karlTbowers/node60-hw/placement/2026-11-12-route/decisions/log.md

# Decision log: routing run, 2026-11-12

The user asked (2026-11-12) to finish routing everything, then put the test points back, and later
said: "for this session - i approve all of your recommendations. dont stop and wait for me. just
record what decisions were made so i can review later if i want." and "you have my permission to
slightly trim power shapes if you need the area to run signals and there is no other way to do it."
Every decision below was taken by Claude under that approval unless it says otherwise. D34 rows are the first run (before the user's answer to D33), D35 rows the second. Each one says
how to undo it.

| Id | Decision | Taken? | Why | Where it is | To undo |
|---|---|---|---|---|---|
| D34-1 | Draw the In2 signal window (north of y 70) and the power-only keep-outs on In1, In2 south, In3 and In4 on the board again | Yes, on main | Decision D17 A (user, 2026-11-04) put them there; commit `111fb0e` (2026-11-05) lost them, because `scripts/draw_rule_areas.py` redraws them only when given `--window` and `--power-only` and was run without. Since then every router run laid signals on In2 through the power band | `node60.kicad_pcb` rule areas `SIGNAL_WINDOW_In2Cu_1`, `POWER_ONLY_*`; `prep.sh` | Run `draw_rule_areas.py node60.kicad_pcb` without the flags |
| D34-2 | Rip the two relay-termination drive lines (`/T1S_TERM_END`, `/T1S_TERM_DROP`, routed 2026-11-05) and lay them again | Yes, on main | They passed on both sides of MCU ball E1, so SPI2_FLASH_CS_L could never leave the ball field. The router laid them again clear of it | `prep.sh`; the lines on main are the bulk route's | Restore them from commit `794e299`'s board |
| D34-3 | T1S block: R501 turned 180 degrees, C509 moved 0.25 mm east, C509's VDDAU_AON via moved into its pad at (158.1, 47.45), pin 25's track narrowed to 0.2 mm, R501's GND pad joined to C510's | Yes, on main | U501 pin 26 (RBIAS) had no way to R501: the REFCLK via and C509 left 0.4 mm, and R501's RBIAS pad was on the far side of its GND pad | `hand/h0.json`, `blocks/t1s.poses.json`, `power_shapes.json` | Revert those entries; RBIAS is then open again |
| D34-4 | U201's VBAT_D joins: pin 6's plane via moved from (150.025, 74.825) to (150.9, 73.8); pin 22 gets its own plane via at (152.75, 78.5); the two tracks that tied pins 6, 22 and 24 together on B.Cu deleted | Yes, on main | The joins of 2026-11-05 caged pins 1 to 5 and pin 23 (a track down the chip's west side and a U round pin 23). All three pins still reach the VBAT_D planes on In2 and In3 | `hand/h0.json`, `power_shapes.json` | Restore the "Power join VBAT_D: U201.*" groups from the spec at `794e299` |
| D34-5 | 1V5_CORE_FB drawn by hand; the 1V5 switch-node stub now starts at the north end of U303 pin 7 | Yes, on main | The rule "1V5_CORE_FB 1 mm from the switch nodes" cannot be met by a track leaving pin 5 at its centre: pins 5 and 7 are 1.0 mm apart | `hand/h0.json`, `power_shapes.json` | Revert; the feedback net is then unrouted |
| D34-6 | Five nets pre-routed by `mini_route.py` before the bulk route: T1S_RBIAS, SPI2_FLASH_CS_L, NTC_RSENSE, 1V5_EN, VDDAU_AON_REG | Yes, on main | KiCadRoutingTools leaves these open in every run. All five pass DRC with the board's own rules | `hand/h1.jobs.json`, `hand/h1.json` | `rip_nets.py` on those nets |
| D34-7 | The full routed attempt is NOT landed on main | Decided: keep it off main | It leaves 30 items unconnected and reaches the middle cell and U201 by cutting the outer-layer power pours: see REPORT.md, "What the route cost the power paths". That is more than the slight trim the user allowed | Branch `layout/route-attempt-6layer` holds it (board, spec, block tables) | Merge that branch if the cost is acceptable |
| D34-8 | Test points: put back on the routed attempt only (62 of 62 placed, 55 joined); they stay parked on main | Yes | They are placed on the routed copper, so they belong with it. On main's board, still unrouted in the band, they would be in the router's way again | `place_test_points.py`, `hand/test_points.json` (attempt branch) | none needed |
| D33 | **B** (user, 2026-11-12: "B- Signal tracks on top under the GND bar"): mask-covered signal tracks may run on F.Cu under the GND busbar. No other net's pour there and no battery-net track; the VBAT_IN bar unchanged | Yes, the user's answer; Claude made the edit after it | Under the board's rules before it, signals in the power band had only B.Cu, which is power pour there, so the routed attempt cut the pours (D34-7). The first try at this edit, before the user had answered, was stopped by the session's safety check | `node60.kicad_dru` (two rules in place of "F.Cu under the GND busbar: GND only"), seven new cases in `prove_rules.py` (39 of 39), `mini_route.py`, `judge_route.sh` (`BARS_CLOSED=1` gives the old behaviour), the site's KiCad PCB settings page | Restore the one rule "F.Cu under the GND busbar: GND only" from commit `b404f9c`, then re-route |
| D33-1 | The new rule also names VBAT_FILT, RS_SENSE_P and RS_SENSE_N as battery nets, beside the class PWR_BATT | Yes (Claude, under the session's approval) | They sit at battery potential with no resistor in the way; RS_SENSE_P/N are ahead of the load-disconnect FETs, so only the harness fuse would clear a short to the bar. The decision page said "no battery nets" and the class alone would have missed them | `node60.kicad_dru` | Drop the three names from the rule's condition |
| D35-1 | Cross the power band in two channels under the FET bodies: B.Cu lanes at 0.3 mm pitch between each FET's source pads and its drain tab (six west at x 137.6 to 139.1, four east at x 170.9 to 171.8), laid by hand | Yes, on main (Claude, under the session's approval) | After D33 B the bulk router still cut the pours (VBAT_Q2D 0.135 to 0.217 mOhm, the west VBAT_IN pour in two pieces). The channels hold only a dead-end strip of pour beside each tab, so no current path is touched; that strip is the "slight trim" the user allowed | `hand/c4a.json`; REPORT.md, "How the band is crossed" | Rip the lanes' nets and route again |
| D35-2 | The middle output cell wired by hand, lines arriving in pin order; SW_VDD comes down both channels; three F.Cu hops south of the VBAT_IN bar's edge with vias in pads (R704 pad 1 and U701 pin 12; pins 2 and 3; R705 pad 1) | Yes, on main | Under the VBAT_IN bar the cell has B.Cu only, so nothing may cross; the router's own version left four lines open | `hand/c4a.json` | As D35-1 |
| D35-3 | RS_SENSE_N runs straight north on B.Cu beside the shunt's S1 pad to U202 pin 9, and from U201 pin 19 and C212 south of R209 and between the shunt's F1 and S1 pads. Four plane vias removed for it: VBAT_D at (160.05, 83.7 / 84.6 / 85.5) and VBAT_Q2D at (159.85, 88.15) | Yes, on main | Both sense lines are battery nets (D33-1), so neither may hop to F.Cu under the GND bar; the router's version ran RS_SENSE_N on F.Cu through the top-layer VBAT_D pour and walled R210 in. Cost: VBAT_D 0.268 to 0.298 mOhm on all layers | `hand/c4a.json`, `hand/c5h.json`; `power_shapes.json` `keep_clear` | Restore the four vias from commit `b404f9c`'s board and re-lay RS_SENSE_N elsewhere |
| D35-4 | HGATE_G's link under the shunt (B.Cu, y 86.5, Q203's gate to Q204's) removed; Q203's gate is fed on F.Cu in the gap between the top-layer pours (x 137.15) with a via at (137.15, 89.4), Q204's from the east as the router laid it. DGATE and HGATE_G run on F.Cu under the GND bar | Yes, on main | The link took the one gap between the VBAT_D and VBAT_Q2D pours. Gate lines are charge-pump outputs (microamps); the D33 rule allows them under the bar | `hand/c4a.json`, `hand/c4.jobs.json` | Re-lay HGATE_G |
| D35-5 | NTC_RSENSE runs on F.Cu in the 0.8 mm gap between the top-layer VBAT_D and VBAT_Q2D pours (y 86.2), east, then up beside the east channel | Yes, on main | The router's own choice once the pours were priced out; moved from y 86.6 to the gap's middle so it trims neither pour | `hand/c4k.json` | Re-lay it |
| D35-6 | The In3 VBAT_PROT finger to U301 and C301: five signal vias moved off it, and the finger widened from 1.2 to 2.4 mm between y 62 and 71 (x 163.2 to 165.6). A no-via zone over it in `mini_route.py` and `route_hook.py`. T1S_TERM_COIL_S's locked In2 run moved 0.35 mm east (x 164.0 to 164.35, y 62.75 to 67.65) for Q501 pin 1's GND via | Yes, on main | Seven new vias had cut the finger in three: U301 had no feed. Q501, Q502 and R521 stand on the finger and need vias in their pads. This changes a power shape (the user's standing permission) and moves approved T1S termination copper by 0.35 mm | `hand/s5h.json`, `s5i.json`, `s7h.json`, `s7i.json`; `power_shapes.json` zone `PWR_VBAT_PROT_In3` | Restore the zone's `poly` and the In2 track from `b404f9c`; Q501 pin 1 is then open again |
| D35-7 | Supply joins by hand: U301's output re-laid down the chip's west side to C302 (0.15 mm, 2.6 mm) so VBAT_PROT pins 1 and 2 reach C301; a via in U501 pin 18's pad (3V3); the VBAT_PROT sense node (U201 pins 15/16, U202 pin 8, C203, C204) joined on B.Cu with one via into the VBAT_PROT strip of In2/In3 at (161.41, 71.7); HGATE's via moved into U201 pin 14's pad; T1S_IRQ_L hops over R513's GND pocket on F.Cu and runs 0.6 mm further from D501's GND pad | Yes, on main | Each was open on main or opened by a new track, and the automatic joins failed on them | `hand/s3h.json`, `s3k.json`, `s7i.json` | Revert the specs' copper; the joins are open again |
| D35-8 | SW2_SNS's ball gets a hand-placed 0.35/0.20 mm via at (200.91, 58.32); NTC_SW3's via beside it shrinks from 0.45/0.25 to 0.35/0.20 mm | Yes, on main | The ball's only via site, 0.1 mm clear of its neighbours inside ESCAPE_U401 | `hand/c6h.json`, `c6v.json`, `c7h.json` | none sensible |
| D35-9 | Test points put back on main's board: each on its own net's B.Cu copper wherever a free spot is, however far from its old pose (six moved 30 to 99 mm along their lines: TP406, TP404, TP413, TP703, TP702, TP207); 12 on a short stub; TP301 and TP401 placed but not joined | Yes, on main | The user (2026-11-05): test points may go wherever routing is easier. With a 15 mm limit 27 needed stubs up to 31 mm, one on the RMII reference clock, and the stubs fenced off GND pour beside the T1S diodes | `hand/test_points.json`, `hand/t2` to `t4`; block tables re-posed | `scripts/park_test_points.py park`, then place them by hand |
| D35-10 | U201 pin 2 (VBAT_IN sense) and C510 pad 1 (VDDAU_AON) left open at the end of the second run (closed later: D36-1, D36-2) | Not done then | U201 pin 2 is a battery net: no F.Cu under the GND bar, and on B.Cu it is walled in by the three divider lines. It needs those re-laid on F.Cu and an In2 hop over the west lanes; a first try with the router's rip-up mode broke four other nets and was dropped. C510 pad 1 has no way out between R301, R505 and the regulator's output. Both were open on main before the run | REPORT.md, "Where it ended" | not applicable |
| D36 | **A** (user, 2026-11-12: "A, re-lay lines"): U201 pin 2 is joined with no rule change | Yes, the user's answer | The battery-net rule of D33 B stays whole | Page: https://claude.ai/artifact/DWV3TCNBaJfFMNQ4Pdn2cW (`decisions/D36-u201-vbat-in-sense.json`) | See D36-1 |
| D36-1 | How A was done: LM_SW and LM_UVLO's R204 to R205 link moved to F.Cu with vias in their pads (U201 pin 3, R204 pads 1 and 2, R205 pad 1); VBAT_IN runs on B.Cu from pin 2 between R204's pads to a via at (147.9, 71.6), and from there in a new 0.6 mm VBAT_IN pour finger on In2 (zone `PWR_VBAT_IN_U201_In2`, y 70.2 to 70.8, x 135.6 to 148.2) to the west VBAT_IN pour | Yes, on main (Claude, under the session's approval). **It differs from the page's wording**, which had an In2 track north of y 70 and the six west lines routed again | The lines SCK and I2C SCL lie on B.Cu south of y 70 exactly where the track would have to reach In2, and R515, the INH line on F.Cu and BATT_MON's F.Cu track leave them no other way; a track hop would have meant re-laying six or more lines and moving R515. The finger is a power shape in In2's power-only region (D17 A keeps tracks out of it, not pours), under the lines, so none of them moves. Cost, measured: where it joins the west VBAT_IN plane it crosses the In2 VBAT_PROT strip that is In2's way west, so VBAT_PROT's drop to U601 rises from 14.79 to 15.08 mV at 20 A (+2 %) and the loss at 3 x 20 A from 0.801 to 0.807 W; In3 carries VBAT_PROT there as before | `hand/d1.json`, `d2.json`, `add_zone.py`; `power_shapes.json` zone `PWR_VBAT_IN_U201_In2` | Delete the zone and the VBAT_IN track; restore LM_SW and LM_UVLO from commit `1821efd`; pin 2 is open again |
| D36-2 | C510 pad 1 joined to VDDAU_AON: a via beside the pad and a 12 mm F.Cu loop round U301 to R301 pad 2's via (`mini_route.py` at 0.15 mm) | Yes, on main | No shorter way exists between R301, R501, R505 and the regulator's output (the 0.4 mm gap between R501 and R301 needs 0.45). As decoupling it is poor: C509 is the close cap on this rail | `hand/d5.json` | Delete its copper; C510 pad 1 is open again |
| D36-3 | Both UART debug lines reach their test points: TX (ball E16) takes the escape channel RX had; RX (edge ball D17) leaves east between SPI3_SWITCH3_MISO's via and SPI4_SWITCH1_SCK's escape and round SCK's via. For the gap those two vias shrink from 0.45/0.25 to 0.35/0.20 mm and move 0.16 and 0.09 mm, and SPI3_SWITCH3_CS_L's diagonal is 0.1 mm wide inside the escape area (to x 209.9) | Yes, on main | The two balls had one escape channel between them. The UART test points are the only access to the debug console. Margins at the pinch point are small: 0.225 mm hole clearance (0.2 needed), 0.11 mm to the chip-select line (0.1 needed inside ESCAPE_U401) | `hand/d3.json`, `d4.json` | Restore the three nets from commit `1821efd`; TP401 is open again |
| D36-4 | TP301 (VDDAU_AON) moved to (160.0, 52.5), beside the rail's via at C510, on a 2.8 mm stub | Yes, on main | Its old place needed a 32 mm stub with six vias | `hand/d8.json`, `hand/test_points.json` | Move it back and re-route its stub |

Tool changes made on the way (all in the repo):

- `scripts/draw_power.py`: a locked stub longer than 2 mm no longer stacks on a redraw (merged with D32).
- `placement/2026-11-02-bars/judge_route.sh`: three optional switches, off by default: `S0_HOOK` (a script run
  on the router's copy), `KEEP_DECAPS=1` (leave U401's caps where the board has them) and `ROUTE_NETS`
  (the bulk passes' net patterns).
- `node60.kicad_dru`: changed for D33 B after the user's answer (above). `node60.kicad_pro`: not changed.
- `mini_route.py`: battery nets kept off F.Cu under the GND bar, others allowed (D33 B); `NOVIA` zones; job
  options `no_via` and `pour_cost`. `gen_jobs.py`: `--pour-cost`, In2 ends. `place_test_points.py`: `TP_MAX_ON`.
  `route_hook.py`: no vias on the U301 finger. `prove_rules.py`: seven busbar cases, and planted items go on
  copper-free spots so the proofs run on a routed board (39 of 39).
- New (D36): `add_zone.py`.
- New: `rip_nets_box.py`, `prune_islands.py`, `missing_in_routed.py`, `pour_crossings.py`, `measure_paths.sh`,
  `drop_dangling.py`, `dedupe_vias.py`, `set_zone_poly.py`.
