karlTbowers/node60-hw/placement/2026-11-02-bars/decisions/log.md

# Decisions, placement run 2026-11-02-bars

| Id | Date | Question | Page | Answer | What changed |
|---|---|---|---|---|---|
| D01 | 2026-11-02 | The placement plan: strict busbar via rule (A) or tented vias allowed under the bars (B) | https://claude.ai/artifact/6BbrzSQ6KqUGT5fSrQau5U | B, tented vias (user, 2026-11-02) | `node60.kicad_dru` drops `via` from both busbar rules; DEC-025 notes it; plan v1 approved; parts may stay under the bars |
| D02 | 2026-11-02 | How the board shows the VBAT_IN busbar joining J901 to J910 | https://claude.ai/artifact/QQyG6R4BYMt8VuPG6xff9c | A, a busbar part in the schematic (user, 2026-11-02) | library net-tie part, fiducial footprint and schematic change in their own session; judging route keeps J901 on a stand-in net until it lands |
| D03 | 2026-11-02 | Board fiducials, 3 per side, via a new library footprint | https://claude.ai/artifact/WKcHKSLmrtASeteVD7FHuo | A, board fiducials, 3 per side (user, 2026-11-02) | a DropOut fiducial footprint through the library's add-part; six placed by `place_connectors.py` at the measured spots; spots reserved as keep-outs meanwhile |
| D04 | 2026-11-02 | Power-entry block: INA228 beside its shunt | https://claude.ai/artifact/TmF2g6F2qwuSfKVdGnomnn | A, as composed (user, 2026-11-02) | power block v1 approved: U202 beside R201, C214 on B.Cu at U202 pin 6; held through placement |
| D05 | 2026-11-02 | T1S block as it stands | https://claude.ai/artifact/3qNtDXwTVFXDRsiMQj4BjQ | A, as it stands (user, 2026-11-02) | T1S block v1 approved, held through placement; R503 swap dropped |
| D06 | 2026-11-02 | Buck cells (U302, U303) as composed, U303 divider on the SW side | https://claude.ai/artifact/WajY8VuzyCVy9FZJmUXBPT | A, as composed (user, 2026-11-02) | buck cells approved as seated; route U303's FB round the north of the chip, away from SW; check 1V5_CORE ripple on the first boards |
| D07 | 2026-11-02 | MCU crystal block as composed, with a no-via rule on the crystal nets | https://claude.ai/artifact/7cWymGEgGDMhtveNwaRFJy | A, as composed with the no-via rule (user, 2026-11-02) | crystal block approved; node60.kicad_dru forbids vias on the FXOSC nets; routing routes them first on B.Cu |
| D08 | 2026-11-02 | One output-switch cell, U701's, copied to U601 and U801 | https://claude.ai/artifact/V4af2FuXFsyNta7XuYQYwC | A, as composed (user, 2026-11-02) | output cells approved: U601 turned 90° and moved 4.3 mm, U801 to (224, 113), TP806 at (231, 107.75) |
| D09 | 2026-11-02 | Placement gate: accept the four open items (busbar tie-pad overlaps, schematic parity, U501 pin 29, KRT's busbar join) and open the PR | https://claude.ai/artifact/1z4TKiSdvHmywjzRExvkxU | A, open the PR (user, 2026-11-02) | the four items accepted (REPORT.md); composed placement applied to node60.kicad_pcb |
| D10 | 2026-11-02 | U303's 1.5 V core buck cell recomposed round the TPS628502-Q1 (DEC-026) | https://claude.ai/artifact/FcS4kULQHc7bRbmQPYejuZ | A, as composed (user, 2026-11-02) | buck_1v5 cell table approved for the TPS628502-Q1; replaces D06's LMQ66430 cell |
| D11 | 2026-11-03 | Ready for routing: start full routing on this placement | https://claude.ai/artifact/FQKm81rbkJqD8XYJGVBc1m | A, start routing (user, 2026-11-03: after a review of KRT's routing tools and ee-skills' ee-layout-rules) | placement done; routing next |
| D12 | 2026-11-03 | Routing review: layer roles, outer copper, output cells, supply balance, input shunt, via current, routing method (7 decisions) | https://claude.ai/artifact/CYdagJE6yYyxJGvN8GtZcC | 1A 2A 3A 4B 5C 6A 7A (user, 2026-11-03). 4B: shift the power-entry group right without changing it much, and spread it for the vias. 5C: a bigger 4-terminal shunt, or two 0.5 mΩ in parallel if none is found | layer roles In1 GND / In2+In3 VBAT_PROT / In4 GND; 1 oz outer; output cells re-composed; power entry shifted right; shunt search; 0.65 A per via; staged routing |
| D13 | 2026-11-03 | The three output cells turned to 0° and centred between their headers (D12-3) | https://claude.ai/artifact/KSbSL664A3kcrYLYsxawG9 | awaiting answer | |
| D14 | 2026-11-03 | The input shunt (BVR 4026 0.3 / 0.2 mΩ, or 2 × 0.5 mΩ) and how the power entry moves right (shift, re-order, or compact) | https://claude.ai/artifact/KmXzdSwfgmrct2UQr6QukC | D14-1 A, D14-2 B (user, 2026-11-03) | R201 becomes Isabellenhütte BVR-Z-R0003-1.0 (0.3 mΩ, 4-terminal; R208 26.7 kΩ, R210 383 Ω); the power entry re-ordered to flow east |

## Skill gaps found in this run

- `escape_budget.blocking_areas` (used by `gate.py`'s via-site row) treats a rule that disallows only tracks as one that disallows vias, so the via-site row can't tell the two readings of the busbar rule apart. D01's option B numbers were measured with the areas filtered to via-forbidding rules. Fix in this run's PR.
- `gate.py`'s via-site row counts no via inside the pad itself, so a large tab (Q201–Q204's 8 × 10 mm drain pad) gets no credit for via-in-pad, which JLCPCB's filled and capped vias allow.
- Plan v1's busbar net tie (BB901/BB902 with a pad in each terminal, tied as a net tie) does not work: KiCad's net tie only lets copper of different nets touch without a DRC error; it joins nothing, and VBAT_IN still had 17 unconnected items with it. The fix is a schematic net-tie part between two nets (to be decided, D02). Reverted; J901 and J902 stay reported unconnected until then.
- `escape_budget.blocking_areas` fixed in this run: it takes `blocks=("via",)` or `("via", "track")`, and the via checks (`escape_budget.py`, `gate.py` via sites) ask only about vias.

## D15 Power entry block (2026-11-03)

Published (https://claude.ai/artifact/ESfjfBiHEvP6z8EAyY6TFh): the re-ordered power entry (D14-2 B) as a block page; `blocks/power.poses.json` replaces D04's table (approved: null). Recommendation A. C214 moved to F.Cu over U202 pin 6. Awaiting the user's answer.

D15 answered 2026-11-03: **A, as composed** (user). `blocks/power.poses.json` approved; it replaces D04's table. Board already matched to node60 #54 (R201 Kelvin nets, R208 0402, R210 383 Ω).

D13 answered 2026-11-03: **A, as turned** (user). `blocks/out_6x`, `out_34`, `out_8x` approved; they replace D08's cells.

D12 rules adopted 2026-11-03 (D12-1 A, D12-7 step 1): `node60.kicad_dru` routing rules, net classes PWR_BATT / PWR_RAIL / SW_NODE, T1S class extended to the K501 legs, mask web 0.10 mm, rule areas ESCAPE_U401/U501 and UNDER_Y401/Y501 (`scripts/draw_rule_areas.py`). `rules/prove_rules.py`: 24 of 24 cases pass (16 fire, 8 controls quiet). Real board: DRC 0 errors, parity 0, ERC 0.

D12-6 applied 2026-11-03: `plan.json` counts 0.65 A per via; R201's high-current pads are now its force pads 1 and 4 (BVR4026). Gate row "Vias at high-current layer changes" PASS, free/needed: Q201–Q204.9 242/47, R201.1 206/93, R201.4 199/93, U601/U701/U801.17 55/31 (R201's two pads share some sites).

## D16 T1S line layout (2026-11-03) — https://claude.ai/artifact/Y3JvotHyv5ecsbPLXwQEUK

User 2026-11-03: T1S runs short and equal; either connector may be used, also as an end node; move the PHY if needed. Composed: PHY chain north of the trunk's midpoint, K501 centred on it, trunk on F.Cu with via taps. `blocks/t1s.poses.json` re-extracted (approved: null). D16-2 asks about a second ESD pair at J912. Awaiting the user's answer.

D16 answered 2026-11-03: **D16-1 A, D16-2 A** (user). `blocks/t1s.poses.json` approved (replaces D05's table); intent's U501–U401 limit raised to 40 mm. D16-2 A: a second ESD pair at J912's pins, a schematic change that first checks the extra capacitance against the node's budget; then placed beside J912.

D16-2 A done 2026-11-03: PR #55 merged (D503/D504 on p5, DEC-012 rev. C, capacitance budget 20.5 of 25 pF at maxima). Board: D503/D504 placed as mirrors of D501/D502 about x 155; t1s.poses.json 22 parts. DRC 0, parity 0, floorplan 0.

## D17 Inner layer roles (2026-11-04) — https://claude.ai/artifact/CTqnFVautEjPcK5j1MXTmk

Options: A In2 north-band window (23 failed, +4–8 % supply resistance), B north band plus channels (15 failed, +9–15 %), C one VBAT_PROT plane (9 failed, 2×), D 8 layers (planes whole, $387 vs $263). Recommendation D; A as the 6-layer fallback. The PHY's RMII/MDIO nets fail in every variant: a local placement fix follows. Awaiting the user's answer.

D17 answered 2026-11-04: **A, north window** (user: "let's try with 6 layers. i can hand route some the failing nets. if that doesnt work we will go to 8 layers."). In2 is signal copper north of y 70 mm (SIGNAL_WINDOW_In2Cu_1) and VBAT_PROT south of it; In3 whole VBAT_PROT; In1 and In4 whole GND; all four plane layers carry no tracks outside the window, vias pass. `plan.json` plane_windows set. The leftover nets route by hand; the PHY's RMII/MDIO placement fix comes next.

2026-11-04: U501 and its group shifted 10 mm south (user, from a KiCad screenshot: "U501 and all of its components need to be shifted south as a group. U501 is too close to the edge of the PCB to route to."). The shift covers U501, its oscillator, straps and test points, FL501, C511/C512, K501 and its termination and drivers; D501–D504 stay at the connectors. U501's 3V3 decaps (C501, C503–C508), left at its pre-D16 spot since D16, placed at its pins. Q501, Q502 and R521 moved clear of C202/R202. C206 and TP301 moved just north of the line zone (y 35–69.9). T1S estimate: PHY stub 22.5/22.5 mm (was 12.5), relay legs 22.2/22.2 mm, end-node ports still mirrored. DRC 0, parity 0, floorplan 0. t1s.poses.json re-extracted (30 parts).

2026-11-04: U301 (VDDAU_AON regulator) with R301, C301 and C302 moved beside U501 (user: "U301 and its resistor and cap are placed wrong. they should be close to the Phy"). VDDAU_AON's only load is U501 pin 25; U301 pin 6 is now 2.8 mm from it (was about 70 mm). C302 moved to the bottom. Fast route of the shifted board before this move (D17 A layer roles): 21 nets open: 8 at the PHY (RMII/MDIO/strap/IRQ), 8 at the power entry (LM74910H settings, Kelvin sense, BATT_MON, INH), 2 switch control, and 3 power rails (1V5_CORE, 3V3_MAIN, VBAT_FILT).

## D18 Power entry inner layers (2026-11-04) — https://claude.ai/artifact/R6rxPSD3zFCrfniudt836t

The user asked for the power shapes and their vias, signals left to them. The 60 A entry path needs inner copper (the busbar areas leave F.Cu a 9 mm band). Options: A In2+In3 (path 0.70 W, VBAT_PROT 0.486/0.283/0.307 mOhm, total 1.13 W), B In2 only (1.11 W, 0.360/0.200/0.270, total 1.44 W), C neither (2.76 W, 0.306/0.171/0.256, total 3.05 W). Recommendation A. Awaiting the user's answer.

D18 answered 2026-11-04: **A, In2 and In3** (user). Stage 1 of the power shapes drawn by `scripts/draw_power.py` from `power/power_shapes.json`: GND planes on In1/In4, VBAT_PROT on In2 (out of the north window) and In3, the 60 A path's VBAT_IN/VBAT_D/VBAT_Q2D zones on B, In2, In3 and the F band, VBAT_PROT at the disconnect FETs' sources, VBAT_IN on F under its busbar, GND pours on F and B; via fields (0.45/0.25 mm, 0.9 mm pitch): J910 ring 150, Q201/Q202 sources 126, VBAT_D corridor 220, VBAT_Q2D corridor 220, Q203/Q204 sources 180, J911 and J902 rings 150 each (1,190 in all; each field at least the 93 needed for 60 A at 0.65 A per via). All locked. DRC 0 errors, parity 0, no dangling vias. New DRU rule: one thermal spoke is enough (small parts' GND pads in crowded spots). Stage 2 (outputs, VBB fields) next.

2026-11-04 power shapes, stage 2: VBB pads get 30 in-pad vias each (filled and capped, free on this stackup: DEC-027); each output a B and an F pour from its pins to its header's pin 1, OUTb the mirror of OUTa, with via fields identical at all six (4 at the strip, 24 in the band). DRC 0 errors. Measured from the copper (`power/copper_r.py`, 85 C): OUT1..6 = 4.83, 4.59, 4.83, 4.59, 3.03, 4.53 mOhm switch pins to header pin 1. The cells' small parts beside the OUT pins (C605, TP604, TP606, R605, RT601, R607, C603 on top; R601, TP602, R604, TP603) squeeze the 10 A through a 2 mm strip of 1 oz copper; with them cleared (what-if on a copy) OUT1/OUT2 = 2.47/2.45 mOhm. U801's cell differs (D08 moved parts for its FLT pin), hence OUT5. D19 asks to re-compose the cells' small parts.

## D19 Output cell exits (2026-11-04) — https://claude.ai/artifact/2bSDYAzj6TvfSJZJxfB9B6

Outputs measured from the copper: 4.83/4.59/4.83/4.59/3.03/4.53 mOhm; with U601's small parts moved away (what-if) 2.47/2.45 mOhm. Options: A re-place the cells' small parts to clear the OUT exits identically; B keep. Recommendation A. Awaiting the user's answer.

D19 answered 2026-11-04: **A, clear the exits** (user). U601's cell re-placed: RT601, R607 and C607 north of the switch between the exits, R601 and R604 to the signal side by pins 3 and 12, TP602 north between the exits, TP606 south; the cell copied to U701 and U801 by `block_poses.py copy/apply` (U801 is an exact copy again). FLT, SNS and SCK pins PASSABLE at all three. The B output pours reach north to y 104.5 beside the pins; the power shapes redrawn. Measured from the copper (85 C): OUT1..6 = 2.25/1.95/2.25/1.94/2.23/1.93 mOhm (were 4.83/4.59/4.83/4.59/3.03/4.53). The 0.3 mOhm left between each switch's OUTa and OUTb comes from the AT13 pinout: OUTa's header puts its GND pin between the switch and pin 1 (D13); a wider OUTa band does not help (2.20 at best). DRC 0, parity 0, floorplan 0, every block on its table.

## D20 Power entry symmetry (2026-11-04) — https://claude.ai/artifact/HJugSf2a4MNMKTrxwNhMN8

Asked 2026-11-04 after the user's call that both battery bosses are `VBAT_IN` (no `VBAT_IN_DOWNSTREAM`; DEC-016 rev. C to come). On a copy with J901 on VBAT_IN, DRC has 0 errors but J901 pad 1 unconnected (BB901 is no board copper), so J901 needs copper either way. A: mirror the entry chain about x 155 (Q201 west fed by J910, Q202 east fed by J901, R201 north–south on the centre line, Q203/Q204 either side of it, U201/U202 central). B: keep the chain at J910's end and join J901 with an inner-layer strip. Recommended A. Pictures: `power/d20_picture.py`.

D20 answered 2026-11-04: **A, mirror it** (user). Both battery terminals on `VBAT_IN` (schematic p9 label, board pads, busbar rule, PWR_BATT pattern; DEC-016 rev. C). Power entry re-composed about x 155: Q201 (127, 93) fed by J910, Q202 (183, 93, 180°) by J901, R201 (154.2, 86.5, 90°) F1 south, Q203 (141, 80) and Q204 (169, 80, 180°), U201 (153, 75.5) and U202 (159.5, 76.6) in the column north of R201; small parts by `pose_search.py`; NTC parts R212/C216/TP209 moved east of the VBAT_PROT pour. New pose table `blocks/power.poses.json` (39 parts on it); every other block 0 off its table. Power shapes redrawn mirrored (`power_shapes.json`): VBAT_IN W/E from each ring to its FET's sources, VBAT_D on B/In2 across and on In3 only under R201 (so VBAT_PROT has In3 corridors south to U701), VBAT_Q2D around the U201/U202 column on B, 99 vias in each FET tab. DRC 0 errors, parity 0, no dangling vias. Measured from the copper (`copper_r.py`, 85 C), main -> now: VBAT_IN 0.551 -> 0.153 mOhm (both terminals), VBAT_D 1.573 -> 0.288, VBAT_Q2D 1.432 -> 0.209, 60 A chain 3.56 -> 0.65 mOhm; per side W/E: VBAT_IN 0.322/0.288, VBAT_D 0.431/0.423, VBAT_Q2D 0.293/0.256; VBAT_PROT to U601/U701/U801 0.666/0.387/0.455 -> 0.509/0.520/0.522 mOhm; J910 to J901 through board copper 4.7 mOhm (the bar carries about 99 % of a pass-through). Open: DGATE about 50 mm routed to each ideal-diode FET (was 25/38), against TI's "short trace" (LM74910H-Q1 data sheet 9.5.1).

## D21 Entry gate drive (2026-11-04) — https://claude.ai/artifact/Nmy8BsLxsDJUJSJm4rvrqc

Asked after D20 A: TI's LM74910H-Q1 layout guidelines (9.5.1) say DGATE must reach the MOSFET gate with a short trace; PR #63 has about 50 mm to each ideal-diode FET. Built on copies of PR #63's board: B swaps the rows (ideal-diode FETs north beside U201: DGATE 23/24 mm, HGATE 49/37, A pin 16 mm from a source; chain 0.69 mOhm; VBAT_PROT 0.729/0.353/0.733, the VBAT_IN L-shapes wall off U601/U801), C is B with VBAT_IN on B and In2 only (VBAT_PROT 0.542/0.342/0.560, chain 0.76 mOhm; the trial redraw put OUT5 band vias too near J908's GND pin, 24 errors, to fix). A keeps PR #63 (DGATE 50/49, VBAT_PROT 0.509/0.520/0.522, chain 0.65). Recommended C.

D21 answered 2026-11-04: **C, swap off In3** (user). PR #63's board re-placed with the trial's poses (old entry vias deleted first): Q201 (141, 80) and Q202 (169, 80, 180°) north beside U201/U202, R201 (155.8, 86.5, 270°) F1 north, Q203 (141, 93) and Q204 (169, 93, 180°) south; TP507 moved north to (176, 69). New pose table (39 parts on it). Power shapes per D21 C (`power_shapes.json`): VBAT_IN L-shapes on B and In2, VBAT_D north band, VBAT_Q2D south band, vias in all four tabs. DRC 0 errors, parity 0, no stray vias (the trial's OUT5 hole-clearance errors did not recur). Measured (85 C): VBAT_IN 0.308, VBAT_D 0.311, VBAT_Q2D 0.144 mOhm (chain 0.76); per side W/E 1.172/1.202; VBAT_PROT to U601/U701/U801 0.525/0.336/0.547 mOhm; J910 to J901 through board 5.4 mOhm. DGATE 23/24 mm, HGATE 49/37 mm, A pin 16 mm from Q201's sources.

2026-11-04 In3 VBAT_PROT (user): the user cut PWR_VBAT_PROT_In3 from the whole board to x 69.5-240.5, y 71-116.5 (filled 21,767 -> 5,518 mm2; VBAT_PROT loss at 3 x 20 A 0.876 -> 1.024 W, outer switches +3.4 mV). Asked to fix the OUT via bug and optimise on little copper: `draw_power.py` now clears every copy's region (OUT2-OUT6 had 198 stacked vias, OUT1 had lost its strip vias: 3.11 mOhm, now 2.14; all six 30 vias again). `power/in3_sweep.py` + `copper_r.py` loads mode: the south edge matters (current wraps under the switches), the north and a bridge over the entry block little. Chosen x 72-238, y 71-122 (6,537 mm2, +12 % on the user's shape): VBAT_PROT 0.866 W, drops 15.95/11.69/15.66 mV; input-to-output copper 4.79 W (main 4.90, user's cut 5.05). DRC 0, parity 0.

D22 asked 2026-11-04 (small rail planes): the four small rails had no copper, and L201 and U301 none on VBAT_PROT since the In3 cut. Option A drawn on a copy: 3V3_MAIN on In3 north of y 70.8, a 1V5_CORE island from U401's core to R303, VBAT_PROT fingers to L201 and U301, VBAT_FILT pours on B and F, one via per small-rail pad (in the pad where it fits), U401's dogbones. B (bottom-layer pours) and C (In2's window) judged from the routing numbers. Three placement problems found: C206 (filter output cap) 34 mm from L201, C405 (1V5 bulk) 14 mm from the core, U401's top-side caps off the via grid. Answered **A, with R1, R2 and R3** (user).

D23 asked and answered 2026-11-04 (repair poses): R1 C206 (118, 40.5, 90) and TP205 (120.75, 41.75) beside L201 and U302's input caps, added to the buck_3v3 table; R2 C405 (210.75, 52.25, 0) at the island's east end; R3 15 of 18 caps under U401 on via pairs at its cell centres (`power/bga_decaps.py`; C403, C404, C419 just outside with 1.0-1.4 mm F tracks), new table `blocks/u401_decaps.poses.json`; every via under U401 0.35/0.20 mm (0.40 left 0.10 mm webs and split the In3 island and plane); all 54 signal balls keep a free escape cell. **A, land it** (user). On main's board: DRC 0 errors, parity 19 (the known ki_fp_filters warnings); opens main -> now: 1V5_CORE 10 -> 0, 3V3_MAIN 73 -> 20, VBAT_FILT 9 -> 2, V11 9 -> 5, V25 1 -> 0. Measured (85 C): 1V5_CORE 21.3 mV at 2 A into the four core balls; 3V3_MAIN at 1.33 A: U303 input 5.4, U401 3.8, U501 3.0 mV; VBAT_PROT at 3 x 20 A 0.867 W (main 0.864), drops 15.77/11.70/15.89 mV. Left to hand routing: 3V3 into the power band, U501's 3V3 pins and VDDAU_AON, U302's and U303's hot loops, V11's four balls with C420 and TP411, Q501, Q502, C513, U302 pin 3 and TP304 on VBAT_FILT. `judge_route.sh` now leaves In3 out of route_planes (not yet run that way).

2026-11-04 (user): assume JLCPCB accepts the 0.075 mm via ring on the 2 oz inner layers and keep going; checked before ordering. Recorded in CLAUDE.md, plan.json `assumed` and the PCB settings page.

D24 asked and answered 2026-11-05 (buck hot loops): drawing the bucks' copper found U302's cell mirrored: on B it had been seated as TI's top-view Figure 8-34, so SW pin 7 and PGND pin 6 faced east while L301 and C303's GND pad sat west (D06's 3.16 mm was a straight line through the chip). Mirroring the passives east would have put the SW node ~6 mm from J912's T1S pin; instead U302 turned 270 -> 90 and its 17 neighbours were pose-searched into the cell mirrored about the chip's east-west axis (C303 across VIN and PGND, L301 beside SW, output caps north, L201/C206/C207/C217 and test points south). **A, land it** (user). Copper on B for both bucks (VBAT_FILT, SW pours 4.8 / 5.2 mm2 with no vias, output nodes, 3V3 at U303, GND vias in every cap's GND pad and U302's exposed pad, 0.25 mm tracks into the thinnest QFN pins), L201's In3 VBAT_PROT finger moved to x 115-119, y 59-71. SW pin to L301 1.8 mm (was 5.4, centres); U302's SW node 13.8 mm from the T1S line (was 11.8). DRC 0 errors, parity 19 (known); all bucks' power nets joined; every block on its table (buck_3v3 table rewritten). hot_loop.py now fails an inductor that is not on its SW pin's side of the chip. Hand: U302 VOUT sense pin 11, U303's FB divider and EN, U302's INH.

D25 asked 2026-11-05 (GND stitching): an edge ring now (61 vias at 5 mm, 1 mm in) or a 5 mm grid over the interior too (519 more vias in the routing space). Fast route on main with D22-D24 in: 27 open items and 196 blocking (29 and 218 before): the planes cost no routability; RMII/MDIO and power-entry gate nets fail as before. **A** (user).

D26 asked 2026-11-05 (RMII routing; user: "route JUST the RMII interface ... might need us to spin the microcontroller"): ten nets routed alone with KRT. Five runs each failed a different net while every pad was reachable: the geometry at U501, not U401 (all ten balls reached every time). Causes: R505/R507/R509/R510/TP503/TP504 west of U501 (their pins east and north), so RX lines detoured through the TX lines' strip; Y501's courtyard 0.33 mm from U501's east pads (its UNDER_Y501 area starting inside them). Moved the six (free parts) beside their pins and Y501 2 mm east, turned 90 (R503/R504 about 3.5 mm from its output, k501 table updated); route_rmii.sh (judge preparation and fan-outs, UNDER_* via-free for the router, MDIO/MDC first) routed all ten; MDIO re-routed end to end after KRT graded a 1.25 mm gap at C506 as joined. Transplanted onto the real board, locked: DRC 0 errors, no RMII/MDIO open; 36 vias; REF_CLK 44 mm, data 43-80 mm. The T1S PHY pair fails in the router before and after alike (hand route). In3's 3V3 plane and 1V5 island now 0.12 mm minimum width (a refill dropped ball H6's 0.15 mm webs). **A** (user). Landed with D25's ring: DRC 0 errors, parity 19 (known); GND opens 4 (main 3: the RMII copper cuts the B pour; the interior stitching after routing rejoins it); Y501 pin 4 (3V3) found no via site after the move (hand). Timing (LAN8670 Table 7-15, S32K344 Table 58, about 6-7 ps/mm, REF_CLK reaching U401 about 0.24 ns after U501): RX setup slack about 3.7 ns, RX hold 1.1; TX hold 1.1; TX setup about 0.3 ns at the 25 pF datasheet load (U401 valid up to 15 ns after its clock), so TX lines and the REF_CLK branch to U401 are kept short rather than lengths matched.

Test points parked 2026-11-05 (user: "make it a rule that you are allowed to move test points to wherever you want as long if it makes routing easier. I would honestly pull the test points off the board and not worry about them while routing. we can add them back later."): all 62 TP* moved by scripts/park_test_points.py to a grid south of the outline (y 146 on), poses before in parked_test_points.json. Copper: MDIO through TP504 and REF_CLK through TP505 closed with a straight segment; the MDC stub to TP503 (two tracks and its via) and the pad vias of TP302 (3V3_MAIN) and TP303 (1V5_CORE) deleted. DRC 0 errors on the parked board; unconnected items 271 to 292 (the test points' own ratsnest, warnings). block_poses.py check --parked: every block on its table. They go back (restore) before routing sign-off.

D27 asked 2026-11-05 (RMII clock skew; user: "Yes, tighten it", the TX timing): Microchip DS60001573K section 3 asks the common oscillator's traces to the LAN8670 and the MAC matched within 13 mm; ours 14 mm and 54 mm. With R503/R504's RC (33 ohm into U401 4-8 pF, U501 3 pF) the MCU sees REF_CLK 0.39-0.48 ns after the PHY, TX setup slack 0.09 ns worst case (S32K344 output valid 15 ns at 25 pF, DSE=1 SRE=0). Trials (rmii/route_clock.sh, clock first, real copies judged): A Y501 to (182.0, 41.0) between J903 and U401 with R503/R504/C513 beside it: branches 32/22 mm, skew -0.10..-0.01 ns, TX setup 0.58, hold 0.71, RX 3.34/1.34 ns, DRC 0, no trunk crossing (top-side keep-out for the RX step); B Y501 stays, KRT length-match group: 32/51 mm, TX setup 0.24 ns, meander at U501's south edge, one CRS_DV trunk crossing; C leave: 0.09 ns. C513 (Y501's bypass) had sat 8 mm away on the top side. Recommended A.
**A** (user, 2026-11-05). Landed: Y501 (182.0, 41.0, 90), R503 (178.95, 40.05, 180), R504 (181.3, 38.4, 0), C513 to the bottom at (184.7, 41.0, 90); k501 gives up Y501, R503, R504 to blocks/refclk.poses.json (anchor Y501); intent: the three out of the t1s_line group into a refclk block, the "R503 within 6 mm of U501.27" row replaced by C513 within 2 mm of Y501; plan.md RMII and REFCLK rows rewritten (the "<= 40 mm" RMII budget was unattainable, pins 43 mm apart). UNDER_Y501 redrawn (draw_rule_areas.py --only). The twelve nets' copper from the trial (route_clock.sh; RX re-routed with a top-side keep-out over the T1S trunk's corridor) replaced D26's, locked. Found while landing: trunk_check.py looked at tracks only; every via passes F.Cu, and the trial put the PHY clock's via in U501 pin 27 at y 46.0 (D26 had a CRS_DV via at (160.3, 46.5)); the corridor is now x 133.4-176.6, y 44.8-47.2 (the pair plus the T1S rule's 0.75 mm) and route_clock.sh closes it to the router; the pin 27 via moved to (156.75, 47.45) with a B stub (it also answers the page's via-in-pad note). Still in the corridor, from before: C502 (U501's top-side 100 nF at (155.0, 45.5)) and 3V3_MAIN vias at (152.29, 47.0), (155.0, 46.8), (164.25, 46.2). draw_power.py re-run: Y501 pins 1/4 and C513 pin 1 get in-pad 3V3 vias (on main they had no site), the old via at Y501's former pin 1 gone; Q501.4/Q502.4 still no site. Zones refilled by kicad-cli (pcbnew's Python filler left 27 more GND islands). Checks: CI DRC with parity 0 errors; unconnected 287 (GND 11, as before); RMII/clock opens only to the parked TP503/TP504/TP505; every block on its table (--parked); mcu_pinmap.py --check up to date. Timing landed: clock 34.8 / 22.0 mm (mismatch 12.8 mm, the pin 27 stub added 2.9 mm), skew -0.13..-0.04 ns, TX setup 0.61, TX hold 0.69, RX setup 3.32, RX hold 1.37 ns. mcu-config.yaml: TXD0, TXD1, TX_EN at DSE = 1, SRE = 0.

D28 asked and answered 2026-11-05 (T1S line routing; user: "route the T1S trunk with the PHY pair"): drawn by hand from t1s/spec_t1s.py (KRT's diff-pair router wandered). In the way: C502 (VDDA's decap) and three 3V3 vias on the trunk's line; U501's pin row under the trunk's midpoint since the 10 mm shift, so the taps leave west of U501; VDDA pin 29 0.5 mm from TRXP pin 30 (0.75 mm rule impossible there; inward closed, the exposed pad leaves 0.275 mm); the PHY pair's crossing (two vias on P, 4 mm in KiCad's length); KiCad's gap check on every parallel stretch. Swapping TRXP/TRXN rejected: the LAN8670's topology discovery (4.15) checks pulse polarity. **A with the fourth change** (user). Landed: trunk, ESD taps, taps on In2, relay legs to K501 pins 3/6, CMC pair, PHY pair (P over N on F.Cu); C502 to (156.3, 47.76) F.Cu upright (clear of J903's T-shaped courtyard by 2.9/4.3 mm), its 3V3 via shared with pin 29; REFCLK via to (157.0, 47.35); TXD0 re-routed by KRT (t1s/route_txd0.sh, keep-outs round T1S vias: KRT keeps the T1S rule from tracks, not vias), 63.4 mm; C507's and R506's pad vias out of the corridor (draw_power.py keep_clear, class_clearance; R506 a named via and stub). Rules (rules_t1s.py): 0.75 mm not inside T1S_PINS_U501; its pour clause a rule of its own on the outer layers (the fourth); the gap rule only inside T1S_COUPLED_F/IN2; PHY pair skew 4.5 mm, CMC 0.5. Checks: CI DRC with parity 0; T1S open items 14 -> 0, VDDA connected, every other net as before; prove_rules.py 32 of 32 (six new T1S cases; the ESCAPE_U401 case moved off D23's C420 and refilled: it had been stale since the pours); t1s_stubs.py (vias by depth now) trunk 38.9, tap 14.8/15.8, PHY stub 28.6/25.6 (plan 25: accepted), relay leg 23.7/24.7, end-node dangle 28.5/21.6 (J912 used) and 10.4/17.3 (J903); RMII TX setup 0.59, hold 0.69, clock branches 12.6 mm apart; trunk corridor clean; every block on its table. Still to route: the relay's termination legs and coil.

Relay termination routed 2026-11-05 (user: "keep going" after D28): KRT (t1s/build_term.sh, route_nets.sh generalised from route_txd0.sh). One pass left TERM_CT (Default class) 0.65 mm from P_DROP and a TERM_CT via 0.55 mm from it: KRT keeps the T1S rule track to track only when the T1S copper is already there. Two passes instead: the four legs (T1S_*_DROP/END) first, then TERM_CT, the coil (TERM_COIL_S/R) and the drive lines (TERM_DROP/END from U401 E3/F3), with via keep-outs round every T1S track and via. Legs 2.0-2.5 mm on B.Cu; TERM_CT 36 mm, 5 vias (R517 west of K501, R519/C514 east; the legs fill the bottom between the pin columns, so it crosses on In2: in series with the 100 ohm termination about 1 ohm at 12.5 MHz); coil 14-17 mm; drive lines 39-42 mm. CI DRC with parity 0; 19 open items closed (272 -> 253 unconnected), nothing else changed; trunk corridor clean; T1S lengths and RMII timing unchanged; every block on its table. Not a decision: no choice against the plan.

Power joins, first pass 2026-11-05 (user: "keep going" after the termination): the fast route on main (judge_d28) leaves 7 nets open with the 63 parked test points set aside (27 before the T1S work). Main had 58 power and ground opens, real gaps (a refill closes none). KRT is no help here: it does not count pours as connecting, so it ran pad to pad across them (108 mm of VBAT_PROT through the PHY area, 3V3 on In2 in the band). power/joins/: export_copper.py (the board's copper as JSON), plan_joins.py (per open pair: a track on a shared layer, a via between, a via beside each end into its plane, then a grid search costing other nets' pours 6x; the board's clearances, 0.35 mm plated-hole rule, busbar F.Cu areas, the T1S corridor and UNDER_* areas kept), merge_plan.py (each join its own named stubs/points in power_shapes.json), joins_picture.py, transplant_new.py. 28 joins drawn (plan_2026-11-05.json): the output cells' pad 17 to C601/C701/C801 (a via in the cap's pad into In3), C602/C702/C802 (via in pad), OUTx pad 11 to C606/C706/C806 (grid, two vias), U201/U202/C203/C204/C209 at the power entry, Q501/Q502 and U501 pin 8 on 3V3 vias, U303's 3V3 pins, VDDAU_AON at U501 pin 25/C509/R301, V11's balls J8-H9-J10 on B, GND at C201/C210/C215/C205. Four grid joins dropped: they cut U301's and the entry's small pours. Power and ground opens 58 -> 30 (8 of them U303's FB/EN and U302's sense, left for hand). CI DRC 0 errors, parity 0; trunk corridor clean; T1S stubs unchanged. Left: the 3V3 trunk into the power band (west and east cells on F round the VBAT_IN bar's ends, the middle cell on B through the entry block: a decision), and the dense ones (U501 pins 11/18, R301-C510, U301-C302, U202 pin 8, C701-RT701, C420 to the V11 balls, D201 and U201 pad 2 to VBAT_IN).

D29 asked 2026-11-05 (3V3 into the power band; user: "Yes, go ahead"): every 3V3 load in the band needs a feed, and on F.Cu and B.Cu the band is taken by the busbars' F.Cu areas (GND bar x 67-243, y 61-80; VBAT_IN bar x 92-218, y 90-109), the entry's VBAT pours and the output pours, with all inner layers planes. Found: each output switch's logic pins (1-5, 12-16) and R601/R701/R801 sit in a pocket closed to the north by its two output pours on both outer layers. One 0.3 mm 3V3 track into U701's pocket raised OUT3 2.16 -> 2.93 mOhm (3.80 routed shortest); the fast route's signals leave the outputs at 2.33-4.66 mOhm. Options: C widen the In3 3V3 plane into the unassigned margins (x < 72, x > 238, y > 122) and feed each pocket from below (9.5 mm, 2 vias, alike; outputs and entry chain unchanged; 3V3 band opens all joined), B cut back the outputs' F.Cu top strips (+0.5 mOhm each), A cross the pours, D turn the switches 180 (not worked up). R707 from R607's feed (81.5 mm) rather than down the entry's centre column (VBAT_Q2D +21 %); R211/C215 from R807's feed rather than across the VBAT_IN pour (+23 %). Tools: power/joins/trunk_options.py, trunk_picture.py, trunk_to_spec.py; page D29-build.py. Signals into the pockets are the next decision.
D29 answered 2026-11-05: **C, as recommended** (user). Drawn from power_shapes.json: PWR_3V3_MAIN_In3 is now the whole of In3 at priority 0 (VBAT_PROT, the entry's In3 pours and the 1V5 island take their own), and nine named feeds (power/joins/d29_options.json, option C): R601/R701/R801 9.5 mm and 2 vias each from the In3 strip at y 122.6; R607 5.0 mm, R807 36.2 mm from the plane; R707 81.5 mm from R607's feed; R211/C215 43.3 mm from R807's; U202 8.4 mm; U203 1.4 mm. CI DRC 0 errors, parity 0; power and ground opens 30 -> 21 (every 3V3 open in the band joined; U501 pin 18 left); outputs 2.159/1.873/2.162/1.859/2.141/1.886 mOhm and VBAT_D 0.302, VBAT_Q2D 0.144, VBAT_IN J901-Q202 0.647 (0.645 before), J910-Q201 0.611 mOhm, as before; T1S corridor and stubs unchanged. Next: the signals into the pockets.

D30 asked 2026-11-05 (signals into the output cells' pockets; user: "Yes, write it"): seven nets per cell (SPI x4, FLT, SNS via R6x6, shared LHI) go to U401's south rows. The grid search could not route even the unconstrained case at the board's via and hole rules, so no route lengths are evidence; the page decides topology. Measured: crossings (fast route 2.33-4.66 mOhm), cutting the F.Cu top strips (+0.5 mOhm each, equal) and, for B at the middle cell, 1,430 legal via sites in the B.Cu channel north of U701 but none at y >= 109.3, all under the VBAT_IN bar's F.Cu area: B opens lanes for the west and east cells only. Turning U701 180 on a copy puts the logic pins north and the OUT pins south, but OUT3's east and OUT4's west: each cell's two connectors would swap channels in the schematic. Options: D work up the 180 turn (recommended), B cut the strips (fallback, west/east only), X cross, S in from the south. Page D30-build.py.

D30 answered 2026-11-05: **D: work it up** (user). Then the user (2026-11-05): "also on the schematic, let's swap the pinout on FL501 and K501 in order to remove the need for the net crossover of T1S_PHY_P and T1S_PHY_N".
D31 asked 2026-11-06 (both worked up on copies of main 011bcc7). 1, the output switches turned 180 degrees (cells/turn_cells.py): pin-local parts turned about each chip's centre, Cx06 mirrored beside its pins, NTC group and Cx02 unchanged; OUT blocks to y 112.2-118.7 on B.Cu and 112.2-113.95 on F.Cu, columns unchanged; channels swap (schematic: pins 6-8 to OUT_B, 9-11 to OUT_A; connectors keep their OUT numbers; firmware channel map changes). Measured: outputs 1.65/1.69/1.63/1.70/1.63/1.67 mOhm (today 2.16/1.87/2.16/1.86/2.14/1.89); hot loop unchanged (CVBB1 0.45/4.48 mm); DRC 0 errors; the fast route cuts output pours with 2 through-running nets (SW_LHI, SPI4 MISO), not 9. 2, FL501/K501 swapped (t1s/swap_pins.py, spec_t1s.py swap): P east along the chain, C511/C512 sides swapped, taps' vias swapped, PHY pair straight (no vias). Measured: PHY stub 24.6/25.6 mm (28.6/25.6), relay leg 23.9/24.9, end-node dangle 27.7/22.4 and 11.2/16.5; PHY skew rule passes at 0.5 mm again; DRC 0 errors; RMII TX setup 0.60, hold 0.69 ns. Schematic: FL501 mirrored about its horizontal axis; K501's T1S_P/T1S_N labels swap between COM1 and COM2, and the pole labels swap with them (coil pins unchanged: latching by polarity). Page D31-build.py.
D31 answered 2026-11-06: **Land both** (user). Schematic (cells/edit_sheets_d31.py): output-switch sheet OUT_A/OUT_B labels swap texts (channel 1, pins 6-8, and C605 now OUT_B; connectors unchanged); t1s sheet FL501 mirrored (x), K501's T1S_P/T1S_N labels swap between COM1 and COM2 and the pole labels with them (R518/R519 now P's). ERC clean before and after; netlist diff exactly those pads (scripts/netlist_pads.py --diff). Board (cells/land_d31.sh): pads' nets from the schematic (scripts/apply_netlist.py), the switches turned (turn_cells.py --keep-nets: pours and connectors keep their OUT numbers), the cells' joins (cells/d31_cell_joins.json), the T1S line with spec_t1s.py swap (now the default; C511 east, C512 west, taps' vias swapped, PHY pair straight), TXD0 and the termination re-routed (build_term.sh's second pass now keeps other nets' tracks 0.85 mm off T1S tracks). Rule: PHY pair skew back to 0.5 mm. CI DRC 0 errors, parity 0; opens as before (216: 68 parked test points, 21 power/GND, 6 T1S straps/IRQ); outputs 1.693/1.648/1.696/1.634/1.675/1.653 mOhm; VBAT_D 0.302, VBAT_Q2D 0.144; T1S trunk 38.9, PHY stub 24.6/25.6, relay leg 23.9/24.9, end node 27.7/22.4 and 11.2/16.5; RMII TX setup 0.60, hold 0.69, RX setup 3.32, hold 1.37 ns; trunk corridor clean; every block on its table (out_6x/out_34/out_8x rewritten, C511/C512 in t1s.poses.json). Firmware: OUT1/3/5 are channel 2 of each switch (mcu-config.yaml).

D32 asked and answered 2026-11-12 (run `placement/2026-11-12-passives/`, page https://claude.ai/artifact/JLN8hwiMkwVew3kSbyn1BE): passive placement review, nine options A-I. **I and H** (user): every move of attempts 01-08 and the TVS pour. Landed by `placement/2026-11-12-passives/land_d32.sh`: C215, R211, R406, R407 at U203 (new table u203_parts); R508 at U401 ball B3; R607/C607, R707/C707, R807/C807 and R701 on the 3V3 plane south of U401 (new table mcu_pullups); R601 and R801 at the In3 margins' vias (out_6x, out_8x rewritten; out_34 loses R701, R707, C707); R513 east of U501 pin 23 (t1s table); power_shapes.json loses 52 stubs and points (the 3V3 feeds into the band, three vias that joined nothing) and gains 8 vias, 13 stubs and the zone PWR_VBAT_IN_D201_F. draw_power.py: a locked stub longer than 2 mm now goes on a redraw (it used to stack: 1V5_CORE_REG had 7 copies, now 1). DRC 0 errors, parity 0, 211 unconnected (216 before), every block on its table, prove_rules.py 32 of 32. Fast routes (KRT v0.24.0) could not rank the options: one moved resistor swings the blocking count more than the options differ.

D33 asked 2026-11-12, open (run `placement/2026-11-12-route/`, page https://claude.ai/artifact/1mJPM6ByyyzovSkJMTTtqk): how signals cross the power band. A keep the rules and cut the pours (measured: the routed attempt on branch `layout/route-attempt-6layer`), B signal tracks on F.Cu under the GND busbar (recommended; needs an edit to `node60.kicad_dru` that is the user's to make), C 8 layers.
D34 2026-11-12 (taken by Claude under the user's approval of the session's recommendations; `placement/2026-11-12-route/decisions/log.md` has each with how to undo it): the D17 A rule areas drawn again (lost in `111fb0e`, 2026-11-05); the termination drive lines laid again clear of U401 ball E1; R501 turned 180 degrees, C509 0.25 mm east (t1s table); U201's VBAT_D joins moved off pins 1-5 and 23; 1V5_CORE_FB by hand; five nets pre-routed; the full routed attempt kept off main (30 open, VBAT_Q2D +82 %, east VBAT_IN +28 %, OUT4 +30 %). On main: DRC 0 errors, parity 0, 205 unconnected, blocks on their tables, prove_rules.py 32 of 32, T1S trunk 38.9, PHY stub 24.6/25.6, relay leg 23.9/24.9 (unchanged), supply paths unchanged but VBAT_PROT (0.785 -> 0.796 W at 3 x 20 A, the In2 pour back south of y 70).
