karlTbowers/node60-hw/docs/src/content/docs/index.mdx

---
title: Power distribution node, 10 A variant
description: Node60 Architecture Rev A decision overview, status, and primary release blocker.
tableOfContents: false
---

import { Aside } from '@astrojs/starlight/components';
import StatusGrid from '../../components/StatusGrid.astro';
import Ref from '../../components/Ref.astro';
import HeroRender from '../../components/HeroRender.astro';
import VehicleWiring from '../../components/VehicleWiring.astro';

<HeroRender />

**Architecture Rev A · dated 2026-10-13 · schematic baseline.** Automotive, six outputs, 10BASE-T1S.

Six protected high-side outputs with current and voltage telemetry, built around S32K344EHT1MMMST and LAN8670D0-E/LMXVAO. Output stage: 3 × TPS2HCS08A-Q1.

## One node per corner

Node60 is made for wiring classic and older vehicles with very little wire. Instead of a fuse panel with a wire to every lamp, a node sits beside each group of loads: one behind each headlight, one by each taillight. Battery power jumps from node to node, and one 10BASE-T1S pair from Hub 100 under the dash carries the control.

<VehicleWiring />

<Aside type="tip" title="Architecture decision">
Use three TPS2HCS08A-Q1 dual-channel smart high-side switches for the six-output active design (<Ref id="DEC-008" />), each on its own MCU SPI bus so that one switch fault affects only its two outputs (<Ref id="DEC-018" />). At the input, **LM74910H-Q1** and INA228A-Q1 Kelvin-share one 0.3 mΩ 4-terminal RSENSE (<Ref id="DEC-001" />, <Ref id="DEC-002" />). For Rev A, keep power sequencing **discrete**: LAN8670 INH directly enables the LMQ66430 3.3 V buck, and the TPS628502 1.5 V core buck on 3V3_MAIN follows by EN chaining (<Ref id="DEC-026" />), with no FS26, wake latch, or MCU standby dependency (<Ref id="DEC-004" />). An automotive 32 Mbit SPI NOR retains the diagnostic log across complete power-down (<Ref id="DEC-011" />). Firmware runs on Zephyr RTOS (<Ref id="DEC-019" />).
</Aside>

<StatusGrid />

<Aside type="danger" title="Primary release blocker">
TI specifies 13 A continuous at 85 °C with one channel enabled, but only **8 A per channel when both channels are enabled**. Because every device serves two outputs, 10 A continuous on all six outputs cannot be released until the complete PCB, enclosure, ambient, and adjacent-channel thermal matrix proves it (<Ref id="GATE-THM-01" long />).
</Aside>

## Decision summary

Three TPS2HCS08A-Q1 devices provide six cost-optimized outputs. LM74910H-Q1 and INA228A-Q1 Kelvin-share one 0.3 mΩ 4-terminal RSENSE for total-current telemetry and input protection. Rev A uses a discrete power tree: a nanopower LDO keeps only LAN8670 VDDAU alive at roughly 50 µA typical / 65 µA maximum parked draw, and PHY INH directly enables the LMQ66430 3.3 V buck, which feeds the TPS628502 1.5 V core buck. The controller ECU wakes the node over the T1S pair and explicitly commands shutdown; the node turns all outputs off, flushes its IS25LP032D-JNLA3 diagnostic log, then commands PHY sleep and powers down (<Ref id="DEC-007" />). FS26 is not fitted. TMP175-Q1 plus four NTCs provide hotspot coverage (<Ref id="DEC-010" />); the S32K344 SWT remains the watchdog (<Ref id="DEC-005" />), and TPS3702-Q1 independently supervises 3V3_MAIN (<Ref id="DEC-006" />). The 10 A target remains release-blocked by the 8 A-per-channel both-on rating at 85 °C.

## Reading this site

- [Purpose & design basis](requirements/): requirements with IDs and the gates that verify them.
- [System architecture](system/): the power and signals views; every block links to its subsystem page.
- Subsystem pages carry the reasoning; [decisions](decisions/) record each choice with its rejected alternatives.
- [Component baseline](components/), [schematic interfaces](interfaces/), [verification gates](verification/), and the [source register](sources/).
- [Revisions](revisions/): the architecture's revision history.
