karlTbowers/node60-hw/docs/src/content/docs/subsystems/harness.mdx

---
title: Connector & harness architecture
description: Node60 output and input connectors, four-conductor node cable, and fusing.
---

import { Aside } from '@astrojs/starlight/components';
import PartTable from '../../../components/PartTable.astro';
import Ref from '../../../components/Ref.astro';

Each output gets a sealed, independently protected path; the aggregate input is treated as a 60 A interconnect problem, plus the battery current passed through to a downstream node.

| Interface | Architecture | Release condition |
|---|---|---|
| Six outputs | Amphenol Sine AT13-2P-BM04, one 2-pin right-angle header per output (<Ref id="DEC-013" />); 10 A each; 14 AWG minimum | Pin 1 = OUTx, pin 2 = local return; contact temperature rise at 10 A proven up to +125 °C ambient; DT06-2S, sockets, wedgelock, wire, and panel seal frozen together |
| Battery input | Two Würth REDCUBE 74660016R M6 terminals with red Amphenol SurLok Plus SLPRATPSR receptacles in the lid, joined by an internal busbar (<Ref id="DEC-016" />, <Ref id="DEC-020" />) | either receptacle takes the source cable and the other passes battery to a downstream node, through busbar BB901 (and, about 1 %, the board); prove the full current path at <Ref id="GATE-HAR-02" /> |
| Power return | Two REDCUBE 74660016R terminals with black SurLok Plus SLPRATPSB receptacles, busbar-joined; all six output returns come back through the node (<Ref id="DEC-013" />, <Ref id="DEC-016" />) | 60 A plus the downstream return; no chassis-only return assumption |
| 10BASE-T1S | Two Amphenol Sine ATM13-2P-BM04: J903 upstream and J912 downstream, in parallel on the pair; sealed 2-pin right-angle PCB receptacles, mate ATM06-2S (<Ref id="DEC-014" />, <Ref id="DEC-017" />) | Vehicle-level protection and termination strategy; verify pin 1 on a sample |
| Complete node cable | Four conductors: T1S twisted pair + battery-direct power + ground, plus an optional battery/ground pass-through to one downstream node | No KL15, ignition, or local hardwire wake input; controller ECU must provide T1S wake (<Ref id="REQ-NET-001" />) |

## Output connectors

Each output has its own **Amphenol Sine AT13-2P-BM04** header: BoardLock AT13, 2 pins at 5.40 mm, right angle, with a panel flange gasket and a potted rear. It mates an AT06-2S plug (Amphenol's DT06-2S equivalent) with size 16 sockets for 14 to 20 AWG. Amphenol rates it 13 A, 250 V, −55 to +125 °C at rated current, and IP67 mated. It seals against the enclosure wall through the same panel cutout as the DT13-2P. See <Ref id="DEC-013" long />.

**Pin assignment:** pin 1 = OUTx, pin 2 = that output's local ground return. Up to 60 A of load return current (six outputs at 10 A) therefore flows back through the node to the power-entry star ground and out through the node's ground conductor. That conductor, its input contacts, and the board's return path must carry 60 A, matched to the battery feed.

<Aside type="caution" title="Confirm pin 1 on the first sample">
Amphenol's drawing labels pins 1 and 2 on the mounting face, and the footprint follows it. Confirm the moulded cavity numbers on the first sample and label them on the harness drawing, so OUTx and ground cannot be swapped at the harness.
</Aside>

## Power entry and pass-through

Four **Würth REDCUBE SMT 74660016R** terminals (M6 internal thread, 85 A max at 20 °C) sit on the board: J910 and J901 on the battery input (both VBAT_IN), J902 and J911 on the return. Amphenol **SurLok Plus** 5.7 mm receptacles in the lid screw into them through the board: red SLPRATPSR on battery, black SLPRATPSB on return, IP67 mated, 3 N·m on the M6 thread. A busbar inside the case joins each pair, so one receptacle of each pair takes the source cable and the other feeds a lower-current downstream node. Either pair may be the source; the harness decides (DEC-016 rev. C), and the power entry is mirrored about the midpoint between J910 and J901, so the node is fed the same way from either. The battery busbar BB901 is a board part: a two-pin net tie on the schematic with both pins on VBAT_IN, on the BOM; it carries about 99 % of the pass-through, the rest flowing in the F.Cu pour under it. The return busbar BB902 is a schematic and BOM part the same way, with both pins on GND; the GND plane joins J911 and J902 as well. See <Ref id="DEC-016" long />.

<Aside type="caution" title="The pass-through bypasses Node60's protection">
The downstream feed leaves before the LM74910H ideal diode and breaker and before the INA228 shunt. Size the source fuse and cable for both nodes, and give the downstream node its own protection. The downstream feed is limited to **40 A** for now (upstream total 100 A), with the battery busbar carrying all of it; GATE-HAR-02 confirms the limit or raises it toward 60 A. Sealing of the power entry is not decided yet.
</Aside>

## Enclosure and board mounting

The board mounts component side up, 230 × 110 mm, 2.0 mm thick, 6.17 mm off the floor (<Ref id="DEC-023" />, <Ref id="DEC-024" />, <Ref id="DEC-025" />; 5 mm until the SurLok stud length was known, 2026-11-02). The REDCUBE terminals sit on its bottom side, and a 1/8" × 3/4" copper busbar joins each power pair (<Ref id="DEC-021" />; 1/8" × 1" until <Ref id="DEC-025" />), resting on the terminals' spigots 0.6 mm above the top face. The SurLok receptacles sit on the busbars in the low middle of the lid, between a raised band across the front over the output headers and a separate raised hood over the T1S pair in the middle of the north wall. The north wall is a removable panel, fitted after the board. Each SurLok right-angle plug can leave outward (west or east) or north; `scripts/check_surlok_clearance.py` checks every combination (<Ref id="DEC-022" />).

This is version 15 (version 11, which is version 7 compact on a 2.0 mm board, with 1/8" × 3/4" busbars) of the enclosure designs on the [Enclosure options](../enclosure/) pages, each with its dimensions, panel cutouts and busbar cut list; the others stay there as the record of the options. **[Open the 3D enclosure mockup](../../mockups/node60-enclosure.html)** to switch between them, orbit them and turn the plugs.

<Aside type="note" title="SurLok stud length">
The busbar sits between each receptacle and its REDCUBE, so the stud's length decides how much thread it engages. Amphenol's SLPRATPSB drawing C10-730187 gives 9.95 mm beyond the seat (found 2026-11-02; the library's earlier estimate was 7.7 mm), so with the 1/8" busbar the stud takes the REDCUBE's whole 5.6 mm thread and comes out 1.2 mm below it. The receptacle's panel face is 9.25 mm above the busbar, which puts the low lid 8.8 mm lower than first drawn; see [Power receptacles: RADLOK vs SurLok Plus](../enclosure/receptacles/).
</Aside>

## Fusing

Place the primary fuse at the battery/source end, sized for Node60 plus the downstream node fed through the pass-through. If the 60 A path is split, fuse each feed and prevent back-powering through an undersized path. Final values coordinate wire ampacity, contact derating, load inrush, PCB fault energy, and the smart-switch curve. Use branch fuses wherever the main fuse cannot protect an output conductor or connector fault.

<Aside type="caution" title="Connector freeze condition">
Connector families are architectural selections, not released mating sets. Freeze exact housings, terminals, seals, wire sizes, and keys together; validate temperature rise with all intended adjacent circuits loaded.
</Aside>

## Parts

<PartTable subsystem="harness" />
