karlTbowers/node60-hw/docs/src/content/docs/subsystems/network.mdx

---
title: 10BASE-T1S subsystem
description: Node60 LAN8670D0 PHY, line interface, PLCA identity, TC10 bus wake and controller-commanded shutdown.
---

import { Aside } from '@astrojs/starlight/components';
import Metrics from '../../../components/Metrics.astro';
import MermaidDiagram from '../../../components/MermaidDiagram.astro';
import PartTable from '../../../components/PartTable.astro';
import GateList from '../../../components/GateList.astro';
import DecisionList from '../../../components/DecisionList.astro';
import Ref from '../../../components/Ref.astro';

LAN8670D0 connects over RMII/MDIO and operates as a commissioned PLCA follower on the multidrop segment.

## PHY and line interface

| Circuit | Selection | Implementation |
|---|---|---|
| Reference clock | ECS-3225SMVQ-500-DS-TR | 50 MHz HCMOS, ±20 ppm; oscillator enable controlled with main power |
| Line coupling | 2 × 100 nF series capacitors | Automotive C0G/film-equivalent behavior with voltage and DC-bias margin |
| Termination | OPEN Alliance split termination: a latching relay selects 49.9 Ω (bus end) or 1.5 kΩ (mid-bus) legs to a centre tap with 100 nF ‖ 100 kΩ (<Ref id="DEC-017" />) | Commissioned by the controller and stored in flash; restored at every cold boot; held through sleep |
| Bus pass-through | Second ATM13-2P-BM04 (J912) in parallel with J903 (<Ref id="DEC-017" />) | Shortest trunk between the two connectors; stub to the PHY well under 10 cm |
| Common mode choke | ACT1210E-241-2P-TL00 | TDK 240 µH 10BASE-T1S choke, AEC-Q200; alternates ACT1210E-131 and Murata DLW32MH241MX2L (<Ref id="DEC-012" />) |
| Protection | 4 × VETH100A1DD1HG3-08 | Vishay OPEN Alliance T1S ESD diode, ≤2.0 pF, AEC-Q101: one pair right at each T1S connector (D501/D502 at J903, D503/D504 at J912), ahead of the choke; the two pairs add at most 2.0 pF across the line, inside the OPEN Alliance CMDI ≤ 25 pF node budget; Nexperia PESD1ETH10L(S)-Q alternates (<Ref id="DEC-012" />) |

## Identity and PLCA

Firmware stores a unique locally administered MAC address and commissioned PLCA node ID in protected flash. Node ID must be unique and is not hard-coded identically across production units. Coordinator mode is disabled by default.

## TC10 bus-wake and complete shutdown

The parked node is not an MCU standby system. It is powered down except for the LAN8670 always-on domain, so the missing S32K3 Zephyr standby implementation is no longer on the critical path. The controller ECU—powered from battery and switched ignition—owns the only wake source and sends the T1S wake-up pattern over the same pair used for data (<Ref id="DEC-007" />).

<Metrics items={[
  ['40 µA typ', 'LAN8670 VDDAU sleep current'],
  ['56 µA max', 'LAN8670 VDDAU sleep current'],
  ['≈52 µA', 'complete node parked, typical'],
  ['≈65 µA', 'complete node parked, maximum (Rev A estimate; recheck with the TPS7B8133 maximum Iq)'],
]} />

| Phase | Defined sequence | Contract / evidence |
|---|---|---|
| Parked | Battery → LM74910H-Q1 in SLEEP (6 µA, ideal diode active) → TPS7B8133-Q1 LDO → LAN8670 VDDAU only. VDDA, VDDP, MCU, flash, bucks, and all outputs are off. | The selected TPS7B8133-Q1 draws 3.5 µA, above the ≈1–2 µA Rev A target; the parked budget is ≈52 µA typical (accepted 2026-10-28). LAN8670 sleep current is 40 µA typical / 56 µA maximum. |
| Wake | Controller sends T1S wake-up tone → PHY detects it → INH high → bucks ramp → S32K344 cold boot → PHY re-initialization → link up → outputs become commandable. | Supply ramp plus PHY initialization must stay within 15 ms (OPEN Alliance Sleep/Wake-Up Electrical Interface Specification v1.0, §5.2); estimated ≈10 ms, measured at GATE-NET-01. PHY registers are lost while VDDA/VDDP are down; T1S_IRQ_L indicates readiness for configuration. A roughly 1 s application-ready latency is acceptable. |
| Shutdown | Controller sends application-level “go to sleep” message → firmware turns all six outputs off → flushes pending log entries → commands PHY sleep → INH releases after tSLPINHDLY → power tree collapses. | Write-before-sleep ordering is mandatory. Bus-idle timeout is rejected as the sleep source. |

<MermaidDiagram name="power-cycle" caption="The controlled power cycle." />

<Aside type="danger" title="Four-wire system dependency">
The T1S pair is the only wake path. The node cannot wake itself and has no KL15 input; if the controller ECU does not emit the wake pattern, the node stays off. This is a controller-interface requirement, not a recoverable local condition.
</Aside>

<Aside type="caution" title="Wake inrush & exact-target validation">
INH powers the complete switched tree at once. Size the LM74910H TMR breaker ride-through for regulator, bulk-capacitance, MCU, PHY, and output-stage startup inrush. Validate TC10 sleep/wake, INH timing, cold boot, lost-register PHY re-initialization, T1S_IRQ_L ready behavior, PLCA restoration, and application readiness on the exact S32K344EHT1MMMST target.
</Aside>

## Decisions

<DecisionList page="subsystems/network" />

## Parts

<PartTable subsystem="network" />

## Gates

<GateList page="subsystems/network" />
