karlTbowers/node60-hw/docs/src/content/docs/subsystems/power.mdx

---
title: Power entry & regulated rails
description: Node60 protected 60 A VBAT path, input current and voltage telemetry, overcurrent protection, and the discrete INH-gated power tree.
---

import { Aside, Card, CardGrid } from '@astrojs/starlight/components';
import Metrics from '../../../components/Metrics.astro';
import PartTable from '../../../components/PartTable.astro';
import GateList from '../../../components/GateList.astro';
import DecisionList from '../../../components/DecisionList.astro';
import Ref from '../../../components/Ref.astro';

A protected 60 A-capable VBAT path and deliberately split low-power rails support load control and network wake.

## Protected battery path

**LM74910HQRGERQ1** controls the DGATE ideal-diode MOSFET bank and HGATE disconnect MOSFET bank for reverse-battery blocking, overvoltage disconnect, programmable overcurrent circuit breaking, and fast short-circuit protection (<Ref id="DEC-001" />). A shared 0.3 mΩ 4-terminal RSENSE sits between the two FET stages and carries the complete rail current. At 60 A, device count, RDS(on), sharing, copper/bus structure, resistor heating, and fault energy must be calculated together. A 24 V bidirectional XLD8A24CA TVS is preferred after the source fuse; SMBJ24CA is not accepted as the sole primary load-dump element (<Ref id="DEC-003" />).

| Element | Selected device / value | Open detail |
|---|---|---|
| Ideal-diode controller | LM74910HQRGERQ1, VQFN-24 (4 × 4 mm), AEC-Q100 Grade 1 | Choose 80–100 V AEC-Q101 MOSFETs after surge/thermal calculation; verify VOUT tap after Q2 |
| Primary TVS | XLD8A24CA, 24 V, 7 kW class | Verify clamp against regulator and MOSFET limits |
| Input fuse | Source-mounted; one per feed when dual-fed | Coordinate 60 A load, wire ampacity, inrush, and fault clearing |
| EMI filter | Damped π filter after protection, regulator branch only: L201 Würth 74438356022HT 2.2 µH; C207 Nichicon GYF1H470MCQ1GS 47 µF 50 V hybrid polymer as the damping capacitor, with C217 (same footprint) not fitted | Values follow the emissions test: 1.0 or 4.7 µH fit L201's footprint; C217 takes a second 47 µF, or C207 + C217 take 2 × 22 µF |

## VBAT_RAW voltage telemetry

**BATT_MON is a divider tap, not a controller pin.** Move it to the LM74910H-Q1 SW-pin OV/UV divider. Retain the 1:12 monitor-ratio concept so the S32K344 ADC stays in range, but recalculate all divider values at schematic review because the LM74910H OV threshold is 0.6 V rather than the LM74800’s 1.23 V.

| Divider item | Rev A requirement | Electrical result |
|---|---|---|
| OV/UV ladder | Recalculate from SW; 1% resistors; no more than 120 kΩ total | Meets leakage-error rule while setting the required cutoffs |
| OV reference | 0.6 V | Old LM74800 divider values are invalid; final cutoff requires schematic calculation |
| Monitor ratio | Retain 1:12 concept from SW to BATT_MON | Keeps the ADC in range through the intended protected transient window |
| ADC interface | Spare ADC input + 10 nF to ground | Set ADC sample time from the final divider’s Thevenin resistance |

<Aside type="caution" title="Measurement semantics">
The divider is connected to SW and reports **VBAT_RAW** on the battery side, before the DGATE ideal-diode FET—not VBAT_PROT. BATT_MON is not sampled while parked; qualify or gate its ADC tap so it does not compromise the ≈50 µA parked budget, then restore it on wake. Use the LM74910H’s separate UVLO pin to define cold-crank behavior and document both networks at schematic review.
</Aside>

## Shared protection and total-current measurement

Fit one **0.3 mΩ, 1%, AEC-Q200, 4-terminal RSENSE** (R201, Isabellenhütte BVR-Z-R0003-1.0, 4026; 0.25 mΩ CSS2725FTL250 until rev. B, decision D14-1, 2026-11-03) between the DGATE ideal-diode FET and the HGATE disconnect FET. Its force pads carry VBAT_D (pad 1) and VBAT_Q2D (pad 4); its sense pads are the nets RS_SENSE_P (pad 2, VBAT_D side) and RS_SENSE_N (pad 3). The LM74910H current-sense inputs and INA228A-Q1 each take their own pair from the sense pads; the high-impedance measurement paths do not interact. Route every downstream branch—including buck, MCU, PHY, and switches—from VOUT after Q2 so RSENSE captures true total node current.

<Metrics items={[
  ['0.3 mΩ', 'shared protection/measurement RSENSE'],
  ['18 mV', 'drop at 60 A'],
  ['1.08 W', 'RSENSE dissipation at 60 A'],
  ['44%', 'of ±40.96 mV ADC range at 60 A'],
]} />

The arithmetic: 60 A × 0.3 mΩ = 18 mV; (60 A)² × 0.3 mΩ = 1.08 W, against 5 W rated above 100 °C terminal temperature; 18 mV / 40.96 mV ≈ 44%.

| Monitor option | Verified specification | Price / availability observed 2026-10-13 | Decision |
|---|---|---|---|
| INA228AQDGSRQ1 | AEC-Q100 automotive qualified; 20-bit delta-sigma ADC; ±1 µV maximum shunt offset; ±0.05% maximum gain error; ±85 V bus range; I²C; VSSOP-10 (DGS) | $5.43 @1 / ≈$3.20 @1k; 32,413 DigiKey stock | **Plan of record.** ADCRANGE = 1 gives ±40.96 mV; 18 mV at 60 A uses ≈44% of range. CURRENT_LSB 260.4167 µA, SHUNT_CAL 4096 for 0.3 mΩ |
| INA281A2QDBVRQ1 | AEC-Q100 Grade 1; −40…+125 °C; −4…+110 V common-mode; gain 50; ±300 µV maximum offset; ±0.5% maximum gain error; SOT-23-5 | $3.21 @1 / ≈$1.80 @1k; 8,138 DigiKey stock | **Budget fallback.** Analog output needs an S32K344 ADC channel; offset refers to about 1.0 A at 0.3 mΩ |

<Aside type="tip" title="Why INA228A-Q1 is plan of record">
The shared resistor sees regulator, MCU, PHY, controller, and load current that the six channel readings cannot fully reconstruct. INA228A-Q1 adds only about $0.90 at 1,000 pieces versus an INA240-class analog implementation, avoids an MCU ADC channel, and preserves useful low-current accuracy despite the 0.3 mΩ resistor. Current diverted ahead of RSENSE—including through the primary TVS—remains outside this measurement. See <Ref id="DEC-002" long />.
</Aside>

<Aside type="note" title="Keep both voltage measurements">
INA228A-Q1 digitizes the protected rail while the LM74910H SW divider and MCU ADC measure **VBAT_RAW** before the ideal-diode FET. They observe different nodes and support different diagnostics, so neither replaces the other. The INA228 also reports current and power after firmware programs and verifies SHUNT_CAL (4096 for 0.3 mΩ, <Ref id="DEC-002" />).
</Aside>

<Aside type="caution" title="Dynamic range & sourcing">
A single 60 A RSENSE cannot also resolve parked sleep current. Parked-drain verification remains a validation-lab measurement. INA240-Q1 and INA229-Q1 were both zero-stock with restocks indicated around February 2027. INA228AQDGSRQ1 is the in-stock plan of record; INA281A2QDBVRQ1 remains the documented lower-cost fallback with substantially higher offset and lower low-current accuracy.
</Aside>

## Input overcurrent protection

| Protection path | Setting (rev. B) | Implementation / test |
|---|---|---|
| Circuit breaker OCP | 74.8 A | R(ILIM) = 12 × RSET / (RSENSE × ILIM): R208 26.7 kΩ 1 %, RSET R209 49.9 Ω (50–100 Ω datasheet range) on 0.3 mΩ |
| Fast SCP | 24.0 mV = 80 A typical (71.4–92 A) | RISCP R210 383 Ω 1 %: 10.5 µA × 383 Ω + 20 mV; the same window as rev. A's 20 mV on 0.25 mΩ. Validate threshold and fault energy on the power-entry coupon |
| Breaker delay | TMR 68 nF for ≈1 ms starting point | Tune against output bulk-capacitance inrush at schematic review |
| Fault response | FLT to S32K344; SLEEP OCP auto-retry | FLT supplies pre-trip warning; auto-retry lets the input breaker recover after a cleared fault without intervention from a parked, sleeping MCU |
| IMON | Not populated | Leave the optional ±2% analog current-monitor pin floating per datasheet while INA228 is fitted |

<Aside type="tip" title="Why LM74910H-Q1 replaces LM74800-Q1">
One resistor now serves both protection and precise measurement, cutting shunt heat in half at 60 A. More importantly, the prior LM74800 architecture had no input-rail overcurrent protection; LM74910H adds a programmable breaker, fast short-circuit trip, separate UVLO, FLT warning, and SLEEP-mode OCP auto-retry.
</Aside>

<Aside type="note" title="Rejected alternative — LM74900-Q1">
LM74900-Q1 saves about $1 at 1,000 pieces but latches off after SLEEP-mode overcurrent instead of auto-retrying. That is the wrong trade for a battery-parked node whose MCU may be asleep when the fault occurs.
</Aside>

### Current-monitor alternatives not carried forward

- **INA186-Q1:** 40 V common-mode ceiling leaves no margin for clamped load-dump transients; no authorized stock observed.
- **ST TSC2011:** automotive grade, exact part number, and pricing were not verified.
- **Microchip PAC1932/34:** no AEC-Q100 qualification.

## Power domains

<CardGrid>
  <Card title="VDDAU_AON">
    A TPS7B8133-Q1 nanopower LDO supplies only LAN8670 VDDAU while parked. Its 3.5 µA quiescent current is above the ≈1–2 µA Rev A target; no 40 V Grade 1 part met that target, and the ≈52 µA parked budget was accepted on 2026-10-28.
  </Card>
  <Card title="3V3_MAIN">
    S32K344 I/O/analog, LAN8670 VDDA/VDDP, switch VDD, SPI NOR, clock, and the 1.5 V buck's input. U302, an LMQ66430-Q1 at 2.2 MHz on VBAT_FILT, is enabled directly by PHY INH.
  </Card>
  <Card title="1V5_CORE">
    S32K344 V15 via a TPS628502-Q1 buck fed from 3V3_MAIN (<Ref id="DEC-026" />): fixed 2.25 MHz with spread spectrum, out of the AM band at any battery voltage. EN-pin chaining from 3V3_MAIN establishes the order and allows at least 250 mA transient margin.
  </Card>
  <Card title="VBAT_PROT">
    VOUT after Q2 feeds the always-on LDO, all three TPS2HCS08A-Q1 devices, and, through the L201 EMI filter (VBAT_FILT), the 3.3 V buck, so shared RSENSE sees the complete downstream current.
  </Card>
</CardGrid>

<Aside type="caution" title="Power-sequencing hold point">
On bus wake, LAN8670 drives INH high. The OPEN Alliance limit is supply ramp plus PHY initialization within 15 ms (Sleep/Wake-Up Electrical Interface Specification v1.0, §5.2); the LAN8670 datasheet's "within 1 ms" is Microchip's own allocation. With the LMQ66430 (~6–7 ms to regulation; the TPS628502 adds its 1 ms soft-start once 3V3_MAIN is up) and the LAN8670 D0 reset and initialization (~3 ms), the estimate is about 10 ms. Rev A accepts this and measures it (GATE-NET-01). Verify EN-chain delay, regulator soft-start, MCU reset release, PHY-ready T1S_IRQ_L, and whole-board inrush together. VDDA must never exceed VDDAU by more than 0.5 V; the always-on-first topology satisfies that rule by construction.
</Aside>

## FS26 removed from Rev A

The first version stays discrete. FS26’s original roles are now covered by the 3.3 V and 1.5 V bucks, the S32K344 internal windowed SWT, the TPS3702 rail supervisor, and the LAN8670 INH gatekeeper. Do not place FS26 in the Rev A schematic or BOM. Reconsider an SBC only in a later revision if wake or sequencing requirements outgrow direct INH gating and EN-pin chaining. See <Ref id="DEC-004" long />.

## Decisions

<DecisionList page="subsystems/power" />

## Parts

<PartTable subsystem="power" />

## Gates

<GateList page="subsystems/power" />
