karlTbowers/node60-hw/docs/src/content/docs/subsystems/safety.mdx

---
title: Safety, EMC & thermal architecture
description: Node60 deterministic safe states, diagnostic coverage, EMC and thermal foundations.
---

import GateList from '../../../components/GateList.astro';
import Ref from '../../../components/Ref.astro';

This is not a functional-safety certification claim; deterministic safe states and diagnostic coverage are foundations for later hazard analysis.

- SPI and LHI reset states leave every output off until the MCU verifies configuration and communication integrity.
- Parked state leaves only LAN8670 VDDAU alive; there is no local ignition or hardwire wake path. The controller ECU must issue the T1S wake pattern.
- Controller-commanded shutdown is transactional: outputs off, diagnostic-log flush complete, then PHY sleep and INH release.
- LM74910H-Q1 provides an independent 75 A circuit breaker, default 80 A fast short-circuit trip, FLT pre-trip warning, and SLEEP-mode OCP auto-retry on the 60 A input rail.
- Hard-lock and window the S32K344 SWT; use the Clock Monitoring Unit for clock-failure reset and TPS3702-Q1 for independent 3V3_MAIN overvoltage/undervoltage supervision through RESET_L.
- Separate high di/dt loops from SNS/ADC return, oscillator, RMII, and T1S coupling.
- Start with 2 oz copper and dense thermal vias at every exposed pad; calculate every 10 A path.
- Budget 5.34 W cold or 10.68 W hot for six full-load channels before other losses.
- Run ISO 7637-2 / ISO 16750 supply-transient tests and appropriate CISPR 25 conducted/radiated emissions.
- Validate inductive turn-off energy and every I²t profile against switch, load, harness, and connector.

Requirement: <Ref id="REQ-SAF-001" long />.

## Gates

<GateList page="subsystems/safety" />
