karlTbowers/node60-hw/docs/src/content/docs/subsystems/enclosure/v15.mdx

---
title: "Version 15: version 11 with 1/8 x 3/4 in busbars"
description: Node60 enclosure version 15, generated from its connector placement.
---

import EnclosureVersion from '../../../../components/EnclosureVersion.astro';

<EnclosureVersion version="v15" />
