karlTbowers/node60-hw/docs/architecture/Node60-Architecture-RevC.html

ARCHITECTURE / REV C

## 10 A power distribution node

Active baselineTPS2HCS08A-Q1 · S32K344 · LAN8670D0

SectionsREV C · 10 A VARIANT

AUTOMOTIVE / SIX OUTPUTS / 10BASE-T1S

# Power distribution node 10 A variant

Six protected high-side outputs with current and voltage telemetry, built around S32K344EHT1MMMST and LAN8670D0-E/LMXVAO.

Revision

C

Dated

2026-10-13

Output stage

3 × TPS2HCS08A-Q1

State

SCHEMATIC BASELINE

ARCHITECTURE DECISION

Use three TPS2HCS08A-Q1 dual-channel smart high-side switches for the six-output active design. At the input, LM74910H-Q1 and INA228A-Q1 Kelvin-share one 0.25 mΩ RSENSE. For Rev C, keep power sequencing discrete: LAN8670 INH directly enables the LMQ66430 bucks, with no FS26, wake latch, or MCU standby dependency. An automotive 32 Mbit SPI NOR retains the diagnostic log across complete power-down.

COMPUTES32K344EHT1MMMSTLocked · production

NETWORKLAN8670D0 over RMIIProcurement risk

POWERLM74910H + discrete INH gatingWake/inrush validation open

OUTPUTS3 × TPS2HCS08A-Q1Thermal proof required

SOFTWAREZephyr + SPI/I²t + PLCAExact target open

PRIMARY RELEASE BLOCKER

TI specifies 13 A continuous at 85 °C with one channel enabled, but only 8 A per channel when both channels are enabled. Because every device serves two outputs, 10 A continuous on all six outputs cannot be released until the complete PCB, enclosure, ambient, and adjacent-channel thermal matrix proves it.

01

## Purpose & design basis

A buildable product architecture defining power domains, signal paths, switching channels, telemetry, software responsibilities, and the preliminary production BOM.

### Design requirements

- Six independently commanded battery-side outputs, each targeting 10 A continuous.
- Per-output current and voltage monitoring reported over a multidrop 10BASE-T1S network.
- Current measurement resolves 100 mA steps over the full 0–10 A range; absolute accuracy is specified separately.
- AEC-Q100 Grade 1 target (−40 °C to +125 °C ambient) or better for active ICs.
- Four-wire node connection only: T1S twisted pair, battery-direct power, and ground. The controller ECU is solely responsible for bus wake.
- Low parked-vehicle battery draw, RMII host interface, PLCA follower operation, and Zephyr RTOS.
- Hardware safety must not depend on the network stack.

6 × 10 Aindependent protected outputs

60 Aworst-case aggregate output

100 mArequired current resolution

−40…125 °Cactive-IC temperature target

Parameter | Rev C requirement | Design consequence
Vehicle supply | 12 V nominal; protected automotive transients | 40 V-class regulators behind a load-dump clamp
Output channel | 10 A continuous target | TPS2HCS08A-Q1; 14 AWG minimum; dual-channel thermal proof
Current telemetry | 100 mA resolution per output; independent total-rail measurement | 3 × SPI-selected SNS ADC inputs plus INA228A-Q1 digital input-current monitor
Input voltage telemetry | Battery-side brownout and load-dump visibility | 1:12-concept LM74910H SW-pin OV/UV divider tap into a filtered 12-bit ADC input
T1S role | Multidrop follower | Configurable 100 Ω termination only at a physical endpoint
Parked state | Only LAN8670 VDDAU remains powered; all six outputs and main rails off | Bus-only TC10 wake; INH directly enables discrete bucks; MCU cold-boots

02

## System architecture

Battery protection, low-power control, logic, network, and six load channels are kept as explicit domains.

System block diagram showing battery-direct input, LM74910H protected power entry, always-on LAN8670 VDDAU supply, INH-gated discrete bucks, S32K344 controller, SPI flash, three dual high-side switches, six outputs, and the four-wire T1S plus power and ground interface

Figure 1. Battery, control, network wake, and switched-load domains. LAN8670 VDDAU is the sole always-on load; its INH output gates the main rails directly.

### Partitioning rule

Keep dirty load current outside the logic return path. The protected battery node feeds both the smart switches and the logic converters. Each output returns directly to the power-entry ground/star region; ADC and PHY grounds join through the quiet logic plane. The T1S coupling and ESD network sit at the connector boundary.

REV C POWER-GATE DECISION

FS26 is removed. A nanopower LDO supplies only LAN8670 VDDAU while parked; LAN8670 INH directly enables the two LMQ66430-Q1 bucks. EN-pin chaining establishes the 3.3 V / 1.5 V order without an SBC, wake latch, or extra logic.

03

## Power entry & regulated rails

A protected 60 A-capable VBAT path and deliberately split low-power rails support load control and network wake.

### Protected battery path

LM74910HQRGERQ1 controls the DGATE ideal-diode MOSFET bank and HGATE disconnect MOSFET bank for reverse-battery blocking, overvoltage disconnect, programmable overcurrent circuit breaking, and fast short-circuit protection. A shared 0.25 mΩ RSENSE sits between the two FET stages and carries the complete rail current. At 60 A, device count, RDS(on), sharing, copper/bus structure, resistor heating, and fault energy must be calculated together. A 24 V bidirectional XLD8A24CA TVS is preferred after the source fuse; SMBJ24CA is not accepted as the sole primary load-dump element.

Element | Selected device / value | Open detail
Ideal-diode controller | LM74910HQRGERQ1, VQFN-24 (4 × 4 mm), AEC-Q100 Grade 1 | Choose 80–100 V AEC-Q101 MOSFETs after surge/thermal calculation; verify VOUT tap after Q2
Primary TVS | XLD8A24CA, 24 V, 7 kW class | Verify clamp against regulator and MOSFET limits
Input fuse | Source-mounted; one per feed when dual-fed | Coordinate 60 A load, wire ampacity, inrush, and fault clearing
EMI filter | Damped π filter after protection | Finalize current and damping after emissions test

### VBAT_RAW voltage telemetry

BATT_MON is a divider tap, not a controller pin. Move it to the LM74910H-Q1 SW-pin OV/UV divider. Retain the 1:12 monitor-ratio concept so the S32K344 ADC stays in range, but recalculate all divider values at schematic review because the LM74910H OV threshold is 0.6 V rather than the LM74800’s 1.23 V.

Divider item | Rev C requirement | Electrical result
OV/UV ladder | Recalculate from SW; 1% resistors; no more than 120 kΩ total | Meets leakage-error rule while setting the required cutoffs
OV reference | 0.6 V | Old LM74800 divider values are invalid; final cutoff requires schematic calculation
Monitor ratio | Retain 1:12 concept from SW to BATT_MON | Keeps the ADC in range through the intended protected transient window
ADC interface | Spare ADC input + 10 nF to ground | Set ADC sample time from the final divider’s Thevenin resistance

MEASUREMENT SEMANTICS

The divider is connected to SW and reports VBAT_RAW on the battery side, before the DGATE ideal-diode FET—not VBAT_PROT. BATT_MON is not sampled while parked; qualify or gate its ADC tap so it does not compromise the ≈50 µA parked budget, then restore it on wake. Use the LM74910H’s separate UVLO pin to define cold-crank behavior and document both networks at schematic review.

### Shared protection and total-current measurement

Fit one 0.25 mΩ, 1%, AEC-Q200 RSENSE between the DGATE ideal-diode FET and the HGATE disconnect FET. Both the LM74910H current-sense amplifier and INA228A-Q1 Kelvin-connect with independent star taps at the resistor pads; the high-impedance measurement paths do not interact. Route every downstream branch—including buck, MCU, PHY, and switches—from VOUT after Q2 so RSENSE captures true total node current.

0.25 mΩshared protection/measurement RSENSE

15 mVdrop at 60 A

0.9 WRSENSE dissipation at 60 A

37%of ±40.96 mV ADC range at 60 A

Monitor option | Verified specification | Price / availability observed 2026-10-13 | Decision
INA228AQDGSRQ1 | AEC-Q100 automotive qualified; 20-bit delta-sigma ADC; ±1 µV maximum shunt offset; ±0.05% maximum gain error; ±85 V bus range; I²C; VSSOP-10 (DGS) | $5.43 @1 / ≈$3.20 @1k; 32,413 DigiKey stock | Plan of record. ADCRANGE = 1 gives ±40.96 mV; 15 mV at 60 A uses ≈37% of range. Configure and verify SHUNT_CAL for 0.25 mΩ
INA281A2QDBVRQ1 | AEC-Q100 Grade 1; −40…+125 °C; −4…+110 V common-mode; gain 50; ±300 µV maximum offset; ±0.5% maximum gain error; SOT-23-5 | $3.21 @1 / ≈$1.80 @1k; 8,138 DigiKey stock | Budget fallback. Analog output needs an S32K344 ADC channel; offset refers to about 1.2 A at 0.25 mΩ

WHY INA228A-Q1 IS PLAN OF RECORD

The shared resistor sees regulator, MCU, PHY, controller, and load current that the six channel readings cannot fully reconstruct. INA228A-Q1 adds only about $0.90 at 1,000 pieces versus an INA240-class analog implementation, avoids an MCU ADC channel, and preserves useful low-current accuracy despite the 0.25 mΩ resistor. Current diverted ahead of RSENSE—including through the primary TVS—remains outside this measurement.

KEEP BOTH VOLTAGE MEASUREMENTS

INA228A-Q1 digitizes the protected rail while the LM74910H SW divider and MCU ADC measure VBAT_RAW before the ideal-diode FET. They observe different nodes and support different diagnostics, so neither replaces the other. The INA228 also reports current and power after firmware programs and verifies SHUNT_CAL for 0.25 mΩ.

DYNAMIC-RANGE & SOURCING

A single 60 A RSENSE cannot also resolve parked sleep current. Parked-drain verification remains a validation-lab measurement. INA240-Q1 and INA229-Q1 were both zero-stock with restocks indicated around February 2027. INA228AQDGSRQ1 is the in-stock plan of record; INA281A2QDBVRQ1 remains the documented lower-cost fallback with substantially higher offset and lower low-current accuracy.

### Input overcurrent protection

Protection path | Rev C setting | Implementation / test
Circuit breaker OCP | 75 A | R(ILIM) = 32 kΩ, 1%; RSET = 50 Ω, within the 50–100 Ω datasheet range
Fast SCP | 20 mV default = 80 A with 0.25 mΩ | No RISCP resistor fitted; validate threshold and fault energy on the power-entry coupon
Breaker delay | TMR ≈68 nF for ≈1 ms starting point | Tune against output bulk-capacitance inrush at schematic review
Fault response | FLT to S32K344; SLEEP OCP auto-retry | FLT supplies pre-trip warning; auto-retry lets the input breaker recover after a cleared fault without intervention from a parked, sleeping MCU
IMON | Not populated | Leave the optional ±2% analog current-monitor pin floating per datasheet while INA228 is fitted

WHY LM74910H-Q1 REPLACES LM74800-Q1

One resistor now serves both protection and precise measurement, cutting shunt heat in half at 60 A. More importantly, the prior LM74800 architecture had no input-rail overcurrent protection; LM74910H adds a programmable breaker, fast short-circuit trip, separate UVLO, FLT warning, and SLEEP-mode OCP auto-retry.

REJECTED ALTERNATIVE — LM74900-Q1

LM74900-Q1 saves about $1 at 1,000 pieces but latches off after SLEEP-mode overcurrent instead of auto-retrying. That is the wrong trade for a battery-parked node whose MCU may be asleep when the fault occurs.

#### Current-monitor alternatives not carried forward

- INA186-Q1: 40 V common-mode ceiling leaves no margin for clamped load-dump transients; no authorized stock observed.
- ST TSC2011: automotive grade, exact part number, and pricing were not verified.
- Microchip PAC1932/34: no AEC-Q100 qualification.

### Power domains

### VDDAU_AON

A nanopower LDO supplies only LAN8670 VDDAU while parked. Target LDO quiescent current is about 1–2 µA; exact automotive part remains a schematic-selection item.

### 3V3_MAIN

S32K344 I/O/analog, LAN8670 VDDA/VDDP, switch VDD, SPI NOR, and clock. The first LMQ66430 is enabled directly by PHY INH.

### 1V5_CORE

S32K344 VDD_LV via the second LMQ66430-Q1. EN-pin chaining establishes the order and allows at least 250 mA transient margin.

### VBAT_PROT

VOUT after Q2 feeds the always-on LDO, both bucks, and all three TPS2HCS08A-Q1 devices so shared RSENSE sees the complete downstream current.

POWER-SEQUENCING HOLD POINT

On bus wake, LAN8670 drives INH high and the external supplies must ramp within 1 ms. Verify EN-chain delay, regulator soft-start, MCU reset release, PHY-ready IRQ_N, and whole-board inrush together. VDDA must never exceed VDDAU by more than 0.5 V; the always-on-first topology satisfies that rule by construction.

### FS26 removed from Rev C

The first version stays discrete. FS26’s original roles are now covered by the two LMQ66430 bucks, the S32K344 internal windowed SWT, the TPS3702 rail supervisor, and the LAN8670 INH gatekeeper. Do not place FS26 in the Rev C schematic or BOM. Reconsider an SBC only in a later revision if wake or sequencing requirements outgrow direct INH gating and EN-pin chaining.

04

## Compute, clock & reset

The 257-ball S32K344 owns commands, telemetry, diagnostics, network policy, event logging, and power-state transitions.

Interface | Allocation | Design note
RMII + MDIO | LAN8670D0-E/LMXVAO | 50 MHz reference; MDC/MDIO management; IRQ_N interrupt
LPSPI #1 | Three-device TPS2HCS08A daisy chain | Shared CSN/SCLK; cascaded SDI/SDO; CRC enabled
LPSPI #2 | IS25LP032D-JNLA3 diagnostic flash | Standard SPI mode 0 or 3; dedicated chip select; switched 3.3 V rail
ADC | 3 × shared SNS + VBAT_RAW + 4 × NTC | Eight ADC inputs baseline; INA228 current and TMP175 temperature need no MCU ADC channels
LPI2C | INA228A-Q1 total-rail monitor + TMP175-Q1 temperature sensor | Shared bus with distinct addresses; standard or fast mode is sufficient
GPIO | 3 × output FLT/WAKE, LM74910H FLT, LHI, optional TMP175 ALERT | Defined reset state; PHY INH drives regulator EN directly rather than passing through the MCU
Debug | SWD/JTAG + UART pads | Internal service access only; no unsealed external connector

PACKAGE-MAP GATE

RMII signal names carry over from the proven S32K344 implementation, but the exact ball mapping must be checked for S32K344EHT1MMMST during schematic capture.

05

## Watchdog & power-rail supervision

Use the MCU’s hardened internal window watchdog for software failure detection, and add an independent tight-window supervisor for the 3.3 V MCU/PHY rail.

### POR watchdog · S32K344 SWT

Use the internal Software Watchdog Timer. It is window-capable, enabled by default out of reset, and can be hard-locked so runaway code cannot disable or reconfigure it.

Zephyr: nxp,s32-swt · upstream driver

### POR rail supervisor · TPS3702-Q1

Add one automotive window supervisor on 3V3_MAIN. Its independent overvoltage and undervoltage detection drives RESET_b.

±0.9% threshold · −40…+125 °C · SOT-6

### Watchdog decision

The S32K344 SWT is the plan-of-record watchdog; no external watchdog is fitted. Configure a legal service window, verify reset action, hard-lock its configuration after startup checks, and test early, late, missing, and malformed service sequences. The S32K3 Clock Monitoring Unit already converts monitored clock failure into reset, closing the other major gap an ordinary external watchdog would address. The upstream Zephyr nxp,s32-swt driver avoids custom driver work.

NO EXTERNAL WATCHDOG IN REV C

An external watchdog duplicates the internal windowed SWT without improving rail-fault coverage because it dies with the same supply. If a later revision must support an ASIL safety case, evaluate TPS3430WQDRCRQ1: windowed, AEC-Q100 Grade 1, and observed in stock. It is a future safety-case option, not part of the current BOM. Do not use a TPS3823-Q1-class supervisor/watchdog combination: its non-windowed watchdog is a functional downgrade from the internal SWT.

### 3.3 V independent window supervision

Add 1 × TPS3702-Q1 to supervise the 3.3 V MCU/PHY rail. The device provides separate overvoltage and undervoltage detection with ±0.9% threshold accuracy over −40…+125 °C and is AEC-Q100 Grade 1 in SOT-6. Its reset output drives RESET_b. Budget about $1; confirm the exact fixed-threshold 3.3 V orderable code, pricing, and authorized stock at BOM lock.

WHY A SUPERVISOR, NOT ANOTHER WATCHDOG

Cold-crank droops and load-dump disturbances can move 3V3_MAIN outside the MCU/PHY operating window. A tight, MCU-independent OV/UV detector catches those conditions before software becomes unreliable; no watchdog can detect a rail fault after its own supply has collapsed. Do not add a separate 1.5 V supervisor: the S32K344 internal low-voltage detector already monitors the core domain.

### Supervision release gates

Brownout injectionSweep and pulse 3V3_MAIN through its undervoltage window under idle, network traffic, and output-switch activityBLOCKS RESET CLAIM

RESET_b timingScope supervisor assertion and release against rail slew, MCU reset requirements, clock startup, and regulator power-goodBLOCKS NETLIST

Threshold spot-checkMeasure overvoltage and undervoltage trip/release points across temperature on representative assembliesBLOCKS SUPERVISOR RELEASE

SWT / CMU fault injectionProve early, late, missing, and invalid watchdog service plus monitored-clock failure all produce the intended reset and event logBLOCKS SOFTWARE RELEASE

06

## 10BASE-T1S subsystem

LAN8670D0 connects over RMII/MDIO and operates as a commissioned PLCA follower on the multidrop segment.

### PHY and line interface

Circuit | Selection | Implementation
Reference clock | ECS-3225SMVQ-500-DS-TR | 50 MHz HCMOS, ±20 ppm; oscillator enable controlled with main power
Line coupling | 2 × 100 nF series capacitors | Automotive C0G/film-equivalent behavior with voltage and DC-bias margin
Termination | Switchable 100 Ω across TRXP/TRXN | Populate or enable only at a physical segment endpoint
Protection | Low-capacitance automotive ESD pair | Select exact code after return-loss and ESD co-design

### Identity and PLCA

Firmware stores a unique locally administered MAC address and commissioned PLCA node ID in protected flash. Node ID must be unique and is not hard-coded identically across production units. Coordinator mode is disabled by default.

### TC10 bus-wake and complete shutdown

The parked node is not an MCU standby system. It is powered down except for the LAN8670 always-on domain, so the missing S32K3 Zephyr standby implementation is no longer on the critical path. The controller ECU—powered from battery and switched ignition—owns the only wake source and sends the T1S wake-up pattern over the same pair used for data.

40 µA typLAN8670 VDDAU sleep current

56 µA maxLAN8670 VDDAU sleep current

≈50 µAcomplete node parked, typical

≈65 µAcomplete node parked, maximum

Phase | Defined sequence | Contract / evidence
Parked | Battery → LM74910H-Q1 in SLEEP (6 µA, ideal diode active) → nanopower LDO → LAN8670 VDDAU only. VDDA, VDDP, MCU, flash, bucks, and all outputs are off. | LDO Iq target ≈1–2 µA remains to be verified at part selection. LAN8670 sleep current is 40 µA typical / 56 µA maximum.
Wake | Controller sends T1S wake-up tone → PHY detects it → INH high → bucks ramp → S32K344 cold boot → PHY re-initialization → link up → outputs become commandable. | External supplies must ramp within 1 ms. PHY registers are lost while VDDA/VDDP are down; IRQ_N indicates readiness for configuration. A roughly 1 s application-ready latency is acceptable.
Shutdown | Controller sends application-level “go to sleep” message → firmware turns all six outputs off → flushes pending log entries → commands PHY sleep → INH releases after tSLPINHDLY → power tree collapses. | Write-before-sleep ordering is mandatory. Bus-idle timeout is rejected as the sleep source.

FOUR-WIRE SYSTEM DEPENDENCY

The T1S pair is the only wake path. The node cannot wake itself and has no KL15 input; if the controller ECU does not emit the wake pattern, the node stays off. This is a controller-interface requirement, not a recoverable local condition.

WAKE INRUSH & EXACT-TARGET VALIDATION

INH powers the complete switched tree at once. Size the LM74910H TMR breaker ride-through for regulator, bulk-capacitance, MCU, PHY, and output-stage startup inrush. Validate TC10 sleep/wake, INH timing, cold boot, lost-register PHY re-initialization, IRQ_N ready behavior, PLCA restoration, and application readiness on the exact S32K344EHT1MMMST target.

07

## Three dual-channel smart eFuses

Three TPS2HCS08A-Q1 devices provide six SPI-controlled outputs, shared analog SNS telemetry, diagnostics, and programmable I²t wire protection.

8.9 mΩRON typical at 25 °C

17.8 mΩRON typical at 150 °C

8 A/chboth channels on at 85 °C

13 Aone channel only at 85 °C

Attribute | Verified value | Design consequence
Qualification | AEC-Q100 Grade 1 | −40 °C to +125 °C ambient qualification
Package | HTSSOP-16 PowerPAD, PWP | Exposed VBB pad; broad copper and via array required
Orderable part | TPS2HCS08AQPWPRQ1 | Production data; May 2025 datasheet
Channels | 2 per device | 3 packages for six outputs; paired thermal behavior

THE 13 A NUMBER NEEDS CONTEXT

The 13 A value is available only with one channel enabled. The all-channels-on line is 8 A per channel at 85 °C. If direct thermal proof fails, derate the output, improve thermal spreading, or move the higher-current revision forward.

### SPI control, diagnosis, and reset behavior

Use a simple daisy chain: shared SCLK and CSN, each SDO feeding the next SDI, and the final SDO returning to the MCU. Enable CRC, read back every protection register, and retain one FLT/WAKE line per device. All channels remain off after reset; LHI is hardware-held inactive.

Function | Implementation | Failure behavior
Output command | SPI CHx control bits | All channels commanded off after reset
Fault summary | 3 × FLT/WAKE to MCU | Interrupt identifies the affected dual device
Detailed diagnosis | SPI status and ADC registers | Log channel, raw reading, mode, and timestamp
SPI integrity | Daisy chain with CRC | Fault on CRC, timeout, or readback mismatch

### SNS path and 100 mA resolution

Each device’s shared SNS output feeds one MCU ADC channel through a 698 Ω resistor and a low-leakage filter. SPI selects the observed output. The selection state is stored with every sample. No per-output shunt or external monitor is fitted; the shared 0.25 mΩ LM74910H RSENSE and INA228A-Q1 independently monitor the total input rail.

Quantity | Calculation | Result
MCU ADC LSB | 3.3 V / 4096 | 0.806 mV
100 mA, KSNS1 | 0.1 A / 5,000 × 698 Ω | 13.96 mV · 17.3 counts
10 A, KSNS1 | 10 A / 5,000 × 698 Ω | 1.396 V · 1,732 counts
100 mA, KSNS2 | 0.1 A / 1,400 × 698 Ω | 49.86 mV · 61.9 counts

RESOLUTION, NOT ABSOLUTE ACCURACY

The nominal count separation supports a 100 mA resolution claim after filtering and calibration. It does not imply ±100 mA absolute accuracy. Baseline KSNS1 ratio error is ±18% at 100 mA, improving to ±5% at 1 A and ±4% at 10 A.

### Accuracy by mode

Load current | KSNS1 error | KSNS2 error
10 A | ±4% | Not applicable
1 A | ±5% | Not applicable
500 mA | ±7% | Transition region
250 mA | ±10% | ±10%
100 mA | ±18% | ±10%
25 mA | Not specified | ±20%

I²t AND LOW-CURRENT MODE INTERACT

KSNS2 improves low-current ratio accuracy, but TI recommends using KSNS2 and 8× ADC scaling only with I²t disabled; altered scaling can lower the effective I²t trip threshold. Rev C keeps KSNS1 while I²t is active and budgets ±18% at 100 mA.

### I²t protection profile

- Program nominal current, I²t trip, fixed-delay overcurrent, immediate shutdown, cooldown, and retry from a harness-specific profile.
- Enable I²t only after register readback and verified current-sense operation.
- Keep immediate shutdown active for hard shorts; I²t handles sustained overload energy.
- Unlimited automatic retry is prohibited. Retain source and branch fusing wherever the switch cannot protect upstream conductors.
- Log accumulation, trip source, retries, raw current, supply, and temperature.

### Conduction and thermal budget

At 10 A, 8.9 mΩ produces 0.89 W per channel at 25 °C; 17.8 mΩ hot typical produces 1.78 W. Six outputs therefore dissipate approximately 5.34 W cold or 10.68 W hot, before connector, copper, regulator, and switching losses.

08

## Temperature sensing & hotspot coverage

Five added sensors close the input-stage and overload blind spots: one digital sensor at the ideal-diode FET bank and four local thermistors at shared RSENSE and the smart-switch packages.

5added temperature sensors

±2 °CTMP175-Q1 maximum error

4 × NTCRSENSE plus three switch packages

≈$1.50–2.50total added BOM estimate

### Plan-of-record sensor placement

Sensor / quantity | Placement and interface | Accuracy and role
1 × TMP175-Q1 | Place adjacent to the LM74910H-controlled DGATE/HGATE NFET bank on the 60 A path. Share the INA228 I²C/SMBus bus; use a distinct address. Optionally route ALERT to the S32K344 as a hardware overtemperature interrupt. | ±1 °C typical / ±2 °C maximum from −40…+125 °C; 12-bit, 0.0625 °C resolution. Measures the NFET-bank neighborhood and doubles as the power-input board-ambient reference.
1 × 10 kΩ NTC | AEC-Q200, 0603, ±1% R25 / ±1% B; place tight to the 0.25 mΩ shared-RSENSE body. Read through a resistor divider on a dedicated S32K344 ADC channel. | About ±0.5–1 °C mid-range and about ±1.5 °C at +125 °C after lookup-table or Steinhart–Hart linearization. These are tolerance-derived planning estimates, not guaranteed datasheet maxima.
3 × 10 kΩ NTC | One AEC-Q200 0603 thermistor beside each TPS2HCS08A-Q1 package; each gets its own resistor divider and S32K344 ADC channel. | Same tolerance-derived estimate as the shunt NTC. Preserves package-temperature visibility when switch FET telemetry is unavailable during an I²t event.

DIGITAL SENSOR BASELINE

TMP175-Q1 remains the plan-of-record choice. It is AEC-Q100 Grade 1 with a 2.7–5.5 V supply, SOIC-8 or VSSOP-8 package, I²C/SMBus interface, and up to 27 devices per bus. It adds no address conflict to the INA228 bus. Budget approximately $0.60–1.00 at 1,000 pieces and verify at BOM lock.

HIGHER-ACCURACY ALTERNATIVE — NOT SELECTED

TI TMP126-Q1 was the only verified higher-accuracy option: ±0.4 °C maximum, AEC-Q100 Grade 0, approximately $1.80 at 1,000 pieces, and observed in DigiKey stock. It is SPI-only, so its 3-wire interface needs a chip-select and LPSPI allocation and cannot share the INA228 I²C bus. The added interface cost and complexity outweigh the accuracy gain for the NFET-bank ambient role.

### What the existing ICs can—and cannot—tell us

Existing telemetry | Accuracy / behavior | Coverage decision
TPS2HCS08A-Q1 FET temperature | 10-bit per-channel reading, ±17 °C maximum. Measurement is disabled on all channels whenever any channel enters the I²t loop; warning bits and thermal shutdown remain active. | Do not use it as the only package-temperature evidence during faults. Fit one NTC per dual-channel package.
INA228A-Q1 die temperature | ±2 °C maximum, but it measures the monitor IC die rather than the high-dissipation shunt body. | Retain for monitor health; fit the shunt NTC for shunt temperature.
S32K344 internal TempSense | ±10 °C maximum. | Use only for MCU die-health checks, not hotspot derating.
LM74910H-Q1 / external NFETs | The adopted interface provides current/fault protection but no NFET temperature measurement. | The external FET bank remains the primary thermal blind spot; TMP175-Q1 closes it.
LMQ66430-Q1 / LAN8670 | Buck converters provide thermal shutdown only; LAN8670 provides a binary overtemperature indication based on characterization data. | Treat these as protection/fault indications, not hotspot measurements.

I²t TELEMETRY BLACKOUT

Firmware must never trust TPS2HCS08A-Q1 temperature registers during an I²t event. Record the blackout state with every temperature sample, use the three package NTCs for fault-time thermal decisions, and continue honoring the switch warning and shutdown bits.

### Firmware and calibration contract

- Apply per-sensor alert thresholds, debouncing, plausibility checks, and derating-policy hooks for the NFET bank, shared RSENSE, and three switch packages.
- Log raw and converted temperature, sensor identity, operating state, active I²t status, threshold crossings, derating actions, and shutdown events.
- Linearize each NTC with a component-specific lookup table or Steinhart–Hart coefficients; do not reuse generic coefficients at production release.
- Use TMP175 ALERT as an optional independent interrupt path while retaining periodic I²C polling and communication-fault detection.

### Temperature-sensing release gates

NTC layout reviewConfirm thermal coupling, copper isolation, divider tolerance, ADC range, and routing for shared RSENSE and all three switch-package sensorsBLOCKS PCB RELEASE

TMP175 interfaceVerify address straps, shared-bus operation with INA228, startup, readback, fault handling, and optional ALERT interruptBLOCKS FIRMWARE BASELINE

Accuracy spot-checkCompare all five added sensors against a calibrated reference at ambient, hot operating, and +125 °C pointsBLOCKS DERATING CLAIM

Threshold testsInject and heat-test warning, derating, logging, ALERT, and safe-state transitions, including the switch I²t telemetry blackoutBLOCKS THERMAL POLICY

09

## Connector & harness architecture

Each output gets a sealed, independently protected path; the aggregate input is treated as a 60 A interconnect problem.

Interface | Architecture | Release condition
Six outputs | MX150 sealed; 10 A each; 14 AWG minimum | Validate contact, wire, cavity loading, and derating at +125 °C
Battery input | Metri-Pack 480/630 class or dual feed | Prove complete 60 A path; use multiple contacts or feeds
Power return | Matched high-current return | No chassis-only return assumption
10BASE-T1S | Separate sealed two-way twisted pair | Vehicle-level protection and termination strategy
Complete node cable | Exactly four conductors: T1S twisted pair + battery-direct power + ground | No KL15, ignition, or local hardwire wake input; controller ECU must provide T1S wake

### Fusing

Place the primary fuse at the battery/source end. If the 60 A path is split, fuse each feed and prevent back-powering through an undersized path. Final values coordinate wire ampacity, contact derating, load inrush, PCB fault energy, and the smart-switch curve. Use branch fuses wherever the main fuse cannot protect an output conductor or connector fault.

CONNECTOR FREEZE CONDITION

Connector families are architectural selections, not released mating sets. Freeze exact housings, terminals, seals, wire sizes, and keys together; validate temperature rise with all intended adjacent circuits loaded.

10

## Firmware architecture & data contract

Ownership is separated by service so network availability never weakens local protection.

Service | Responsibility | Failure behavior
Power-state manager | RUN, controller-commanded shutdown, cold boot; coordinate outputs, log flush, and PHY sleep | Never command PHY sleep until every output is off and the flash flush has completed
Output manager | Commands, interlocks, retries, aggregate-current budget | Hardware-off on reset; bounded retries; latch critical faults
Telemetry acquisition | Select SNS, sample ADC, average, calibrate, timestamp | Attach mode validity; never mislabel muxed data
T1S service | RMII/MDIO, link, PLCA, filtering, wake reason | Loss of link does not disable local protection
Supervision service | Windowed SWT service, reset-cause capture, CMU and TPS3702 fault reporting | Hard-locked watchdog; no service until startup checks pass; retain last reset cause
Diagnostics & NVM | FCB fault/event log; NVS energy and wake/sleep counters; calibration and identity | Ahead-erase during run; CRC/version every record; bounded pre-sleep page flush

### Recommended status frame

Node identity, uptime, VBAT_RAW voltage, INA228 digital protected-rail voltage, total current, and power, TMP175 NFET-bank temperature, RSENSE NTC temperature, three switch-package NTC temperatures, LM74910H FLT state, temperature-validity and I²t-blackout flags, six command states, six measured currents, six measured output voltages, reset cause, supervisor status, channel fault bitmap, link/PLCA state, wake reason, and monotonic sequence counter. Command frames include target node, channel mask, desired state, optional timeout, sequence counter, and an application-layer integrity check.

### Diagnostic flash log

Fit IS25LP032D-JNLA3, a 32 Mbit AEC-Q100 Grade 1 SPI NOR, on switched 3V3_MAIN. The capacity holds 65,536 fixed 64-byte records—about 1.8 years before wrap at 100 events per day. Although 16 Mbit is sufficient, 32 Mbit is the commodity availability sweet spot.

Property | Rev C implementation | Design consequence
Geometry / endurance | 4 KB uniform sectors; 256-byte pages; 100,000 program/erase cycles minimum | Zephyr FCB circular buffer for timestamped events; NVS for energy and wake/sleep counters
Write timing | 0.8 ms maximum page program; up to 10 pages = ≤8 ms worst-case pre-sleep flush | Controller-commanded shutdown provides the flush window before PHY sleep
Erase timing | 300 ms maximum sector erase; suspend/resume supported | Ahead-erase during normal operation; never begin sector erase at sleep entry
Contents | Channel trip plus current, voltage, and temperature; OCP, thermal, UV/OV; wake/sleep counts; energy counters | Log readback is exposed through the T1S application interface

FLASH SOURCING & SUBSTITUTION

Observed on 2026-10-13: $1.74 at one / $1.40 at 1,000, about 2,588 at DigiKey and 65 at Mouser. DigiKey showed constrained supply—no backorders and 2,000 units per 30 days—and an aggregator showed a 50-week factory lead. Reconfirm at BOM lock. Winbond W25Q32JVSSSQ is the Grade 1 second-source candidate; verify its price and stock. Do not substitute W25Q32JVSSIG, MX25L12833F, ISSI non-A3 grades, Micron -0SIT standard versions, or GD25Q128C.

### Operating states

### RUN

All rails, MCU, full PHY, flash, oscillator, and diagnostics active. Outputs remain off until firmware validates configuration and receives commands.

ENTRY: T1S wake → cold boot → PHY re-init

### PARKED / TC10 SLEEP

Only LM74910H SLEEP, the nanopower LDO, and LAN8670 VDDAU remain powered. No logging occurs while parked.

WAKE: controller ECU over T1S only

DEFINED SHUTDOWN TRANSACTION

The controller sends an application-level “go to sleep” message. The node then turns off all six outputs, flushes pending records, waits for page-program completion, commands LAN8670 sleep, and allows INH to collapse the rails. Bus-idle timeout is not used.

11

## Safety, EMC & thermal architecture

This is not a functional-safety certification claim; deterministic safe states and diagnostic coverage are foundations for later hazard analysis.

- SPI and LHI reset states leave every output off until the MCU verifies configuration and communication integrity.
- Parked state leaves only LAN8670 VDDAU alive; there is no local ignition or hardwire wake path. The controller ECU must issue the T1S wake pattern.
- Controller-commanded shutdown is transactional: outputs off, diagnostic-log flush complete, then PHY sleep and INH release.
- LM74910H-Q1 provides an independent 75 A circuit breaker, default 80 A fast short-circuit trip, FLT pre-trip warning, and SLEEP-mode OCP auto-retry on the 60 A input rail.
- Hard-lock and window the S32K344 SWT; use the Clock Monitoring Unit for clock-failure reset and TPS3702-Q1 for independent 3V3_MAIN overvoltage/undervoltage supervision through RESET_b.
- Separate high di/dt loops from SNS/ADC return, oscillator, RMII, and T1S coupling.
- Start with 2 oz copper and dense thermal vias at every exposed pad; calculate every 10 A path.
- Budget 5.34 W cold or 10.68 W hot for six full-load channels before other losses.
- Run ISO 7637-2 / ISO 16750 supply-transient tests and appropriate CISPR 25 conducted/radiated emissions.
- Validate inductive turn-off energy and every I²t profile against switch, load, harness, and connector.

12

## Preliminary component baseline

Prices and stock are dated procurement observations through 2026-10-13, not live quotations.

Qty / part | Function | Observed price / supply | Decision note
1 × S32K344EHT1MMMST | Grade 1 MCU, 257 MAPBGA | $23.17 @1; 760 DigiKey | Locked; verify exact ball map
1 × LAN8670D0-E/LMXVAO | Automotive 10BASE-T1S PHY | $2.80 tray class; 0 stock; 11–20 week leads | Locked; highest procurement risk
2 × LMQ66430QMC5RXBRQ1 | INH-gated 3.3 V and 1.5 V low-Iq bucks | Not verified | Selected discrete power tree. Direct INH enable plus EN-pin chaining; no FS26
1 × nanopower automotive LDO | Always-on LAN8670 VDDAU supply | Exact part and price open | Target ≈1–2 µA Iq; must meet transient and VDDAU requirements
1 × LM74910HQRGERQ1 | Grade 1 ideal-diode / reverse-battery / OCP / SCP controller; VQFN-24, 4 × 4 mm | $5.65 @1 / $3.26 @1k; 773 DigiKey; 26-week manufacturer lead if depleted | Plan of record. 75 A breaker, 80 A fast trip, SLEEP auto-retry, FLT to MCU
1 × 0.25 mΩ RSENSE | Shared LM74910H protection and INA228 total-current sense | ≈$1 @1k planning allowance; exact 1%, AEC-Q200 code open | Star Kelvin taps; 15 mV / 0.9 W at 60 A
1 × OCP timing/set network | R(ILIM) 32 kΩ 1%, RSET 50 Ω, TMR ≈68 nF | Minor passives; confirm at BOM lock | 75 A breaker; ≈1 ms starting delay; tune against inrush
1 × INA228AQDGSRQ1 | 20-bit I²C total-current, power, and protected-rail monitor | $5.43 @1 / ≈$3.20 @1k; 32,413 DigiKey | Plan of record. SHUNT_CAL for 0.25 mΩ; monitor + shared RSENSE ≈$4.20 @1k
ALT · INA281A2QDBVRQ1 | Grade 1, gain-50 analog total-current monitor | $3.21 @1 / ≈$1.80 @1k; 8,138 DigiKey | Budget fallback; ≈0.6 A offset-equivalent at the shunt
1 × TMP175-Q1 | Grade 1 digital NFET-bank / board-ambient temperature sensor | ≈$0.60–1.00 @1k estimate; verify at BOM lock | Plan of record. Shares INA228 I²C bus; optional ALERT to MCU
4 × 10 kΩ NTC, AEC-Q200 | Shared-RSENSE and 3 × switch-package temperature sensing | ≈$0.15–0.35 each @1k estimate | 0603, ±1% R25 / ±1% B; exact −55…+150 °C code at BOM lock
1 × TPS3702-Q1 | Independent 3V3_MAIN OV/UV window supervisor to RESET_b | ≈$1 planning estimate | Plan of record. Confirm exact 3.3 V variant, price, and stock at BOM lock
1 × IS25LP032D-JNLA3 | 32 Mbit Grade 1 SPI NOR diagnostic log; SOIC-8 150 mil | $1.74 @1 / $1.40 @1k; ≈2,588 DigiKey / 65 Mouser observed 2026-10-13 | Plan of record. Switched 3.3 V; PPAP available; constrained-supply flag—recheck at BOM lock
ALT · W25Q32JVSSSQ | Automotive Grade 1 32 Mbit SPI NOR second source | Verify at BOM lock | Candidate only; hardware/software interchangeability review required
FUTURE · TPS3430WQDRCRQ1 | External window watchdog for a later ASIL safety case | Observed in stock; price not carried into Rev C | Not fitted; internal S32K344 SWT is plan of record
1 × XLD8A24CA | 24 V, 7 kW AEC-Q101 TVS | Not verified | Primary load-dump choice
3 × TPS2HCS08AQPWPRQ1 | Dual smart eFuse, Grade 1 | $1.952 @1k; $5.86 total; no observed stock | Selected; 20-week standard lead observed
1 × ECS-3225SMVQ-500-DS-TR | 50 MHz ±20 ppm oscillator | $1.82 @1; 421 observed | Selected
6 × MX150-class sets | Sealed 18 A-class output connectors | Not verified | Exact mating sets open

BOM DELTA — PROTECTION, SHUTDOWN & LOGGING

Remove LM74800QDRRRQ1, the standalone 0.5 mΩ shunt, and the Rev A FS26 SBC. Add LM74910HQRGERQ1 with shared 0.25 mΩ RSENSE, a nanopower VDDAU LDO, and IS25LP032D-JNLA3 diagnostic flash. LM74910H adds about $1.70 at 1,000 pieces versus the prior controller/shunt pair; flash adds $1.40 at the recorded 1,000-piece price. The discrete power tree avoids an SBC whose remaining functions are already covered elsewhere.

LIFECYCLE & SOURCING

Re-check every quote at purchase. LAN8670D0-E/LMXVAO and TPS2HCS08AQPWPRQ1 gate prototype timing. LM74910HQRGERQ1 had 773 units at DigiKey on 2026-10-13 and carries a 26-week manufacturer lead if depleted. IS25LP032D-JNLA3 had authorized stock but a constrained-supply notice; confirm availability before BOM lock. TPS481HS04-Q1 remains a future higher-current revision only after production release.

13

## Schematic-capture interfaces

The page split and net rules expose every decision that still needs evidence.

Sheet | Contents | Must expose
A · Power entry | Fuse, TVS, LM74910H-Q1, DGATE/HGATE MOSFETs, shared 0.25 mΩ RSENSE, EMI, SW-pin OV/UV monitor divider, INA228A-Q1, TMP175-Q1, RSENSE NTC | VBAT_RAW, BATT_MON, VOUT/VBAT_PROT, RSENSE± star taps, INA228_IN+/IN−, FLT, shared I2C, TMP175 ALERT, NTC_RSENSE, reverse/OV/OCP/SCP faults
B · Regulators | Nanopower VDDAU LDO, 2 × LMQ66430, direct INH gating, EN-pin chaining, TPS3702-Q1 | VDDAU_AON, INH, 3V3_MAIN, 1V5_CORE, startup timing, RESET_b supervisor path; no FS26 or wake latch
C · MCU / NVM | S32K344, IS25LP032D SPI NOR, reset, SWT/CMU, debug, ADC, dual LPSPI, LPI2C | RMII, MDIO, 3 SNS, BATT_MON ADC, 4 NTC ADCs, INA228/TMP175 I2C, flash SPI/CS, output-switch SPI chain, faults
D · T1S | LAN8670, VDDAU/VDDA/VDDP domain split, clock, straps, coupling, ESD | TRXP/N, direct INH-to-buck-EN path, IRQ_N, PHYAD; no local wake input
E–G · Outputs | One dual-channel switch block and one package NTC per sheet | SPI, SNS, LHI, FLT/WAKE, NTC ADC net, two outputs, thermal pad
K · Connectors | Outputs, high-current input, T1S pair | Pin/net table, wire gauge, fusing, no hidden joins

### Net-level rules

- Name all six outputs and all three SNS nets; document every SPI diagnostic-mux mapping.
- Route LAN8670 INH directly to the first LMQ66430 EN and chain regulator EN pins for rail order. Do not add FS26, a wake latch, or an MCU-controlled gate in this path.
- Keep VDDAU on the nanopower always-on LDO and put LAN8670 VDDA/VDDP, MCU, flash, and all remaining logic on switched rails. Enforce VDDA ≤ VDDAU + 0.5 V through all transients.
- Place IS25LP032D-JNLA3 on switched 3V3_MAIN with dedicated chip select, decoupling, and accessible SPI test pads.
- Label the SW-divider ADC net BATT_MON and its reported quantity VBAT_RAW; ensure its ADC tap does not add material parked current, and set cold-crank behavior with the separate UVLO pin.
- Place the shared 0.25 mΩ RSENSE between the DGATE and HGATE FET stages. Route separate star Kelvin pairs from the resistor pads to LM74910H and INA228A-Q1, expose both nodes as test points, and couple NTC_RSENSE tightly to the resistor body.
- Route every buck/MCU and output branch from VOUT after the Q2 disconnect FET so shared RSENSE measures the complete downstream current.
- Fit R(ILIM) = 32 kΩ 1%, RSET = 50 Ω, and TMR ≈68 nF; route LM74910H FLT to the MCU and leave IMON floating when INA228 is populated.
- Name and route NTC_RSENSE plus NTC_SW1–NTC_SW3 to separate ADC channels; keep divider returns quiet and document each thermistor’s exact coefficients.
- Place TMP175-Q1 beside the ideal-diode NFET bank, share the INA228 I²C bus with a distinct address, and reserve ALERT routing to the MCU.
- Route TPS3702-Q1 directly from 3V3_MAIN to RESET_b; document threshold variant, reset timing, pull-up domain, and interaction with MCU POR/LVD.
- Annotate every 10 A net with copper weight, geometry, via array, connector contact, and 14 AWG minimum harness.
- Keep PHYAD hardware strapping separate from commissioned PLCA node identity.
- Add test points on all rails, INH, IRQ_N, MDC/MDIO, reference clock, SPI, and all SNS nets.
- Show reset states for CSN, LHI, FLT/WAKE, and the daisy chain.
- Mark every unverified sequence, package ball, and connector mate as release-blocking.

14

## Verification & release gates

The baseline is ready for schematic capture, not production release. These tests convert architectural assumptions into evidence.

### Bring-up sequence

1. Power-entry coupon: reverse battery, OV disconnect, TVS clamp, cold crank, hot plug, parked leakage, the recalculated 0.6 V OV/UV thresholds, and BATT_MON wake-state accuracy without compromising the parked-current budget.
2. Input protection: prove the 75 A OCP breaker threshold, default 80 A fast SCP trip, FLT pre-trip signaling, TMR ride-through versus inrush, and SLEEP-mode auto-retry behavior.
3. Shared-RSENSE path: verify separate star Kelvin routing, INA228A-Q1 I²C communication, SHUNT_CAL for 0.25 mΩ, RSENSE temperature at 60 A continuous, 0–60 A accuracy across temperature, and total-vs-sum cross-check. Confirm buck/MCU rails originate at VOUT after Q2.
4. Temperature network: verify shared-bus TMP175 communication and optional ALERT, inspect all four NTC placements, spot-check conversion accuracy against a calibrated reference, and test derating/logging thresholds including the TPS2HCS08 I²t telemetry blackout.
5. Reset supervision: inject 3V3_MAIN undervoltage and overvoltage events, scope TPS3702-to-RESET_b timing, spot-check thresholds across temperature, and fault-inject SWT and CMU reset paths.
6. Bus-wake power cycle: measure parked current, T1S wake detection, INH assertion, sub-1 ms rail ramp, EN-chain order, whole-board inrush, cold boot, IRQ_N ready, PHY re-initialization, PLCA restore, and application readiness within the accepted ≈1 s budget.
7. Commanded shutdown: inject the controller’s application-level go-to-sleep message; prove all outputs turn off, pending pages finish programming, PHY sleep is commanded only afterward, INH releases after tSLPINHDLY, and no bus-idle timeout can trigger shutdown.
8. Flash endurance and recovery: worst-case ten-page pre-sleep flush, ahead-erase, FCB wrap, erase suspend/resume, CRC recovery after interrupted power, log readback over T1S, and NVS counter persistence.
9. Regulator board: startup, shutdown, load transient, current limit, EN-pin sequencing, and thermal margin across temperature.
10. MCU-only: package map, clocks, reset, SWD, ADC reference, both LPSPI instances, and Zephyr baseline.
11. One-switch fixture: daisy-chain framing and CRC, reset-off, SNS mux, FLT/WAKE, output control, and register readback.
12. Current sweep: all channels 0–10 A; every 100 mA point from 0–1 A; noise, settling, monotonicity, error, supply, and temperature.
13. I²t fixture: correlate each protection setting against current, temperature, supply, wire, connector, inrush, and short impedance.
14. Dual-channel thermal: both channels at 10 A at worst ambient in the sealed enclosure—release-blocking qualification.
15. Six-channel assembly: 60 A matrix, fuse coordination, harness faults, ground offsets, switching during network traffic, EMC, and enclosure thermal.

### Freeze gates

Dual-channel currentBoth channels at 10 A across ambient, supply, enclosure, and agingBLOCKS 10 A RATING

Input protection75 A OCP breaker threshold; 80 A fast SCP trip; FLT pre-trip warning; TMR ride-through versus inrush; SLEEP-mode auto-retryBLOCKS 60 A INPUT

Input telemetry0.6 V-threshold BATT_MON divider verification; INA228 I²C; SHUNT_CAL for 0.25 mΩ; shared-RSENSE thermal; 0–60 A accuracy; total-vs-sum cross-checkBLOCKS INPUT TELEMETRY

Temperature networkTMP175 I²C/ALERT; four NTC placements; calibrated-reference spot-check; threshold, logging, and I²t-blackout testsBLOCKS THERMAL POLICY

Reset supervisionTPS3702 3.3 V variant; OV/UV threshold sweep; RESET_b timing; SWT and CMU fault injectionBLOCKS RESET RELEASE

SNS telemetry0–10 A sweeps; 100 mA separation; KSNS1 error and driftBLOCKS TELEMETRY

I²t correlationMeasured trip curves and cooling/retry behavior per harness/load classBLOCKS FUSE PROFILE

SPI robustnessCRC, reset, timeout, stuck bus, readback, and chain fault injectionBLOCKS CONTROL

Bus wake / inrushT1S-only wake, INH-to-EN timing, ≤1 ms supply ramp, LM74910H TMR ride-through, cold boot, IRQ_N ready, PHY/PLCA re-initializationBLOCKS NETLIST

Commanded shutdownController message, all outputs off, ≤8 ms pending-page flush, PHY sleep, tSLPINHDLY, and INH release; prove bus idle alone cannot sleep the nodeBLOCKS POWER POLICY

Diagnostic flashFCB wrap/ahead-erase, NVS counters, T1S readback, endurance policy, and content integrity across interrupted power cyclesBLOCKS LOGGING

Package mapS32K344EHT1MMMST package-specific pin auditBLOCKS SCHEMATIC

Zephyr targetBuild, link, PLCA, dual SPI, controller-commanded shutdown, cold-boot re-initialization, and wake logsBLOCKS SOFTWARE

Thermal / EMCSix-channel 60 A enclosure matrix and vehicle-standard resultsBLOCKS PRODUCTION

Supply chainAuthorized-source quote and lifecycle confirmationBLOCKS PURCHASE

SCHEMATIC BASELINE WITH A HARD THERMAL GATE

Rev C records the selected architecture and is suitable for schematic capture. It does not substantiate 10 A continuous on all six outputs. Production release requires thermal proof plus SNS accuracy, I²t correlation, SPI robustness, 60 A input, connector, sequencing, EMC, package-map, and exact-target Zephyr evidence.

15

## Source register

Manufacturer documents are the design authority. Distributor observations only expose price and lifecycle risk.

- S1Microchip LAN8670/1/2 data sheet (https://static6.arrow.com/aropdfconversion/2db1d7cc20951d63322c97a1ad89069b0f85a2e1/lan867012datasheet60001573.pdf)
- S2EVB-LAN8670-RMII User’s Guide (https://my.mouser.com/pdfDocs/EVB-LAN8670-RMII-Users-Guide-600017081.pdf)
- S3TI LM74910H-Q1 data sheet and product information · verified 2026-10-13
- S4TI TPS2HCS08-Q1 data sheet (https://www.ti.com/lit/gpn/TPS2HCS08-Q1)
- S4ATI TPS481HS04-Q1 Advance Information (https://www.ti.com/document-viewer/TPS481HS04-Q1/datasheet)
- S4BTI TPS481HS04-Q1 product page (https://www.ti.com/product/TPS481HS04-Q1)
- S5TI TPS7B83-Q1 data sheet (https://www.ti.com/lit/gpn/TPS7B83-Q1)
- S6NXP FS26 product data sheet (https://static6.arrow.com/aropdfconversion/5400c51d4e841bea3c13cbb954d1324e20b70865/ds616030-fs26%20product%20datasheet%203.0(3.0)%20(4).pdf)
- S7NXP example FS26 OTP report (https://www.nxp.com/docs/en/data-sheet/R_MFS2613AMDA3.pdf)
- S8ECS-3225SMVQ product page (https://www.mouser.com/new/ecs/ecs-ecs-3225smvq-multi-volt-hcmos-oscillators/)
- S9Molex MX150 sealed connector data sheet (https://www.avnet.com/wps/wcm/connect/onesite/fb3f3a4e-a2ae-45d4-8f1f-7a28bc4aa72c/mx150-sealed-connector-system-datasheet.pdf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)
- S10Aptiv Metri-Pack 630 specifications (https://www.mouser.ca/new/aptiv/aptiv-metri-pack-630-connectors/)
- S11Vishay load-dump TVS report (https://www.electronicsweekly.com/news/products/discretes/transient-suppressors-accurately-protect-24v-lines-2022-06/)
- S12TI INA281-Q1 data sheet · verified 2026-10-13
- S13TI INA228-Q1 data sheet · verified 2026-10-13
- S14TI TMP175-Q1 and TMP126-Q1 data sheets · verified 2026-10-13
- S15TI TPS3702-Q1 and TPS3430-Q1 data sheets · verified 2026-10-13
- S16NXP S32K3 watchdog, Clock Monitoring Unit, low-voltage detector, and TempSense documentation · verified 2026-10-13
- S17Zephyr nxp,s32-swt watchdog binding and driver · verified 2026-10-13
- S18TI LM74900-Q1 comparison data · verified 2026-10-13
- S19ISSI IS25LP032D-JNLA3 data sheet and distributor observations · verified 2026-10-13
- S20OPEN Alliance TC10 wake/sleep timing requirements · verified 2026-10-13
- Z1Upstream Zephyr S32 SoC tree (https://github.com/zephyrproject-rtos/zephyr/tree/main/soc/nxp/s32)
- Z2NXP downstream S32K3 tree (https://github.com/nxp-zephyr/nxp-zephyr/tree/nxp-v4.4-branch/soc/nxp/s32/s32k3)

DECISION SUMMARY

Three TPS2HCS08A-Q1 devices provide six cost-optimized outputs. LM74910H-Q1 and INA228A-Q1 Kelvin-share one 0.25 mΩ RSENSE for total-current telemetry and input protection. Rev C uses a discrete power tree: a nanopower LDO keeps only LAN8670 VDDAU alive at roughly 50 µA typical / 65 µA maximum parked draw, and PHY INH directly enables the LMQ66430 bucks. The controller ECU wakes the node over the T1S pair and explicitly commands shutdown; the node turns all outputs off, flushes its IS25LP032D-JNLA3 diagnostic log, then commands PHY sleep and powers down. FS26 is not fitted. TMP175-Q1 plus four NTCs provide hotspot coverage; the S32K344 SWT remains the watchdog, and TPS3702-Q1 independently supervises 3V3_MAIN. The 10 A target remains release-blocked by the 8 A-per-channel both-on rating at 85 °C.

Automotive 10BASE-T1S Power Distribution Node
10 A Variant · Architecture Rev C

Prepared 2026-10-13 · Procurement observations are dated snapshots

↑
