karlTbowers/node60-hw/placement/2026-11-12-passives/decisions/log.md

# Decision log: passive placement study (2026-11-12)

| Id | Asked | Question | Page | Answer |
|---|---|---|---|---|
| D32 | 2026-11-12 | Which passive moves and supply-copper changes should land on the board? Options A (01) to I (09), H (10). Recommended: I with H | https://claude.ai/artifact/JLN8hwiMkwVew3kSbyn1BE (source `D32-passive-moves.json`) | **I and H** (user, 2026-11-12). Landed the same day by `land_d32.sh` on branch `layout/d32-passive-moves` |
