karlTbowers/node60-hw/docs/src/content/docs/subsystems/enclosure/v14.mdx

---
title: "Version 14: version 11 with 3/16 x 3/4 in busbars"
description: Node60 enclosure version 14, generated from its connector placement.
---

import EnclosureVersion from '../../../../components/EnclosureVersion.astro';

<EnclosureVersion version="v14" />
