karlTbowers/node60-hw/docs/src/content/docs/subsystems/enclosure/v12.mdx

---
title: "Version 12: version 11 on a 1.6 mm board"
description: Node60 enclosure version 12, generated from its connector placement.
---

import EnclosureVersion from '../../../../components/EnclosureVersion.astro';

<EnclosureVersion version="v12" />
