karlTbowers/node60-hw/docs/src/content/docs/subsystems/enclosure/v13.mdx

---
title: "Version 13: version 11 with RADLOK receptacles"
description: Node60 enclosure version 13, generated from its connector placement.
---

import EnclosureVersion from '../../../../components/EnclosureVersion.astro';

<EnclosureVersion version="v13" />
