karlTbowers/node60-hw/docs/src/content/docs/subsystems/enclosure/v11.mdx

---
title: "Version 11: version 9 on a 2.0 mm board"
description: Node60 enclosure version 11, generated from its connector placement.
---

import EnclosureVersion from '../../../../components/EnclosureVersion.astro';

<EnclosureVersion version="v11" />
