karlTbowers/node60-hw/docs/src/content/docs/subsystems/enclosure/v9.mdx

---
title: "Version 9: version 7, compact"
description: Node60 enclosure version 9, generated from its connector placement.
---

import EnclosureVersion from '../../../../components/EnclosureVersion.astro';

<EnclosureVersion version="v9" />
