karlTbowers/node60-hw/docs/src/content/docs/subsystems/enclosure/v1.mdx

---
title: "Version 1: board flipped"
description: Node60 enclosure version 1, generated from its connector placement.
---

import EnclosureVersion from '../../../../components/EnclosureVersion.astro';

<EnclosureVersion version="v1" />
