karlTbowers/node60-hw/docs/src/content/docs/subsystems/enclosure/v2.mdx

---
title: "Version 2: busbars, raised T"
description: Node60 enclosure version 2, generated from its connector placement.
---

import EnclosureVersion from '../../../../components/EnclosureVersion.astro';

<EnclosureVersion version="v2" />
