karlTbowers/node60-hw/docs/src/content/docs/subsystems/enclosure/v3.mdx

---
title: "Version 3: busbars, raised front"
description: Node60 enclosure version 3, generated from its connector placement.
---

import EnclosureVersion from '../../../../components/EnclosureVersion.astro';

<EnclosureVersion version="v3" />
