karlTbowers/node60-hw/docs/src/content/docs/subsystems/enclosure/v4.mdx

---
title: "Version 4: press-fit, raised T"
description: Node60 enclosure version 4, generated from its connector placement.
---

import EnclosureVersion from '../../../../components/EnclosureVersion.astro';

<EnclosureVersion version="v4" />
