karlTbowers/node60-hw/docs/src/content/docs/subsystems/enclosure/v5.mdx

---
title: "Version 5: press-fit, raised front"
description: Node60 enclosure version 5, generated from its connector placement.
---

import EnclosureVersion from '../../../../components/EnclosureVersion.astro';

<EnclosureVersion version="v5" />
