karlTbowers/node60-hw/docs/src/content/docs/subsystems/enclosure/v6.mdx

---
title: "Version 6: outputs on three walls"
description: Node60 enclosure version 6, generated from its connector placement.
---

import EnclosureVersion from '../../../../components/EnclosureVersion.astro';

<EnclosureVersion version="v6" />
