karlTbowers/node60-hw/docs/src/content/docs/subsystems/enclosure/v7.mdx

---
title: "Version 7: busbars, front band and T1S hood"
description: Node60 enclosure version 7, generated from its connector placement.
---

import EnclosureVersion from '../../../../components/EnclosureVersion.astro';

<EnclosureVersion version="v7" />
