karlTbowers/node60-hw/docs/src/content/docs/subsystems/enclosure/v8.mdx

---
title: "Version 8: MCU board below, T1S lowered"
description: Node60 enclosure version 8, generated from its connector placement.
---

import EnclosureVersion from '../../../../components/EnclosureVersion.astro';

<EnclosureVersion version="v8" />
