karlTbowers/node60-hw/docs/src/assets/hero/node60-enclosure-lamps.webp

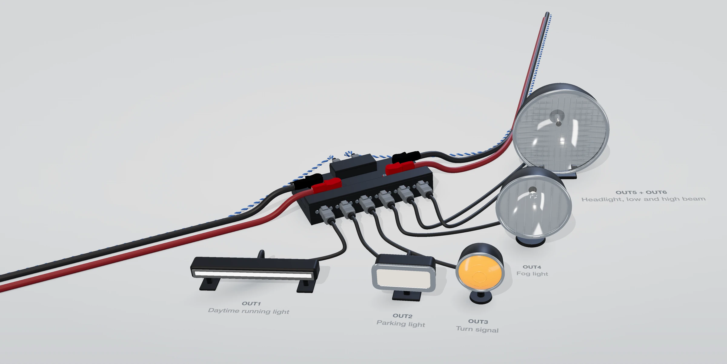
docs/src/assets/hero/node60-enclosure-lamps.webp
