karlTbowers/node60-hw/placement/2026-11-12-passives/img/00-main/board_in3.png

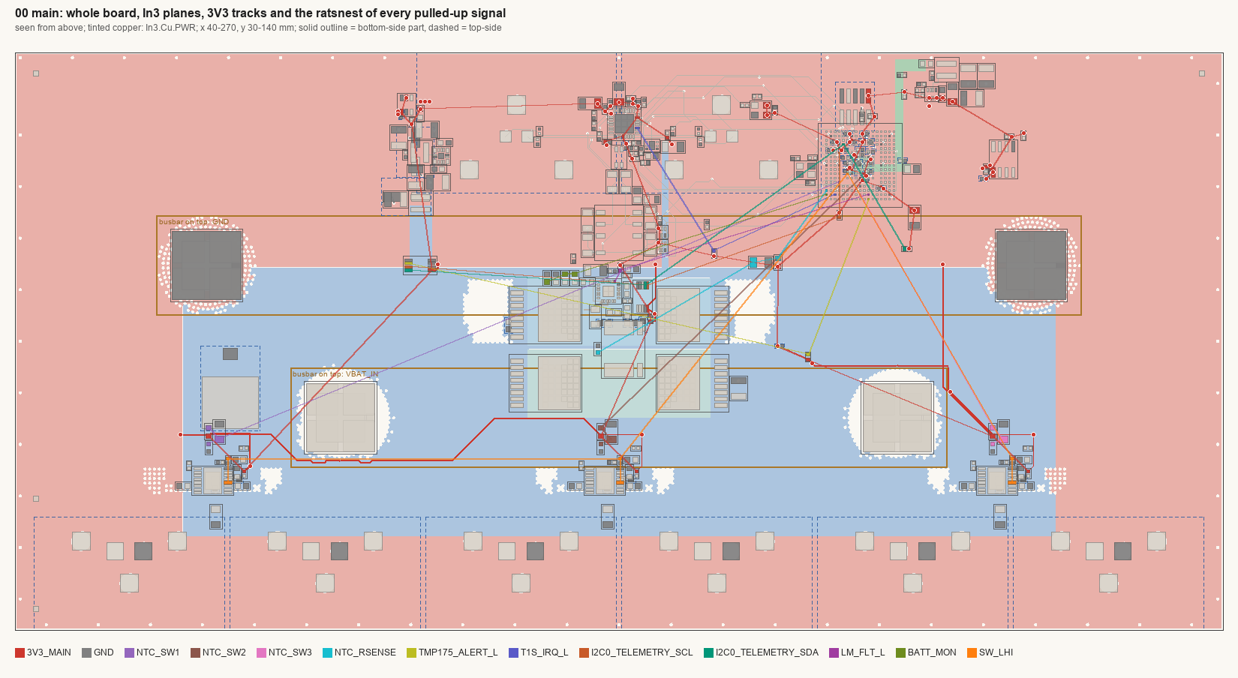
placement/2026-11-12-passives/img/00-main/board_in3.png
