karlTbowers/node60-hw/placement/2026-11-12-passives/img/00-main/cell_u801.png

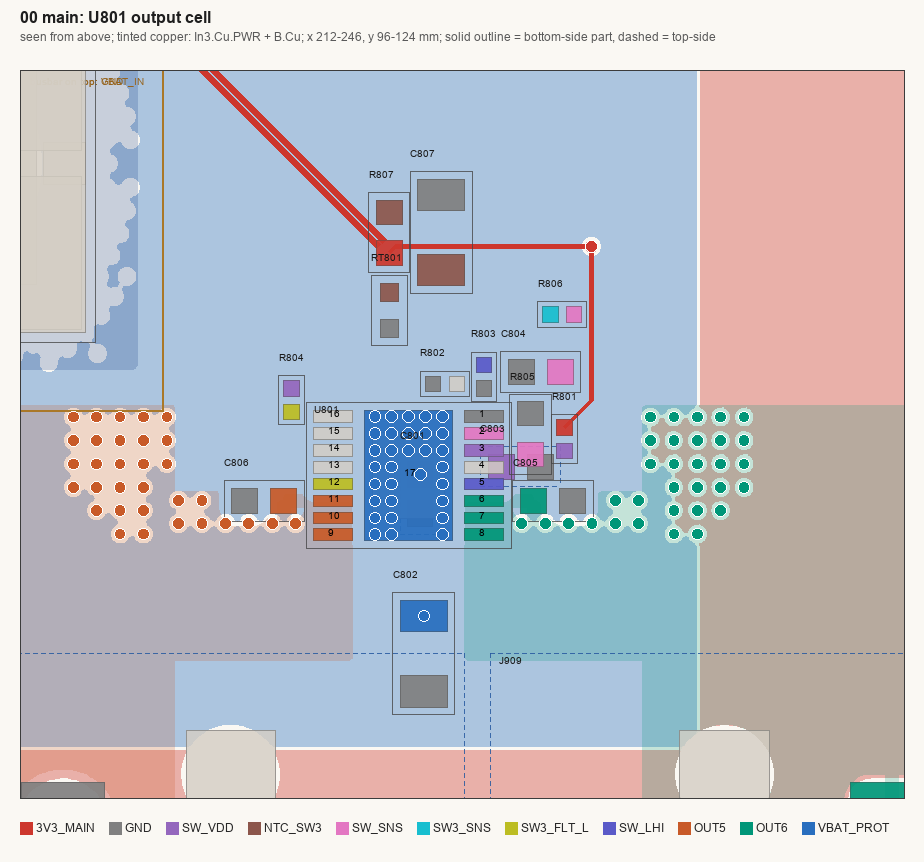
placement/2026-11-12-passives/img/00-main/cell_u801.png
