karlTbowers/node60-hw/placement/2026-11-12-passives/img/00-main/entry.png

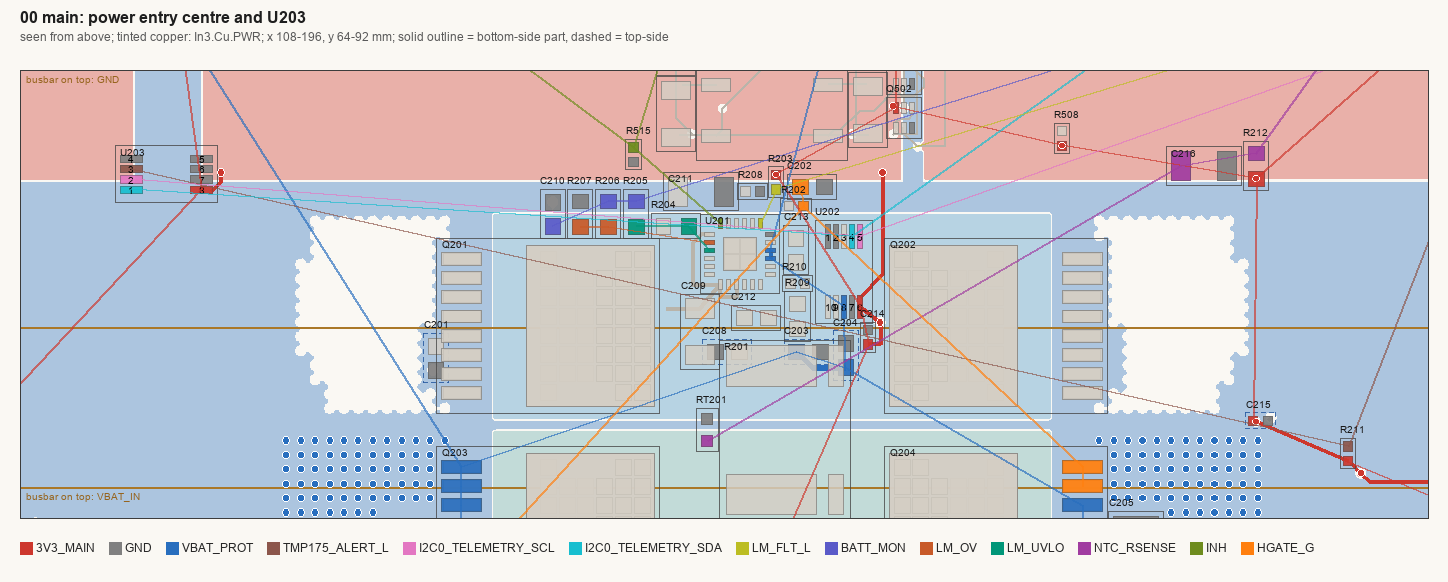
placement/2026-11-12-passives/img/00-main/entry.png
