karlTbowers/node60-hw/placement/2026-11-12-passives/img/00-main/z_u701_B.png

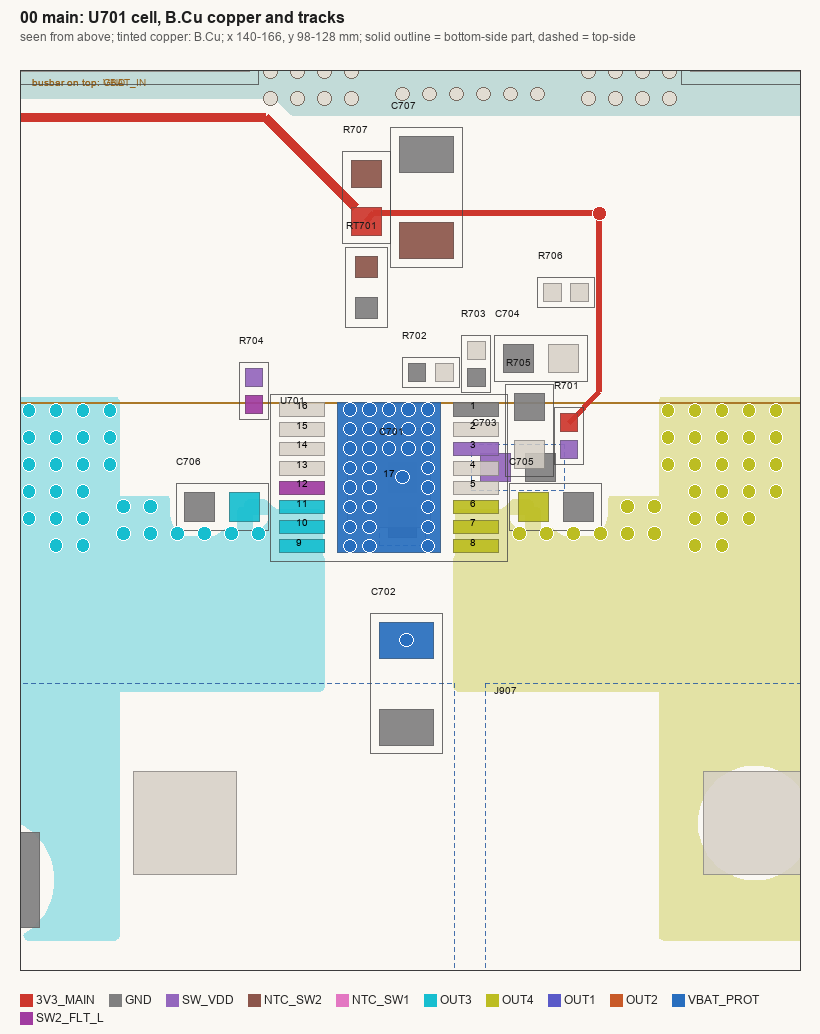
placement/2026-11-12-passives/img/00-main/z_u701_B.png
