karlTbowers/node60-hw/placement/2026-11-12-passives/img/01-tmp175-home/east_1_before.png

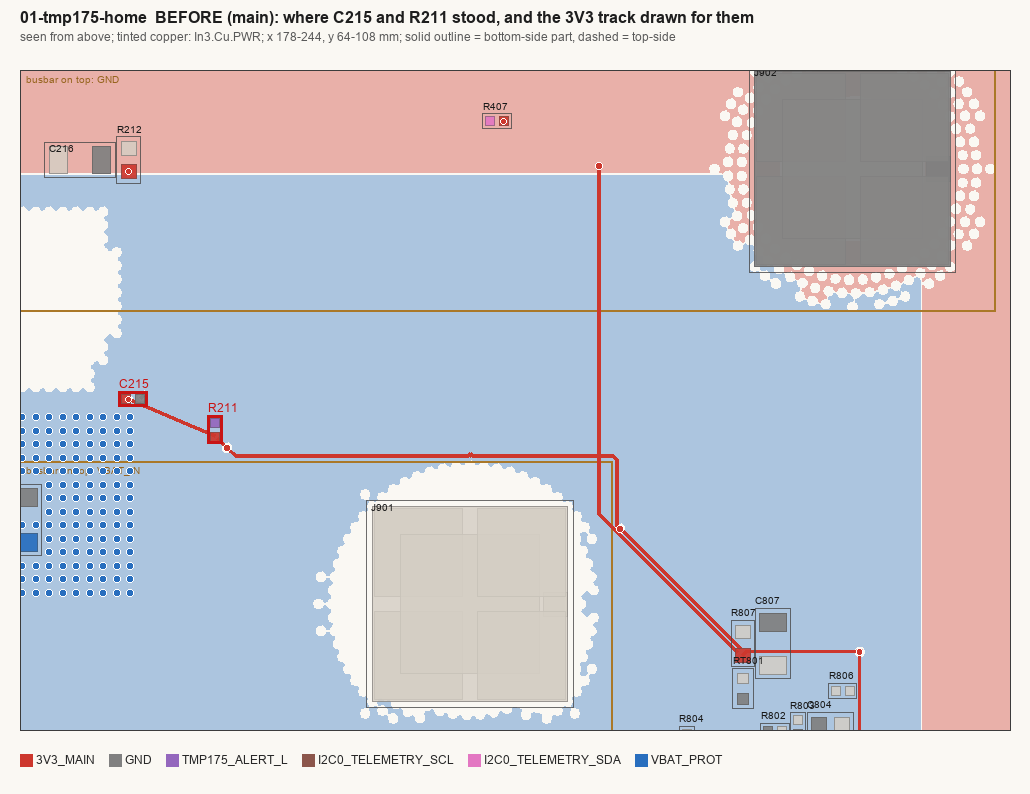
placement/2026-11-12-passives/img/01-tmp175-home/east_1_before.png
