karlTbowers/node60-hw/placement/2026-11-12-passives/img/02-east-feed/east_2_after.png

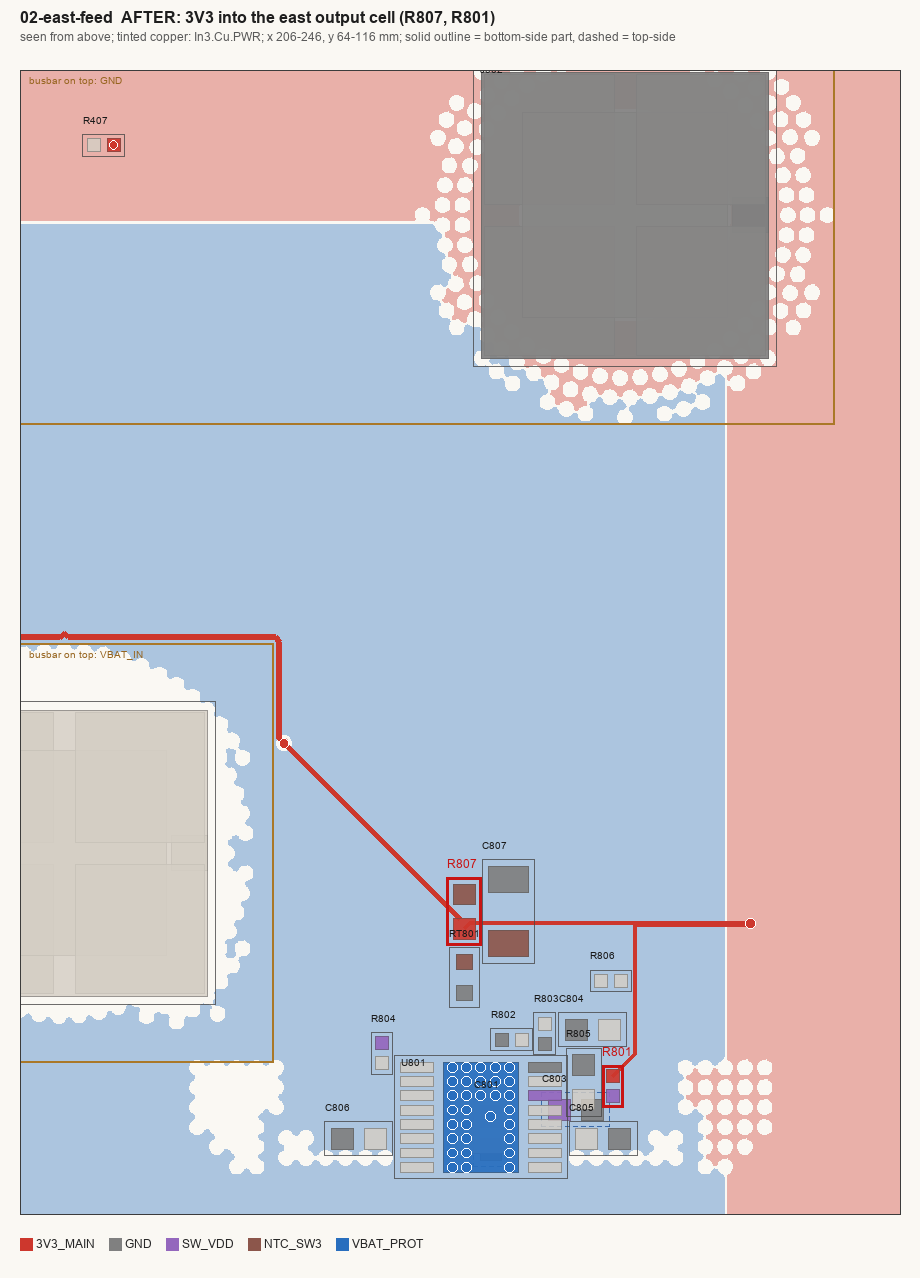
placement/2026-11-12-passives/img/02-east-feed/east_2_after.png
