karlTbowers/node60-hw/placement/2026-11-12-passives/img/02-east-feed/vias_mid_1_before.png

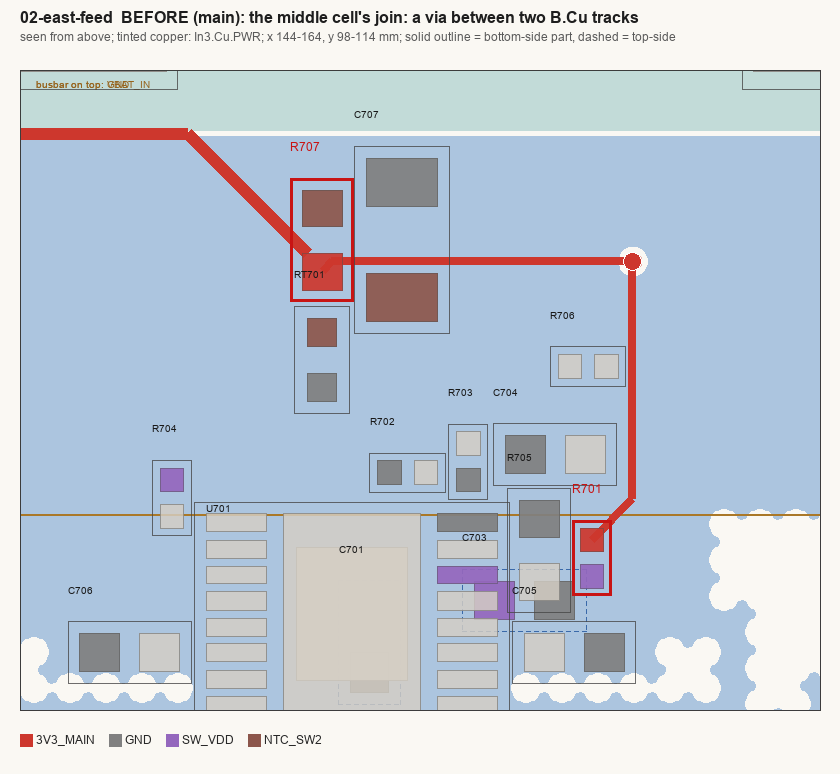
placement/2026-11-12-passives/img/02-east-feed/vias_mid_1_before.png
