karlTbowers/node60-hw/placement/2026-11-12-passives/img/03a-i2c-pullups-row/mcu_1_before.png

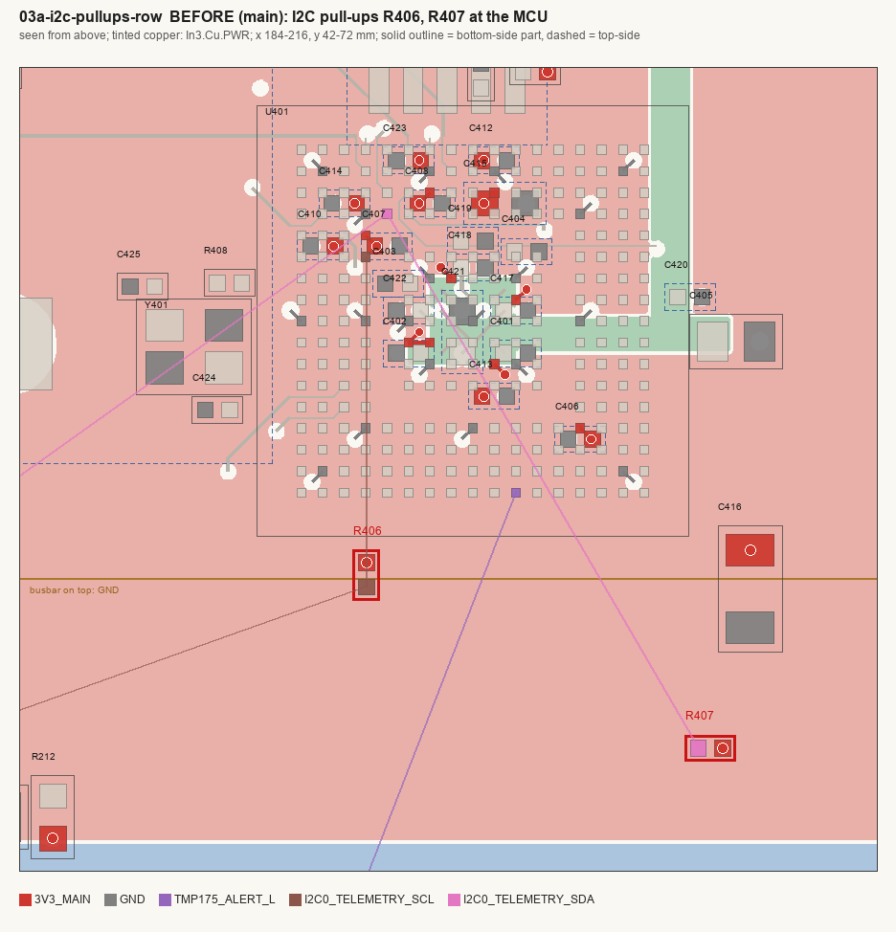
placement/2026-11-12-passives/img/03a-i2c-pullups-row/mcu_1_before.png
