karlTbowers/node60-hw/placement/2026-11-12-passives/img/04-irq-pullup/mcu_1_before.png

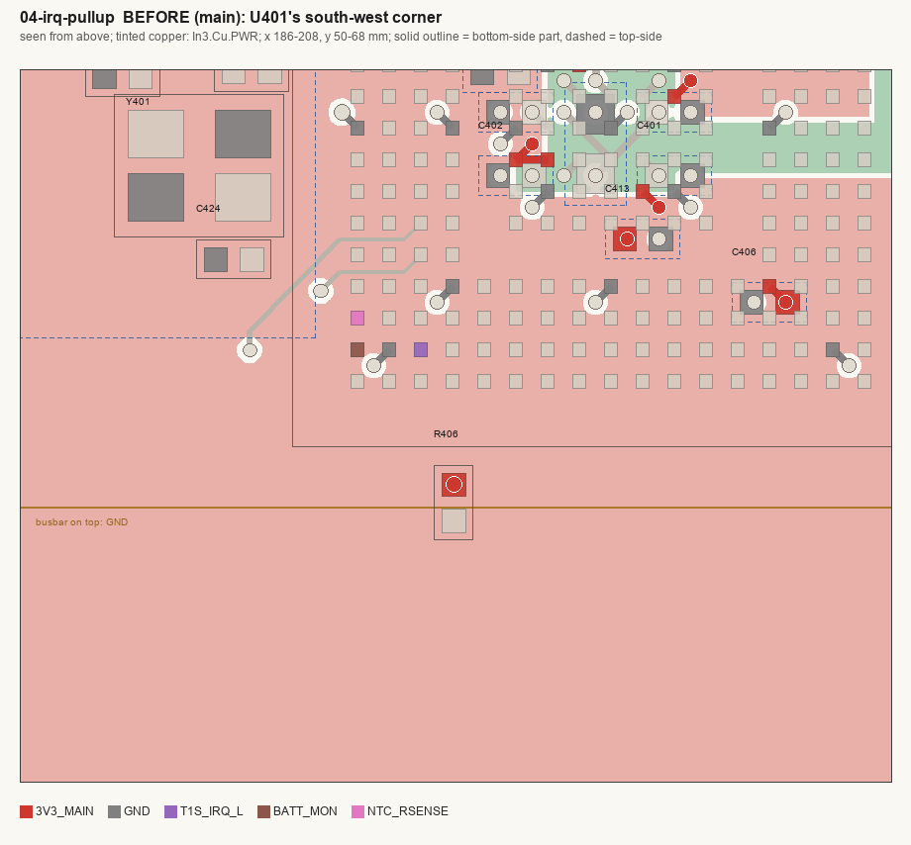
placement/2026-11-12-passives/img/04-irq-pullup/mcu_1_before.png
