karlTbowers/node60-hw/placement/2026-11-12-passives/img/05-ntc-to-mcu/cell_mid_1_before.png

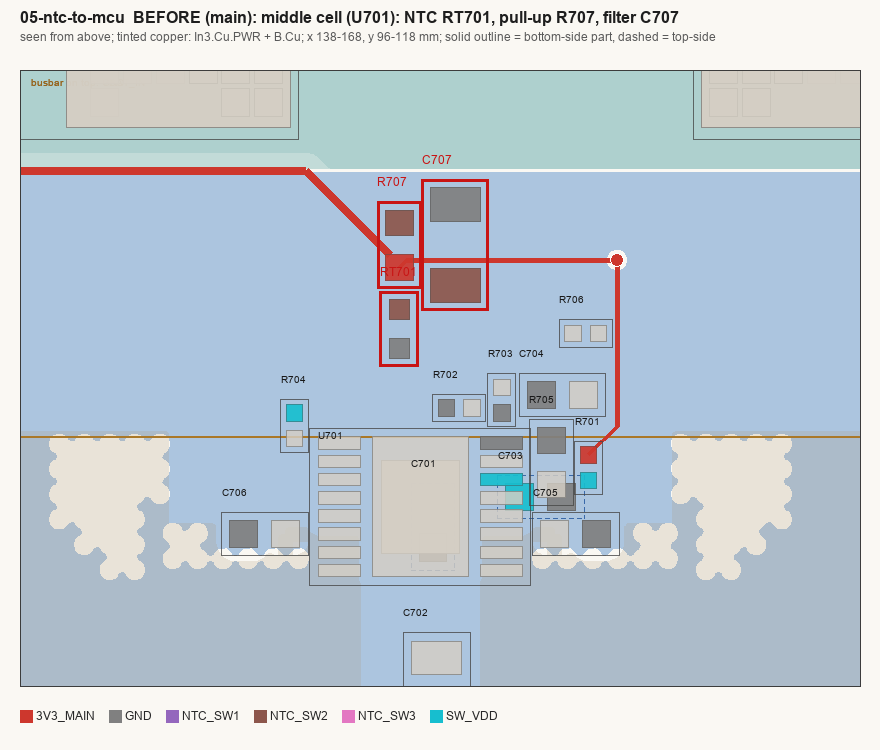
placement/2026-11-12-passives/img/05-ntc-to-mcu/cell_mid_1_before.png
