karlTbowers/node60-hw/placement/2026-11-12-passives/img/05-ntc-to-mcu/cell_mid_2_after.png

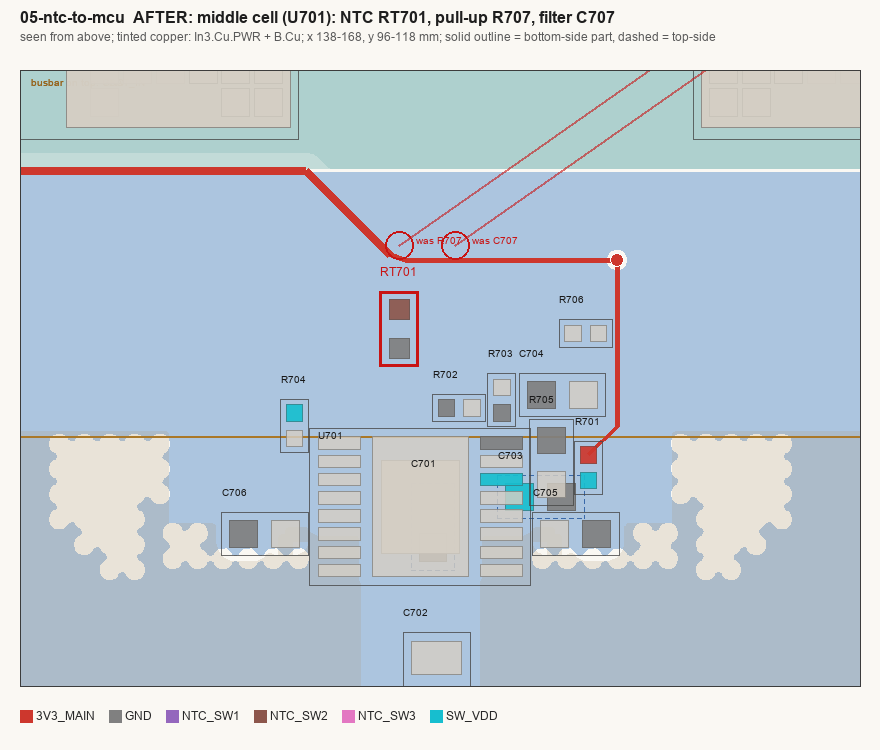
placement/2026-11-12-passives/img/05-ntc-to-mcu/cell_mid_2_after.png
