karlTbowers/node60-hw/placement/2026-11-12-passives/img/05-ntc-to-mcu/mcu_2_after.png

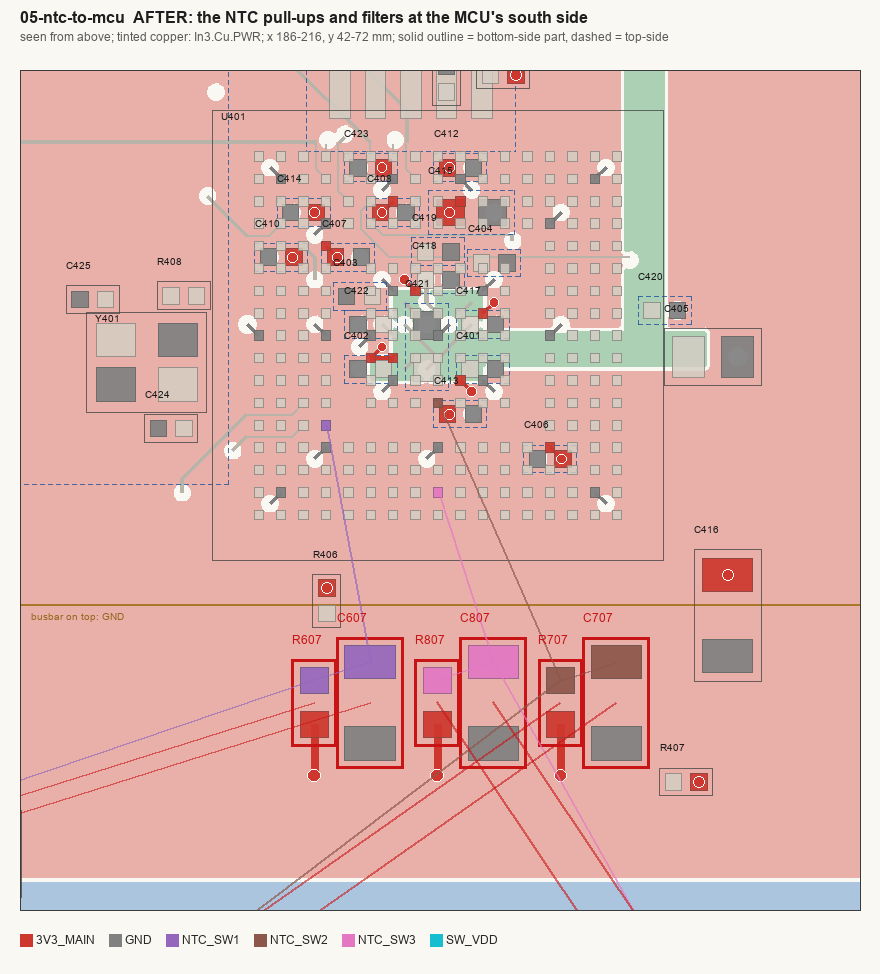
placement/2026-11-12-passives/img/05-ntc-to-mcu/mcu_2_after.png
