karlTbowers/node60-hw/placement/2026-11-12-passives/img/06-phy-strap/u501_1_before.png

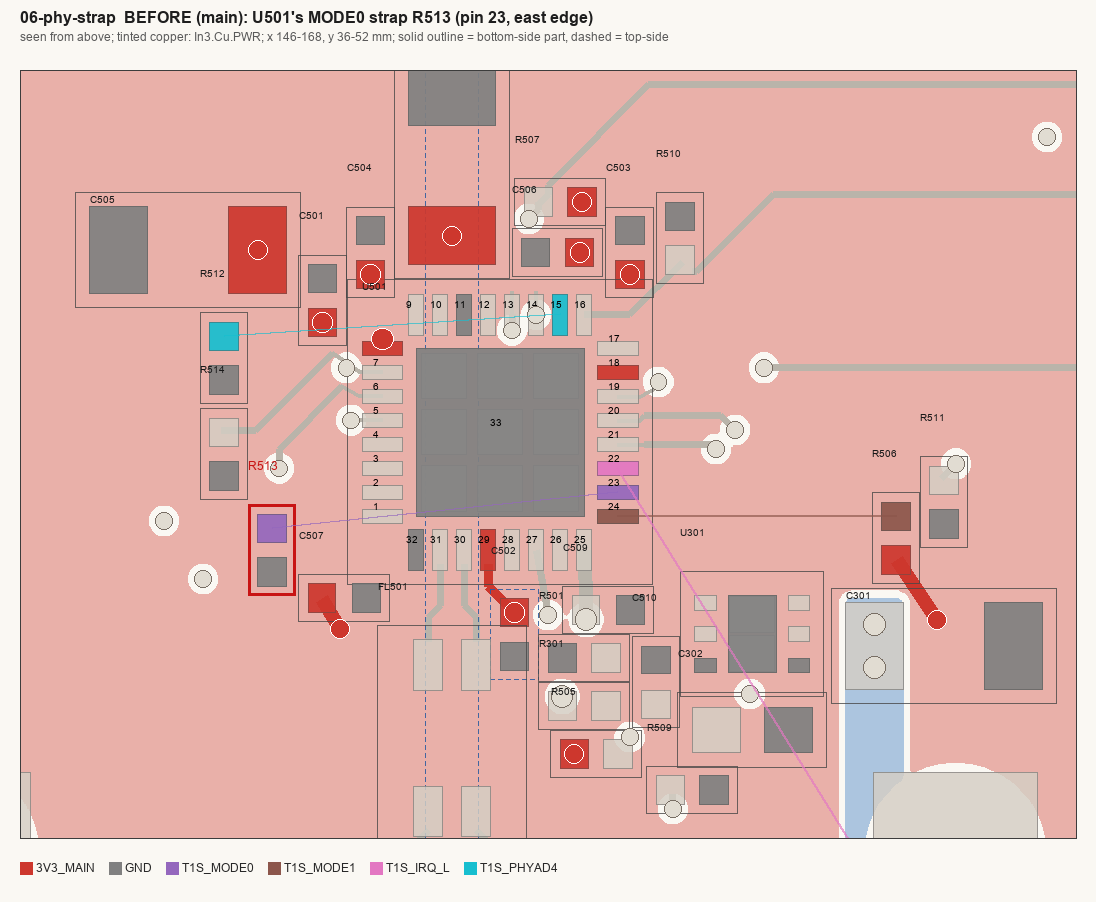
placement/2026-11-12-passives/img/06-phy-strap/u501_1_before.png
