karlTbowers/node60-hw/placement/2026-11-12-passives/img/07a-combined/cell_east_2_after.png

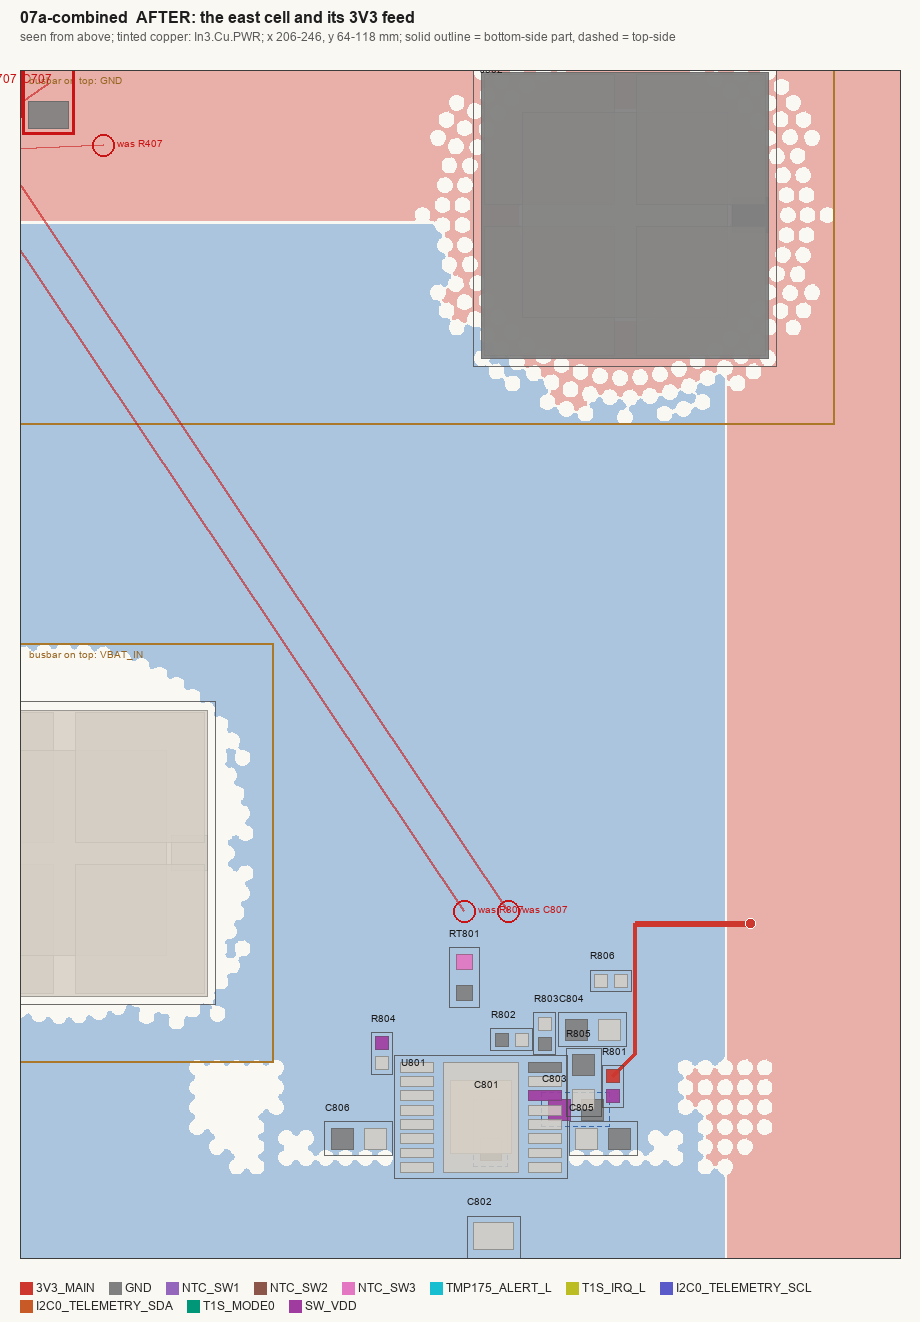
placement/2026-11-12-passives/img/07a-combined/cell_east_2_after.png
