karlTbowers/node60-hw/placement/2026-11-12-passives/img/07b-combined/u203_2_after.png

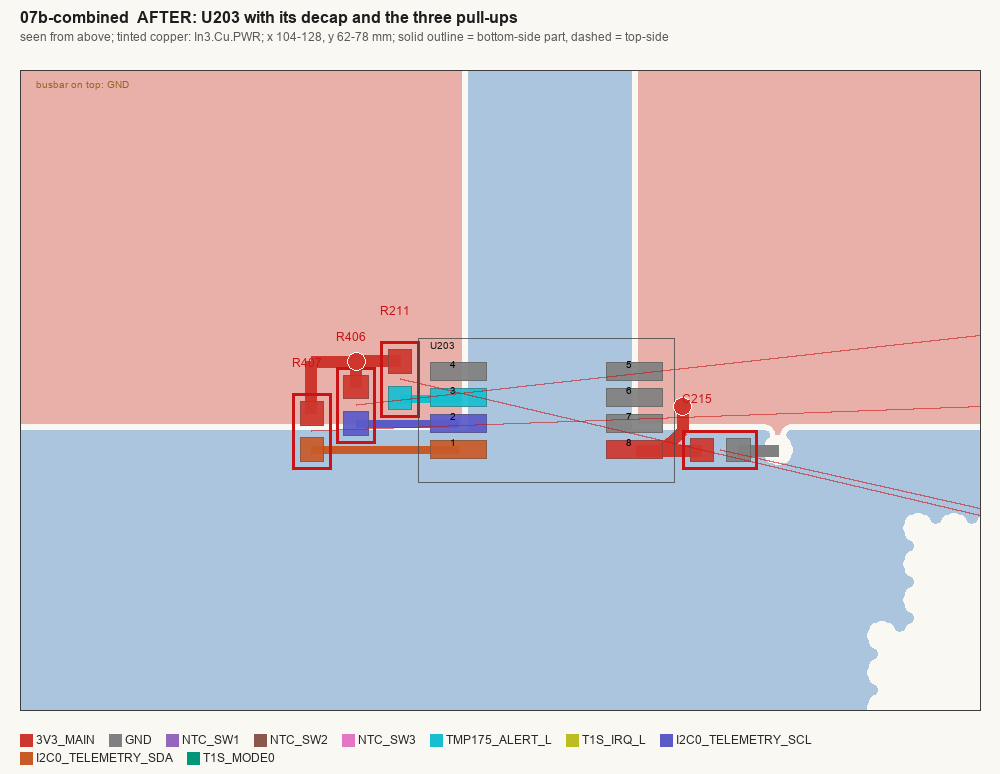
placement/2026-11-12-passives/img/07b-combined/u203_2_after.png
