karlTbowers/node60-hw/placement/2026-11-12-passives/img/08-no-3v3-into-cells/west_1_before.png

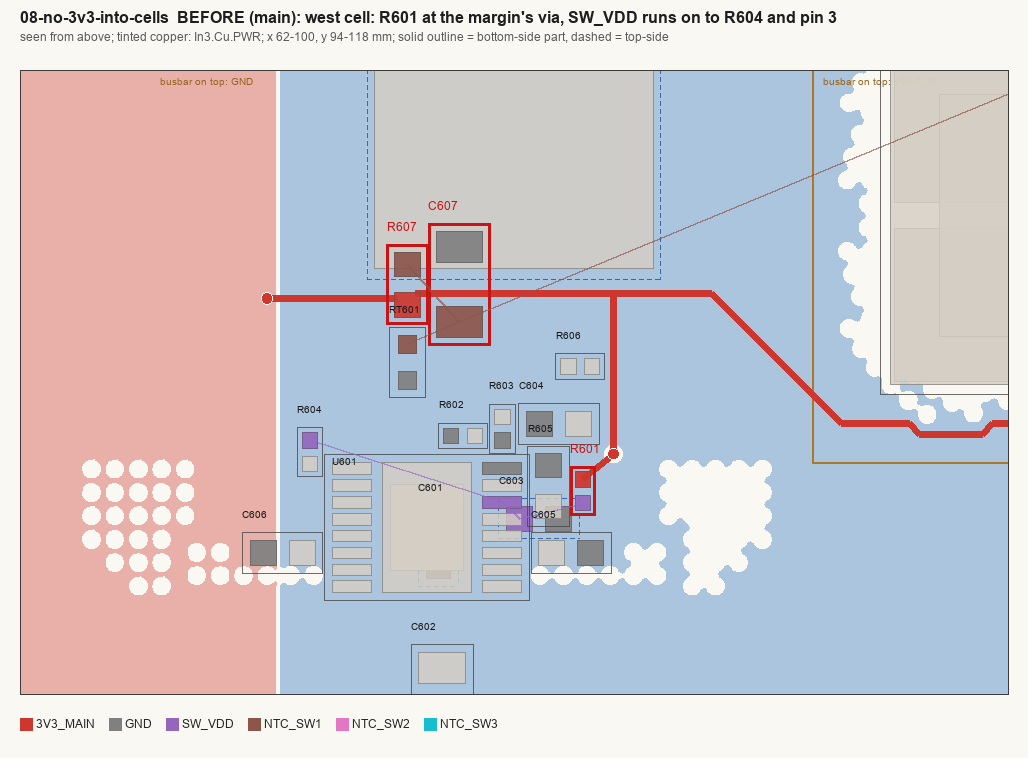
placement/2026-11-12-passives/img/08-no-3v3-into-cells/west_1_before.png
