karlTbowers/node60-hw/placement/2026-11-12-passives/img/10-tvs-pour/tvs_1_before.png

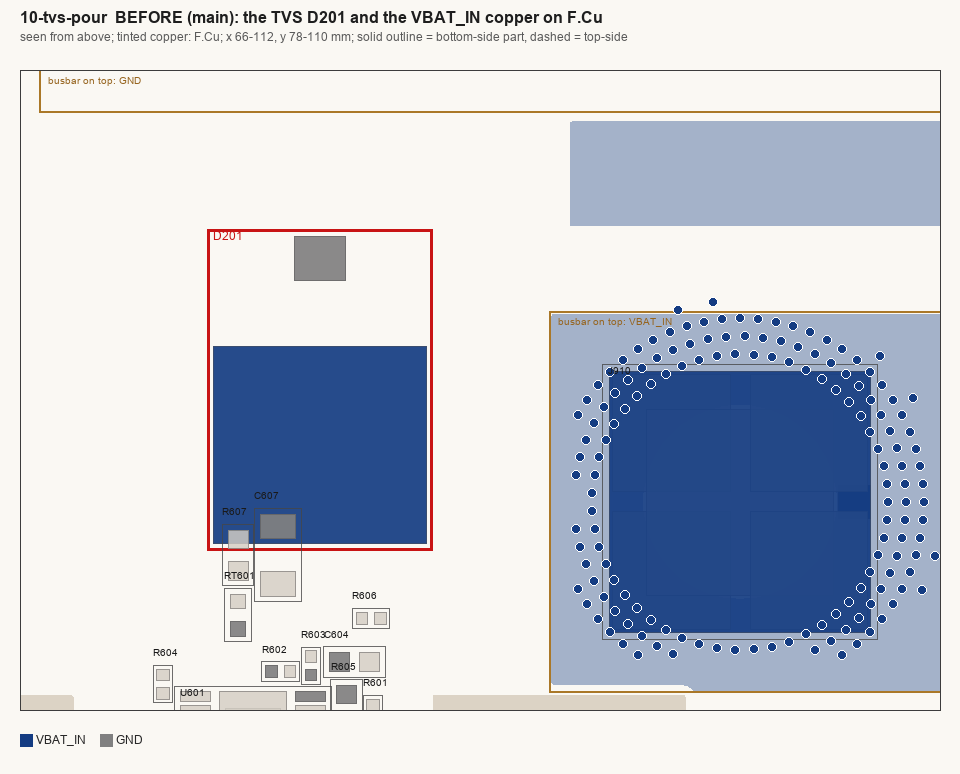
placement/2026-11-12-passives/img/10-tvs-pour/tvs_1_before.png
