karlTbowers/node60-hw/placement/2026-11-12-route/img/band_east_B_1_before.png

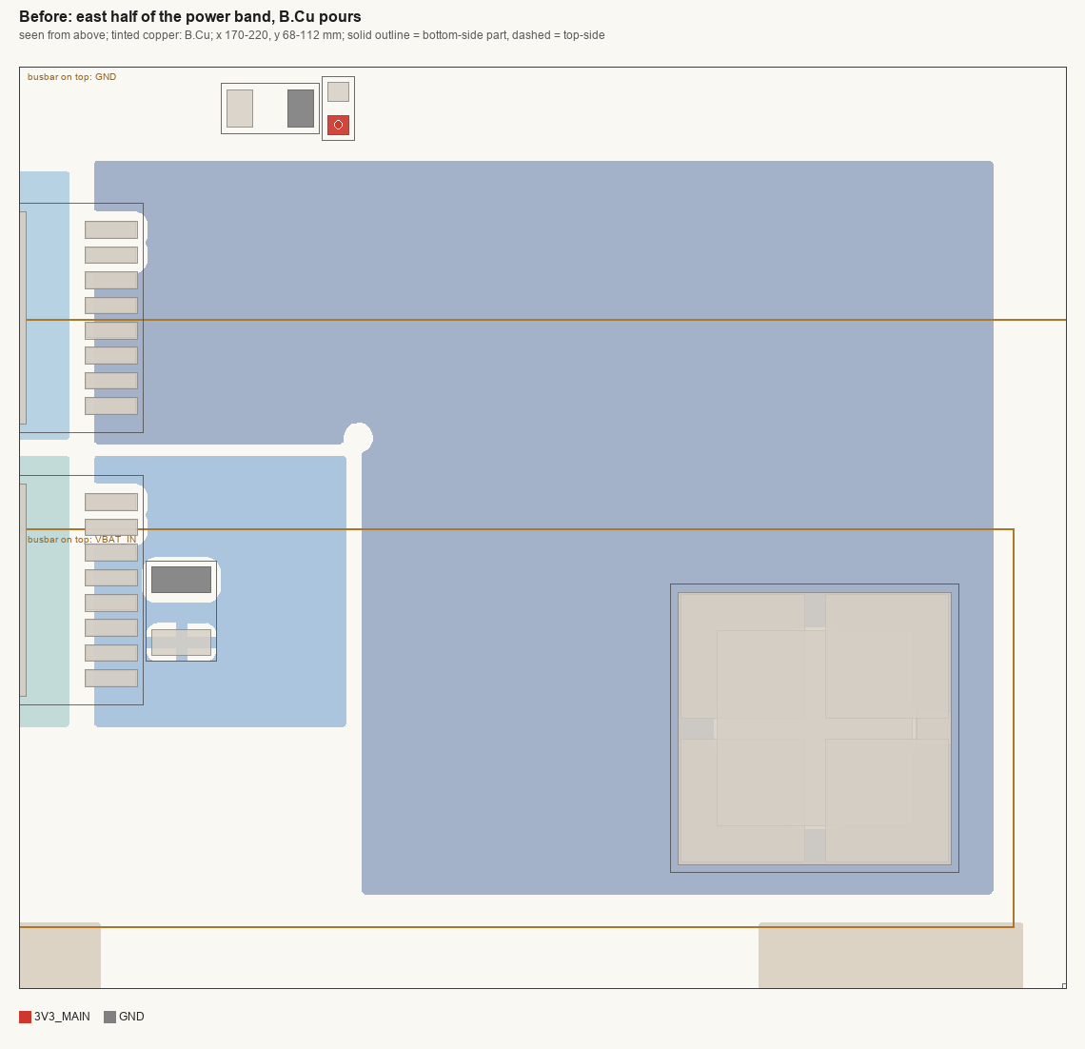
placement/2026-11-12-route/img/band_east_B_1_before.png
