karlTbowers/node60-hw/placement/2026-11-12-route/img/band_east_B_2_attempt.png

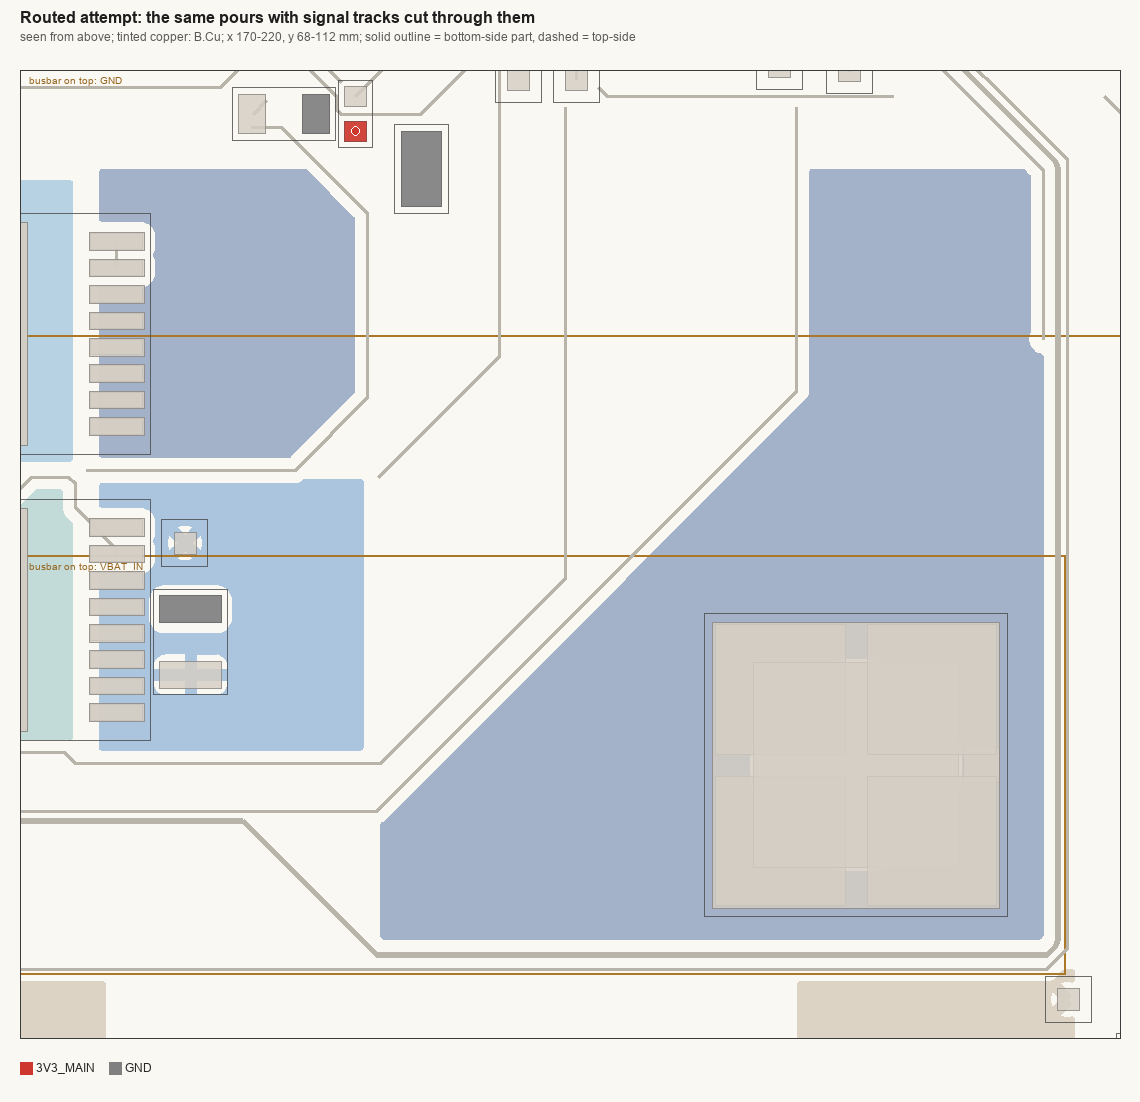
placement/2026-11-12-route/img/band_east_B_2_attempt.png
