karlTbowers/node60-hw/placement/2026-11-12-route/img/board_attempt_B.png

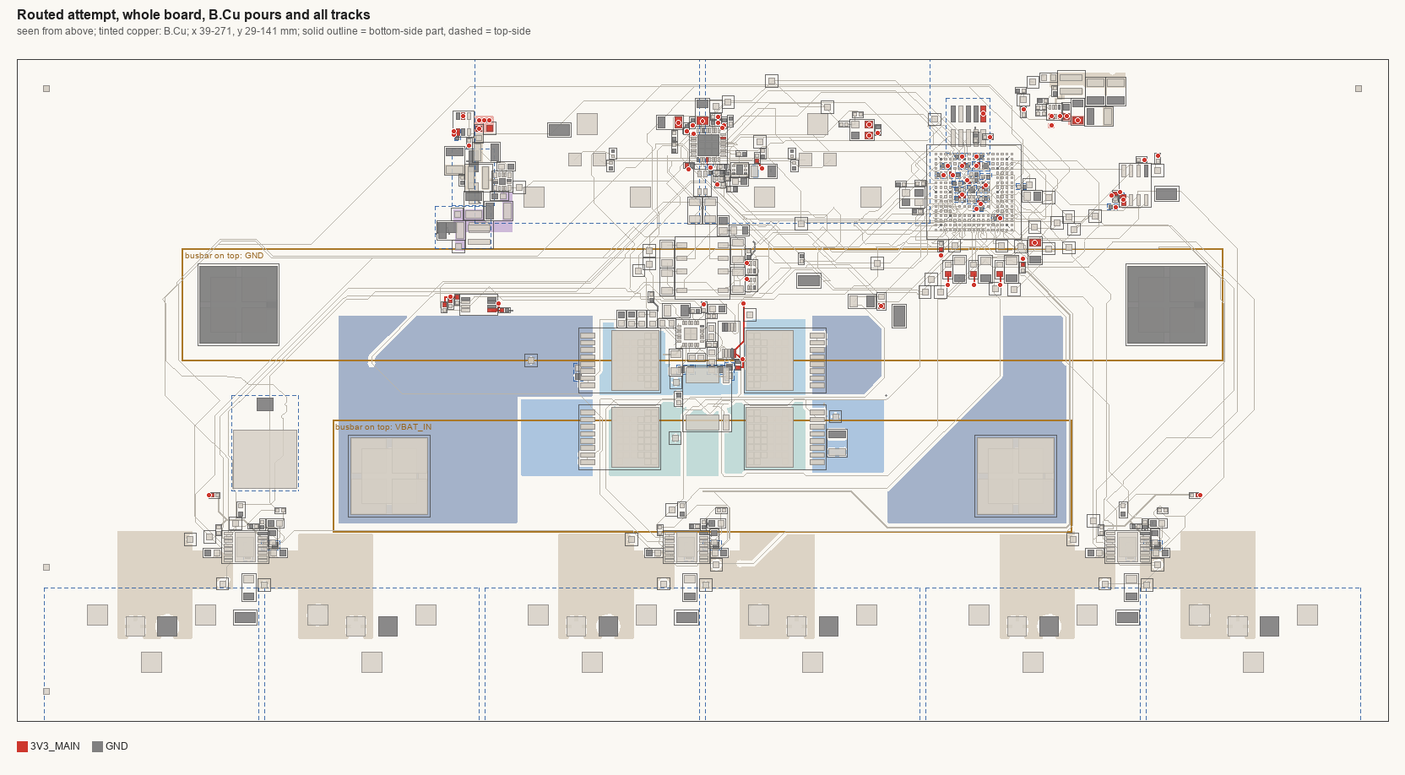
placement/2026-11-12-route/img/board_attempt_B.png
