karlTbowers/node60-hw/placement/2026-11-12-route/img/d33_band_B.png

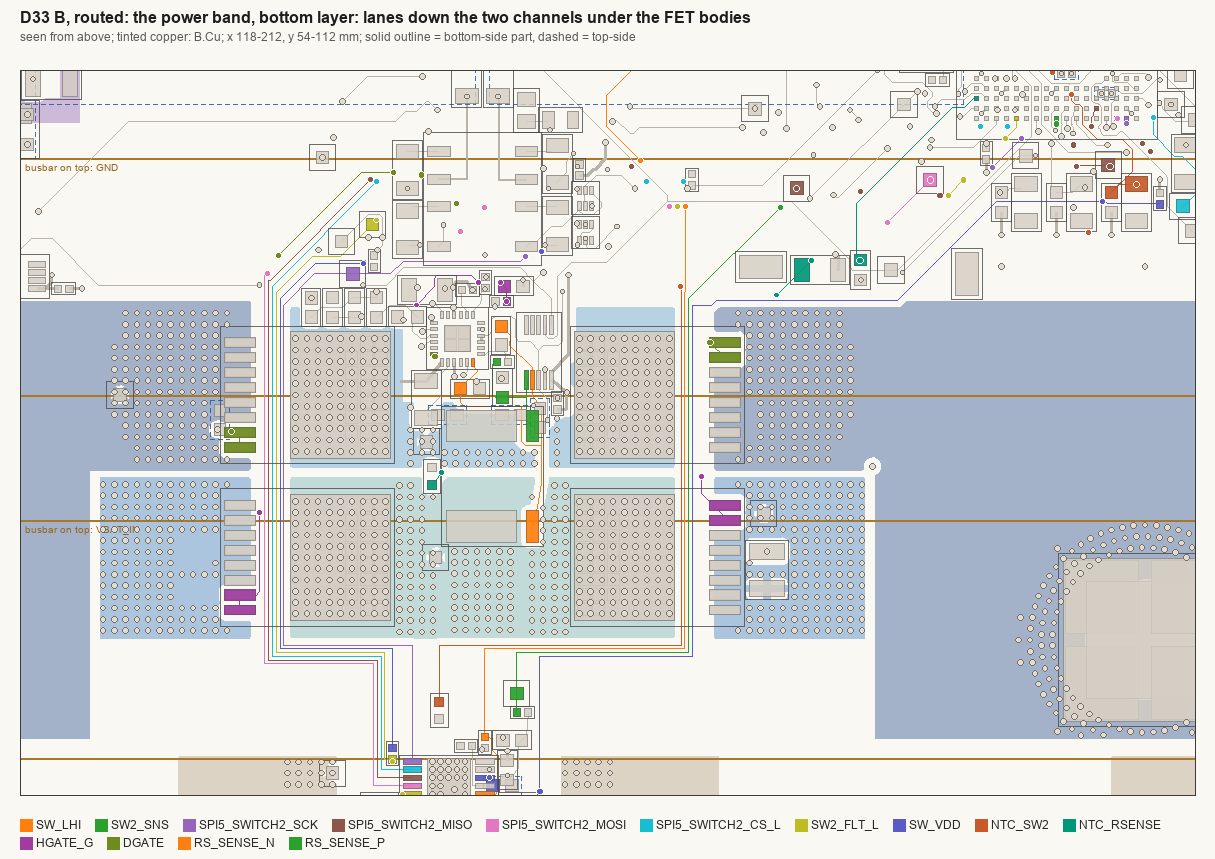
placement/2026-11-12-route/img/d33_band_B.png
