karlTbowers/node60-hw/placement/2026-11-12-route/img/d36_u201_west.png

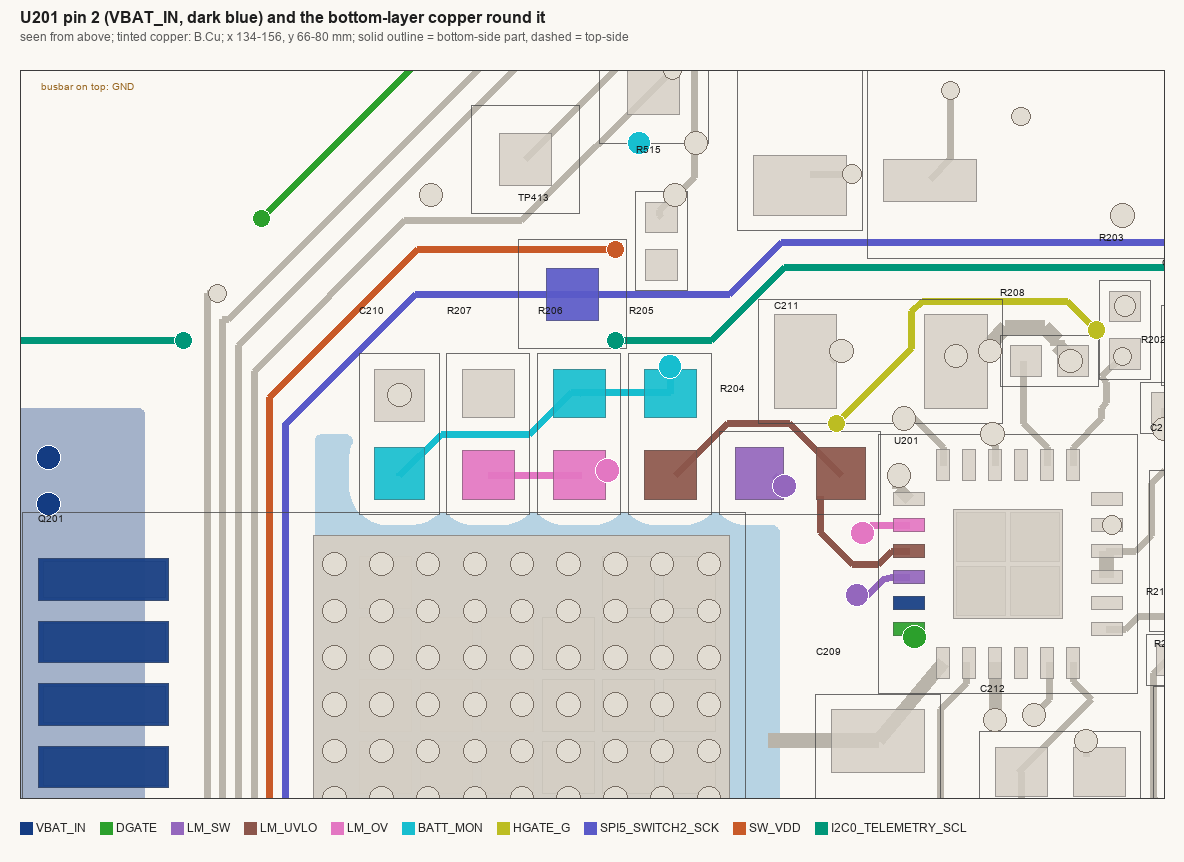
placement/2026-11-12-route/img/d36_u201_west.png
