karlTbowers/node60-hw/placement/2026-11-12-route/img/mid_cell_attempt.png

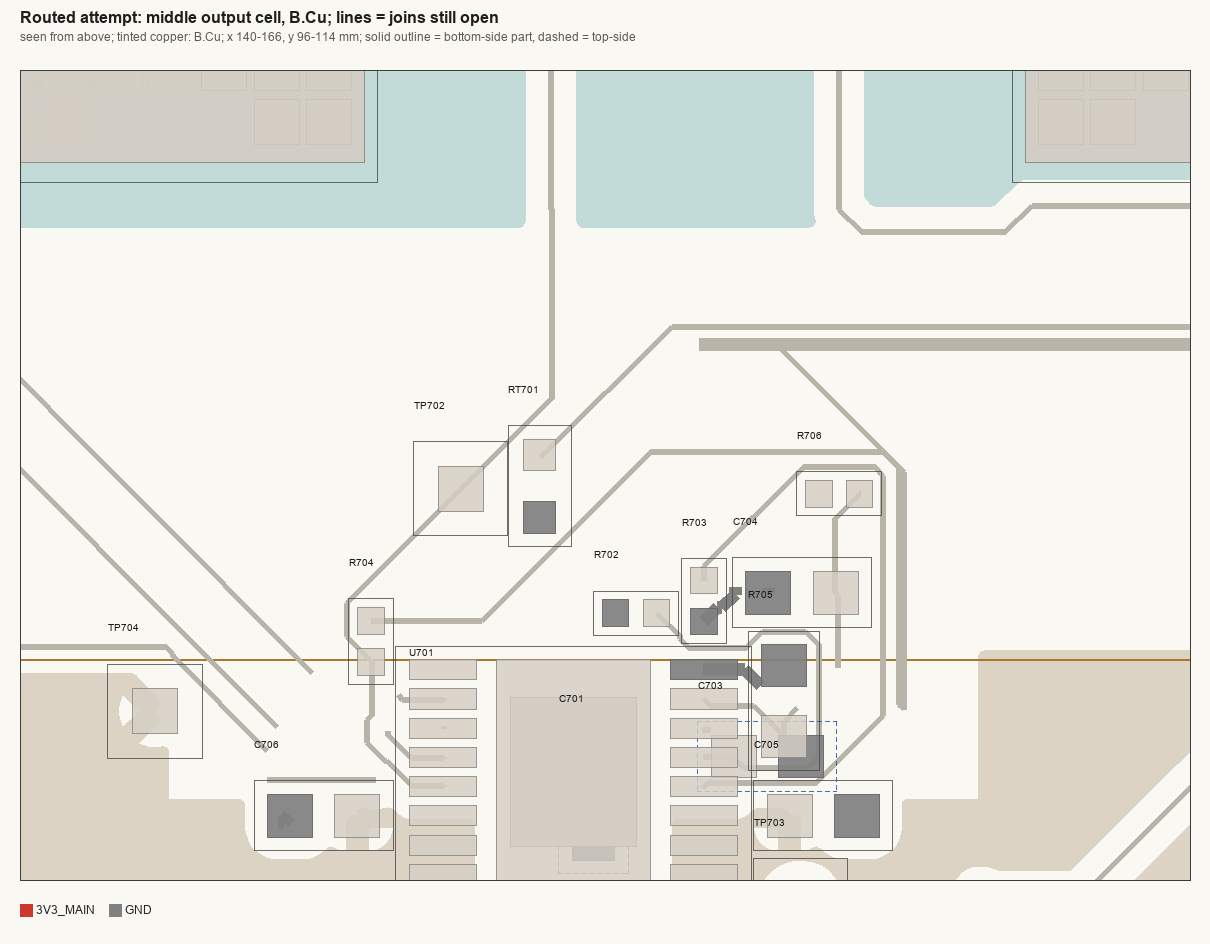
placement/2026-11-12-route/img/mid_cell_attempt.png
