karlTbowers/node60-hw/placement/2026-11-12-route/img/u201_attempt.png

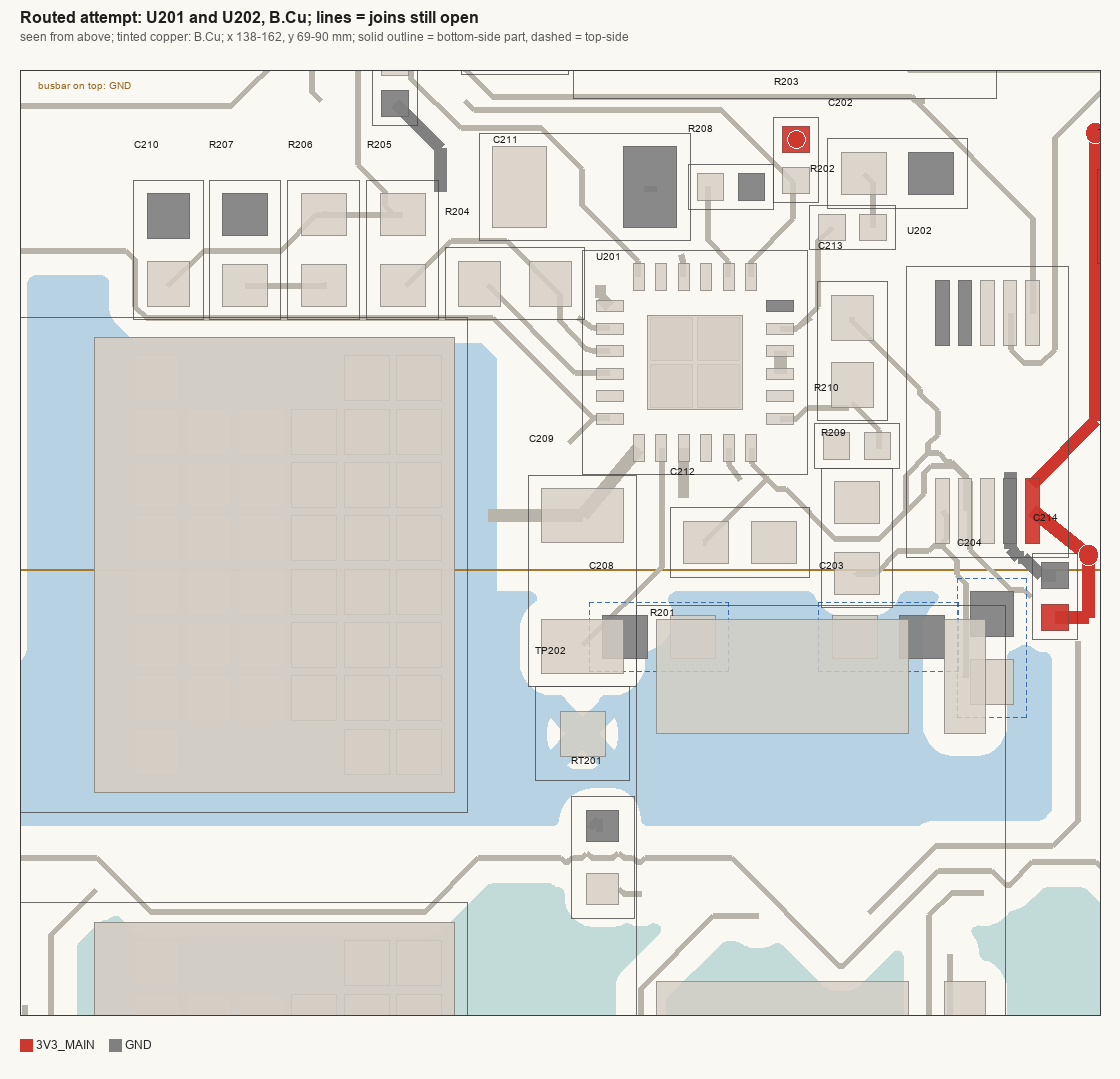
placement/2026-11-12-route/img/u201_attempt.png
