karlTbowers/node60-hw/placement/2026-11-13-spi-series-r/img/u401_se_B.png

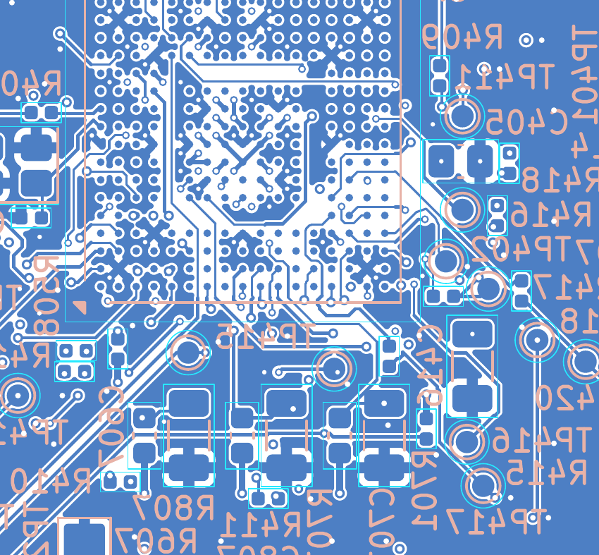
placement/2026-11-13-spi-series-r/img/u401_se_B.png
