karlTbowers/node60-hw/docs/src/assets/hero/node60-enclosure-assembled.webp

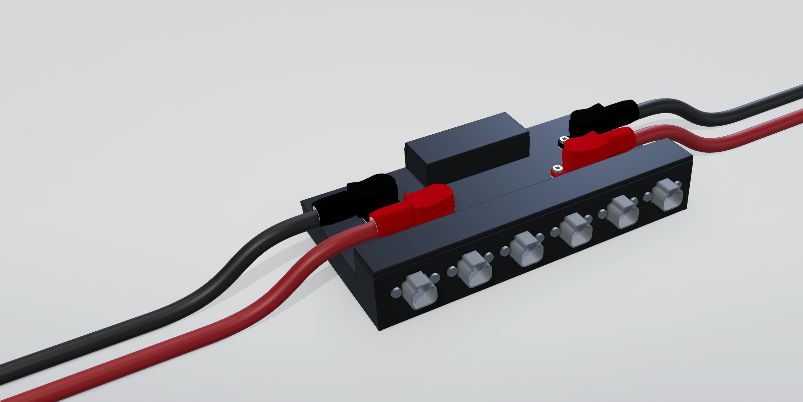
docs/src/assets/hero/node60-enclosure-assembled.webp
