karlTbowers/node60-hw/docs/src/content/docs/validation/gate-mcu-01.mdx

---
title: GATE-MCU-01 result
description: S32K344EHT1MMMST package map audit, all 257 balls, passed 2026-10-28; re-run for DEC-018 passed 2026-10-30.
---

**Passed on 2026-10-28; re-run passed on 2026-10-30.** The user signed off the audit of all 257 balls of U401 (S32K344EHT1MMMST, 257MAPBGA), after a machine cross-check that found no differences, and signed off the re-run for DEC-018's eight added balls on 2026-10-30.

## Re-run for DEC-018: passed 2026-10-30

<a href="../../decisions/dec-018/">DEC-018</a> gives each output switch its own LPSPI bus. That uses eight more balls and renames the four Rev A switch nets, so the gate was re-run for those balls. The user signed it off on 2026-10-30. The tables below are the 2026-10-28 record and still show the old net names; the current plan is on the [MCU pinout](../../mcu-pinout/) page.

| Ball | Port | Net | Function | IBIS port | BSDL cell |
|---|---|---|---|---|---|
| A16 | PTD26 | `SPI5_SWITCH2_SCK` | LPSPI5_SCK | PTD26 | GPIO_122 |
| A15 | PTD27 | `SPI5_SWITCH2_MOSI` | LPSPI5_SOUT | PTD27 | GPIO_123 |
| B13 | PTD28 | `SPI5_SWITCH2_MISO` | LPSPI5_SIN | PTD28 | GPIO_124 |
| G16 | PTD4 | `SPI5_SWITCH2_CS_L` | LPSPI5_PCS0 | PTD4 | GPIO_100 |
| E14 | PTF13 | `SPI3_SWITCH3_SCK` | LPSPI3_SCK | PTF13 | GPIO_173 |
| F14 | PTF15 | `SPI3_SWITCH3_MOSI` | LPSPI3_SOUT | PTF15 | GPIO_175 |
| E15 | PTF12 | `SPI3_SWITCH3_MISO` | LPSPI3_SIN | PTF12 | GPIO_172 |
| G15 | PTF16 | `SPI3_SWITCH3_CS_L` | LPSPI3_PCS0 | PTF16 | GPIO_176 |

Machine check: every function above is in that ball's IOMUX alternate list (the docs build checks this against the library pin table). The IBIS model and the BSDL file (Hardware Design Package Rev. E2) give the same port for each ball; BSDL GPIO numbers are port × 32 + pin, with PTD = 3 and PTF = 5. The four LPSPI4 balls (A14, C15, C17, D15) keep their functions under the new names `SPI4_SWITCH1_*`. The eight balls were unconnected with no-connect flags in the 2026-10-28 audit.

## Method

The schematic netlist (U401 ball, symbol pin name, net) was compared with three NXP sources:

| Source | What it checked |
|---|---|
| S32K3xx Reference Manual IOMUX attachment `S32K344_S32K324_S32K314_IOMUX.xlsx` (Nov 2025 build) | Port or supply name on every ball; for each used signal, that the planned function exists on that ball and which MSCR/IMCR setting selects it |
| S32K3 Hardware Design Package Rev. E2, IBIS model `s32k344_bga257_3v.ibs` | Port name on every signal ball; supply names (each supply listed once) |
| S32K3 Hardware Design Package Rev. E2, BSDL `S32K344_bga257_996001D.bsdl` | Port on every boundary-scan ball |

The library symbol was generated from the IOMUX table, so the IBIS and BSDL files are the independent checks. The NXP tables and select values stay in the private review sheet; this page lists only what the schematic already shows.

## Result

- **Ball map:** 257 of 257 balls match. The 220 signal and oscillator balls match all three sources. The 37 supply balls match the IOMUX supply table, and their names match the IBIS model where it lists them.
- **Functions:** all 43 used signals have their planned function on their ball. External interrupt lines are all different (EIRQ 0, 1, 2, 6, 17, 23).
- **RMII:** TXD0/TXD1 sit on the opposite balls from NXP's TJA1100 example (PTD7/PTC2); each ball offers both data lines, so this is valid. CRS_DV, RX_ER, MDC and MDIO use NXP's other listed balls.
- **Unused:** 177 balls are unconnected, including JTAG_TDI (F8): debug is SWD only. Unused GPIOs stay disabled, as the Hardware Design Guidelines Rev. E2 (Table 33) require.

### Addendum, 2026-10-28 (DEC-017)

Two unused balls became outputs for the termination relay driver: PTD0 (F3) → `T1S_TERM_END` and PTD1 (E3) → `T1S_TERM_DROP`. Both are plain GPIOs in NXP's IOMUX table (GPIO[96], GPIO[97]) and match the IBIS and BSDL port names. The ball map is unchanged.

### Used signals

The [MCU pinout](../../mcu-pinout/) page draws this table on the ball map, with the planned pad settings.

| Ball | Pin | Net | Planned function |
|---|---|---|---|
| B1 | PTA18 | `BATT_MON` | ADC2_P0 |
| K1 | EXTAL | `FXOSC_EXTAL` | EXTAL |
| L1 | XTAL | `FXOSC_XTAL` | XTAL |
| M4 | PTD14 | `I2C0_TELEMETRY_SCL` | LPI2C0_SCL |
| P5 | PTD13 | `I2C0_TELEMETRY_SDA` | LPI2C0_SDA |
| B11 | PTE6 | `LM_FLT_L` | EIRQ[6] |
| N3 | PTD17 | `MDIO0_T1S_MDC` | EMAC_MII_RMII_MDC |
| P2 | PTD16 | `MDIO0_T1S_MDIO` | EMAC_MII_RMII_MDIO |
| C1 | PTA19 | `NTC_RSENSE` | ADC2_P1 |
| E4 | PTA20 | `NTC_SW1` | ADC2_P2 |
| F9 | PTE21 | `NTC_SW2` | ADC2_P3 |
| B9 | PTE22 | `NTC_SW3` | ADC2_P4 |
| A3 | PTA5/RESET_B | `RESET_L` | RESET_b |
| R6 | PTC17 | `RMII0_T1S_CRS_DV` | EMAC_MII_RMII_RX_DV |
| U6 | PTD11 | `RMII0_T1S_REF_CLK` | EMAC_MII_RMII_TX_CLK |
| T8 | PTC1 | `RMII0_T1S_RXD0` | EMAC_MII_RMII_RXD[0] |
| U7 | PTC0 | `RMII0_T1S_RXD1` | EMAC_MII_RMII_RXD[1] |
| P6 | PTC16 | `RMII0_T1S_RX_ER` | EMAC_MII_RMII_RX_ER |
| U4 | PTD7 | `RMII0_T1S_TXD0` | EMAC_MII_RMII_TXD[0] |
| T4 | PTC2 | `RMII0_T1S_TXD1` | EMAC_MII_RMII_TXD[1] |
| R5 | PTD12 | `RMII0_T1S_TX_EN` | EMAC_MII_RMII_TX_EN |
| E1 | PTE11 | `SPI2_FLASH_CS_L` | LPSPI2_PCS0 |
| C2 | PTE16 | `SPI2_FLASH_MISO` | LPSPI2_SIN |
| C6 | PTF2 | `SPI2_FLASH_MOSI` | LPSPI2_SOUT |
| D2 | PTE15 | `SPI2_FLASH_SCK` | LPSPI2_SCK |
| A14 | PTB8 | `SPI4_SWITCH_CS_L` | LPSPI4_PCS0 |
| C17 | PTB11 | `SPI4_SWITCH_MISO` | LPSPI4_SIN |
| C15 | PTB9 | `SPI4_SWITCH_MOSI` | LPSPI4_SOUT |
| D15 | PTB10 | `SPI4_SWITCH_SCK` | LPSPI4_SCK |
| B5 | PTE0 | `SW1_FLT_L` | EIRQ[0] |
| A7 | PTA12/CLKOUT_STANDBY | `SW1_SNS` | ADC1_P0 |
| A5 | PTE1 | `SW2_FLT_L` | EIRQ[1] |
| A9 | PTA13 | `SW2_SNS` | ADC1_P1 |
| B10 | PTE2 | `SW3_FLT_L` | EIRQ[2] |
| A10 | PTA14 | `SW3_SNS` | ADC1_P4 |
| F7 | PTC4/JTAG_TCK/SWD_CLK | `SWD_CLK` | JTAG_TCK/SWD_CLK |
| F6 | PTA4/JTAG_TMS/SWD_DIO | `SWD_DIO` | JTAG_TMS/SWD_DIO |
| G8 | PTA10/JTAG_TDO/TRACEnoETM_SWO | `SWD_SWO` | JTAG_TDO/TRACEnoETM_SWO |
| G6 | PTE4 | `SW_LHI` | GPIO (output) |
| B3 | PTA9 | `T1S_IRQ_L` | EIRQ[17] |
| A11 | PTA15 | `TMP175_ALERT_L` | EIRQ[23] |
| D17 | PTA2 | `UART0_DEBUG_RX` | LPUART0_RX |
| E16 | PTA3 | `UART0_DEBUG_TX` | LPUART0_TX |

### Supplies

| Net | Balls | List |
|---|---|---|
| `1V1_MCU_V11` | 4 | H9, J8, J10, K9 |
| `1V5_CORE` | 4 | H8, H10, K8, K10 |
| `2V5_MCU_V25` | 1 | J7 |
| `3V3_MAIN` | 9 | D14, G10, H6, H7, K11, L8, N4, R7, R10 |
| `GND` | 19 | B2, B16, D4, D9, G7, G11, J1, J4, J6, J9, J14, L7, L11, P4, P14, T2, T7, T10, T16 |
