karlTbowers/node60-hw/node60.kicad_pcb

## KiCad design node60.kicad_pcb (2026-11-13)

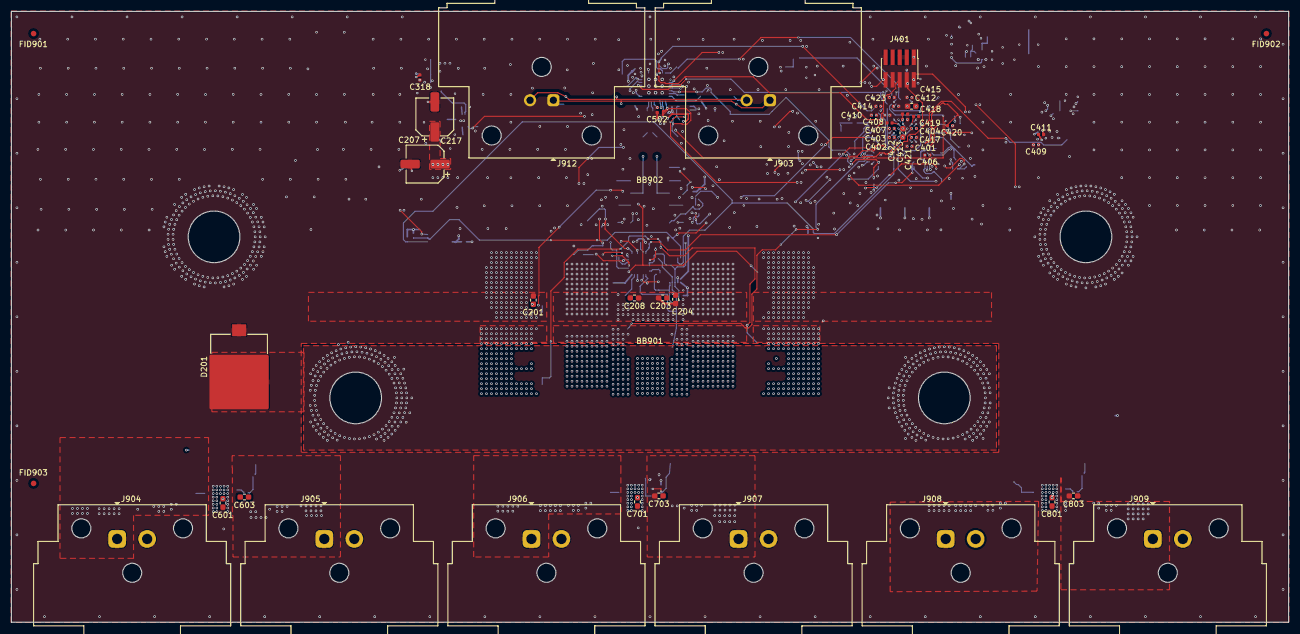
[picture p103: board node60.kicad_pcb from above]

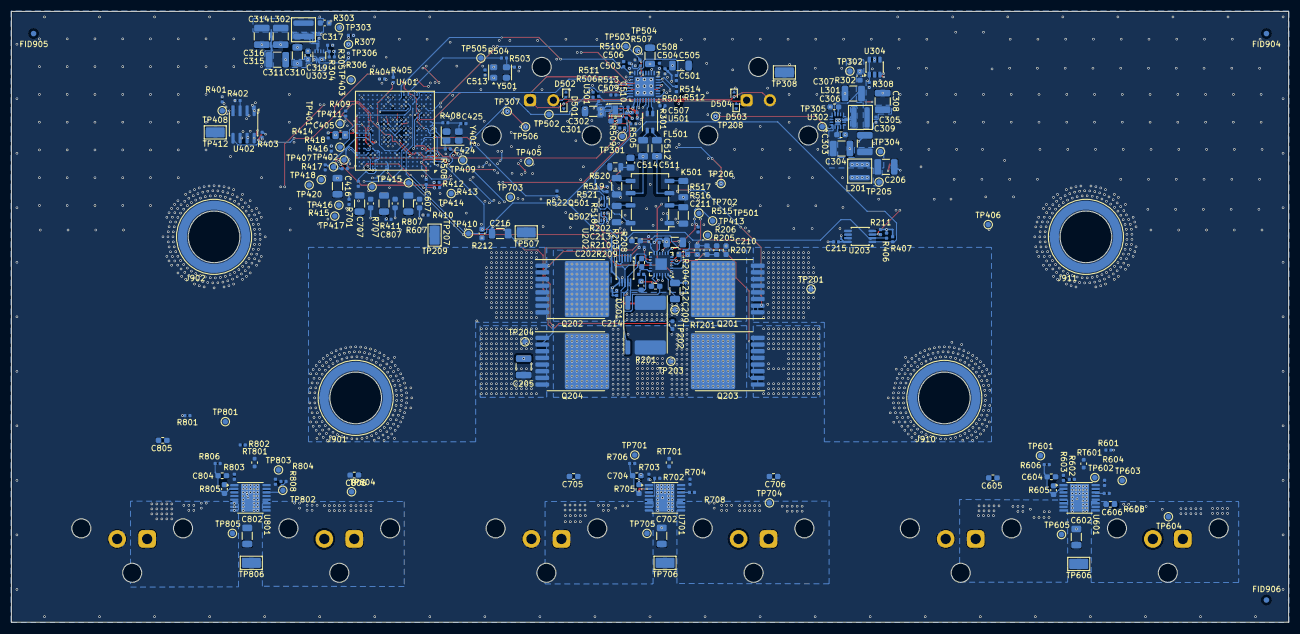
[picture p104: board node60.kicad_pcb from below]

Board: 6 copper layers, 230.0 x 110.0 mm, 293 parts (243 on the bottom side), 136 nets.

Parts:
BB901: Busbar_Cu_19.05x3.175mm_L125.05mm_2xD6.5mm_P106mm
BB902: Busbar_Cu_19.05x3.175mm_L176.05mm_2xD6.5mm_P157mm
C201, C203, C204, C208, C303, C310, C601, C605, C606, C701, C705, C706, C801, C805, C806: 100nF; C_0603_1608Metric
C202, C210, C212, C213: 10nF; C_0603_1608Metric
C205, C206, C304, C305: 4.7uF; C_1210_3225Metric
C207, C217: 47uF; CP_Elec_6.3x7.7
C209, C301, C602, C702, C802: 1uF; C_1206_3216Metric
C211: 68nF; C_1206_3216Metric
C214, C215, C309, C317, C318, C401, C402, C403, C404, C406, C407, C408, C409, C410, C411, C412, C413, C414, C417, C418, C419, C420, C423, C502, C504, C507, C510, C513: 100nF; C_0402_1005Metric
C216, C511, C512, C607, C707, C807: 100nF; C_1206_3216Metric
C302, C421: 2.2uF; C_0603_1608Metric
C306, C415: 1uF; C_0603_1608Metric
C307, C308, C314, C315, C316: 22uF; C_1210_3225Metric
C311, C416, C505, C508: 10uF; C_1206_3216Metric
C319, C424, C425: 10pF; C_0402_1005Metric
C405: 4.7uF; C_0805_2012Metric
C422: 220nF; C_0402_1005Metric
C501, C503, C506, C509: 10nF; C_0402_1005Metric
C514: 100nF; C_0805_2012Metric
C603, C703, C803: 470nF; C_0603_1608Metric
C604, C704, C804: 4.7nF; C_0603_1608Metric
D201: XLD8A24CAHM3_A_I; D_DO-218AC
D501, D502, D503, D504: VETH100A1DD1HG3-08; Vishay_DFN1006-2B_1.0x0.6mm
FID901, FID902, FID903, FID904, FID905, FID906: Fiducial_1mm_Mask2mm
FL501: ACT1210E-241-2P-TL00; L_CommonModeChoke_TDK_ACT1210E_3.2x2.5mm
J401: FTSH-105-01-L-DV-K; Samtec_FTSH-105-01-x-DV_2x05_P1.27mm_Vertical_SMD
J901, J902, J910, J911: 74660016R; Wuerth_REDCUBE-SMT_WP-SMRT_74660016
J903, J912: ATM13-2P-BM04; Amphenol_ATM13-2P-BMxx_1x02_P4.20mm_Horizontal
J904, J905, J906, J907, J908, J909: AT13-2P-BM04; Amphenol_AT13-2P-BMxx_1x02_P5.40mm_Horizontal
K501: G6KU-2F-Y-T1-TRS_DC3; Relay_DPDT_Omron_G6K-2F-Y
L201, L301: 74438356022HT; L_Wuerth_MAPI-4020
L302: 744383560056HT; L_Wuerth_MAPI-4020
Q201, Q202, Q203, Q204: IAUTN08S5N012LATMA1; Infineon_PG-HSOF-8-2
Q501, Q502: DMC2710UVQ-7; Diodes_SOT-563
R201: BVR-Z-R0003-1.0; R_Shunt_Isabellenhuette_BVR4026
R202, R601, R701, R801: 10R; R_0402_1005Metric
R203, R211, R401, R402, R403, R404, R405, R505, R506, R507, R508, R509, R510, R511, R512, R513, R514, R515, R602, R603, R606, R702, R703, R706, R802, R803, R806: 10k; R_0402_1005Metric
R204: 107k; R_0603_1608Metric
R205: 2k; R_0603_1608Metric
R206: 7.87k; R_0603_1608Metric
R207: 2.1k; R_0603_1608Metric
R208: 26.7k; R_0402_1005Metric
R209: 49.9R; R_0603_1608Metric
R210: 383R; R_0402_1005Metric
R212, R607, R707, R807: 10k; R_0603_1608Metric
R301, R408: 0R; R_0402_1005Metric
R302, R303: 0R; R_0603_1608Metric
R304: 76.8k; R_0402_1005Metric
R305: 51k; R_0402_1005Metric
R306, R307, R521, R522: 100k; R_0402_1005Metric
R308, R604, R704, R804: 4.7k; R_0402_1005Metric
R406, R407: 2.2k; R_0402_1005Metric
R409, R410, R411, R412, R413, R414, R415, R416, R417, R418, R503, R504, R608, R708, R808: 33R; R_0402_1005Metric
R501: 12.4k; R_0402_1005Metric
R516, R518: 1.5k; R_1206_3216Metric
R517, R519: 49.9R; R_1206_3216Metric
R520: 100k; R_0805_2012Metric
R605, R705, R805: 698R; R_0603_1608Metric
RT201, RT601, RT701, RT801: NCU18XH103F6SRB; R_NTC_0603_1608Metric_Pad0.7x0.7mm
TP201, TP202, TP203, TP204, TP205, TP206, TP207, TP208, TP301, TP302, TP303, TP304, TP305, TP306, TP307, TP401, TP402, TP403, TP405, TP406, TP407, TP408, TP409, TP410, TP411, TP413, TP414, TP415, TP416, TP417, TP418, TP420, TP501, TP502, TP503, TP504, TP505, TP506, TP601, TP602, TP603, TP604, TP605, TP701, TP702, TP703, TP704, TP705, TP801, TP802, TP803, TP804, TP805: TestPoint_Pad_D1.0mm
TP209, TP308, TP412, TP507, TP606, TP706, TP806: S1751-46R; TestPoint_Harwin_S1751
U201: LM74910HQRGERQ1; Texas_RGE0024T_VQFN-24-1EP_4x4mm_P0.5mm_EP2.1x2.1mm
U202: INA228AQDGSRQ1; Texas_DGS0010A_TSSOP-10_3x3mm_P0.5mm
U203: TMP175AQDGKRQ1; Texas_DGK0008A_TSSOP-8_3x3mm_P0.65mm
U301: TPS7B8133QWDRVRQ1; Texas_DRV0006A_WSON-6-1EP_2x2mm_P0.65mm_EP1x1.6mm
U302: LMQ66430MC3RXBRQ1; Texas_RXB0014A_VQFN-14-1EP_2.6x2.6mm_P0.5mm_EP1x1mm
U303: TPS628502QDRLRQ1; Texas_DRL0008A_SOT-583-8
U304: TPS3702AX33QDDCRQ1; Texas_DDC0006A_TSOT-23-6
U401: S32K344EHT1MMMST; NXP_LFBGA-257_14x14mm_Layout17x17_P0.8mm
U402: IS25LP032D-JNLA3; SOIC-8_3.9x4.9mm_P1.27mm
U501: LAN8670D0-E_LMXVAO; Microchip_LMX_VQFN-32-1EP_5x5mm_P0.5mm_EP3.5x3.5mm
U601, U701, U801: TPS2HCS08AQPWPRQ1; HTSSOP-16-1EP_4.4x5mm_P0.65mm_EP3.4x5mm_Mask2.78x3.313mm
Y401: ABM8AIG-16.000MHZ-8-1Z-T; Crystal_SMD_NDK_NX3225SA-4Pin_3.2x2.5mm
Y501: ECS-3225SMVQ-500-DS-TR; Oscillator_SMD_ECS_LGA-4_2.5x3.2mm_P2.3mm

Connections:
1V5_CORE: C401.1, C402.1, C403.1, C404.1, C405.1, R303.2, TP303.1, U401.H8, U401.H10, U401.K8, U401.K10
3V3_MAIN: C214.1, C215.1, C310.1, C311.1, C318.1, C406.1, C407.1, C408.1, C409.1, C410.1, C411.1, C412.1, C413.1, C414.1, C415.1, C416.1, C423.1, C501.1, C502.1, C503.1, C504.1, C505.1, C506.1, C507.1, C508.1, C513.1, J401.1, Q501.4, Q502.4, R203.1, R211.1, R212.1, R302.2, R306.1, R308.1, R401.1, R402.1, R403.1, R404.1, R406.1, R407.1, R505.1, R506.1, R507.1, R508.1, R601.1, R607.1, R701.1, R707.1, R801.1, R807.1, TP302.1, U202.6, U203.8, U303.1, U303.3, U303.4, U304.3, U304.5, U401.D14, U401.G10, U401.H6, U401.H7, U401.K11, U401.L8, U401.N4, U401.R7, U401.R10, U402.8, U501.8, U501.18, U501.29, Y501.1, Y501.4
/BATT_MON: C210.1, R205.2, R206.1, TP206.1, U401.B1
/I2C0_TELEMETRY_SCL: R406.2, TP409.1, U202.5, U203.2, U401.M4
/I2C0_TELEMETRY_SDA: R407.2, TP410.1, U202.4, U203.1, U401.P5
/INH: R515.1, TP208.1, TP305.1, TP501.1, U201.7, U302.1, U501.1
/LM_FLT_L: R203.2, TP207.1, U201.12, U401.B11
/MCU and NVM/1V1_MCU_V11: C417.1, C418.1, C419.1, C420.1, C421.1, TP411.1, U401.H9, U401.J8, U401.J10, U401.K9
/MCU and NVM/2V5_MCU_V25: C422.1, U401.J7
/MCU and NVM/FLASH_HOLD_L: R403.2, U402.7
/MCU and NVM/FLASH_WP_L: R402.2, U402.3
/MCU and NVM/FXOSC_EXTAL: C424.1, U401.K1, Y401.1
/MCU and NVM/FXOSC_XTAL: R408.1, U401.L1
/MCU and NVM/FXOSC_XTAL_X: C425.1, R408.2, Y401.3
/MCU and NVM/SPI2_FLASH_CS_L: R401.2, TP408.1, U401.E1, U402.1
/MCU and NVM/SPI2_FLASH_MISO: U401.C2, U402.2
/MCU and NVM/SPI2_FLASH_MOSI: U401.C6, U402.5
/MCU and NVM/SPI2_FLASH_SCK: R418.2, TP407.1, U402.6
/MCU and NVM/SPI2_FLASH_SCK_MCU: R418.1, U401.D2
/MCU and NVM/SPI3_SWITCH3_CS_L_MCU: R417.1, U401.G15
/MCU and NVM/SPI3_SWITCH3_MOSI_MCU: R416.1, U401.F14
/MCU and NVM/SPI3_SWITCH3_SCK_MCU: R415.1, U401.E14
/MCU and NVM/SPI4_SWITCH1_CS_L_MCU: R411.1, U401.A14
/MCU and NVM/SPI4_SWITCH1_MOSI_MCU: R410.1, U401.C15
/MCU and NVM/SPI4_SWITCH1_SCK_MCU: R409.1, U401.D15
/MCU and NVM/SPI5_SWITCH2_CS_L_MCU: R414.1, U401.G16
/MCU and NVM/SPI5_SWITCH2_MOSI_MCU: R413.1, U401.A15
/MCU and NVM/SPI5_SWITCH2_SCK_MCU: R412.1, U401.A16
/MCU and NVM/SWD_CLK: J401.4, R405.1, U401.F7
/MCU and NVM/SWD_DIO: J401.2, R404.2, U401.F6
/MCU and NVM/SWD_SWO: J401.6, U401.G8
/MCU and NVM/UART0_DEBUG_RX: TP402.1, U401.D17
/MCU and NVM/UART0_DEBUG_TX: TP401.1, U401.E16
/MDIO0_T1S_MDC: TP503.1, U401.N3, U501.13
/MDIO0_T1S_MDIO: R507.2, TP504.1, U401.P2, U501.14
/NTC_RSENSE: C216.1, R212.2, RT201.1, U401.C1
/NTC_SW1: C607.1, R607.2, RT601.1, U401.E4
/NTC_SW2: C707.1, R707.2, RT701.1, U401.F9
/NTC_SW3: C807.1, R807.2, RT801.1, U401.B9
/OUT1: C606.1, J904.1, TP604.1, U601.9, U601.10, U601.11
/OUT2: C605.1, J905.1, TP605.1, U601.6, U601.7, U601.8
/OUT3: C706.1, J906.1, TP704.1, U701.9, U701.10, U701.11
/OUT4: C705.1, J907.1, TP705.1, U701.6, U701.7, U701.8
/OUT5: C806.1, J908.1, TP804.1, U801.9, U801.10, U801.11
/OUT6: C805.1, J909.1, TP805.1, U801.6, U801.7, U801.8
/Outputs 1-2/SW_DI: R602.1, U601.4
/Outputs 1-2/SW_SDO: R608.1, U601.14
/Outputs 1-2/SW_SNS: C604.1, R605.1, R606.1, U601.2
/Outputs 1-2/SW_VDD: C603.1, R601.2, R604.2, U601.3
/Outputs 3-4/SW_DI: R702.1, U701.4
/Outputs 3-4/SW_SDO: R708.1, U701.14
/Outputs 3-4/SW_SNS: C704.1, R705.1, R706.1, U701.2
/Outputs 3-4/SW_VDD: C703.1, R701.2, R704.2, U701.3
/Outputs 5-6/SW_DI: R802.1, U801.4
/Outputs 5-6/SW_SDO: R808.1, U801.14
/Outputs 5-6/SW_SNS: C804.1, R805.1, R806.1, U801.2
/Outputs 5-6/SW_VDD: C803.1, R801.2, R804.2, U801.3
/Power entry/DGATE: Q201.1, Q201.2, Q202.1, Q202.2, U201.1
/Power entry/HGATE: R202.2, U201.14
/Power entry/HGATE_G: C202.1, Q203.1, Q203.2, Q204.1, Q204.2, R202.1
/Power entry/LM_CAP: C209.2, U201.23
/Power entry/LM_CSP: C212.2, R209.2, U201.20
/Power entry/LM_ILIM: R208.1, U201.11
/Power entry/LM_ISCP: C213.1, R210.2, U201.18
/Power entry/LM_OV: R206.2, R207.1, U201.5
/Power entry/LM_SW: R204.1, U201.3
/Power entry/LM_TMR: C211.1, U201.9
/Power entry/LM_UVLO: R204.2, R205.1, U201.4
/Power entry/RS_SENSE_N: C212.1, C213.2, R201.3, U201.19, U202.9
/Power entry/RS_SENSE_P: R201.2, R209.1, R210.1, U202.10
/Power entry/VBAT_D: C208.1, C209.1, Q201.9, Q202.9, R201.1, TP202.1, U201.6, U201.22, U201.24
/Power entry/VBAT_Q2D: Q203.9, Q204.9, R201.4, TP203.1
/RESET_L: J401.10, R308.2, TP307.1, TP506.1, U304.1, U304.6, U401.A3, U501.10
/RMII0_T1S_CRS_DV: R509.1, U401.R6, U501.20
/RMII0_T1S_REF_CLK: R504.2, TP505.1, U401.U6
/RMII0_T1S_RXD0: R510.1, U401.T8, U501.16
/RMII0_T1S_RXD1: R511.1, U401.U7, U501.19
/RMII0_T1S_RX_ER: R505.2, U401.P6, U501.21
/RMII0_T1S_TXD0: U401.U4, U501.6
/RMII0_T1S_TXD1: U401.T4, U501.5
/RMII0_T1S_TX_EN: R514.1, U401.R5, U501.7
/Regulators/1V5_CORE_FB: C319.2, R304.2, R305.1, U303.5
/Regulators/1V5_CORE_REG: C314.1, C315.1, C316.1, C317.1, C319.1, L302.2, R303.1, R304.1
/Regulators/1V5_CORE_SW: L302.1, U303.7
/Regulators/1V5_EN: R306.2, R307.1, TP306.1, U303.2
/Regulators/3V3_MAIN_REG: C307.1, C308.1, C309.1, L301.2, R302.1, U302.11
/Regulators/3V3_MAIN_SW: L301.1, U302.7
/Regulators/3V3_MAIN_VCC: C306.1, U302.10
/Regulators/VDDAU_AON_REG: C302.1, R301.1, U301.6
/SPI3_SWITCH3_CS_L: R417.2, TP420.1, U801.15
/SPI3_SWITCH3_MISO: R808.2, TP803.1, U401.E15
/SPI3_SWITCH3_MOSI: R416.2, TP418.1, U801.13
/SPI3_SWITCH3_SCK: R415.2, TP417.1, U801.16
/SPI4_SWITCH1_CS_L: R411.2, TP406.1, U601.15
/SPI4_SWITCH1_MISO: R608.2, TP405.1, TP603.1, U401.C17
/SPI4_SWITCH1_MOSI: R410.2, U601.13
/SPI4_SWITCH1_SCK: R409.2, TP403.1, U601.16
/SPI5_SWITCH2_CS_L: R414.2, TP416.1, U701.15
/SPI5_SWITCH2_MISO: R708.2, TP415.1, TP703.1, U401.B13
/SPI5_SWITCH2_MOSI: R413.2, TP414.1, U701.13
/SPI5_SWITCH2_SCK: R412.2, TP413.1, U701.16
/SW1_FLT_L: R604.1, TP602.1, U401.B5, U601.12
/SW1_SNS: R606.2, TP601.1, U401.A7
/SW2_FLT_L: R704.1, TP702.1, U401.A5, U701.12
/SW2_SNS: R706.2, TP701.1, U401.A9
/SW3_FLT_L: R804.1, TP802.1, U401.B10, U801.12
/SW3_SNS: R806.2, TP801.1, U401.A10
/SW_LHI: R603.1, R703.1, R803.1, U401.G6, U601.5, U701.5, U801.5
/T1S/T1S_CMC_N: C512.1, FL501.4
/T1S/T1S_CMC_P: C511.1, FL501.3
/T1S/T1S_MODE0: R513.1, U501.23
/T1S/T1S_MODE1: R506.2, U501.24
/T1S/T1S_N_DROP: K501.2, R516.2
/T1S/T1S_N_END: K501.4, R517.2
/T1S/T1S_OSC_OUT: R503.1, R504.1, Y501.3
/T1S/T1S_PHYAD4: R512.1, U501.15
/T1S/T1S_PHY_N: FL501.1, U501.31
/T1S/T1S_PHY_P: FL501.2, U501.30
/T1S/T1S_P_DROP: K501.7, R518.2
/T1S/T1S_P_END: K501.5, R519.2
/T1S/T1S_RBIAS: R501.1, U501.26
/T1S/T1S_REFCLK: R503.2, U501.27
/T1S/T1S_TERM_COIL_R: K501.8, Q501.3, Q501.6
/T1S/T1S_TERM_COIL_S: K501.1, Q502.3, Q502.6
/T1S/T1S_TERM_CT: C514.1, R516.1, R517.1, R518.1, R519.1, R520.1
/T1S_IRQ_L: R508.2, TP502.1, U401.B3, U501.22
/T1S_N: C512.2, D502.2, D504.2, J903.2, J912.2, K501.3
/T1S_P: C511.2, D501.2, D503.2, J903.1, J912.1, K501.6
/T1S_TERM_DROP: Q502.2, Q502.5, R521.1, U401.E3
/T1S_TERM_END: Q501.2, Q501.5, R522.1, U401.F3
/TMP175_ALERT_L: R211.2, U203.3, U401.A11
/VBAT_IN: BB901.1, BB901.2, C201.1, D201.2, J901.1, J910.1, Q201.3, Q201.4, Q201.5, Q201.6, Q201.7, Q201.8, Q202.3, Q202.4, Q202.5, Q202.6, Q202.7, Q202.8, TP201.1, U201.2
GND: BB902.1, BB902.2, C201.2, C202.2, C203.2, C204.2, C205.2, C206.2, C207.2, C208.2, C210.2, C211.2, C214.2, C215.2, C216.2, C217.2, C301.2, C302.2, C303.2, C304.2, C305.2, C306.2, C307.2, C308.2, C309.2, C310.2, C311.2, C314.2, C315.2, C316.2, C317.2, C318.2, C401.2, C402.2, C403.2, C404.2, C405.2, C406.2, C407.2, C408.2, C409.2, C410.2, C411.2, C412.2, C413.2, C414.2, C415.2, C416.2, C417.2, C418.2, C419.2, C420.2, C421.2, C422.2, C423.2, C424.2, C425.2, C501.2, C502.2, C503.2, C504.2, C505.2, C506.2, C507.2, C508.2, C509.2, C510.2, C513.2, C514.2, C601.2, C602.2, C603.2, C604.2, C605.2, C606.2, C607.2, C701.2, C702.2, C703.2, C704.2, C705.2, C706.2, C707.2, C801.2, C802.2, C803.2, C804.2, C805.2, C806.2, C807.2, D201.1, D501.1, D502.1, D503.1, D504.1, J401.3, J401.5, J401.9, J902.1, J904.2, J905.2, J906.2, J907.2, J908.2, J909.2, J911.1, Q501.1, Q502.1, R207.2, R208.2, R305.2, R307.2, R405.2, R501.2, R509.2, R510.2, R511.2, R512.2, R513.2, R514.2, R515.2, R520.2, R521.2, R522.2, R602.2, R603.2, R605.2, R702.2, R703.2, R705.2, R802.2, R803.2, R805.2, RT201.2, RT601.2, RT701.2, RT801.2, TP209.1, TP308.1, TP412.1, TP507.1, TP606.1, TP706.1, TP806.1, U201.13, U202.1, U202.2, U202.7, U203.4, U203.5, U203.6, U203.7, U301.3, U301.4, U301.7, U302.6, U302.13, U302.15, U303.8, U304.2, U304.4, U401.B2, U401.B16, U401.D4, U401.D9, U401.G7, U401.G11, U401.J1, U401.J4, U401.J6, U401.J9, U401.J14, U401.L7, U401.L11, U401.P4, U401.P14, U401.T2, U401.T7, U401.T10, U401.T16, U402.4, U501.11, U501.32, U501.33, U601.1, U701.1, U801.1, Y401.2, Y401.4, Y501.2
VBAT_FILT: C206.1, C207.1, C217.1, C303.1, C304.1, C305.1, L201.2, TP205.1, TP304.1, U302.3
VBAT_PROT: C203.1, C204.1, C205.1, C301.1, C601.1, C602.1, C701.1, C702.1, C801.1, C802.1, L201.1, Q203.3, Q203.4, Q203.5, Q203.6, Q203.7, Q203.8, Q204.3, Q204.4, Q204.5, Q204.6, Q204.7, Q204.8, TP204.1, U201.15, U201.16, U202.8, U301.1, U301.2, U601.17, U701.17, U801.17
VDDAU_AON: C509.1, C510.1, R301.2, TP301.1, U501.25
