karlTbowers/node60-hw/docs/src/data/parts.yaml

# Node60 component baseline, Architecture Rev A.
# id is the orderable MPN, the part family where the exact orderable code is still open,
# or TBD-… where no part is chosen yet (mpn: null in both of those cases).
# Prices and stock are dated observations (2026-10-13), not quotations: re-check at purchase.
# status: locked / plan-of-record / selected / alternative / future / open
# library: DropOut_<Lib>:<Symbol> once the part exists in lib/dropout-kicad-library (none yet).

- id: S32K344EHT1MMMST
  mpn: S32K344EHT1MMMST
  manufacturer: NXP
  qty: 1
  function: Grade 1 MCU, 257 MAPBGA
  subsystem: compute
  status: locked
  decision_note: Locked; ball map and pin functions verified 2026-10-28, re-run for the DEC-018 SPI balls 2026-10-30 (GATE-MCU-01)
  observations:
    - { date: 2026-10-13, source: DigiKey, prices: [{ qty: "1", usd: 23.17 }], stock: 760 }
  decisions: [DEC-018, DEC-019]

- id: LAN8670D0-E/LMXVAO
  mpn: LAN8670D0-E/LMXVAO
  manufacturer: Microchip
  qty: 1
  function: Automotive 10BASE-T1S PHY
  subsystem: network
  status: locked
  decision_note: Locked; highest procurement risk
  supply_note: 11–20 week leads
  observations:
    - { date: 2026-10-13, source: distributors, prices: [{ qty: tray class, usd: 2.80 }], stock: 0 }
  decisions: [DEC-007]

- id: LAN8670D0T-E/LMX
  mpn: LAN8670D0T-E/LMX
  manufacturer: Microchip
  qty: 0
  function: 10BASE-T1S PHY, same die and package, non-automotive code
  subsystem: network
  status: alternative
  decision_note: Prototype stand-in for LAN8670D0-E/LMXVAO; Microchip designates only the Vxx code automotive (datasheet DS60001573K ordering guide)
  observations:
    - { date: 2026-10-22, source: Microchip Direct, stock: 1549 }
  decisions: [DEC-007]

- id: ACT1210E-241-2P-TL00
  mpn: ACT1210E-241-2P-TL00
  manufacturer: TDK
  qty: 1
  function: 10BASE-T1S common mode choke, 240 µH, AEC-Q200, 3.2 × 2.5 mm
  subsystem: network
  status: selected
  decision_note: "Selected T1S line choke; matches the OPEN Alliance 200 µH Class III example. Confirm its CMC class with TDK's test report"
  observations:
    - { date: 2026-10-22, source: DigiKey, prices: [{ qty: "1", usd: 1.89 }, { qty: 1k, usd: 1.12 }], stock: 42488 }
    - { date: 2026-10-22, source: Mouser, prices: [{ qty: "1", usd: 1.88 }], stock: 0, note: 70-day lead }
  second_source: DLW32MH241MX2L
  decisions: [DEC-012]

- id: ACT1210E-131-2P-TL00
  mpn: ACT1210E-131-2P-TL00
  manufacturer: TDK
  qty: 0
  function: 10BASE-T1S common mode choke, 130 µH, OPEN Alliance Class IV (TDK), AEC-Q200
  subsystem: network
  status: alternative
  decision_note: Lower-capacitance alternate on the same footprint, for more nodes or longer segments
  observations:
    - { date: 2026-10-22, source: DigiKey, prices: [{ qty: "1", usd: 1.92 }], stock: 494 }
    - { date: 2026-10-22, source: Mouser, prices: [{ qty: "1", usd: 1.92 }], stock: 9516 }
  decisions: [DEC-012]

- id: DLW32MH241MX2L
  mpn: DLW32MH241MX2L
  manufacturer: Murata
  qty: 0
  function: 10BASE-T1S common mode choke, 240 µH, CMC Class 3, AEC-Q200
  subsystem: network
  status: alternative
  decision_note: Second source for ACT1210E-241; same land pattern, different pad numbering and footprint
  supply_note: Released July 2026; not stocked at DigiKey or Mouser on 2026-10-22
  decisions: [DEC-012]

- id: VETH100A1DD1HG3-08
  mpn: VETH100A1DD1HG3-08
  manufacturer: Vishay
  qty: 4
  function: OPEN Alliance 10BASE-T1S ESD diode, ≤2.0 pF, 24 V working, AEC-Q101, DFN1006-2B
  subsystem: network
  status: selected
  decision_note: "One per T1S line at each T1S connector, right at its pins: D501/D502 at J903, D503/D504 at J912 (decision D16-2, 2026-11-03; DEC-012 rev. C). The two pairs add at most 2.0 pF across the line, within the OPEN Alliance CMDI ≤ 25 pF node budget"
  observations:
    - { date: 2026-10-22, source: DigiKey, prices: [{ qty: "1", usd: 0.48 }], stock: 15582 }
    - { date: 2026-10-22, source: Mouser, prices: [{ qty: "1", usd: 0.48 }, { qty: 1k, usd: 0.13 }], stock: 30510 }
  second_source: PESD1ETH10LS-QYL
  decisions: [DEC-012]

- id: PESD1ETH10LS-QYL
  mpn: PESD1ETH10LS-QYL
  manufacturer: Nexperia
  qty: 0
  function: OPEN Alliance 10BASE-T1S ESD diode, 0.4 pF, 75 V standoff, AEC-Q101, DFN1006BD-2 side-wettable
  subsystem: network
  status: alternative
  decision_note: Electrically better alternate (capacitance, standoff); different footprint
  supply_note: No distributor stock; Mouser 365-day lead (2026-10-22)
  observations:
    - { date: 2026-10-22, source: Mouser, prices: [{ qty: "1", usd: 0.66 }, { qty: 1k, usd: 0.165 }], stock: 0 }
  decisions: [DEC-012]

- id: PESD1ETH10L-QYL
  mpn: PESD1ETH10L-QYL
  manufacturer: Nexperia
  qty: 0
  function: OPEN Alliance 10BASE-T1S ESD diode, 0.4 pF, 75 V standoff, AEC-Q101, DFN1006-2
  subsystem: network
  status: alternative
  decision_note: Same die as PESD1ETH10LS-Q without wettable flanks; different footprint
  supply_note: No distributor stock (2026-10-22)
  observations:
    - { date: 2026-10-22, source: Mouser, prices: [{ qty: "1", usd: 0.60 }, { qty: 1k, usd: 0.154 }], stock: 0 }
  decisions: [DEC-012]

- id: LMQ66430MC3RXBRQ1
  mpn: LMQ66430MC3RXBRQ1
  manufacturer: Texas Instruments
  qty: 1
  function: INH-gated 3.3 V low-Iq buck (3V3_MAIN); until DEC-026 also the 1.5 V buck
  subsystem: power
  status: selected
  decision_note: "Selected discrete power tree. Direct INH enable plus EN-pin chaining; no FS26. MC3 variant (2.2 MHz, fixed 3.3 V or adjustable) chosen 2026-10-22; the earlier code LMQ66430QMC5RXBRQ1 does not exist. The 1.5 V buck became a TPS628502-Q1 on 3V3_MAIN on 2026-11-02 (DEC-026): from the battery the LMQ66430 folds back into the AM band"
  supply_note: Not verified
  decisions: [DEC-004, DEC-026]

- id: TPS628502QDRLRQ1
  mpn: TPS628502QDRLRQ1
  manufacturer: Texas Instruments
  qty: 1
  label: TPS628502-Q1 automotive 2 A buck
  function: 1.5 V MCU core rail (1V5_CORE) from 3V3_MAIN, fixed 2.25 MHz with spread spectrum, forced PWM
  subsystem: power
  status: selected
  decision_note: "Selected 2026-11-02 (user, DEC-026). 2.7–6 V in, 2 A, AEC-Q100 Grade 1, TJ to 150 °C, SOT-583 (data sheet SLUSDM0N, January 2026). Holds 2.25 MHz at 3.3 V in (duty about 45 %). Rejected: TPS628122GQWRWYRQ1 (fixed 1.5 V; full reels only at DigiKey), MAX20004E (3.5 V minimum input), TPS62903-Q1 (3.0 V minimum input, no stock), MPQ2143-AEC1 (not for new designs)"
  second_source: TPS628503QDRLRQ1
  observations:
    - { date: 2026-11-02, source: DigiKey, prices: [{ qty: "1", usd: 2.06 }], stock: 7465 }
    - { date: 2026-11-02, source: Mouser, stock: 3466 }
  decisions: [DEC-026]

- id: TPS628503QDRLRQ1
  mpn: TPS628503QDRLRQ1
  manufacturer: Texas Instruments
  qty: 0
  function: 3 A version of the 1.5 V core buck; same SOT-583 pinout and data sheet as TPS628502QDRLRQ1
  subsystem: power
  status: alternative
  decision_note: "Second source in the same family (DEC-026, 2026-11-02): pin-compatible, same compensation and frequency settings (SLUSDM0N Table 8-1). No other maker's drop-in found"
  observations:
    - { date: 2026-11-02, source: DigiKey, stock: 13283 }
    - { date: 2026-11-02, source: Mouser, stock: 4733 }
  decisions: [DEC-026]

- id: GYF1H470MCQ1GS
  mpn: GYF1H470MCQ1GS
  manufacturer: Nichicon
  qty: 1
  label: GYF1H470MCQ1GS (47 µF 50 V hybrid polymer)
  function: "VBAT_FILT damping capacitor C207 for the L201 EMI filter (U302's input); C217 beside it is the same part, not fitted (DNP), for bench tuning"
  subsystem: power
  status: selected
  decision_note: "Selected 2026-11-03 (user, decision page). Hybrid polymer aluminium, 47 µF ±20 %, 50 V, ESR 40 mΩ, 4000 h at 125 °C, AEC-Q200, 6.3 × 7.7 mm can (8.0 mm max), so it goes on the top side under the 9.0 mm low lid: no 47 µF / ≥ 50 V / 125 °C electrolytic fits under the board (6.17 mm). Damping per TI AN-2162: Cd ≥ 4 × CIN (about 12 µF effective), filter peak 0.66 Ω with 2.2 µH against U302's 3.1 Ω worst input impedance (3 A out, 6 V in). 50 V = 1.47 × the 34 V OV cut-off (AN-2162 asks ≥ 1.25 ×). C217 (DNP, same footprint CP_Elec_6.3x7.7) takes a second 47 µF or, with C207, 2 × 22 µF. Rejected: UCZ1H470MCS6GS (plain aluminium; ESR 0.5 Ω rises to 5 Ω at −40 °C, filter peak 2.5 Ω), T598X156M063ATE075 × 3 (fits the bottom side, 4.3 mm, but about $17), every 35 V polymer tantalum and T598D106M050 (below 34 V at 125 °C), a ceramic bank (no ESR to damp; would need a series resistor)"
  second_source: HHXC500ARA220MF61G
  observations:
    - { date: 2026-11-03, source: DigiKey GYF1H470MCQ1GCT-ND, prices: [{ qty: "1", usd: 1.40 }], stock: 10450 }
    - { date: 2026-11-03, source: Mouser 647-GYF1H470MCQ1GS, stock: 392 }
  library: DropOut_Capacitor:GYF1H470MCQ1GS

- id: HHXC500ARA220MF61G
  mpn: HHXC500ARA220MF61G
  manufacturer: Chemi-Con
  qty: 0
  label: HHXC500ARA220MF61G (22 µF 50 V hybrid polymer)
  function: "2 × 22 µF alternative to the 47 µF C207, fitted on C207 and C217 (6.3 × 5.8 mm can, 6.1 mm max, same land)"
  subsystem: power
  status: alternative
  decision_note: "Candidate 2026-11-03 (user's 2 × 22 µF request): ESR 80 mΩ each, two give 44 µF / 40 mΩ, the same damping as one GYF1H470MCQ1GS. Also the fallback if Nichicon's 47 µF is short: no other maker's 47 µF / 50 V / 125 °C hybrid in a 6.3 mm can was found"
  second_source: EEH-ZC1H220P
  observations:
    - { date: 2026-11-03, source: DigiKey 565-4782-1-ND, prices: [{ qty: "1", usd: 0.82 }], stock: 52115 }
    - { date: 2026-11-03, source: Mouser 661-HHXC500A220MF61G, stock: 921 }
  library: DropOut_Capacitor:HHXC500ARA220MF61G

- id: EEH-ZC1H220P
  mpn: EEH-ZC1H220P
  manufacturer: Panasonic
  qty: 0
  label: EEH-ZC1H220P (22 µF 50 V hybrid polymer)
  function: Second source for HHXC500ARA220MF61G (2 × 22 µF option on C207/C217)
  subsystem: power
  status: alternative
  decision_note: "Candidate 2026-11-03: Panasonic ZC, 22 µF 50 V, ESR 80 mΩ, 4000 h at 125 °C, 6.3 × 5.8 mm"
  observations:
    - { date: 2026-11-03, source: DigiKey P15463CT-ND, prices: [{ qty: "1", usd: 0.89 }], stock: 8772 }
    - { date: 2026-11-03, source: Mouser 667-EEH-ZC1H220P, stock: 1050 }
  library: DropOut_Capacitor:EEH-ZC1H220P

- id: 74438356022HT
  mpn: 74438356022HT
  manufacturer: Würth Elektronik
  qty: 2
  label: 74438356022HT (WE-MAPI 4020 HT, 2.2 µH)
  function: "EMI filter inductor L201 (VBAT_PROT to VBAT_FILT); the same part is U302's buck inductor L301"
  subsystem: power
  status: selected
  decision_note: "L201 selected 2026-11-03 (user, decision page). 2.2 µH ±20 %, Isat 3.7 A (−10 %), IRP 5.9 A, DCR 32.2 mΩ, AEC-Q200, −55 to +150 °C, 4.1 × 4.1 × 2.1 mm, bottom side. Starting value: TI AN-2162 puts the filter inductor at 1–10 µH; with about 9 µF on VBAT_PROT the LC attenuates the 2.2 MHz fundamental by 72 dB, resonance 31 kHz. Current: 2.1 A worst case (U302 at its 3 A rating at the 5.47 V UVLO floor; no 3V3_MAIN load budget exists yet). The value follows the emissions test: 74438356010HT (1.0 µH, in the library) and 74438356047HT (4.7 µH) fit the same footprint L_Wuerth_MAPI-4020. TI's own filter (SNVSBV1F Fig. 8-25) uses a ferrite bead, which has less inductance at 2.2 MHz"
  second_source: VCHA042A-2R2MS6
  observations:
    - { date: 2026-11-03, source: DigiKey 732-74438356022HTCT-ND, prices: [{ qty: "1", usd: 2.09 }], stock: 2844 }
    - { date: 2026-11-03, source: Mouser 710-74438356022HT, stock: 900 }
  library: DropOut_Inductor:74438356022HT

- id: VCHA042A-2R2MS6
  mpn: VCHA042A-2R2MS6
  manufacturer: Cyntec
  qty: 0
  label: VCHA042A-2R2MS6 (2.2 µH)
  function: Alternate L201 (EMI filter inductor); needs its own footprint L_Cyntec_VCHA042A
  subsystem: power
  status: alternative
  decision_note: "Candidate 2026-11-03: 2.2 µH, DCR 23.0 mΩ, Isat 4.5 A (−30 %), Idc 5.3 A, −55 to +165 °C, AEC-Q200, 4.2 × 4.0 × 2.1 mm; deep DigiKey stock, thin at Mouser"
  observations:
    - { date: 2026-11-03, source: DigiKey 2037-VCHA042A-2R2MS6CT-ND, prices: [{ qty: "1", usd: 1.43 }], stock: 35362 }
    - { date: 2026-11-03, source: Mouser 108-VCHA042A-2R2MS6, stock: 8 }
  library: DropOut_Inductor:VCHA042A-2R2MS6

- id: SRP4020FA-2R2M
  mpn: SRP4020FA-2R2M
  manufacturer: Bourns
  qty: 0
  label: SRP4020FA-2R2M (2.2 µH)
  function: Alternate L201 (EMI filter inductor); needs its own footprint L_Bourns_SRP4020FA
  subsystem: power
  status: alternative
  decision_note: "Candidate 2026-11-03: 2.2 µH, DCR 23.5 mΩ, Isat 3.8 A (−20 %), Irms 8.0 A, −55 to +155 °C, AEC-Q200, 4.1 × 4.1 × 2.1 mm; cheapest, stocked at both distributors"
  observations:
    - { date: 2026-11-03, source: DigiKey SRP4020FA-2R2MCT-ND, prices: [{ qty: "1", usd: 1.17 }], stock: 4618 }
    - { date: 2026-11-03, source: Mouser 652-SRP4020FA-2R2M, stock: 1519 }
  library: DropOut_Inductor:SRP4020FA-2R2M

- id: TBD-VDDAU-LDO
  mpn: TPS7B8133QWDRVRQ1
  manufacturer: Texas Instruments
  qty: 1
  label: TPS7B8133-Q1 nanopower automotive LDO
  function: Always-on LAN8670 VDDAU supply, 3.3 V fixed, 40 V input
  subsystem: power
  status: selected
  decision_note: "Selected 2026-10-22 (user). 40 V, 150 mA, Iq 3.5 µA (DigiKey listing): no candidate met the 1–2 µA target at 40 V. WSON 2 × 2 with wettable flanks, TJ to 150 °C. Rejected: NCV8730BMTW330TBG (3 µA, but 38 V max leaves 4 V above the 34 V OV cut-off). Verify Iq over temperature from the datasheet"
  second_source: NCV8730BMTW330TBG
  observations:
    - { date: 2026-10-22, source: DigiKey, prices: [{ qty: "1", usd: 1.56 }], stock: 2080 }
  decisions: [DEC-004]
  library: DropOut_Power:TPS7B8133QWDRVRQ1

- id: LM74910HQRGERQ1
  mpn: LM74910HQRGERQ1
  manufacturer: Texas Instruments
  qty: 1
  function: Grade 1 ideal-diode / reverse-battery / OCP / SCP controller; VQFN-24, 4 × 4 mm
  subsystem: power
  status: plan-of-record
  decision_note: "Plan of record. 75 A breaker, 80 A fast trip, SLEEP auto-retry, FLT to MCU"
  supply_note: 26-week manufacturer lead if depleted
  observations:
    - { date: 2026-10-13, source: DigiKey, prices: [{ qty: "1", usd: 5.65 }, { qty: 1k, usd: 3.26 }], stock: 773 }
  decisions: [DEC-001]

- id: BVR-Z-R0003-1.0
  mpn: BVR-Z-R0003-1.0
  manufacturer: Isabellenhütte
  qty: 1
  label: 0.3 mΩ 4-terminal RSENSE (BVR-Z-R0003-1.0)
  function: Shared LM74910H protection and INA228 total-current sense, 4-terminal (Kelvin), 4026
  subsystem: power
  status: selected
  decision_note: "Selected 2026-11-03 (user, decision D14-1 A), replacing CSS2725FTL250. 0.3 mΩ ±1 %, ISA-WELD ZERANIN, TCR 0 ±20 ppm/K, 11 W at 70 °C / 5 W above 100 °C terminal temperature, AEC-Q200, −65…+170 °C, 10.1 × 6.6 mm, 3.45 mm tall. Pads 1 F1 = VBAT_D, 2 S1 = RS_SENSE_P, 3 S2 = RS_SENSE_N, 4 F2 = VBAT_Q2D. 18 mV / 1.08 W at 60 A. With it R(ILIM) = 26.7 kΩ (74.8 A breaker) and RISCP = 383 Ω (80 A fast trip, 71.4–92 A); INA228 SHUNT_CAL 4096 (DEC-001, DEC-002). Alternates: WSLP4026L2000FEA, BVB-Z-R0003-1.0"
  supply_note: DigiKey only; Mouser does not list it
  second_source: BVB-Z-R0003-1.0
  observations:
    - { date: 2026-11-03, source: DigiKey, prices: [{ qty: "1", usd: 5.20 }, { qty: 1400 reel, usd: 1.92 }], stock: 5311 }
  decisions: [DEC-001, DEC-002]
  library: DropOut_Resistor:BVR-Z-R0003-1.0

- id: CSS2725FTL250
  mpn: CSS2725FTL250
  manufacturer: Stackpole Electronics
  qty: 0
  function: 0.25 mΩ 1 % 2-terminal RSENSE, 4 W, ±50 ppm/°C, 2725 (rev. A's R201)
  subsystem: power
  status: alternative
  decision_note: "Rev. A's RSENSE, selected 2026-10-22, replaced 2026-11-03 (D14-1) by the 4-terminal BVR-Z-R0003-1.0: a 2-terminal shunt leaves the Kelvin taps to where the layout lands them on the pads, and no 0.25 mΩ 4-terminal code exists. Kept in the library"
  observations:
    - { date: 2026-10-22, source: DigiKey, prices: [{ qty: "1", usd: 1.70 }], stock: 519 }
  decisions: [DEC-001]
  library: DropOut_Resistor:CSS2725FTL250

- id: BVB-Z-R0003-1.0
  mpn: BVB-Z-R0003-1.0
  manufacturer: Isabellenhütte
  qty: 0
  function: 0.3 mΩ 1 % 4-terminal RSENSE alternative, ISA-WELD, 2725 (6.9 × 6.6 mm)
  subsystem: power
  status: alternative
  decision_note: "Alternate to BVR-Z-R0003-1.0 (D14-1, 2026-11-03): same value and construction in the smaller 2725 body, so the same thresholds; different footprint (R_Shunt_Isabellenhuette_BVB2725). Built in the library"
  observations:
    - { date: 2026-11-03, source: DigiKey, prices: [{ qty: "1", usd: 4.78 }, { qty: 1400 reel, usd: 1.75 }], stock: 4168 }
  library: DropOut_Resistor:BVB-Z-R0003-1.0

- id: WSLP4026L2000FEA
  mpn: WSLP4026L2000FEA
  manufacturer: Vishay Dale
  qty: 0
  function: 0.2 mΩ 1 % RSENSE alternative, Power Metal Strip, 12 W, 4026
  subsystem: power
  status: alternative
  decision_note: "Alternate from the D14-1 shunt search (2026-11-03), not a drop-in: 0.2 mΩ moves the LM74910H fast trip to 100 A even with RISCP = 0 Ω and needs its own R(ILIM), SHUNT_CAL and footprint. Not in the library"
  observations:
    - { date: 2026-11-03, source: DigiKey, prices: [{ qty: "1", usd: 2.98 }, { qty: 1500 reel, usd: 1.47 }], stock: 5154 }

- id: IAUTN08S5N012LATMA1
  mpn: IAUTN08S5N012LATMA1
  manufacturer: Infineon
  qty: 4
  function: DGATE ideal-diode and HGATE disconnect MOSFETs, 2 per bank, 80 V, PG-HSOF-8
  subsystem: power
  status: selected
  decision_note: "Selected 2026-10-22 (user). 80 V, 1.15 mΩ max at 10 V, AEC-Q101: two in parallel per bank ≈ 0.6 mΩ. Ciss 15.3 nF each sets LM74910H CCAP ≥ 10 × ΣCiss = 0.61 µF (1 µF fitted). Surge/thermal calculation still to confirm the count (DEC-001)"
  second_source: AOTL66810Q
  observations:
    - { date: 2026-10-22, source: DigiKey, prices: [{ qty: "1", usd: 6.71 }], stock: 1051 }
  decisions: [DEC-001]
  library: DropOut_PowerSwitch:IAUTN08S5N012LATMA1

- id: TBD-OCP-NETWORK
  mpn: null
  manufacturer: null
  qty: 1
  label: OCP timing/set network
  function: R(ILIM) 26.7 kΩ 1 % (R208), RSET 49.9 Ω (R209), RISCP 383 Ω 1 % (R210), TMR 68 nF
  subsystem: power
  status: open
  decision_note: "74.8 A breaker and 80 A fast trip on the 0.3 mΩ BVR-Z-R0003-1.0 (rev. B, 2026-11-03; rev. A had 32 kΩ and RISCP 0 Ω on 0.25 mΩ); ≈1 ms starting delay; tune against inrush"
  supply_note: Minor passives; confirm at BOM lock
  decisions: [DEC-001]

- id: INA228AQDGSRQ1
  mpn: INA228AQDGSRQ1
  manufacturer: Texas Instruments
  qty: 1
  function: 20-bit I²C total-current, power, and protected-rail monitor
  subsystem: power
  status: plan-of-record
  decision_note: "Plan of record. CURRENT_LSB 260.4167 µA, SHUNT_CAL 4096 for 0.3 mΩ (DEC-002); monitor + shared RSENSE ≈$5.10 @1k"
  second_source: INA281A2QDBVRQ1
  observations:
    - { date: 2026-10-13, source: DigiKey, prices: [{ qty: "1", usd: 5.43 }, { qty: 1k, usd: 3.20, approx: true }], stock: 32413 }
  decisions: [DEC-002]

- id: INA281A2QDBVRQ1
  mpn: INA281A2QDBVRQ1
  manufacturer: Texas Instruments
  qty: 0
  function: Grade 1, gain-50 analog total-current monitor
  subsystem: power
  status: alternative
  decision_note: Budget fallback; ≈0.6 A offset-equivalent at the shunt
  observations:
    - { date: 2026-10-13, source: DigiKey, prices: [{ qty: "1", usd: 3.21 }, { qty: 1k, usd: 1.80, approx: true }], stock: 8138 }
  decisions: [DEC-002]

- id: TMP175-Q1
  mpn: null
  manufacturer: Texas Instruments
  qty: 1
  label: TMP175-Q1
  function: Grade 1 digital NFET-bank / board-ambient temperature sensor
  subsystem: temperature
  status: plan-of-record
  decision_note: "Plan of record. Shares INA228 I²C bus; optional ALERT to MCU"
  supply_note: ≈$0.60–1.00 @1k estimate; verify at BOM lock
  decisions: [DEC-010, DEC-019]

- id: TBD-NTC-10K
  mpn: NCU18XH103F6SRB
  manufacturer: Murata
  qty: 4
  label: 10 kΩ NTC, AEC-Q200 (NCU18XH103F6SRB)
  function: Shared-RSENSE and 3 × switch-package temperature sensing
  subsystem: temperature
  status: selected
  decision_note: "Selected 2026-10-22 (user). 0603, 10 kΩ ±1 %, B25/50 3380 K ±1 %, −55…+150 °C, AEC-Q200: meets every Rev A limit. Second source NTCS0603E3103FMT (B25/85 3610 K: needs its own lookup table); NTCG163JF103FTDS rejected (+125 °C max)"
  second_source: NTCS0603E3103FMT
  supply_note: ≈$0.15–0.35 each @1k estimate
  observations:
    - { date: 2026-10-22, source: DigiKey, prices: [{ qty: "1", usd: 0.14 }], stock: 67028 }
  decisions: [DEC-010]
  library: DropOut_Thermistor:NCU18XH103F6SRB

- id: TPS3702-Q1
  mpn: null
  manufacturer: Texas Instruments
  qty: 1
  label: TPS3702-Q1
  function: Independent 3V3_MAIN OV/UV window supervisor to RESET_L
  subsystem: supervision
  status: plan-of-record
  decision_note: "Plan of record. Confirm exact 3.3 V variant, price, and stock at BOM lock"
  supply_note: ≈$1 planning estimate
  decisions: [DEC-006]

- id: IS25LP032D-JNLA3
  mpn: IS25LP032D-JNLA3
  manufacturer: ISSI
  qty: 1
  function: 32 Mbit Grade 1 SPI NOR diagnostic log; SOIC-8 150 mil
  subsystem: firmware
  status: plan-of-record
  decision_note: "Plan of record. Switched 3.3 V; PPAP available; constrained-supply flag—recheck at BOM lock"
  second_source: W25Q32JVSNSM
  observations:
    - date: 2026-10-13
      source: DigiKey
      prices: [{ qty: "1", usd: 1.74 }, { qty: 1k, usd: 1.40 }]
      stock: 2588
      stock_approx: true
      note: constrained supply—no backorders and 2,000 units per 30 days
    - { date: 2026-10-13, source: Mouser, stock: 65 }
    - { date: 2026-10-13, source: aggregator, note: 50-week factory lead }
  decisions: [DEC-011]

- id: W25Q32JVSNSM
  mpn: W25Q32JVSNSM
  manufacturer: Winbond
  qty: 0
  function: Automotive Grade 1 32 Mbit SPI NOR second source; SOIC-8 150 mil (same footprint as IS25LP032D-JNLA3)
  subsystem: firmware
  status: alternative
  decision_note: "Candidate only (rev. B, 2026-10-30). Grade 1, SOIC-8 150 mil code from the W25Q32JV-M datasheet rev. E §11.1; confirm the orderable code with a distributor (Winbond's product brief writes Grade 1 codes with a Q suffix). Hardware/software interchangeability review required"
  supply_note: Verify at BOM lock
  decisions: [DEC-011]

- id: TPS3430WQDRCRQ1
  mpn: TPS3430WQDRCRQ1
  manufacturer: Texas Instruments
  qty: 0
  function: External window watchdog for a later ASIL safety case
  subsystem: supervision
  status: future
  decision_note: Not fitted; internal S32K344 SWT is plan of record
  supply_note: Observed in stock; price not carried into Rev A
  decisions: [DEC-005]

- id: XLD8A24CAHM3_A/I
  mpn: XLD8A24CAHM3_A/I
  manufacturer: Vishay
  qty: 1
  function: 24 V, 7 kW AEC-Q101 TVS
  subsystem: power
  status: selected
  decision_note: Primary load-dump choice. Orderable automotive code XLD8A24CAHM3_A/I (2026-10-22); XLD8A24CAHM3/I is obsolete
  supply_note: Not verified
  decisions: [DEC-003]

- id: TPS2HCS08AQPWPRQ1
  mpn: TPS2HCS08AQPWPRQ1
  manufacturer: Texas Instruments
  qty: 3
  function: Dual smart eFuse, Grade 1
  subsystem: outputs
  status: selected
  decision_note: Selected; 20-week standard lead observed
  observations:
    - { date: 2026-10-13, source: distributors, prices: [{ qty: 1k, usd: 1.952 }], stock: 0, note: $5.86 total for three }
  decisions: [DEC-008, DEC-009, DEC-018]

- id: ECS-3225SMVQ-500-DS-TR
  mpn: ECS-3225SMVQ-500-DS-TR
  manufacturer: ECS
  qty: 1
  function: 50 MHz ±20 ppm oscillator
  subsystem: network
  status: selected
  decision_note: Selected
  observations:
    - { date: 2026-10-13, source: distributor, prices: [{ qty: "1", usd: 1.82 }], stock: 421 }

- id: ABM8AIG-16.000MHZ-8-1Z-T
  mpn: ABM8AIG-16.000MHZ-8-1Z-T
  manufacturer: Abracon
  qty: 1
  function: S32K344 FXOSC crystal, 16 MHz, CL 8 pF, ±10 ppm at 25 °C, ±50 ppm −40 to +125 °C, ESR 70 Ω max, AEC-Q200, 3.2 × 2.5 mm
  subsystem: compute
  status: selected
  decision_note: "Selected 2026-10-28 (user): the most accurate of the three Grade 1 candidates, lowest ESR. Load: 2 × 10 pF C0G plus a 0 Ω series resistor, as on NXP's FRDM-A-S32K344"
  second_source: CX3225CA16000D0HSSCC
  observations:
    - { date: 2026-10-28, source: DigiKey, prices: [{ qty: "1", usd: 0.79 }, { qty: "100", usd: 0.596 }], stock: 1916 }
    - { date: 2026-10-28, source: Mouser, prices: [{ qty: "1", usd: 0.79 }, { qty: 1k, usd: 0.47 }], stock: 884 }
  decisions: [DEC-015]
  library: DropOut_Timing:ABM8AIG-16.000MHZ-8-1Z-T

- id: CX3225CA16000D0HSSCC
  mpn: CX3225CA16000D0HSSCC
  manufacturer: KYOCERA AVX
  qty: 1
  function: 16 MHz crystal, CL 8 pF, ±20 ppm at 25 °C, ±50 ppm −40 to +125 °C, ESR 100 Ω max, 3.2 × 2.5 mm
  subsystem: compute
  status: alternative
  decision_note: "Second source for ABM8AIG-16.000MHZ-8-1Z-T: same size and load, ±20 ppm instead of ±10 ppm at 25 °C. Not a footprint drop-in: its own land pattern, and pads 2/4 are not connected (no grounded lid)"
  observations:
    - { date: 2026-10-28, source: DigiKey, prices: [{ qty: "1", usd: 0.88 }, { qty: 1k, usd: 0.58 }], stock: 6715 }
    - { date: 2026-10-28, source: Mouser, prices: [{ qty: "1", usd: 0.88 }, { qty: 1k, usd: 0.564 }], stock: 34864 }
  decisions: [DEC-015]
  library: DropOut_Timing:CX3225CA16000D0HSSCC

- id: ECS-160-8-36Q-AES-TR
  mpn: ECS-160-8-36Q-AES-TR
  manufacturer: ECS
  qty: 1
  function: 16 MHz crystal, CL 8 pF, ±25 ppm at 25 °C, ±50 ppm, ESR 80 Ω max, AEC-Q200, 2.5 × 2.0 mm
  subsystem: compute
  status: alternative
  decision_note: "Not selected 2026-10-28: least accurate at 25 °C of the three; smaller footprint, not a drop-in"
  observations:
    - { date: 2026-10-28, source: DigiKey, prices: [{ qty: "1", usd: 0.68 }, { qty: 1k, usd: 0.447 }], stock: 28198 }
    - { date: 2026-10-28, source: Mouser, prices: [{ qty: "1", usd: 0.65 }, { qty: 1k, usd: 0.463 }], stock: 6256 }
  decisions: [DEC-015]
  library: DropOut_Timing:ECS-160-8-36Q-AES-TR

- id: 74660016R
  mpn: 74660016R
  manufacturer: Würth Elektronik
  qty: 4
  label: 74660016R (REDCUBE SMT WP-SMRT, M6)
  function: Power terminal, two on the battery input (J901, J910) and two on the return (J902, J911); reverse SMT, M6 internal through thread, 85 A max at 20 °C, 3.9 N·m, -55 to +150 °C; Ø9.3 mm hole; SurLok Plus receptacles screw in
  subsystem: harness
  status: selected
  decision_note: "Selected (user's decision 2026-10-28), tape and reel. Operating current depends on PCB, lug and cable: prove at GATE-HAR-02"
  supply_note: Mouser only, no stock figure reported; not at DigiKey or Newark
  observations:
    - { date: 2026-10-26, source: Mouser 710-74660016R, prices: [{ qty: "1", usd: 4.32 }] }
    - { date: 2026-10-28, source: Mouser 710-74660016R, note: "listed, no stock figure; not at DigiKey or Newark" }
  decisions: [DEC-016]
  library: DropOut_Connector:74660016R

- id: "74660016"
  mpn: "74660016"
  manufacturer: Würth Elektronik
  qty: 0
  label: 74660016 (REDCUBE SMT WP-SMRT, M6, bulk)
  function: Bulk-packaged version of 74660016R, same part and footprint
  subsystem: harness
  status: alternative
  decision_note: Bulk alternate for hand assembly
  observations:
    - { date: 2026-10-28, source: distributors, note: "not at DigiKey, Mouser or Newark" }
  decisions: [DEC-016]
  library: DropOut_Connector:74660016

- id: SLPRATPSR
  mpn: SLPRATPSR
  manufacturer: Amphenol Industrial
  qty: 2
  label: SLPRATPSR (SurLok Plus 5.7 mm, red)
  function: Battery input and pass-through receptacles on the enclosure; SurLok Plus 5.7 mm RADSOK, threaded (M6 into the REDCUBE), flange panel mount, IP67, red; -40 to +125 °C
  subsystem: harness
  status: selected
  decision_note: "Selected (user's decision 2026-10-28). Enclosure part, not on the board: screws into J901/J910"
  observations:
    - { date: 2026-10-28, source: DigiKey 965-SLPRATPSR-ND, stock: 2070 }
    - { date: 2026-10-28, source: Mouser 654-SLPRATPSR, stock: 1218 }
  decisions: [DEC-016]

- id: SLPRATPSB
  mpn: SLPRATPSB
  manufacturer: Amphenol Industrial
  qty: 2
  label: SLPRATPSB (SurLok Plus 5.7 mm, black)
  function: Power return and pass-through receptacles on the enclosure; SurLok Plus 5.7 mm RADSOK, threaded (M6 into the REDCUBE), flange panel mount, IP67, black; -40 to +125 °C
  subsystem: harness
  status: selected
  decision_note: "Selected (user's decision 2026-10-28). Enclosure part, not on the board: screws into J902/J911"
  observations:
    - { date: 2026-10-28, source: DigiKey 965-SLPRATPSB-ND, stock: 859 }
    - { date: 2026-10-28, source: Mouser 654-SLPRATPSB, stock: 1126 }
  decisions: [DEC-016]

- id: Busbar_Cu_19.05x3.175mm_L125.05mm_2xD6.5mm_P106mm
  mpn: Busbar_Cu_19.05x3.175mm_L125.05mm_2xD6.5mm_P106mm
  manufacturer: DropOut
  qty: 1
  label: BB901 VBAT_IN busbar (1/8" × 3/4" C110, 125.05 mm)
  function: "Battery busbar BB901: joins J910 and J901 (both VBAT_IN; either may be the source, DEC-016 rev. C) on the REDCUBE spigots; 19.05 × 3.175 mm C110 copper, 125.05 mm long, 2 × Ø6.5 mm M6 clearance holes at 106 mm; a two-pin net tie on the schematic (p9), in parallel with the F.Cu pour under it (5.4 mΩ terminal to terminal, against about 0.04 mΩ for the bar)"
  subsystem: harness
  status: selected
  decision_note: "Made in house (user's decision 2026-11-02, placement decision D02): cut from bar stock, drilled, deburred, fitted by hand at assembly; on the BOM, out of the placement files. Bar size from DEC-025. The return bar BB902 is a BOM line the same way (DEC-016 rev. B)"
  supply_note: "Stock: 1/8\" × 3/4\" C110 copper flat bar (ASTM B187), e.g. Metals Depot CPF1834 or Zoro CF.125X.75-72 (seen 2026-11-02); no distributor PN for the cut bar"
  decisions: [DEC-016, DEC-025]
  library: DropOut_Busbar:Busbar_Cu_19.05x3.175mm_L125.05mm_2xD6.5mm_P106mm

- id: Busbar_Cu_19.05x3.175mm_L176.05mm_2xD6.5mm_P157mm
  mpn: Busbar_Cu_19.05x3.175mm_L176.05mm_2xD6.5mm_P157mm
  manufacturer: DropOut
  qty: 1
  label: BB902 GND busbar (1/8" × 3/4" C110, 176.05 mm)
  function: "Return busbar BB902: joins J911 and J902 (either may be the source side) on the REDCUBE spigots, both pins on GND; 19.05 × 3.175 mm C110 copper, 176.05 mm long, 2 × Ø6.5 mm M6 clearance holes at 157 mm; a two-pin net tie on the schematic (p9), in parallel with the GND plane"
  subsystem: harness
  status: selected
  decision_note: "Made in house (user's decision 2026-11-02: both busbars on the schematic, the same way): cut from bar stock, drilled, deburred, fitted by hand at assembly; on the BOM, out of the placement files. Bar size from DEC-025"
  supply_note: "Stock: 1/8\" × 3/4\" C110 copper flat bar (ASTM B187), e.g. Metals Depot CPF1834 or Zoro CF.125X.75-72 (seen 2026-11-02); no distributor PN for the cut bar"
  decisions: [DEC-016, DEC-025]
  library: DropOut_Busbar:Busbar_Cu_19.05x3.175mm_L176.05mm_2xD6.5mm_P157mm

- id: G6KU-2F-Y-T1-TRS_DC3
  mpn: "G6KU-2F-Y-T1-TRS DC3"
  manufacturer: Omron (ARATAS)
  qty: 1
  label: "K501 G6KU-2F-Y-T1-TRS DC3"
  function: "T1S termination relay: single-winding latching DPDT, -40 to +125 °C, 3 V coil (64 Ω, 46.6 mA), 100 mΩ contacts, tape and reel"
  subsystem: network
  status: selected
  decision_note: "Selected 2026-10-28 (user). SET = end node (49.9 Ω legs), RESET = drop node (1.5 kΩ). No distributor stock at selection"
  second_source: G6KU-2F-Y-T1_DC3
  observations:
    - { date: 2026-10-28, source: DigiKey 39-G6KU-2F-Y-T1-TRSDC3TR-ND, prices: [{ qty: "900", usd: 3.54 }], stock: 0, note: "reel only, MOQ 900" }
    - { date: 2026-10-28, source: Mouser 653-G6KU-2FYT1TRSDC3, note: "no stock" }
  decisions: [DEC-017]
  library: DropOut_Relay:G6KU-2F-Y-T1-TRS_DC3

- id: G6KU-2F-Y-T1_DC3
  mpn: "G6KU-2F-Y-T1 DC3"
  manufacturer: Omron (ARATAS)
  qty: 0
  label: "G6KU-2F-Y-T1 DC3 (tube)"
  function: "Same relay as K501 in tube packaging"
  subsystem: network
  status: alternative
  decision_note: "Tube version of the selected relay"
  observations:
    - { date: 2026-10-28, source: DigiKey 39-G6KU-2F-Y-T1DC3-ND, prices: [{ qty: "500", usd: 3.64 }], stock: 0 }
    - { date: 2026-10-28, source: Mouser 653-G6KU-2F-Y-T1DC3, prices: [{ qty: "1", usd: 3.35 }], note: "no stock" }
  decisions: [DEC-017]
  library: DropOut_Relay:G6KU-2F-Y-T1_DC3

- id: G6KU-2F-Y-T1-TRS_DC5
  mpn: "G6KU-2F-Y-T1-TRS DC5"
  manufacturer: Omron (ARATAS)
  qty: 0
  label: "G6KU-2F-Y-T1-TRS DC5"
  function: "5 V coil version (28 mA, must operate 3.75 V)"
  subsystem: network
  status: alternative
  decision_note: "Not selected: Node60 has no 5 V rail; stocked"
  observations:
    - { date: 2026-10-28, source: DigiKey 39-G6KU-2F-Y-T1-TRSDC5CT-ND, prices: [{ qty: "1", usd: 5.33 }], stock: 875 }
    - { date: 2026-10-28, source: Mouser 653-G6KU-2FYT1TRSDC5, prices: [{ qty: "1", usd: 5.17 }], stock: 696 }
  decisions: [DEC-017]
  library: DropOut_Relay:G6KU-2F-Y-T1-TRS_DC5

- id: G6KU-2F-Y-T1-TRS_DC12
  mpn: "G6KU-2F-Y-T1-TRS DC12"
  manufacturer: Omron (ARATAS)
  qty: 0
  label: "G6KU-2F-Y-T1-TRS DC12"
  function: "12 V coil version (11.6 mA, must operate 9 V, max 18 V)"
  subsystem: network
  status: alternative
  decision_note: "Not selected: would need its own regulator for cold crank and jump start; stocked"
  observations:
    - { date: 2026-10-28, source: DigiKey 39-G6KU-2F-Y-T1-TRSDC12CT-ND, prices: [{ qty: "1", usd: 5.03 }], stock: 880 }
    - { date: 2026-10-28, source: Mouser 653-G6KU2FYT1TRSDC12, prices: [{ qty: "1", usd: 5.02 }], stock: 720 }
  decisions: [DEC-017]
  library: DropOut_Relay:G6KU-2F-Y-T1-TRS_DC12

- id: DMC2710UVQ-7
  mpn: "DMC2710UVQ-7"
  manufacturer: Diodes Incorporated
  qty: 2
  label: "Q501, Q502 DMC2710UVQ-7"
  function: "Relay coil half-bridges: N+P complementary MOSFET pair, 20 V, VGS ±6 V, Vth ≤ 1 V, AEC-Q101, SOT-563"
  subsystem: network
  status: selected
  decision_note: "Selected 2026-10-28. Data sheet marked Advance Information"
  second_source: DMC2400UVQ-7
  observations:
    - { date: 2026-10-28, source: DigiKey 31-DMC2710UVQ-7CT-ND, prices: [{ qty: "1", usd: 0.46 }], stock: 3216 }
    - { date: 2026-10-28, source: Mouser 621-DMC2710UVQ-7, prices: [{ qty: "1", usd: 0.53 }], stock: 2977 }
  decisions: [DEC-017]
  library: DropOut_PowerSwitch:DMC2710UVQ-7

- id: DMC2400UVQ-7
  mpn: "DMC2400UVQ-7"
  manufacturer: Diodes Incorporated
  qty: 0
  label: "DMC2400UVQ-7"
  function: "Complementary MOSFET pair, 20 V, AEC-Q101, SOT-563, same footprint"
  subsystem: network
  status: alternative
  decision_note: "Alternate on the same footprint; no stock at selection"
  observations:
    - { date: 2026-10-28, source: DigiKey 31-DMC2400UVQ-7TR-ND, stock: 0, note: "reel only" }
    - { date: 2026-10-28, source: Mouser 621-DMC2400UVQ-7, prices: [{ qty: "1", usd: 0.54 }], note: "no stock" }
  decisions: [DEC-017]
  library: DropOut_PowerSwitch:DMC2400UVQ-7

- id: CRCW120649R9FKEAHP
  mpn: "CRCW120649R9FKEAHP"
  manufacturer: Vishay
  qty: 2
  label: "R517, R519 49.9 Ω 1 % 0.75 W 1206"
  function: "End-node termination legs (OA: 50 Ω ±1 %, ≥ 0.4 W)"
  subsystem: network
  status: selected
  decision_note: "Selected 2026-10-28: highest-rated stocked 1206 AEC-Q200 part"
  second_source: ERJ-P08F49R9V
  observations:
    - { date: 2026-10-28, source: DigiKey 541-49.9UCT-ND, prices: [{ qty: "1", usd: 0.26 }], stock: 15561 }
    - { date: 2026-10-28, source: Mouser 71-CRCW120649R9FKEAH, prices: [{ qty: "1", usd: 0.26 }], stock: 14559 }
  decisions: [DEC-017]
  library: DropOut_Resistor:CRCW120649R9FKEAHP

- id: ERJ-P08F49R9V
  mpn: ERJ-P08F49R9V
  manufacturer: Panasonic
  qty: 0
  label: "ERJ-P08F49R9V 49.9 Ω 1 % 0.66 W 1206"
  function: "Second source for the end-node termination legs (anti-surge, AEC-Q200)"
  subsystem: network
  status: alternative
  decision_note: "Second source for CRCW120649R9FKEAHP; same footprint"
  observations:
    - { date: 2026-10-28, source: DigiKey, stock: 0 }
    - { date: 2026-10-28, source: Mouser, prices: [{ qty: "1", usd: 0.32 }], stock: 4757 }
  decisions: [DEC-017]
  library: DropOut_Resistor:ERJ-P08F49R9V

- id: GCM21BR72A104KA37L
  mpn: GCM21BR72A104KA37L
  manufacturer: Murata
  qty: 0
  label: "GCM21BR72A104KA37L 100 nF 100 V X7R 0805"
  function: "Second source for the termination centre-tap capacitor (AEC-Q200)"
  subsystem: network
  status: alternative
  decision_note: "Second source for CGA4J2X7R2A104K125AA; same footprint"
  observations:
    - { date: 2026-10-28, source: "DigiKey 490-4789-1-ND / Mouser 81-GCM21BR72A104KA7L", note: "listed" }
  decisions: [DEC-017]
  library: DropOut_Capacitor:GCM21BR72A104KA37L

- id: CRCW12061K50FKEA
  mpn: "CRCW12061K50FKEA"
  manufacturer: Vishay
  qty: 2
  label: "R516, R518 1.5 kΩ 1 % 1206"
  function: "Drop-node common-mode termination legs"
  subsystem: network
  status: selected
  decision_note: "Selected 2026-10-28"
  observations:
    - { date: 2026-10-28, source: DigiKey 541-1.50KFCT-ND, prices: [{ qty: "1", usd: 0.11 }], stock: 60645 }
    - { date: 2026-10-28, source: Mouser 71-CRCW1206-1.5K-E3, prices: [{ qty: "1", usd: 0.11 }], stock: 101800 }
  decisions: [DEC-017]
  library: DropOut_Resistor:CRCW12061K50FKEA

- id: AC0805FR-07100KL
  mpn: "AC0805FR-07100KL"
  manufacturer: Yageo
  qty: 1
  label: "R520 100 kΩ 0805"
  function: "Termination centre-tap static bleed to GND"
  subsystem: network
  status: selected
  decision_note: "Selected 2026-10-28"
  observations:
    - { date: 2026-10-28, source: DigiKey YAG3688CT-ND, prices: [{ qty: "1", usd: 0.10 }], stock: 137072 }
    - { date: 2026-10-28, source: Mouser 603-AC0805FR-07100KL, prices: [{ qty: "1", usd: 0.10 }], stock: 181878 }
  decisions: [DEC-017]
  library: DropOut_Resistor:AC0805FR-07100KL

- id: CGA4J2X7R2A104K125AA
  mpn: "CGA4J2X7R2A104K125AA"
  manufacturer: TDK
  qty: 1
  label: "C514 100 nF 100 V X7R 0805"
  function: "Termination centre tap to GND (OA: 4.7–100 nF, ≥ 50 V)"
  subsystem: network
  status: selected
  decision_note: "Selected 2026-10-28; no AEC-Q200 C0G 100 nF in 0805"
  second_source: GCM21BR72A104KA37L
  observations:
    - { date: 2026-10-28, source: DigiKey 445-5827-1-ND, prices: [{ qty: "1", usd: 0.18 }], stock: 89261 }
    - { date: 2026-10-28, source: Mouser 810-CGA4J2X7R2A104K, prices: [{ qty: "1", usd: 0.18 }], stock: 111206 }
  decisions: [DEC-017]
  library: DropOut_Capacitor:CGA4J2X7R2A104K125AA

- id: AT13-2P-BM04
  mpn: AT13-2P-BM04
  manufacturer: Amphenol Sine Systems
  qty: 6
  label: AT13-2P-BM04 (BoardLock AT13)
  function: Output connector, one per output; 2-pin right-angle flanged PCB header, potted, 13 A, -55 to +125 °C at rated current, IP67 mated; mates AT06-2S (DT06-2S equivalent)
  subsystem: harness
  status: selected
  decision_note: Selected (user's decision 2026-10-25), replacing TE DT13-2P. Pin 1 = OUTx, pin 2 = local ground return
  supply_note: DigiKey and Mouser stock; no second source chosen
  observations:
    - { date: 2026-10-25, source: DigiKey 889-3345-ND, prices: [{ qty: "1", usd: 5.93 }, { qty: "10", usd: 5.035 }, { qty: "180", usd: 4.106 }, { qty: "1080", usd: 3.618 }], stock: 174 }
    - { date: 2026-10-25, source: Mouser 654-AT13-2P-BM04, prices: [{ qty: "1", usd: 5.41 }, { qty: "10", usd: 5.04 }, { qty: "100", usd: 4.11 }, { qty: "1080", usd: 3.26 }], stock: 129 }
  decisions: [DEC-013]

- id: ATM13-2P-BM04
  mpn: ATM13-2P-BM04
  manufacturer: Amphenol SINE Systems
  qty: 2
  function: 10BASE-T1S connectors J903 (upstream) and J912 (downstream pass-through, DEC-017); BoardLock ATM13 2-pin right-angle PCB receptacle, flange seal, tin-plated size 20 pins, potted, 7.5 A, IP67 mated; mates ATM06-2S
  subsystem: harness
  status: selected
  decision_note: "Selected (user's decision 2026-10-25), tin-plated and potted; second connector added 2026-10-28 (DEC-017); verify pin 1 on a sample"
  decisions: [DEC-014, DEC-017]
  observations:
    - { date: 2026-10-25, source: DigiKey 889-3357-ND, prices: [{ qty: "1", usd: 8.23 }, { qty: "600", usd: 5.2387 }], stock: 14 }
    - { date: 2026-10-25, source: Mouser 654-ATM13-2P-BM04, prices: [{ qty: "1", usd: 8.23 }, { qty: "1050", usd: 5.03 }], stock: 120 }

- id: ATM13-2P-BM02
  mpn: ATM13-2P-BM02
  manufacturer: Amphenol SINE Systems
  qty: 0
  function: 10BASE-T1S connector; BoardLock ATM13 2-pin right-angle PCB receptacle, flange seal, gold-plated size 20 pins, potted, 7.5 A, IP67 mated; mates ATM06-2S
  subsystem: harness
  status: alternative
  decision_note: Gold-plated, potted drop-in on the same footprint
  observations:
    - { date: 2026-10-25, source: DigiKey 889-3356-ND, prices: [{ qty: "1", usd: 8.90 }, { qty: "600", usd: 5.66323 }], stock: 24 }
    - { date: 2026-10-25, source: Mouser 654-ATM13-2P-BM02, prices: [{ qty: "1", usd: 8.90 }, { qty: "1050", usd: 5.44 }], stock: 25 }
  decisions: [DEC-014]

- id: ATM13-2P-BM01
  mpn: ATM13-2P-BM01
  manufacturer: Amphenol SINE Systems
  qty: 0
  function: 10BASE-T1S connector; BoardLock ATM13 2-pin right-angle PCB receptacle, flange seal, gold-plated size 20 pins, unpotted, 7.5 A, IP67 mated; mates ATM06-2S
  subsystem: harness
  status: alternative
  decision_note: Gold-plated, unpotted version on the same footprint
  observations:
    - { date: 2026-10-25, source: DigiKey 889-3355-ND, prices: [{ qty: "1", usd: 8.47 }, { qty: "600", usd: 5.3934 }], stock: 150 }
    - { date: 2026-10-25, source: Mouser 654-ATM13-2P-BM01, prices: [{ qty: "1", usd: 8.15 }, { qty: "1050", usd: 4.86 }], stock: 146 }
  decisions: [DEC-014]

- id: ATM13-2P-BM03
  mpn: ATM13-2P-BM03
  manufacturer: Amphenol SINE Systems
  qty: 0
  function: 10BASE-T1S connector; BoardLock ATM13 2-pin right-angle PCB receptacle, flange seal, tin-plated size 20 pins, unpotted, 7.5 A, IP67 mated; mates ATM06-2S
  subsystem: harness
  status: alternative
  decision_note: Tin-plated, unpotted version on the same footprint
  observations:
    - { date: 2026-10-25, source: DigiKey 889-3289-ND, prices: [{ qty: "1", usd: 7.76 }, { qty: "600", usd: 4.9409 }], stock: 7 }
    - { date: 2026-10-25, source: Mouser 654-ATM13-2P-BM03, prices: [{ qty: "1", usd: 7.76 }, { qty: "1050", usd: 4.74 }], stock: 27 }
  decisions: [DEC-014]

- id: NCV8730BMTW330TBG
  mpn: NCV8730BMTW330TBG
  manufacturer: onsemi
  qty: 0
  function: Always-on VDDAU LDO alternative, 3.3 V, 38 V input, Iq 3 µA, WDFNW 2 × 2
  subsystem: power
  status: alternative
  decision_note: Not selected 2026-10-22; 38 V maximum leaves only 4 V above the 34 V OV cut-off. Built in the library as a candidate
  observations:
    - { date: 2026-10-22, source: DigiKey, prices: [{ qty: "1", usd: 0.84 }], stock: 8622 }

- id: HCS2512FTL250
  mpn: HCS2512FTL250
  manufacturer: Stackpole Electronics
  qty: 0
  function: 0.25 mΩ 1 % shunt alternative, 3 W, ±150 ppm/°C, 2512
  subsystem: power
  status: alternative
  decision_note: Not selected 2026-10-22; three times the tempco of CSS2725FTL250 (itself replaced by BVR-Z-R0003-1.0 on 2026-11-03). Built in the library as a candidate
  observations:
    - { date: 2026-10-22, source: DigiKey, prices: [{ qty: "1", usd: 1.70 }], stock: 3265 }

- id: AOTL66810Q
  mpn: AOTL66810Q
  manufacturer: Alpha & Omega Semiconductor
  qty: 0
  function: 80 V, 1.25 mΩ AEC-Q101 MOSFET alternative, TOLLA
  subsystem: power
  status: alternative
  decision_note: Second-source candidate for IAUTN08S5N012L; confirm land-pattern compatibility (HSOF-8 vs TOLLA) before calling it drop-in
  observations:
    - { date: 2026-10-22, source: DigiKey, prices: [{ qty: "1", usd: 8.30 }], stock: 1418 }

- id: NTCS0603E3103FMT
  mpn: NTCS0603E3103FMT
  manufacturer: Vishay
  qty: 0
  function: 10 kΩ NTC alternative, 0603, ±1 %, B25/85 3610 K ±1 %, AEC-Q200
  subsystem: temperature
  status: alternative
  decision_note: Second source for NCU18XH103F6SRB; different B value, so firmware needs its own lookup table
  observations:
    - { date: 2026-10-22, source: DigiKey, prices: [{ qty: "1", usd: 0.64 }], stock: 104744 }
