karlTbowers/node60-hw/(commit log)

2026-10-21 Add CLAUDE.md board instructions and architecture folder
    Claude-Session: https://claude.ai/code/session_01FDkH2m7tFrxwSkxp61zHPs
2026-10-22 Diagram drafts: replace single system diagram with D2 power and signal views
    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
2026-10-22 Diagrams: set layout engines (power dagre, signals ELK), left-to-right
    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
2026-10-22 Port Architecture Rev C to an Astro Starlight site (handbook ch. 08)
    Format change only: the content is still Architecture Rev C (2026-10-13).
    - docs/ is now a Starlight project (base /node60-hw), pages mirroring
    Rev C sections 00-15; the frozen HTML moves to docs/public/legacy/
    and is linked from the revisions page.
    - Facts as data with schemas and build-time reference checks:
    requirements.yaml (REQ-*), parts.yaml (dated 2026-10-13 observations,
    second sources, status), gates.yaml (GATE-*), decisions/DEC-001..011
    with rejected alternatives, plus status.yaml and sources.yaml.
    - Diagrams render at build time: power.d2 (dagre) and signals.d2 (ELK)
    moved from diagram-drafts/ with e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
2026-10-22 Add the KiCad project and sheet hierarchy
    - node60.kicad_pro/.kicad_sch/.kicad_pcb at the root; the root sheet is
    page 1 (index) and holds only sheet symbols.
    - sheets/: power-entry (p2), regulators (p3), mcu-nvm (p4), t1s (p5),
    output-switch placed three times as Outputs 1-2/3-4/5-6 (p6-p8),
    connectors (p9), following the Rev A sheet plan.
    - Annotation set to "first free after sheet number x 100" in the project
    (R201 = first resistor on page 2).
    - scripts/check_schematic.py, run in CI: sheet files only in sheets/ (flat)
    and all used; page numbers integers 1-99, unique, root = 1; reference
    designators = page x 100 + 01..99.
    - CI: DRC, fab outputs and rev-* releases wait for a boa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
    [connectors.kicad_sch, mcu-nvm.kicad_sch, node60.kicad_pcb, node60.kicad_sch, output-switch.kicad_sch, power-entry.kicad_sch, regulators.kicad_sch, t1s.kicad_sch]
2026-10-22 CLAUDE.md: follow handbook v0.4.0
    v0.3.0 (board docs starter) and v0.4.0 (schematic sheet files, page
    numbers, reference designators) are both already applied here.
2026-10-23 BOM: orderable codes for the LMQ66430, XLD8A24CA and LAN8670 lines
    Found while adding the parts to dropout-kicad-library (karlTbowers/
    dropout-kicad-library#9); each chosen with the user on 2026-10-22.
    - LMQ66430QMC5RXBRQ1 does not exist -> LMQ66430MC3RXBRQ1 (2.2 MHz, fixed
    3.3 V or adjustable output; serves both the 3.3 V and 1.5 V rails).
    - XLD8A24CA -> XLD8A24CAHM3_A/I (active AEC-Q101 code; HM3/I is obsolete).
    - LAN8670D0-E/LMXVAO stays (Microchip's automotive code); LAN8670D0T-E/LMX
    added as a qty-0 prototype stand-in (stocked, not designated automotive).
    - DEC-003 and DEC-004 part references follow.
    [parts.yaml]
2026-10-23 List the DropOut libraries in the project library tables
    sym-lib-table: the 8 symbol libraries, fp-lib-table: the 6 footprint
    libraries now in lib/dropout-kicad-library (at 86e72e2), all through
    ${KIPRJMOD}/lib/dropout-kicad-library/... Both tables were empty, so KiCad
    could not see any DropOut library.
2026-10-23 DEC-012: T1S common mode choke and ESD diodes
    ACT1210E-241-2P-TL00 choke and 2 x VETH100A1DD1HG3-08 ESD diodes, with
    ACT1210E-131, DLW32MH241MX2L and Nexperia PESD1ETH10L(S)-QYL as alternates.
2026-10-23 Update DropOut library to latest main (adds T1S chokes and ESD, PR #14)
    List the new Connector and Inductor libraries in the project library tables.
2026-10-23 Schematic capture: power entry (p2) and regulators (p3)
    Pages 2 and 3 drawn to the schematic rules adopted on 2026-10-22 (wired
    clusters in dashed boxes, labels only between clusters and sheets, one
    rail symbol per cluster, every net named, D-45 values with separate
    voltage/tolerance/dielectric fields). Design values and their reasons
    are on each sheet. Parts not yet in the DropOut library are stock
    Device symbols marked PLACEHOLDER with empty MPN fields.
    The root index now carries the sheet interfaces as sheet pins, laid out
    along the power and signal path. check_schematic.py also fails on
    auto-generated net names (rule O-2). CLAUDE.md records the four project
    answers and the net-naming de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
    [node60.kicad_sch, power-entry.kicad_sch, regulators.kicad_sch]
2026-10-23 Schematic capture: T1S (p5) and output switch (p6-p8)
    Page 5: LAN8670 with per-pin decoupling, RMII mode and PHYAD straps, the
    DEC-012 line interface (C0G DC block, ACT1210E-241 choke, VETH100A1DD1
    ESD, DNP 100R termination) and the 50 MHz clock feeding PHY and MCU.
    Pages 6-8: one TPS2HCS08A-Q1 sheet placed three times, with the SPI
    daisy chain, SNS network, VDD filter and package NTC; the root maps
    each placement to OUT1..OUT6, SW1..3 and the chain nets.
    [node60.kicad_sch, output-switch.kicad_sch, t1s.kicad_sch]
2026-10-23 Schematic capture: MCU and NVM (p4), connectors (p9); ERC clean
    Page 4: S32K344 in eight boxed units. The supply unit has decoupling per
    NXP HDG Rev E2 Table 2; each port unit shows its pin plan and firmware
    notes (D-14 as adopted). Pins were checked against NXP's IOMUX table:
    EMAC RMII per NXP's TJA1100 use case, LPSPI4 switch chain, LPSPI2 log
    flash, LPI2C0 telemetry, ADC1/ADC2 inputs, EIRQ fault lines, SWD and an
    LPUART0 debug port. Also the IS25LP032D flash, the Cortex 10-pin header
    and the I2C pull-ups.
    Page 9: placeholder battery, return, T1S and MX150 output connectors
    (all TBD selections), mirrored with pin 1 at the top (D-43), and the
    PWR_FLAGs for nets entering the board.
    ERC: 0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
    [connectors.kicad_sch, mcu-nvm.kicad_sch, node60.kicad_sch, output-switch.kicad_sch, power-entry.kicad_sch]
2026-10-23 Record TBD part selections; schematic follows them
    User selections of 2026-10-22: TPS7B8133QWDRVRQ1 (VDDAU LDO),
    CSS2725FTL250 (0.25 mOhm RSENSE), IAUTN08S5N012LATMA1 (DGATE/HGATE
    FETs, new parts entry) and NCU18XH103F6SRB (NTCs), each with its dated
    DigiKey observation and the rejected or alternative candidates, which
    are now parts entries too. The schematic placeholders carry the
    selected MPNs until the library parts land. CCAP grows to 1uF:
    10 x the summed Ciss of four IAUTN08S5N012L is 0.61 uF.
    [output-switch.kicad_sch, power-entry.kicad_sch, regulators.kicad_sch]
2026-10-23 Connectors page: reference and value above each placeholder
    [connectors.kicad_sch]
2026-10-23 Wake timing: use the OPEN Alliance 15 ms limit, accept and test
    The OPEN Alliance Sleep/Wake-Up Electrical Interface Specification v1.0
    (sec. 5.2) limits supply ramp plus PHY initialization to 15 ms; the
    LAN8670 datasheet's 'within 1 ms' is Microchip's own allocation. Node60
    is estimated at about 10 ms (LMQ66430 ~6-7 ms to regulation, LAN8670 D0
    ~3 ms reset and init). The user chose to keep the design and measure it
    at GATE-NET-01. Power, network and verification pages, DEC-004 (with a
    dated correction note), GATE-NET-01 and the page-3 note now say so.
    [regulators.kicad_sch]
2026-10-23 DEC-013: TE DEUTSCH DT13-2P output connectors replace the MX150 plan
    One TE DT13-2P 2-pin right-angle header per output (six), with HISENG
    CH-AK-DT13-02 (Alibaba) and Jorch DT13-2P (AliExpress) as marketplace
    alternates. Replaces TBD-MX150-SETS in parts.yaml; updates the harness page,
    power diagram and sources. Output pin assignment left open for the user.
    [parts.yaml]
2026-10-23 Connectors: six DT13-2P output headers replace the MX150 placeholder
    J904-J909, one TE Deutsch DT13-2P per output (DEC-013, node60-hw PR #8).
    Still placeholders until DropOut_Connector:DT13-2P lands (library PR
    #19). Pin 1 carries OUTx; pin 2 stays unconnected with a visible note
    until the pin assignment (local ground return vs paralleled output) is
    decided.
    [connectors.kicad_sch]
2026-10-23 DEC-013: pin 1 = OUTx, pin 2 = local ground return (60 A node return)
    The user chose a local ground return on pin 2 of each DT13-2P. Record the
    decision, reject OUTx-on-both-pins, and add the 60 A node ground return
    consequences to DEC-013 and the harness page.
2026-10-23 Connectors: DT13-2P pin 2 is the load ground return
    Per DEC-013 (decided 2026-10-22, node60-hw PR #8): pin 1 = OUTx, pin 2 =
    that load's ground return, on the single GND net. The sheet notes the
    layout consequences: each return sized like its 10 A output and routed
    to the power-entry star region, never across the logic ground, with up
    to 60 A of load return leaving through J902.
    [connectors.kicad_sch]
2026-10-23 Swap placeholders for merged DropOut library parts
    Library bumped to ce98ecf (PRs #15, #16, #18, #19, #20, #21 merged).
    Now real parts: IAUTN08S5N012LATMA1 (Q201-Q204, dual gate: G_ON and
    G_LIN both driven), CSS2725FTL250 (R201, 2-terminal: sense nets are
    VBAT_D / VBAT_Q2D with Kelvin taps from the pads in layout),
    TPS7B8133QWDRVRQ1 (U301, COUT 2.2uF per its 1-200 uF requirement),
    NCU18XH103F6SRB (RT201, RT601-801), Wurth 74438356022HT / 74438356010HT
    buck inductors and Harwin S1751-46R GND loops (user's picks 2026-10-23),
    1 mm pad test points and DT13-2P output headers. The library pin-type
    fixes cut the ERC exclusions from 17 to 2. parts.yaml records the
    library symbols; the library tables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
    [connectors.kicad_sch, mcu-nvm.kicad_sch, output-switch.kicad_sch, power-entry.kicad_sch, regulators.kicad_sch]
2026-10-23 Swap all resistors, capacitors and test points for DropOut parts
    Library bumped to 752b63c (PR #22: 83 AEC-Q200 chip resistors and MLCCs,
    PR #24: passive symbol layout). Each passive is now a real part, chosen
    by rule: exact value and dielectric, tolerance and voltage at least as
    good, the drawn package else the next larger, then manufacturer order;
    the other built sources stay in the library as alternates.
    Where the library has no part in the drawn package: 10nF C0G, 4.7nF C0G,
    1uF 16V and 470nF 16V 0402 -> 0603; 68nF C0G, 100nF C0G and 10uF 16V
    0805 -> 1206; 32k 1% -> 0.1% (TNPW060332K0BEEA); CCAP 1uF 50V (not built)
    -> 1uF 100V 1206. 0R debug links on regulator outputs use the 5 A
    CRCW06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
    [mcu-nvm.kicad_sch, output-switch.kicad_sch, power-entry.kicad_sch, regulators.kicad_sch, t1s.kicad_sch]
2026-10-23 Schematic: LHI to the MCU, current notes, net-name map
    - LHI on all three TPS2HCS08 is now SW_LHI from S32K344 PTE4 (the
    architecture's GPIO list), still held low by the 10k pull-downs
    through reset.
    - Page 4 cites NXP HDG Rev E2 Table 33 for unused GPIO, EXTAL/XTAL and
    the RESET_B pull-up instead of an open 'confirm' note.
    - Copper notes for the 10 A output paths (p6) and the 60 A path (p2,
    p9), as IPC-2221 starting estimates to confirm with IPC-2152.
    - interfaces.mdx maps the architecture's signal names to the schematic
    nets (RESET_L, T1S_IRQ_L, *_FLT_L, SPI4/SPI2/I2C0 buses).
    [connectors.kicad_sch, mcu-nvm.kicad_sch, node60.kicad_sch, output-switch.kicad_sch, power-entry.kicad_sch]
2026-10-25 DEC-014: Amphenol SINE ATM13-2P-BM04 T1S connector
2026-10-25 DEC-013 rev. B: Amphenol Sine AT13-2P-BM04 output connectors replace TE DT13-2P
    The user replaced the TE DT13-2P with the Amphenol Sine AT13-2P-BM04 BoardLock
    header on 2026-10-25. DEC-013 is revised (rev. B): DT13-2P and its marketplace
    copies move to the rejected options, ratings, layout, sealing, mechanical and
    procurement consequences follow the Amphenol drawing; pin assignment (pin 1 =
    OUTx, pin 2 = local ground return, 60 A node return) is unchanged. parts.yaml,
    the harness page, the power diagram and sources follow.
    [parts.yaml]
2026-10-25 Connectors: J903 is the Amphenol SINE ATM13-2P-BM04 (DEC-014)
    T1S_P on pin 1, T1S_N on pin 2, with the ESD diodes right behind the
    connector per DEC-012. Pin 1 must be verified on a sample
    (release-blocking, noted on the sheet).
    The library submodule is TEMPORARILY pinned to dropout-kicad-library
    PR #26's head (9d70e7f, which contains main 752b63c) for
    DropOut_Connector:ATM13-2P-BM04; re-pin to library main once #26
    merges. Adds the DropOut_Connector_Amphenol footprint library.
    [connectors.kicad_sch]
2026-10-25 DEC-014: footprint renamed in library PR #26
2026-10-25 Re-pin library to PR #26 head cfea26e (renamed ATM13 footprint)
    J903's footprint is now
    DropOut_Connector_Amphenol:Amphenol_ATM13-2P-BMxx_1x02_P4.20mm_Horizontal.
    Still a temporary pin: move to library main once #26 merges.
    [connectors.kicad_sch]
2026-10-25 Outputs J904-J909: Amphenol Sine AT13-2P-BM04 (DEC-013 rev. B)
    Replaces the TE DT13-2P per DEC-013 rev. B (node60-hw PR #10). Pin
    assignment unchanged: pin 1 = OUTx, pin 2 = that load's ground return.
    Library pinned to PR #26's head 18a8718, which merges library main and
    so contains both #25 (AT13-2P-BM04) and #26 (ATM13-2P-BM04, J903).
    Still temporary: move to library main once #26 merges.
    [connectors.kicad_sch]
2026-10-26 Pin DropOut library to main 025dfbb (PR #26 merged)
    Ends the temporary pin to the PR #26 branch; main now has both Amphenol
    connectors (AT13-2P-BM04, ATM13-2P-BM04).
2026-10-28 Record the 2026-10-28 schematic review answers
    - DEC-015: 16 MHz crystal on the S32K344 FXOSC (part TBD-XTAL-16M)
    - GATE-HAR-01: confirm AT13/ATM13 cavity numbering on samples; blocks
    board release only
    - GATE-MCU-01 widened to all 257 balls; GATE-SUP-04 adds FXOSC failure
    - Parked budget ≈52 µA typical with the 3.5 µA TPS7B8133-Q1
    - Site uses the schematic net names (RESET_L, T1S_IRQ_L, *_FLT_L)
    - CLAUDE.md: the confirmed thresholds, PHY reset, EMI filter, TMP175
    package and page order
    [parts.yaml]
2026-10-28 DEC-015: place the ABM8AIG 16 MHz crystal on p4
    - Y401 ABM8AIG-16.000MHZ-8-1Z-T on EXTAL (K1) / XTAL (L1), C424/C425
    10 pF C0G (GCM1555C1H100JA16D), R408 0R RsEXT, as NXP FRDM-A-S32K344
    - Library pinned to dropout-kicad-library PR #35 head 51ade76
    (adds the three crystal candidates and the 10 pF capacitor)
    - parts.yaml: selection, alternates, prices and library links;
    DEC-015 gains the start-up margin and drive-level numbers
    [mcu-nvm.kicad_sch]
2026-10-28 Pin DropOut library to main 618de03 (PR #35 merged)
    The re-pin also brings library PRs #31, #33 and #34 (manufacturer names,
    ATM13 Notes, catalog data). Their field changes are copied into the
    schematic so every placed symbol matches the library: "Amphenol Sine
    Systems", "Stackpole Electronics", "Murata", and the full ATM13 Notes.
    [connectors.kicad_sch, output-switch.kicad_sch, power-entry.kicad_sch]
2026-10-28 GATE-MCU-01 passed: S32K344 package map audit
    All 257 U401 balls cross-checked against NXP's IOMUX table (RM, Nov
    2025), the 257BGA IBIS model and BSDL file (HW design package Rev. E2):
    no differences; every used signal has its planned function on its
    ball. The user signed off on 2026-10-28.
    - gates.yaml: status passed, result page validation/gate-mcu-01
    - Result page with method and the schematic's pin plan (NXP select
    values stay in the private review sheet)
    - Compute page, parts.yaml, CLAUDE.md and the p4 note updated
    [mcu-nvm.kicad_sch]
2026-10-29 DEC-016: REDCUBE power terminals with SurLok Plus and a pass-through
    The user chose the power entry on 2026-10-28: four Würth REDCUBE SMT
    74660016R M6 terminals (J901/J910 battery, J902/J911 return) with
    Amphenol SurLok Plus SLPRATPSR (red) and SLPRATPSB (black) receptacles
    screwed in, one pair on each side of the case, busbar-joined inside.
    The second pair passes battery and ground to a downstream node.
    - DEC-016, parts (74660016R, 74660016 bulk alternate, SLPRATPSR/B),
    new GATE-HAR-02 (power entry and pass-through current path)
    - REQ-NET-001 allows the pass-through; harness page, power diagram
    - p9: placeholders replaced by the four terminals; Würth footprint
    library added to fp-lib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
    [connectors.kicad_sch]
2026-10-29 DEC-016: 40 A provisional limit on the downstream pass-through
    At 60 A downstream the upstream SurLok 5.7 mm receptacle and REDCUBE
    would carry 120 A, the top of the SurLok class with no +125 °C derating
    data and above one REDCUBE's 85 A. The user set 40 A for now (100 A
    upstream); the busbar carries the pass-through, J910/J911 stay tied on
    the board. GATE-HAR-02 confirms it or raises it toward 60 A.
    [connectors.kicad_sch]
2026-10-29 DEC-017: T1S bus pass-through and relay-switched termination
    The user asked for a second T1S connector so a downstream node can join
    the bus, and a termination that can be switched between bus end and
    mid-bus (2026-10-28).
    - p9: J912, a second ATM13-2P-BM04 in parallel with J903
    - p5: R502 (single 100R, not fitted) replaced by the OPEN Alliance
    split termination: latching relay K501 (Omron G6KU-2F-Y-T1-TRS DC3,
    +125 °C) selects 49.9R (end, SET) or 1.5k (drop, RESET) legs to a
    centre tap with 100nF || 100k; Q501/Q502 (DMC2710UVQ-7) half-bridges
    drive the coil from 3V3_MAIN
    - p4/root: PTD0 -> T1S_TERM_END, PTD1 -> T1S_TERM_DROP
    - Library pinned to dropout-kicad-library PR #37 head db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
    [connectors.kicad_sch, mcu-nvm.kicad_sch, node60.kicad_sch, t1s.kicad_sch]
2026-10-29 Pin DropOut library to main c6bb26b (PR #37 merged)
2026-10-29 DEC-012 rev. B: DC block on the connector side of the choke
    Microchip AN1718 rev. D (the LAN8670 data sheet's line-interface
    reference), OPEN Alliance's implementation spec (Figure 4) and both
    Microchip LAN8670 evaluation boards order the line interface
    connector -> ESD -> termination -> DC block -> CMC -> PHY. Node60 had
    the choke on the connector side. The user approved the swap on
    2026-10-29.
    - p5: FL501 moved next to the PHY, C511/C512 to the bus side; no part
    changes; windings unchanged (1-4 P, 2-3 N)
    - DEC-012 rev. B with the old order as a rejected option; layout notes
    on p5, p9 and in DEC-017 follow
    - AN1718 and the two evaluation board schematics archived in
    dropout-vendor-do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
    [connectors.kicad_sch, t1s.kicad_sch]
2026-10-29 Follow DropOut Hardware Handbook v0.10.0
    - CLAUDE.md: handbook v0.4.0 -> v0.10.0; project questions 5-7
    recorded (Grade 1 -40..+125 °C; sealed IP67-target enclosure with
    vehicle vibration, no conformal coat; X7R/X7S/X8R/C0G only), the
    user's answers of 2026-10-29
    - scripts/check_schematic.py from the v0.10.0 board template: also
    catches auto-generated names on sub-sheet nets (/T1S/Net-(...)) and
    pins left unwired without a no-connect flag; Node60 passes (264 parts,
    321 nets)
    - CI step name matches the template
2026-10-29 Docs: MCU pinout page for U401 (S32K344)
    A pin-configurator view of the S32K344EHT1MMMST: ball map labelled with
    each ball's configured function (or net, or port), a detail panel per
    ball, and tables for pin configuration, peripherals in use, free
    interface instances and spare channels.
    - scripts/mcu_pinmap.py builds docs/src/data/mcu-pins.json from the
    schematic netlist and the library pins.csv; CI checks it is current.
    - docs/src/data/mcu-config.yaml holds the proposed firmware pad plan;
    the docs build fails if it disagrees with the schematic.
2026-10-30 One LPSPI bus per output switch (DEC-018); Zephyr as core RTOS (DEC-019)
    - Split the TPS2HCS08A daisy chain into three buses: U601 on LPSPI4 (Rev A
    balls), U701 on LPSPI5 (A16/A15/B13/G16), U801 on LPSPI3 (E14/F14/E15/G15).
    The output-switch sheet now exposes generic SDI/SDO/SCK/CS_L ports.
    - Per-switch SPI watchdog (400 ms) with limp-home off: a lost bus turns only
    that switch's two outputs off.
    - DEC-019 records Zephyr with a driver map; pin plan reviewed against
    upstream Zephyr (EIRQ map, ADC group-channel, native PCS). No other pin moves.
    - GATE-MCU-01 reopened for the eight new balls (IBIS/BSDL machine check done,
    user sign-off pending). Rev B (in progress) listed on the revis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
    [mcu-nvm.kicad_sch, node60.kicad_sch, output-switch.kicad_sch]
2026-10-30 DEC-019: Node60 writes its own TMP175 driver
    The user chose a dedicated TMP175 Zephyr driver (12-bit mode, ALERT as a
    sensor trigger) over the register-compatible upstream lm75 driver.
2026-10-30 GATE-MCU-01 re-run passed; test points on every SPI5 and SPI3 line
    - The user signed off GATE-MCU-01 for DEC-018's eight added balls (2026-10-30);
    gate status back to passed on the gates list, gate page, DEC-018, compute and
    revisions pages, CLAUDE.md and the p4 design notes.
    - TP413-TP416 (SPI5_SWITCH2_SCK/MOSI/MISO/CS_L) and TP417-TP420 (SPI3_SWITCH3_*)
    added as a second row in the p4 Test points box; box grown and the design
    notes moved down to fit. Netlist checked; ERC unchanged.
    [mcu-nvm.kicad_sch]
2026-10-30 Schematic: show passive ratings, MPN and pin numbers without overprinting
    Every two-terminal passive now shows its pin numbers, value, ratings and MPN
    (user decision 2026-10-29). The fields are stacked (Reference / Value /
    ratings two per row / MPN at 0.8 mm) and moved to another side or into
    fewer rows where space is short (user, 2026-10-30).
    Crowded groups were spaced out by widening their dashed boxes; the T1S PHY
    supply bank, VDDAU pair, C514, C401-C405, L301/L302 and the R604/R606 group
    on the output sheet were placed by hand. R604 now sits above the FLT line
    (rotated so pin 2 stays on SW_VDD); before, the SNS wire ran through it.
    T1S (p5) moves from A2 to A1.
    Netlist identical to mai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
    [mcu-nvm.kicad_sch, output-switch.kicad_sch, power-entry.kicad_sch, regulators.kicad_sch, t1s.kicad_sch]
2026-10-30 DEC-011 rev. B: log-flash second source W25Q32JVSSSQ -> W25Q32JVSNSM
    Winbond's SS package code is the 208-mil SOIC-8 (W25Q32JV-M datasheet
    rev. E, section 11), so W25Q32JVSSSQ does not fit the IS25LP032D-JNLA3
    150-mil footprint. W25Q32JVSNSM is the 150-mil, Automotive Grade 1 code
    from the datasheet's part-number table; the exact orderable code is to be
    confirmed with a distributor. Decision, parts list, firmware page and the
    Rev B list updated; the old code is kept as a rejected option.
    [parts.yaml]
2026-10-30 DEC-020: flipped 2.6 mm board, enclosure connector placement, 3D mockup
    The board mounts component side down under the lid and is 2.6 mm thick,
    so the SurLok Plus receptacles in the lid reach the REDCUBE 74660016R
    terminals through the board (user's decisions, 2026-10-30).
    - PCB: J901-J912 placed and locked, 250 x 160 mm provisional outline,
    2.6 mm thickness. Outputs on a 40 mm pitch; KiCad view mirrored
    against the outside view (scripts/place_connectors.py).
    - Lid terminals on a symmetric grid: battery +-48 mm, return +-75 mm.
    scripts/check_surlok_clearance.py checks all 81 west/north/east plug
    combinations and keeps east/west plugs inside the walls.
    - Architecture site: DEC-020, h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
    [node60.kicad_pcb]
2026-10-30 DRC: unrouted connections are warnings while layout is in progress
    CI's DRC (errors fail) started running once the board got its outline,
    and failed only on the 10 unrouted connections between the placed
    connectors. Set unconnected_items to warning in node60.kicad_pro so every
    other DRC and parity error still fails CI (user's decision, 2026-10-30).
    Recorded in CLAUDE.md as a temporary deviation: restore to error before
    routing is signed off and before any rev tag.
2026-10-30 Docs: generated, dimensioned enclosure drawing
    New "Enclosure & mechanical" page with a third-angle drawing of the
    enclosure: lid, front and side views with every panel cutout dimensioned
    from the outer faces, plus cutout details and a key-dimensions table.
    The drawing is generated at docs build time (npm run drawings) so it
    follows the design: scripts/enclosure_geometry.py reads the board and
    connector positions from place_connectors.py and holds the enclosure
    assumptions (wall, gaps) and the panel cutouts from Amphenol's drawings;
    scripts/enclosure_drawing.py writes the SVG views and a JSON the page's
    table reads.
    The ATM13 height and mating axis (28.48 / 15.0 mm) come from Amphenol's
    ST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
2026-10-30 Enclosure drawing on the handbook's enclosure-drawing skill
    scripts/enclosure_drawing.py is now the skill's board-independent engine
    (dropout-hardware-handbook PR #13); scripts/enclosure_geometry.py becomes
    Node60's adapter, whose spec() builds the geometry spec from
    place_connectors.py. The docs page uses the skill's Drawing and
    EnclosureTable components and renders whatever views the engine lists.
    Same views and numbers as before; --check passes (12 cutouts).
2026-10-30 DEC-021: board component side up, busbars, raised-T lid, T1S on north wall
    The user changed the mechanical design on 2026-10-30 and accepted it after
    reviewing the 3D mockup and the drawing. Supersedes DEC-020.
    - PCB: component side up again (KiCad view = view from above). REDCUBE
    74660016R on B.Cu; J903/J912 in the middle of the north edge, 45 mm apart;
    lid terminals at +-70 mm, one battery/return pair each side. Busbar
    outlines on User.Drawings.
    - Busbars: 1/8" x 1" C110 copper flat bar (25 x 3 mm metric), cut and drilled
    in house: 165.4 mm long, 2 x 6.5 mm holes 140 mm apart. The thinnest stock
    bar that carries the current, so most of the SurLok stud reaches the
    REDCUBE threa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
    [node60.kicad_pcb]
2026-10-30 Enclosure options: five candidate designs, each drawn, checked and in the mockup
    The user wants to keep several mechanical designs as ways forward
    (2026-10-30). Each is a parameter set in VERSIONS (place_connectors.py):
    - v1: DEC-020, board component side down, flat lid, T1S on the side walls
    - v2: DEC-021, busbars on the board, raised T, T1S on the north wall (PCB)
    - v3: T1S on the side walls next to the outputs, one raised front band,
    power receptacles staggered behind it
    - v4, v5: v2 and v3 with REDCUBE press-fit 786202106 terminals and the
    busbars on the blocks (the step shrinks to 1.6 mm)
    enclosure_geometry.spec(version) builds each enclosure; enclosure_versions.py
    draws them all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
2026-10-31 Enclosure version 6: outputs on three walls
    Version 2 with two outputs on each of the west, south and east walls
    (OUT1-2 west, OUT3-4 south, OUT5-6 east, numbered going round the
    board) and the T1S pair kept on the north wall. The side-wall outputs
    sit one in each corner so an outward SurLok plug passes between their
    raised sections; the receptacles are staggered as in version 3. Lid:
    a raised front band, raised back corners and a T1S hood.
    - place_connectors.py: per-version output walls; v6 layout.
    - enclosure_geometry.py: side-wall AT13 cutouts, "corners" lid.
    - check_surlok_clearance.py (and the mockup): each receptacle flange
    must stay 2 mm from a raised section.
    - enclosure_drawing.p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
2026-10-31 Enclosure versions 7 and 8: no T stem; MCU board under the main board
    Version 7: version 2 without the T's stem. A raised band across the
    front covers the outputs and a separate hood covers the T1S pair; the
    receptacles are placed as in version 6 (staggered).
    Version 8: version 7 plus a provisional 120 x 80 mm MCU board under the
    main board. The T1S pair J903/J912 sits on it and stands up through a
    notch in the main board's north edge. A 10 mm board gap (9.5 mm
    minimum) lets the ATM13s fit under the low lid, so the T1S hood goes;
    the enclosure grows 8 mm. place_connectors.py refuses version 8 until
    the design is split into two boards.
    - enclosure_geometry.py: MCU board stack, notch, per-cu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
2026-10-31 Enclosure version 6: 139 mm deep board; cable and flange checks
    Version 6's board is 139 mm deep instead of 160 (outside 146 mm), about
    the least that passes every check. Boards can now set their own depth
    (`depth`; the north edge stays at Y0).
    The plug check now runs each plug's cable (11 mm, assumed for 25 mm²)
    straight on past the walls, 2 mm clear of the raised sections, and
    keeps the receptacle flanges 2 mm apart. The cable check found that
    in versions 6 and 7 a battery plug pointing north laid its cable over
    the T1S hood's edge, so the battery receptacles move out to 52 mm
    from the centre line and the return receptacles to 78 mm (versions
    6-8). The mockup runs the same checks.
    Co-Au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
2026-10-31 Version 2: staggered receptacles, T1S 41 mm apart; cable vs receptacles
    The plug check now runs each plug's cable against the other
    receptacles and plugs, not only the raised sections. It found that in
    versions 2 and 4 a battery plug pointing north laid its cable over the
    return receptacle behind it.
    Versions 2 and 4: battery receptacles 57.5 mm and return 78.7 mm from
    the centre line (were 70), so a north cable passes beside the return
    receptacle. To make room beside the T stem, J903/J912 move from 45 to
    41 mm apart (user; 41.98 mm is the most that works). Versions 6-8 keep
    45 mm. node60.kicad_pcb re-placed (version 2); DRC with schematic
    parity is clean. DEC-021 records the change.
    Versi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
    [node60.kicad_pcb]
2026-10-31 Version 7: T1S pair 41 mm apart, as in version 2
    The T1S hood narrows by 4 mm with it. All 16 plug combinations clear;
    versions 6 and 8 keep 45 mm.
2026-10-31 Enclosure docs: PCB size for every version
    The overview table gains a PCB column, each version page's PCB row
    gives the outline, thickness and position in the enclosure (and the
    MCU board where there is one), and the mockup's side panel shows them
    too. All read from the same placement data as the drawings.
2026-10-31 Enclosure: removable north panel for v2/v7; T1S 40 mm; board-fitting check
    - check_assembly.py (new): how each version's boards go into the case.
    A header's shroud passes through a closed cutout, so a board slides
    toward its headers' wall; a board with headers on two one-piece walls
    needs a split case. Versions 1 and 3-6 need one.
    - Versions 2 and 7 (user, 2026-10-31): the north wall is a separate
    panel. The board is lowered 15.1 mm north, slid south into the
    one-piece front wall, then the panel slides 13.4 mm south onto the
    T1S shrouds. Sliding over its standoffs needs a 15.1 mm keep-out
    strip south of each mounting hole on the underside.
    - Versions 2, 4 and 7: J903/J912 40 mm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
    [node60.kicad_pcb]
2026-10-31 Enclosure: 4 mm lid with M4 bosses; v4 flat lid; lower v2/v4/v7
    - Lid 4 mm (machined from solid; walls and floor stay 3 mm), with an
    Ø8 x 4 mm boss under each SurLok receptacle's M4 holes for 8 mm of
    thread. Raised sections keep their header clearance, so their tops
    rise 1 mm; the low lid's outer face is set by the receptacles.
    - Version 4: flat lid at the headers' height with a 31 mm square,
    2.6 mm seat for each receptacle (lid thickened under the seats),
    1/8" busbars and 4.5 mm of stud kept; removable north panel as in
    version 2.
    - Versions 2, 4 and 7: board 5 mm off the floor (only 3 mm of
    REDCUBE body or press-fit pin hangs below), so all three are
    46.1 mm tall.
    - Drawin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
2026-10-31 Versions 2 and 7: raised sections 1 mm above the headers
    The clearance from the tallest header (the T1S ATM13s) to the inside of
    a raised section drops from 3 to 1 mm (user), so the raised step over
    the low lid is 11.1 mm and the enclosure 44.1 mm tall. In plan the
    raised sections still reach 3 mm past the headers. All checks pass.
2026-10-31 DEC-022: enclosure version 4, press-fit terminals and a flat lid
    The user chose enclosure version 4 (2026-10-31): a flat lid simplifies
    the mechanical design and seals on one level instead of across the
    vertical faces of a step.
    - DEC-022 (accepted, Rev B, supersedes DEC-021): Würth REDCUBE
    PRESS-FIT 786202106 terminals (180 A, M6 blind thread) on F.Cu with
    the 1/8" x 1" busbars on the blocks; flat 4 mm machined lid with a
    2.6 mm seat and M4 bosses per SurLok receptacle; board 5 mm off the
    floor; removable north panel. DEC-016's receptacles and pass-through
    stand; its terminal part is replaced.
    - Parts: 786202106 selected (4), 74660016R now an alternative (0).
    - Schematic: J901,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
    [connectors.kicad_sch, node60.kicad_pcb]
2026-11-01 Revert "DEC-022: enclosure version 4, press-fit terminals and a flat lid"
    This reverts commit db153a3. The user chose enclosure version 7 instead
    (2026-11-01).
    [connectors.kicad_sch, node60.kicad_pcb]
2026-11-01 DEC-022: enclosure version 7, front band and T1S hood
    The user chose enclosure version 7 on 2026-11-01. DEC-022 now records it
    (the number was first used for version 4, reversed in the previous
    commit) and supersedes DEC-021.
    - Decision: DEC-021's board, SMT REDCUBE 74660016R and busbars, 5 mm off
    the floor; a lid with a raised front band over the outputs and a
    separate T1S hood, both 1 mm above the tallest header; staggered
    receptacles (battery 52 mm / 58 mm, return 78 mm / 105 mm); removable
    north panel. Outside 257 x 167 x 33.0 mm, 44.1 mm at the band and hood.
    - PCB: CURRENT = v7; J901, J902, J910, J911 moved. DRC with schematic
    parity clean; plug check 16/16 (tightest 0.9 mm)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
    [node60.kicad_pcb]
2026-11-01 Enclosure version 9: version 7 with the connectors as close as they go
    A candidate to find the smallest board for the version 7 design
    (user, 2026-11-01): 249.5 x 110 mm (version 7: 250 x 160), outside
    256.5 x 117 x 44.1 mm. The PCB stays on version 7 (DEC-022).
    - Outputs at a 37.3 mm pitch and the T1S pair 39 mm apart (1 mm between
    courtyards); battery receptacles 53 mm from the centre line (plug
    pointing north 3 mm beside the T1S hood), return 78.5 mm; return row
    set by the GND busbar 1 mm from the T1S courtyards, battery row 29 mm
    further, front edge 40.1 mm beyond. Each dimension is at its limit
    (0.5 mm tighter fails); derivation in the V9_* comment.
    - place_connectors.py: per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
2026-11-01 Version 9: outward plugs overhang the side walls; board 230 x 110 mm
    User, 2026-11-01. Version 9 lets a SurLok plug pointing west or east
    reach past the side walls, so the outputs set the width instead of the
    return plugs: the outer panel seals end where the machined base's inside
    corner starts (R5 assumed, a 10 mm cutter), putting the side walls
    115.85 mm from the centre line. The board is a round 230 mm and stops
    0.85 mm short of them, since only the front wall locates it. Outside
    237.7 x 117 x 44.1 mm; a plug pointing outward reaches up to 5.8 mm past
    the side wall.
    - place_connectors.py: per-version overhang and side_gap; POCKET_R.
    - check_surlok_clearance.py and the mockup's check skip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
2026-11-01 Import every schematic footprint onto the PCB, piled by sheet beside the outline
    scripts/import_footprints.py adds the 258 parts not placed by place_connectors.py,
    unlocked, south of the front edge, one pile per sheet, with nets and symbol paths.
    C207 and L201 (EMI filter, values follow the emissions test) have no footprint yet.
    [node60.kicad_pcb]
2026-11-01 Enclosure version 10: version 7 on a 2.0 mm board
    A candidate (user, 2026-11-01); the PCB stays on version 7 at 2.6 mm.
    The SMT REDCUBE's 2.6 mm spigot stands 0.6 mm proud of a 2.0 mm board,
    so the busbar rests on the spigots alone: the joint clamps no laminate,
    and the busbar, receptacles, low lid and stud engagement (4.5 of 5.6 mm)
    stay where version 7 has them. The headers stand 0.6 mm lower, so the
    front band and T1S hood drop 0.6 mm (10.5 mm step, 43.5 mm overall), and
    their pin tails come through 0.7-1.5 mm instead of 0.1-0.5 mm. Whether
    Wurth allows the spigot to stand proud is not confirmed.
    - place_connectors.py: per-version board thickness; v10.
    - enclosure_geometry.py: the busbar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
2026-11-01 DEC-023: board 2.0 mm thick, enclosure version 10
    The user chose version 10 (version 7 on a 2.0 mm board) on 2026-11-01.
    JLCPCB builds 6 and 8 layers only up to 2.0 mm, so 2.6 mm left PCBWay
    alone at about 2.5 times the prototype price (instant quotes, 5 boards,
    6 layers 1/2 oz: about $290 against $745). The REDCUBE 74660016R's 2.6 mm
    spigot stands 0.6 mm proud, so the busbars rest on the spigots; the raised
    lid sections drop 0.6 mm and the header pin tails come through 0.7-1.5 mm.
    Wurth has not yet confirmed the proud spigot; that blocks board release.
    - DEC-023 supersedes DEC-022; DEC-022 marked superseded.
    - place_connectors.py: CURRENT = "v10", v10 decision DEC-023.
    - node60.kicad_pcb p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
    [node60.kicad_pcb]
2026-11-01 PCB: 6-layer JLCPCB stackup (JLC062012-1080) and fab rules
    2.0 mm, 1 oz outer / 2 oz inner, ENIG, from JLCPCB's stackup data:
    F.Cu 35 um | 0.1375 1080 | In1 GND 61 um | 0.55 core | In2 PWR |
    0.311 2116 | In3 PWR | 0.55 core | In4 GND | 0.1375 1080 | B.Cu 35 um.
    Layer roles: signals outside, ground on In1/In4, power on In2/In3.
    Design rules from JLCPCB's 6-layer capability: 0.1 mm track and gap,
    0.2 mm drill / 0.35 mm via, 0.3 mm copper to edge. Default class
    0.2 / 0.15 mm, via 0.45 / 0.25. T1S_100R class for the T1S pair
    (0.165 mm, 0.15 mm gap, IPC-2141 estimate on L1 over In1).
    Provisional until the stackup and fab house are recorded in the
    architecture. The unconnected-items override (PR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
    [node60.kicad_pcb]
2026-11-01 PCB: place all parts, version C (bottom side except small decaps)
    KiCadRoutingTools place_simple, seed 0, then two pose repairs (RT201 at
    R201, Y401 at U401 K1). 218 parts on B.Cu with the REDCUBE terminals; the
    44 0402/0603 decoupling caps stay on F.Cu. Template members of the two
    LMQ66430 stages and the 1206/1210 caps stay with their chips on B.Cu.
    Floorplan checks clean (crystal 3.5 mm, NTCs, decaps 5 mm, output links),
    check_assembly buildable, CI DRC with parity passes (silk warnings only).
    Open: K501 (5.6 mm), J401 (5.6 mm plus the cable plug) and D201 (4.85 mm)
    are taller than the 5 mm gap under the board; raise the board in the case
    or move those three to F.Cu.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
    [node60.kicad_pcb]
2026-11-02 Enclosure version 11: version 9 on a 2.0 mm board
    A candidate (user, 2026-11-01); the PCB stays on version 10 (DEC-023).
    Version 9's plan (230 x 110 mm board, outputs at 37.3 mm, T1S 39 mm,
    outward plugs overhanging the side walls) with version 10's heights:
    the busbar rests on the REDCUBE spigots 0.6 mm above the 2.0 mm board,
    and the front band and T1S hood are 0.6 mm lower. Outside
    237.7 x 117 x 43.5 mm.
    - Checks: plug check 16/16 (tightest 2.0 mm, flange to flange),
    assembly fits, 12 cutouts OK, docs build passes.
    - Docs: version 11 page, options text, sidebar, mockup; CLAUDE.md.
2026-11-02 PCB: version C with K501, J401 and D201 on the top
    The relay K501 (5.6 mm), the debug header J401 (5.6 mm, and on top so an
    installed board can be programmed) and the TVS D201 (4.85 mm) are taller
    than the 5 mm gap under the board, so they go on F.Cu; everything else
    stays on B.Cu except the 0402/0603 decoupling caps.
    Re-placed with place_simple (seed 3, clustered), then pose repairs for
    RT201, U203 and Y401. Floorplan checks clean, check_assembly buildable,
    CI DRC with parity passes (silk warnings only).
    [node60.kicad_pcb]
2026-11-02 Enclosure version 12: version 11 on a 1.6 mm board
    Version 9's compact plan (230 x 110 mm) on a 1.6 mm board. The REDCUBE's
    2.6 mm spigot stands 1.0 mm proud and the busbar rests on it, so the
    receptacles, low lid and stud engagement stay as in versions 9 to 11.
    The front band and T1S hood are 1.0 mm lower than version 9's (10.1 mm
    step, 43.1 mm overall); header pin tails come through 1.1-1.9 mm.
    Open: Wurth's OK for a 1.0 mm proud spigot; the board is about half as
    stiff as a 2.0 mm one.
    - Checks: plug check 16/16 (tightest 2.0 mm), assembly fits, 12 cutouts
    OK, docs build passes.
    - Docs: version 12 page, options text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
2026-11-02 PCB: enclosure version 11 board, parts placed bottom side
    Trial on the compact version 11 board (230 x 110 mm, outputs at 37.3 mm,
    2.0 mm thick; a candidate, DEC-023 keeps version 10): place_connectors.py
    v11, then the version C rules re-run with place_simple (seed 3,
    clustered). Everything on B.Cu except the 0402/0603 decoupling caps and
    K501, J401 and D201 (taller than the 5 mm gap; J401 on top for
    debugging an installed board). Busbar keep-outs follow the v11 busbars.
    Floorplan checks clean, check_assembly buildable, CI DRC with parity
    passes (silk warnings only). C419/C420 sit just outside U401's east
    ball rows; check the escape when routing.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
    [node60.kicad_pcb]
2026-11-02 Enclosure version 13: version 11 with RADLOK receptacles
    Amphenol RADLOK 5.7 mm feed-throughs RL9057-101-F1RE / -F1 and right-angle
    plugs RL00571-25RE / -25BK instead of SurLok Plus, from the DropOut
    library's drawings and measured STEPs.
    - Panel face 14.2 mm above the busbar (drawing; the STEP gives 13.35),
    against SurLok's 19.2. The receptacle takes a 3 mm panel at most, so
    the 4 mm lid gets a 29 mm square seat 1 mm deep at each one.
    - 10 mm stud: takes the REDCUBE's whole 5.6 mm thread and comes out
    below it, so the board sits 6.2 mm off the floor (tip 2 mm above it).
    Low lid 30.2 mm with 15.0 mm under it; 44.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
2026-11-02 Docs: power receptacle comparison, RADLOK vs SurLok Plus
    New page under Enclosure options comparing the two M6-threaded 5.7 mm
    receptacles section by section, from Amphenol's drawings and STEP
    models: a to-scale drawing aligned on the seating face, a table, and
    side and angled renders of Amphenol's models on REDCUBE terminals.
    It flags, without changing the geometry, what the SurLok drawing changes
    for the enclosure versions: the stud is 9.95 mm beyond the seat (not the
    7.7 mm estimate), and 19.2 mm is the panel face to the stud tip, not to
    the seat (9.25 mm). Also flags that Amphenol lists RADLOK as IP40 mated.
    The enclosure overview's caution box and SurLok source line point to it.
    Source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
2026-11-02 Correct the SurLok receptacle geometry from Amphenol's drawing
    enclosure_geometry.RECEPTACLES["surlok"] used the library's estimated
    7.7 mm stud and took the catalogue's B - A - C (19.2 mm) as the seat to
    panel face depth. Amphenol's drawing C10-730187 rev. F and STEP give a
    9.95 mm stud beyond the seat and 9.25 mm from the seat to the panel face;
    19.2 is the panel face to the stud tip. Flange 3.0 mm (was 2.5).
    In the busbar versions (2, 7, 9-12) the low lid drops 8.8 mm (24.2 mm
    outside), parts under it get about 9 mm above the board instead of 19,
    the lid bosses end 1.25 mm above the busbar, and the stud takes the
    REDCUBE's whole 5.6 mm thread and comes out below it, so the board sits
    6.1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
2026-11-02 PCB: move D201 1.5 mm east, clear of J901's lid boss
    With the SurLok geometry corrected (Amphenol drawing C10-730187; node60-hw
    PR #26) the low lid's M4 bosses end 5.03 mm above the board. D201
    (XLD8A24CA, DO-218AC, 4.85 mm tall) sat under the edge of J901's Ø8 boss:
    its courtyard 0.28 mm into the boss's footprint, 0.18 mm below it. Moved
    from x 226.323 to 227.823: now 1.22 mm clear of the boss in plan, with
    4.18 mm under the low lid. No tracks yet; DRC unchanged (613 warnings,
    no errors, no courtyard overlaps). Every other part was checked against
    the corrected enclosure (version 11) and fits.
    [node60.kicad_pcb]
2026-11-02 DEC-024: compact 230 x 110 mm board, enclosure version 11
    The user chose version 11 (version 9's compact plan on the 2.0 mm board)
    on 2026-11-01, after the placement trial on this branch fitted every part
    on the 230 x 110 mm board, nearly all on the bottom side.
    - DEC-024 supersedes DEC-023; DEC-023 marked superseded.
    - place_connectors.py: CURRENT = "v11", v11 decision DEC-024.
    - Enclosure, harness and revisions pages; CLAUDE.md board facts
    (outline, pitches, receptacle positions, outside size, which parts
    stay on top, quotes to redo at the new size).
    - Checks: plug check v11 16/16 (tightest 2.0 mm), assembly fits,
    12 cutouts OK, docs build passes.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
2026-11-02 Docs: JLCPCB quotes for the 230 x 110 mm board, stackups and via stack
    New page "PCB stackup & fab quotes" (pcb-fabrication.mdx) with four
    JLCPCB instant quotes taken 2026-11-01 for five 230 x 110 mm boards,
    S1000-2M, ENIG, 1 oz outer / 2 oz inner, 0.2 mm epoxy-filled vias:
    6L 2.0 mm $263.21, 6L 1.6 mm $193.01, 8L 1.6 mm $349.46,
    8L 2.0 mm $386.66. The page records every quote-form selection so
    the quotes can be rebuilt by hand, the price breakdown, JLCPCB's
    stackup table for each (JLC062012/061612/081612/082012-1080), the
    via stack, and screenshots of the form for each quote.
    Flags that the quotes use 1 oz outer copper while handbook chapter 05
    asks for 2 oz on high-current paths (not deci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
2026-11-02 Schematic: C302/C421 link Yageo's AC HiCap datasheet
    AC0603KRX7R6BB225 (2.2 uF 10 V X7R 0603) is in Yageo's AC HiCap
    series. Its symbol linked the standard AC NP0/X7R/X7S specification
    (V.25), which stops at 680 nF and doesn't cover the part. Point the
    Datasheet field at the Automotive Grade HiCap X7R/X7S specification
    (V.4, 5 Aug 2025), whose Table 3 lists 0603 2.2 uF 10 V at
    0.8 +/- 0.1 mm, AEC-Q200. Yageo's per-part spec sheet confirms the
    same values. MPN, DigiKey and Mouser numbers are unchanged (Mouser's
    603-C0603KRX7R6BB225 is its 20-character form of the MPN).
    The DropOut library still carries the old link (parts/passives.yaml,
    family yageo_ac_mlcc); fix it there too.
    Co-Authored-B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
    [mcu-nvm.kicad_sch, regulators.kicad_sch]
2026-11-02 Enclosure version 14: version 11 with 3/16" x 3/4" busbars
    A candidate, not a decision: version 11 (DEC-024) with 3/16" x 3/4"
    C110 busbars (4.76 x 19.05 mm) instead of 1/8" x 1". The bars are
    6.35 mm narrower, freeing about 2,230 mm2 of the top side along their
    edges, where the MCU and T1S decoupling caps sit, with 13 % more
    copper (90.7 against 80.6 mm2).
    On the thicker bar the SurLok's 9.95 mm stud engages 5.19 of the
    REDCUBE's 5.6 mm thread and ends 0.41 mm inside it, so nothing hangs
    below the terminal and the board drops back to 5 mm off the floor
    (6.17 in v11). The front band and T1S hood come out 1.2 mm lower
    (43.48 mm), the low lid 0.4 mm higher (24.61 mm), with 10.6 mm under
    it ab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
2026-11-02 Enclosure v14: compare its thread engagement with an M6 nut
    Version 14's 5.19 mm of REDCUBE thread is a full-height M6 hex nut's
    worth (ISO 4032: 4.9 to 5.2 mm; thin ISO 4035: 3.2 mm max). The
    threaded SurLok receptacle is normally fitted with a busbar and a nut:
    its 9.95 mm stud takes a bar up to about 4.75 mm under a 5.2 mm nut,
    so 3/16" is the thickest bar it is sized for. Würth's minimum
    engagement stays open.
2026-11-02 Update the DropOut library; refresh C302/C421 from it
    Moves lib/dropout-kicad-library from 05c2d2e to 7fabb21 (main), which
    includes the AC0603KRX7R6BB225 fix (library PR #43: Yageo AC HiCap
    family). C302 and C421 take the library's new Description ("Yageo AC
    HiCap automotive MLCC ..."); their Datasheet already matched (#29).
    ERC's two lib_symbol_mismatch warnings for them are gone.
    Nothing else on the board changes: no footprints changed in the
    library, and the only changed existing symbols are the SurLok Plus
    receptacles (SLPRATPSx), which aren't board parts. The update also
    brings 17 new symbols (RADLOK receptacles and plugs, SurLok Plus
    plugs) and their 3D models.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
    [mcu-nvm.kicad_sch, regulators.kicad_sch]
2026-11-02 Layout: busbar keep-outs (courtyard footprints BB901/BB902, F.Cu copper rule)
    place_connectors.py now draws each busbar as a generated board-only footprint
    (BB901 VBAT_IN, BB902 GND; out of the BOM and placement files) whose F.CrtYd
    is the bar outline with the REDCUBE spigot holes cut out, so KiCad's courtyard
    check keeps top-side parts from under the bars, which rest on the spigots
    0.6 mm above the board (DEC-023). A rule area BUSBAR_<net> of the same size
    lets the new node60.kicad_dru allow only the bar's own net on F.Cu there.
    kicad-cli 10.0.0 doesn't enforce a rule area's footprint keep-out, and a
    footprint rule in the .kicad_dru tests the whole bounding box, text included,
    so the court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
    [node60.kicad_pcb]
2026-11-02 Enclosure version 15 (DEC-025): 1/8" x 3/4" busbars, and the board re-placed for them
    Version 15 is version 11 with 1/8" x 3/4" C110 busbars instead of 1/8" x 1"
    (user, 2026-11-01): version 14's 6.35 mm narrower bar, at version 11's
    thickness, so the SurLok stud still engages the REDCUBE's whole 5.6 mm
    thread and every height is version 11's. DEC-025 chooses it and supersedes
    DEC-024; version 14 (3/16" x 3/4") stays as a candidate.
    The board is placed again for the narrower bars (KiCadRoutingTools
    place_simple, seed 2 of 4, the same groups and intent as version 11 with
    19.05 mm bar keep-outs; U203 and Y401 repaired next to Q202 and U401): 0
    floorplan errors, buildable, 215 parts on the bott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
    [node60.kicad_pcb]
2026-11-02 Layout: T1S first, K501 on the bottom under the trunk
    The user made T1S the board's priority (2026-11-01). Placement run again
    (KiCadRoutingTools place_simple, seed 2 of 4, version 15) with:
    - the line interface (K501, R516-R520, C514, D501/D502, C511/C512, FL501)
    in an exclusive bottom-side zone between J912's and J903's inner pins,
    under the trunk's midpoint (the top there is under the header housings);
    - K501's coil drivers within 8 mm of it;
    - the bucks' and LM74910's switch nodes kept 10 mm from every T1S line net;
    - the PHY's line pins within 12 mm of FL501 and the PHY within 25 mm of
    the MCU (RMII).
    Against main: K501's commons 8-15 mm from the trunk midpoint instead of
    40-47 m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
    [node60.kicad_pcb]
2026-11-02 Add the pcb-placement skill
    DropOut's placement process for Node60, combining KiCadRoutingTools'
    plan-pcb-placement (MIT, used in place) with ideas from ee-skills'
    pcb-placement and its siblings (no licence: restated, nothing copied;
    references/sources.md records what was taken and what was not).
    - A written plan first (plan.md + plan.json): stackup, layers, fixed parts,
    enclosure keep-outs and height limits, heat and quiet zones, critical nets
    with lanes, blocks and ports, net classes, high-current pads, assembly.
    - Read-only checks, written new: part_heights.py (model body, not every STEP
    point), escape_budget.py (BGA rings, layers, rule areas over the balls),
    layer_capacity.py, h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
2026-11-02 Busbar footprints carry the library's busbar 3D models
    place_connectors.py adds the DropOut_Busbar model of each bar to BB901/BB902 (raised
    0.6 mm onto the REDCUBE spigots) when the library models that bar; the name comes from
    the version's bar width, thickness, length and hole pitch. The library submodule moves to
    dropout-kicad-library add/busbars 31e9cfc (PR #44), which adds the models.
    The board itself is not regenerated in this commit: node60.kicad_pcb was open in KiCad.
2026-11-02 Layout: U401 and U501 clear of the busbars; 50 MHz clock beside the PHY
    The fast route of main's placement (KiCadRoutingTools autoplan) left 9 nets
    open, all stranded at U401's balls under the VBAT_IN bar: under a bar the
    copper rule (DEC-023, node60.kicad_dru) allows no other-net via, so a BGA
    there cannot escape. Re-placed (place_simple, seed 1 of 4) with U401 zoned
    in the north-east corner and U501 between it and the T1S zone, both north
    of both bars; T1S-first constraints unchanged. Repaired RT201, RT601, U203
    and Y401; moved Y501, R503 and R504 beside U501 (Y501 to the PHY's clock pin
    6.5 mm, was about 30) and D201 clear of J910's lid boss (2.4 mm); added the
    clock rows to the placement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
    [node60.kicad_pcb]
2026-11-02 Regenerate board: busbar 3D models on BB901/BB902
    Ran scripts/place_connectors.py; only BB901/BB902 change, each gaining
    its DropOut_Busbar STEP at z = 0.6 mm.
    [node60.kicad_pcb]
2026-11-02 Placement D01: tented vias of any net allowed under the busbars
    The user chose option B on decision page D01 (2026-11-02): F.Cu under a bar
    still carries only the bar's net in tracks and pours, but tented vias of any
    net may sit there. node60.kicad_dru drops 'via' from both busbar rules;
    DEC-025 and CLAUDE.md record it; plan v1 approved.
2026-11-02 Placement run: plan v2, decisions D02/D03 published; skill: via checks ask only about vias
    - escape_budget.blocking_areas takes blocks=("via",...); escape_budget.py and
    gate.py's via-site row ask only about via-forbidding areas, so D01's track-only
    busbar rule no longer reads as via-free.
    - lessons.md: net ties don't join same-net pads; track rules are not via rules.
    - plan v2: net tie (D02) and fiducials (D03) wait on decisions; U401 needs no
    scoped rule (0.1 mm track at 0.15 mm clearance escapes it); space_mm 0.15.
2026-11-02 Placement run: D03 answered (board fiducials), switchers.json, power-entry block and D04
2026-11-02 Placement run: D04 answered, power-entry block v1 approved
2026-11-02 VBAT_IN busbar BB901 as a schematic net tie; six board fiducials
    Placement decisions D02 (option A) and D03 (option A), 2026-11-02.
    - p9: J901 on its own net VBAT_IN_DOWNSTREAM; BB901 (DropOut_Busbar net tie)
    joins it to J910's VBAT_IN. FID901-FID906 (DropOut_Mechanical fiducials).
    - place_connectors.py: BB901 placed from its library footprint at the bar
    centre (rule area and outline as before, model raised 0.6 mm); BB902 stays
    generated; fiducials at measured v15 positions, three per side.
    - node60.kicad_dru: both nets of the VBAT_IN bar allowed under it.
    - Library submodule at karlTbowers/dropout-kicad-library#47's head.
    [connectors.kicad_sch, node60.kicad_pcb]
2026-11-02 DEC-016 rev. B: battery busbar BB901 is a board part; BB901 in parts.yaml
    The VBAT_IN busbar is now a schematic net tie between J910's VBAT_IN and
    J901's VBAT_IN_DOWNSTREAM (placement decision D02, #39), the only join
    between the two terminals. DEC-016 said both pairs stay tied on the board
    and the busbars are not board parts; revised in place to rev. B, with the
    old arrangement as a rejected option. GATE-HAR-02, the harness page and the
    Rev B list follow. parts.yaml gains the bar (made in house, on the BOM,
    library DropOut_Busbar), linked from DEC-016 and DEC-025.
2026-11-02 GND busbar BB902 on the schematic, like BB901
    Both busbars are now schematic and BOM parts from DropOut_Busbar (user,
    2026-11-02). BB902 sits on p9 between J911 and J902 with both pins on GND; the
    GND plane joins them as well. place_connectors.py places both bars from the
    library (reloaded every run) and no longer generates a board-only bar.
    DEC-016 rev. B, parts.yaml, DEC-025, the harness page, the Rev B list and
    CLAUDE.md follow; mcu-pins.json regenerated (BB902 joins GND).
    Library submodule at karlTbowers/dropout-kicad-library#48's head.
    [connectors.kicad_sch, node60.kicad_pcb]
2026-11-02 Skill: hot_loop measures footprints by courtyard, not by bounding box with text
    R304 read 0.0 mm from U303's SW pin; it is 1.5 mm (R305 2.55 mm).
2026-11-02 Placement run: main merged in, judging chain at the board's floors (fab overrides, router Python), candidate with the power block applied
2026-11-02 Placement run: candidate reaches fast-route DONE (KRT 0, board rules 0); gate fixes (KRT_PY, waivers, KIPRJMOD, height areas); run intent
2026-11-02 Placement run: D06 (buck cells) published
2026-11-02 Placement run: D06 answered, buck cells approved
2026-11-02 Placement run: buck pose tables, run-local nudge script (KRT under KRT_PY, refuses an unreadable floorplan check)
2026-11-02 Placement run: crystal and output-channel blocks composed on one board; channel cell copied to U601/U801; crystal no-via rule; chain routes crystal nets first on B.Cu
2026-11-03 Placement run: D07 (crystal) published; judging chain gets a targeted rip-up pass on the nets left open
2026-11-03 Docs front page: rendered enclosure hero, assembled and exploded
    The front page opens with renderings of enclosure version 15 (DEC-025):
    the black anodized case with keyed AT13/ATM13 cutouts and flange screws,
    the lid with its raised band and T1S hood, the SurLok Plus receptacles
    and plugs, and the board as placed in KiCad with its copper busbars.
    A CSS-only switch shows the assembled or the exploded view; the caption
    says it is a rendering, not a photograph.
    docs/scripts/render-hero.mjs (npm run hero) takes the geometry from
    enclosure-versions.json, exports the board and the SurLok models with
    kicad-cli, and renders docs/scripts/hero/scene.js in headless Chrome.
    It needs kicad-cli, so the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
2026-11-03 Docs front page: "One node per corner" pickup wiring concept
    A classic pickup in a warm cartoon style (generic, no maker's badging)
    with a Node60 at each corner. The truck shows first; the reveal fades
    the body to a ghost and draws the wiring on: the battery's fused feeds
    to the front and rear pairs, a power jumper within each pair, Hub 100
    under the dash chaining T1S to each pair, and each node's lamp outputs.
    It plays once when the drawing scrolls into view (not with reduced
    motion); a Truck / Wiring switch flips between the two. On phones the
    labels move to a key under the drawing.
    docs/scripts/render-vehicle.mjs (npm run vehicle, part of dev and
    build) draws it as plain SVG; VehicleWiri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
2026-11-03 pcb-placement: pose_search.py, a one-process pose search
    Loads the board once, screens every candidate pose in memory (courtyards,
    pad and hole clearance, edge, rule areas, a `require` expression) and runs
    KRT's check_floorplan and check_assembly once, on the result. Replaces the
    shell loops that ran KRT's tools per pose: five parts in 5 s, verify
    included, against about 30 min for one test point. A failed search names
    the parts in the way.
    SKILL.md (stages 3 and 4), blocks.md and lessons.md send repairs and
    nudges through it. block_poses.py check skips a table's anchor row.
2026-11-03 Placement run: D08 (output channel) published; judging chain routes the PHY's REFCLK and RBIAS after the T1S pair
    The three output cells are U701's, copied: U601 turned and moved, U801 moved
    so its fault pin routes, TP806 off J908 and four courtyard touches cleared
    with pose_search.py. Pose tables carry a reason per part.
    The chain routes REFCLK and RBIAS after the T1S pair and before the bulk
    passes, and ends with route_open.sh: up to three targeted rip-up passes on
    whatever is still open. One pin stays open on the composed board: U501 pin
    29 (3V3_MAIN), PASSABLE; the bulk pass rips its fan-out stub and does not
    restore it.
2026-11-03 Placement run: gate passes 11 of 15; D09 (gate) published
    Floorplan clean after C803 (0.05 mm) and TP402 (0.2 mm) cleared two courtyard
    slivers; pose_search keeps a 0.02 mm courtyard gap so it agrees with KRT's
    measure. The output tables are in the plan's block list; C803's new pose is
    recorded in U801's table. The chain routes REFCLK and RBIAS after the T1S
    pair. Open: busbar tie-pad overlaps (by design), schematic parity (same on
    main), U501 pin 29 (router churn at the PHY, PASSABLE).
2026-11-03 Placement run 2026-11-02-bars: apply the composed placement to node60.kicad_pcb
    62 parts move to the approved blocks' poses (power entry, T1S, both bucks,
    MCU crystal, three output cells) plus the pose_search repairs. Busbars,
    fiducials, rule areas and the outline are untouched. CI's DRC (errors and
    schematic parity) passes as on main.
    The gate passes 11 of 15; D09 (user: A) accepted the busbar tie-pad
    overlaps, the schematic parity counts main already had, and U501 pin 29,
    which the fast route leaves open (router churn on the PHY's 0.5 mm edge;
    every pin PASSABLE). REPORT.md has the gate, blocks, repairs, fast routes
    and what routing inherits. CLAUDE.md notes the run.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
    [node60.kicad_pcb]
2026-11-03 Docs front page: hero "Wired" view with front lamps on every output
    A third hero rendering beside Assembled and Exploded: a plug in each output
    driving a vehicle's front lamps (OUT1 DRL bar, OUT2 parking light, OUT3 turn
    signal, OUT4 fog light, OUT5/OUT6 a 7" headlight's low and high beams from one
    dual-filament bulb), quiet floor labels under each lamp, and the T1S twisted
    pairs run beside the return cables. Generic shapes drawn in scene.js, no
    makers' models.
    render-hero.mjs renders all three views by default and takes view names,
    --reuse, --ss and --out for quick trials. Assembled and exploded re-rendered
    from the current placement (#44).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
2026-11-03 Schematic parity: footprint fields from the schematic, pad test points out of the BOM
    kicad-cli's parity check reported 257 warnings on main (199 capped field
    mismatches, 56 attribute mismatches, 2 missing footprints). Now 21:
    - Every footprint gets its symbol's fields (Manufacturer, MPN, distributor
    numbers, Datasheet, Description, Notes...), hidden on Fab, by the new
    scripts/sync_footprint_fields.py. No position, pad, net or drawing changes
    (checked against main's board with pcbnew).
    - The 55 pad test points' placed symbols get in_bom no, as the library symbol
    and the footprint already say (handbook ch. 02: placed copies match the
    library). The probe loops stay in the BOM.
    - C21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
    [mcu-nvm.kicad_sch, node60.kicad_pcb, output-switch.kicad_sch, power-entry.kicad_sch, regulators.kicad_sch, t1s.kicad_sch]
2026-11-03 Docs front page: drop the hero's exploded view
    The hero switches between Assembled and Wired only; the exploded image, its
    switch button and CSS are removed. render-hero.mjs no longer renders it by
    default (it still can, by name).
2026-11-03 DEC-026: the 1.5 V core buck becomes a TPS628502-Q1 fed from 3V3_MAIN
    From the battery the LMQ66430's 65-75 ns minimum on-time folds U303 back
    to about 1.5-1.7 MHz at 13.5 V, inside the AM band with spread spectrum off.
    The LMQ66430 needs 3.6 V to start, so it can't move to 3V3_MAIN; the
    TPS628502QDRLRQ1 (2.7-6 V, 2 A, Grade 1, SOT-583) holds a fixed 2.25 MHz
    with spread spectrum there. User's choice, 2026-11-02.
    Decision record with the rejected options, parts data (LMQ66430 qty 1,
    TPS628502 selected, TPS628503 second source, dated observations), power and
    system pages, CLAUDE.md. Schematic and board follow once the library parts
    are in.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
    [parts.yaml]
2026-11-03 DEC-026 on the schematic and board: U303 is a TPS628502QDRLRQ1 on 3V3_MAIN
    Schematic (p3): U303 redrawn as the TPS628502-Q1 with VIN, MODE/SYNC
    (forced PWM) and COMP/FSET (internal 2.25 MHz, spread spectrum) on
    3V3_MAIN, EN on the existing 1V5_EN chain, PG unused. Input caps move to
    3V3_MAIN: C310 100 nF, C311 now 10 uF 16 V 1206; C312 and the LMQ66430's
    VCC cap C313 are gone. Divider R304/R305 76.8k/51k with C319 10 pF C0G
    feed-forward (TI Table 9-2); L302 744383560056HT 0.56 uH. The sheet's
    design-values note describes the new stage. ERC clean; the netlist changes
    only these parts and nets.
    Board: footprints and nets from the netlist (U303 SOT-583, C311 1206,
    C319 added, C312/C313 removed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
    [node60.kicad_pcb, regulators.kicad_sch]
2026-11-03 Library: dropout-kicad-library main (a86424e, PR #49 merged)
2026-11-03 Placement: D10 (U303 cell for the TPS628502-Q1) published; fast route of the board
    Every net in U303's cell routes; 3 nets stay open at the MCU and PHY (all
    PASSABLE), as in D09.
2026-11-03 Docs: regenerate the MCU pin map for DEC-026's U303 parts
    CI's mcu_pinmap.py --check found docs/src/data/mcu-pins.json out of date:
    the GND and 3V3_MAIN balls list U303's new parts (C310/C311 on 3V3_MAIN,
    R305 51k, U303's VIN, MODE/SYNC, COMP/FSET; C312/C313 gone).
2026-11-03 Placement: gate on the board after DEC-026; KRT Python moves to ~/.cache/dropout/krt-venv
    The gate passes 11 of 15 as at D09, U303's new cell included. The
    F-side height row confirms nothing under the low lid exceeds 9.0 mm;
    CLAUDE.md said that was not yet checked. The KRT environment that lived
    in a session scratch folder was gone; it is rebuilt with uv in
    ~/.cache/dropout/krt-venv and the plan names it.
2026-11-03 Power entry: C207 and L201 from the library, C217 not fitted
    C207 is now Nichicon GYF1H470MCQ1GS (47 uF 50 V hybrid polymer, CP_Elec_6.3x7.7),
    the damping capacitor of the VBAT_FILT pi filter; C217 beside it is the same part,
    marked DNP, for bench tuning (a second 47 uF, or 2 x 22 uF with C207). L201 is
    Wuerth 74438356022HT (2.2 uH, L_Wuerth_MAPI-4020), the same part as L301. User's
    choice on the decision page, 2026-11-03.
    parts.yaml gains the chosen parts and the alternates (HHXC500ARA220MF61G,
    EEH-ZC1H220P, VCHA042A-2R2MS6, SRP4020FA-2R2M); the power page's EMI filter row
    and CLAUDE.md's parity note name them; mcu-pins.json regenerated. Submodule at
    dropout-kicad-library#51 (head 3d91956)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
    [power-entry.kicad_sch]
2026-11-03 Library submodule: dropout-kicad-library main after #51 merged (c4d763c)
    node60-hw#49 merged with the submodule at the PR head 3d91956; this moves it to the
    merge commit on main. No content change.
2026-11-03 Board: C207, C217 and L201 placed (regulator-branch filter)
    The parts chosen in #49 (C207 Nichicon GYF1H470MCQ1GS 47 uF hybrid, C217 the
    same part DNP, L201 Wuerth 74438356022HT 2.2 uH) were missing from the
    board. scripts/add_missing_footprints.py adds what the schematic has and
    the board lacks, linked to its symbol and with its pads' nets, from the
    netlist; sync_footprint_fields.py then copied their fields and C217's DNP.
    Placed with pose_search.py: L201 on B.Cu at (112.75, 45.25), its VBAT_FILT
    pad toward U302's VIN; C207 and C217 on F.Cu at (108, 44) and (114, 50),
    8.01 mm tall under the 9.0 mm low lid, at least 8.5 mm from every lid boss.
    DRC 0 errors, schematic parity down to the 19 k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
    [node60.kicad_pcb]
2026-11-03 Docs: power tree after DEC-026 and the L201/C207 filter
    The system page's power flowchart (power.d2) now draws the tree as built:
    the L201/C207 EMI filter on the regulator branch only (VBAT_PROT ->
    VBAT_FILT -> U302), no longer in the 60 A path; U303 TPS628502-Q1 fed
    from 3V3_MAIN; an INH -> EN edge from the PHY to U302; C217 shown as not
    fitted. Pages that still said "the LMQ66430 bucks" or "2 x LMQ66430"
    (index, interfaces, power, temperature, system) name the two bucks;
    the power-cycle diagram drops the stale "bucks ramp within 1 ms"; Rev B
    lists DEC-026 and the filter parts; the source register gains the
    LMQ66430-Q1 and TPS62850x-Q1 data sheets and AN-2162.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
2026-11-03 Placement: final gate and fast route; D11 (ready for routing) published
    Every schematic part is on the board. Gate: 12 pass, 1 warning, 3 fail
    (busbar tie pads accepted in D09; fast route 3 nets / 10 items at U501
    and U401, all PASSABLE). REPORT.md gains an 'after D09' section and the
    routing hand-route list.
2026-11-03 DEC-027: 6-layer, 2.0 mm board on JLCPCB's JLC062012-1080
    The user chose the 6-layer, 2.0 mm JLCPCB stackup from the 2026-11-01
    quotes. Records it as DEC-027 (rejecting 1.6 mm, 8 layers and PCBWay),
    marks it on the stackup & fab quotes page and in Rev B's change list,
    and closes the "stackup and fab house" open item in CLAUDE.md and the
    placement skill's Node60 reference. The board file already carries
    JLC062012-1080. Outer copper weight, the via option and the layer roles
    stay open.
2026-11-03 Routing review D12: power-path model, per-layer escape count, seven decisions
    - power/plane_model.py: finite-difference resistance of the VBAT_PROT and
    GND planes from the board's pads, per load, alone and all on. With the
    plan's layer roles the supply to U601/U701/U801 is 0.35/0.68/0.88 mOhm
    (2 oz, 85 C); with VBAT_PROT on In2+In3 and GND on In1+In4 it halves.
    - escape_budget.py --layer-rules: each layer's own channel (ball side
    between balls, other layers between the dog-bone vias) and its own
    track/space. The old count called 4 layers enough when JLCPCB's 2 oz
    inner rules pass nothing between 0.45 mm vias; KRT fan-out trials show
    F+B alone escape all 55 signals at 0.1/0.1 mm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
2026-11-04 Placement: D12 answered; layer roles In1 GND, In2+In3 VBAT_PROT, In4 GND (D12-1 A)
2026-11-04 Placement: output cells turned to 0 deg and centred between their headers (D12-3; D13 published)
    All six output runs are now 15.70-15.80 x 15.02 mm from the switch pins
    to header pin 1. The cells turned whole, so every part keeps D08's
    relation to its pin; y 111.6 clears the VBAT_IN busbar's courtyard.
    DRC 0 errors, floorplan 0, assembly only the busbar tie pads; FLT and
    SNS pins PASSABLE. Waits on D13.
    [node60.kicad_pcb]
2026-11-04 Placement: D14 (input shunt and power-entry move) published
2026-11-04 Power entry: R201 = BVR-Z-R0003-1.0 Kelvin shunt, R208 26.7k, R210 383R (D14-1)
    Decision D14-1 A (2026-11-03): the input shunt R201 changes from the 2-terminal
    0.25 mOhm CSS2725FTL250 to the 4-terminal 0.3 mOhm Isabellenhuette BVR-Z-R0003-1.0.
    - R201 pads: 1 F1 = VBAT_D, 2 S1 = RS_SENSE_P, 3 S2 = RS_SENSE_N, 4 F2 = VBAT_Q2D.
    - RS_SENSE_P: R209 (RSET), R210 (RISCP), U202 IN+. RS_SENSE_N: U201 CS-, U202 IN-,
    and C212 (CSET) / C213 (CISCP, DNP), which LM74910H SNOSDE6C Fig. 8-7 and 9-1
    return to CS-. U201 VS and C stay on VBAT_D.
    - R208 R(ILIM) 32k TNPW0603 -> 26.7k AC0402FR-0726K7L: 74.8 A breaker.
    - R210 RISCP 0R -> 383R AC0402FR-07383RL: 24.0 mV = 80 A typ, 71.4-92 A.
    - DESIGN VALUES no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
    [power-entry.kicad_sch]
2026-11-04 Placement: power entry re-ordered to flow east (D14-2 B), D15 block page
    R201 on the BVR4026 land pattern between the FET pairs, Q203/Q204 turned to feed
    VBAT_PROT from x 161.4; 60 A path 45.6 mm (was 84.0); supply to the switches
    0.28/0.17/0.24 mOhm (was 0.19/0.31/0.43). New power pose table, awaiting D15.
    [node60.kicad_pcb]
2026-11-04 Records for D14-1: DEC-001/DEC-002 rev. B, parts data, 0.3 mOhm on the site
    - DEC-001 rev. B: BVR-Z-R0003-1.0 replaces CSS2725FTL250; R(ILIM) 26.7k (74.8 A),
    RISCP 383R (24.0 mV = 80 A, 71.4-92 A as before); 0.2 mOhm rejected (100 A trip);
    sense-net wiring per SNOSDE6C Fig. 8-7/9-1.
    - DEC-002 rev. B: INA228 CURRENT_LSB 260.4167 uA, SHUNT_CAL 4096 (ADCRANGE 1).
    - parts.yaml: BVR-Z-R0003-1.0 selected (DigiKey 5,311 at $5.20, 2026-11-03);
    CSS2725FTL250, BVB-Z-R0003-1.0 and WSLP4026L2000FEA as alternatives; OCP
    network and INA228 notes updated.
    - Every page, diagram and gate that stated 0.25 mOhm; interfaces net table now
    names RS_SENSE_P / RS_SENSE_N; revisions Rev B entry; CLAUDE.md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
    [parts.yaml]
2026-11-04 Library submodule: dropout-kicad-library main after #52 merged (06d9041)
2026-11-04 Board: R201 Kelvin sense nets, C212/C213 on RS_SENSE_N, R208 0402 26.7k, R210 383R (#54)
    Board updated to match the merged schematic: nine pads re-netted, R208 swapped
    to R_0402_1005Metric at its pose, fields synced. DRC 0 errors, parity 0 errors.
    [node60.kicad_pcb]
2026-11-04 D15 answered A: power entry block approved
2026-11-04 Routing rules (D12): DRU rules, net classes, rule areas, each proven to fire
    node60.kicad_dru: escape-area track floor, inner 2 oz 0.15/0.15, no vias on
    switch nodes, FB 1 mm from them, own nets only under Y401/Y501, PTH hole
    0.3 mm, high-current pads solid, silk 1.0/0.15, T1S coupling, skew, 0.75 mm
    spacing and 10 mm from switch nodes. Classes PWR_BATT/PWR_RAIL/SW_NODE; T1S
    class takes the K501 legs; mask web 0.10 mm. scripts/draw_rule_areas.py draws
    ESCAPE_U401/U501 and UNDER_Y401/Y501. rules/prove_rules.py: 24 of 24 pass.
    Real board DRC 0 errors, parity 0, ERC 0.
    [node60.kicad_pcb]
2026-11-04 D12-6: count vias at 0.65 A; gate prints free/needed sites per pad
2026-11-04 T1S: PHY chain moved north of the trunk's midpoint, K501 centred on it (D16, pending)
    U501, FL501 and C511/C512 now run straight north from the trunk's midpoint
    (x 155): PHY stub 12.5/12.5 mm P/N, was 26.0/31.3. K501 moved 2.8 mm west to the
    midpoint, so an end node dangles the same from either port. Termination and
    clock parts re-placed around them; t1s.poses.json re-extracted (approved: null).
    DRU: trunk keeps the gap rule; uncoupled and skew only on the PHY-side two-pin
    pairs. rules/t1s_stubs.py measures the line; prove_rules.py 26 of 26.
    judge_route.sh follows the D12 rules. DRC 0 errors, floorplan 1 (U501-U401
    36 mm vs 25 mm, on D16).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
    [node60.kicad_pcb]
2026-11-04 D16 answered: T1S block approved (D16-1 A); RMII limit 40 mm; J912 ESD to follow (D16-2 A)
2026-11-04 T1S: second ESD pair D503/D504 at J912 (D16-2)
    Placement decision D16-2 A (user, 2026-11-03): either T1S connector may face
    the harness, so J912 gets its own ESD clamps instead of relying on D501/D502
    about 35 mm away at J903.
    - D503 VETH100A1DD1HG3-08 (DropOut_Diode_SMD:Vishay_DFN1006-2B_1.0x0.6mm):
    pad 1 (A1) = GND, pad 2 (A2) = /T1S_P. D504 the same on /T1S_N. Wired as
    D501/D502, in a new group box "T1S ESD at J912" with a note saying which
    pair goes at which connector.
    - Line-interface title and DESIGN VALUES note: ESD 4 x VETH100A1DD1, pairs at
    J903 and J912; capacitance budget PHY 8.5 + CMC 10 + ESD 2 x 1.0 = 20.5 pF
    of CMDI <= 25 pF (DEC-012 rev. C).
    - mcu-pins.json regener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
    [t1s.kicad_sch]
2026-11-04 Records for D16-2: DEC-012 rev. C, ESD pair at J912, capacitance check
    - DEC-012 rev. C: VETH100A1DD1HG3-08 quantity 4, one pair right at each T1S
    connector (D501/D502 at J903, D503/D504 at J912); rev. B's single pair
    recorded as replaced. New "Rev. C" section with the capacitance check:
    OPEN Alliance 10BASE-T1S Implementation Spec V1.0 Table 1, CMDI <= 25 pF
    (10 transceiver / 10 CMC / 5 rest); LAN8670 CDIFF 8.5 pF max (DS60001573K
    Table 7-19) + Class III choke <= 10 pF + two ESD pairs 2 x 1.0 pF (Vishay
    doc. 86195, two devices in series) = 20.5 pF, about 4.5 pF left for the
    connectors and traces (3 pF against the 10/10/5 split). K501 open contact
    about 0.03 pF, estimated fro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
    [parts.yaml]
2026-11-04 Connectors page notes name both ESD pairs; DEC-012 relay row across the line
    - p9 T1S notes: ESD pairs D501/D502 at J903 and D503/D504 at J912
    (DEC-012 rev. C, D16-2); two long lines wrapped (the LAYOUT line used to
    cross its group box).
    - DEC-012 rev. C table: K501 row given across the line (~0.015 pF), with
    the ~0.03 pF per open contact to AC ground.
    [connectors.kicad_sch]
2026-11-04 D16-2: D503/D504 at J912, mirrors of D501/D502 about the trunk midpoint
    After #55 merged: footprints added, fields synced, t1s.poses.json 22 parts,
    line zone takes them. CLAUDE.md describes the D16 T1S layout. DRC 0 errors,
    parity 0, floorplan 0.
    [node60.kicad_pcb]
2026-11-04 Judge: time every step (wall, CPU, peak memory), opt-in cProfile; perf_report.py
    judge_route.sh also routes with the power classes at the Default width (KRT
    routes a class at its width; 3V3_MAIN at 0.4 mm into U401 failed ~100 nets)
    and no longer lists 3V3_MAIN/1V5_CORE in its power widths.
2026-11-04 Workstation setup script: rebuild the Node60 environment on another Apple-silicon Mac and verify it
    scripts/setup-workstation.sh installs or checks KiCad 10.0.7, the Homebrew tools, PATH (only if
    a login shell can't find brew), the ~/Dev repos, KRT at e91017d1 with the v0.23.7 router, and
    krt-venv (CPython 3.12.16, pinned packages), then verifies on a git-archive export: pcbnew,
    KRT imports, CI's DRC, prove_rules.py and one timed judging run against a reference.
2026-11-04 Workstation setup follows the handbook's new-Mac list; plugins on by default; ask on handbook disagreements
    d2 required, dropout-library-catalog cloned, dropout-hardware and kicad-happy installed from
    GitHub by default (--no-plugins to skip), credentials and git identity checked (never read or
    edited), and the handbook's step-11 checks in the verification. CLAUDE.md: a disagreement with
    the handbook goes to the user as a Node60 exception or a handbook change (user, 2026-11-03).
2026-11-04 Process: plane layers get a signal policy (power-only or a costed window) before routing
    pcb-placement skill: plan bullet, plan.json plane_windows, gate row 'Plane layers:
    signal windows', lesson. draw_rule_areas.py --window/--power-only draws
    SIGNAL_WINDOW_* (no pour) and POWER_ONLY_* (tracks not allowed, vias pass).
    plane_model.py --window/--window-keep costs a window. judge_route.sh: layer
    roles from the environment; router's DRU copy without the two scoped
    clearance rules KRT over-applies (KiCad grades the real file).
2026-11-04 Reference judging run on the M3 Air at b6d7085; verify defaults to that commit; parallel runs capped by memory
    [timing.tsv]
2026-11-04 Verify routes with KRT exported at the pin (the live checkout is pulled nightly); compact judging comparison
2026-11-04 Judge: REDCUBE ring pads become round pads in the router's copy (speed)
    KRT turns each ring (gr_circle, fill no) into a ~190-vertex polygon and checks
    clearance to it edge by edge in Python. A round pad of the ring's outer diameter
    at its centre is equivalent for routing (the ring encloses the terminal's own
    spigot hole and body). Same board, KRT 87596863 and settings as W2: run 18.2 ->
    16.4 min, short steps about halved, bulk route 640 -> 516 s (second pass
    noisier, 322 -> 390 s, on a shared machine); failed nets 23 -> 24, unconnected
    items 29 -> 29. JUDGE_KEEP_RINGS=1 routes with the rings as drawn.
2026-11-04 judge_batch.sh: run many judging runs at once, sized by P cores and memory (14 on a 128 GB M1 Ultra)
    Variants file (name, board, judge_route.sh environment), --repeat for spread, a free-memory check
    before each start, caffeinate, commits recorded per run (KRT tracks its latest commit), ranked
    summary.tsv and perf.md. pins.env: KRT unpinned per the user (2026-11-04), reference pair kept.
2026-11-04 D17 published: inner layer roles (In2 windows, channels, one plane, 8 layers)
    draw_rule_areas.py takes several windows per layer (the keep-outs are the
    layer minus all of them). power/layer_picture.py draws a plane layer's policy.
    Option B (north band + channels) fast-routed: 15 nets failed, 9 of them the
    PHY's RMII/MDIO nets, which fail in every variant.
2026-11-04 D17 A: In2 signal window north of y 70 mm on the board; In1/In3/In4 power-only
    User 2026-11-04: try 6 layers, hand-route the leftover nets, 8 layers if that
    fails. draw_rule_areas.py drew SIGNAL_WINDOW_In2Cu_1 and the POWER_ONLY_*
    keep-outs (tracks not allowed, vias pass); plan.json plane_windows set; gate row
    'Plane layers: signal windows' PASS; DRC 0 errors, parity 0. judge_route.sh
    defaults to these layer roles.
    [node60.kicad_pcb]
2026-11-04 KRT tracks origin/main (user, 2026-11-04): router must match the crate; verify judges with the reference KRT copy by default
    --update-krt fast-forwards an existing checkout (off by default: shared); --krt-at reference|live;
    each run writes versions.txt (node60, judge blob, KRT, router, KiCad). KRT reproduced the
    reference exactly at the same commit, so --repeat is a check, not a spread measure.
2026-11-04 PHY group 10 mm south (user); U501's 3V3 decaps placed at its pins
    U501 was too close to the north edge to route to. The shift covers U501, Y501,
    the straps and test points, FL501, C511/C512, K501 with its termination and
    drivers; D501-D504 stay at the connectors. C501, C503-C508 (U501's 3V3
    decoupling, left at the PHY's pre-D16 spot) now sit at pins 8/18/29. Q501,
    Q502 and R521 moved clear of C202/R202; C206 and TP301 just north of the line
    zone. T1S estimate: PHY stub 22.5/22.5 mm (was 12.5), relay legs 22.2/22.2 mm.
    DRC 0 errors, parity 0, floorplan 0.
    [node60.kicad_pcb]
2026-11-04 U301 (VDDAU_AON regulator) with R301, C301, C302 beside U501 (user)
    VDDAU_AON's only load is U501 pin 25; U301's output is now 2.8 mm from it
    (was about 70 mm, by the output switches). C302 moved to the bottom. Added to
    the T1S line zone and table. DRC 0 errors, parity 0, floorplan 0.
    [node60.kicad_pcb]
2026-11-04 Power shapes, stage 1: planes, the 60 A entry path (D18 A), GND pours, 1,190 power vias
    scripts/draw_power.py draws zones and via fields from power/power_shapes.json
    (rerunnable; replaces what it drew; everything locked). In1/In4 GND, In2/In3
    VBAT_PROT (In2 kept out of the north window), the entry path on B, In2, In3 and
    the F band between the busbar areas, VBAT_IN on F under its bar, GND pours on F
    (clear of the VBAT_IN bar) and B. Via fields at 0.65 A per via, each at least
    93: J910 ring, Q201/Q202 sources, the VBAT_D and VBAT_Q2D corridors, Q203/Q204
    sources, J911 and J902 rings. DRU: one thermal spoke is enough for small
    parts. D18 page and power/entry_model.py; plane_model.py takes a pe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
    [node60.kicad_pcb]
2026-11-04 Power shapes, stage 2: in-pad VBB vias, output pours and identical via fields
    Each switch's VBB pad gets 30 vias in the pad (filled and capped, free on
    this stackup per DEC-027). Each output a B and F pour from its pins to its
    header's pin 1, OUTb the mirror of OUTa; via fields kept only where free at
    all six outputs (draw_power.py: in_pad, mirror, copies). power/copper_r.py
    measures a net's resistance from its filled copper and vias: OUT1..6 =
    4.83/4.59/4.83/4.59/3.03/4.53 mOhm at 85 C, limited by the cells' small parts
    beside the OUT pins (D19). DRC 0 errors, parity 0.
    [node60.kicad_pcb]
2026-11-04 D19 A: output cells' small parts clear of the OUT exits; outputs 1.9-2.3 mOhm
    RT601/R607/C607 north of each switch between the exits, R601 and R604 to the
    signal side, TP602 north, TP606 south; U601's cell copied to U701 and U801
    (U801 an exact copy again). B output pours widened north beside the pins;
    power shapes redrawn. Measured from the copper at 85 C: OUT1..6 =
    2.25/1.95/2.25/1.94/2.23/1.93 mOhm (were 4.83/4.59/4.83/4.59/3.03/4.53).
    FLT/SNS/SCK pins passable; DRC 0 errors, parity 0, floorplan 0.
    [node60.kicad_pcb]
2026-11-04 Via, track and diff-pair presets in the PCB editor
    Vias 0.35/0.2, 0.4/0.2, 0.45/0.25, 0.6/0.3 and 0.8/0.4 mm (diameter/drill),
    tracks 0.1 to 1.0 mm, and the T1S pair 0.165/0.15 mm, all inside JLCPCB's
    multilayer capabilities (via 0.15 hole / 0.25 pad minimum, 0.2 hole preferred).
2026-11-04 JLCPCB alignment: filled and capped vias, PTH 0.35 mm, KiCad PCB settings page
    - Via protection filled and capped (was tented only), matching the JLCPCB
    order and the in-pad VBB vias under the output switches.
    - Custom rule: plated holes 0.35 mm from other copper (was 0.30), JLCPCB's
    recommended PTH-to-track figure.
    - prove_rules.py: test vias are free vias (KiCad gave a via standing in a
    pour the pour's net on save, so two via rules looked silent since the
    power shapes); via cases refill zones. 26 of 26 cases pass.
    - Docs: new page 'KiCad PCB settings' listing every board setting, its
    Board Setup page, value, JLCPCB limit and reason; fab page notes the via
    presets and protection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
    [node60.kicad_pcb]
2026-11-04 KiCad PCB settings page: the 2 oz via-ring question covers every via
2026-11-04 KiCad PCB settings page: pictures of every Board Setup page
    Eleven pictures from KiCad 10.0 on this board (2026-11-04): Board Editor
    Layers, Physical Stackup, Board Finish, Solder Mask/Paste, Constraints,
    Pre-defined Sizes and the toolbar's via drop-down, Net Classes, Custom
    Rules, Violation Severity, and a via's Properties dialog (protection
    features from rules). Board-level via filling and capping have no Board
    Setup control in KiCad 10; the page says where they live. Adds VBAT_FILT
    to PWR_RAIL, the inner layers' names and types, and that KiCad rewrites
    node60.kicad_pro when the board editor closes, even after Discard.
2026-11-04 Default silk text 1.0 mm high, 0.15 mm thick
    KiCad's default 0.10 mm stroke fails the custom rule 'Silk text 1.0 mm
    high, 0.15 mm stroke' (JLCPCB's minimum), so every new silk text needed
    fixing by hand. The project file now carries KiCad's text and graphics
    defaults with silk text at 0.15 mm; the rest stay KiCad's. Documented on
    the KiCad PCB settings page.
2026-11-04 KiCad PCB settings page: picture of the Text & Graphics defaults
2026-11-04 D20 A: both battery terminals VBAT_IN, power entry mirrored about x 155
    The harness decides which battery terminal is the source (user,
    2026-11-04), so J901 joins J910 on VBAT_IN (DEC-016 rev. C) and the
    power entry is laid out so either terminal feeds the node the same way.
    - Schematic p9: J901's label is VBAT_IN; board pads, the busbar rule and
    the PWR_BATT pattern follow. BB901 has both pins on VBAT_IN.
    - Power block re-composed about x 155 (new pose table): Q201 fed by
    J910 and Q202 by J901 in the south row, R201 north-south on the centre
    line, Q203/Q204 either side in the north row, U201/U202 in the column
    north of R201; NTC parts moved east of the VBAT_PROT pour.
    - Power shape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
    [connectors.kicad_sch, node60.kicad_pcb]
2026-11-05 D21 C: power entry rows swapped for a short DGATE, VBAT_IN off In3
    TI's LM74910H-Q1 layout guidelines say DGATE must reach the ideal-diode
    MOSFET's gate with a short trace; D20 A had about 50 mm to each.
    - Ideal-diode FETs Q201/Q202 in the north row beside the U201/U202
    column (DGATE 23/24 mm, A pin 16 mm from Q201's sources); R201 turned
    so F1 is north and its sense pads face U202; load-disconnect FETs
    Q203/Q204 in the south row (HGATE 49/37 mm). Still mirrored about
    x 155. TP507 moved north by K501. New power pose table.
    - Power shapes: VBAT_IN an L from each ring to its FET on B and In2
    only, so In3 stays VBAT_PROT toward U601/U801; VBAT_D north band,
    VBAT_Q2D south band; via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
    [node60.kicad_pcb]
2026-11-05 In3 VBAT_PROT trimmed to the power band; fix stacked OUT vias
    The user cut In3's VBAT_PROT pour from the whole board to the power band
    (x 69.5-240.5, y 71-116.5) to save copper. Optimised on little copper:
    - draw_power.py cleared only a copies field's first copy before a
    redraw, so each rerun stacked vias on OUT2-OUT6 (198 each) and OUT1
    lost its strip vias (3.11 mOhm). Every copy's region is now cleared:
    all six outputs have 30 vias again, OUT1 2.14 mOhm.
    - power/in3_sweep.py writes In3 outline variants; copper_r.py solves
    with every load drawing at once (REF:PAD@AMPS+...) and maps current
    density (--map). Current wraps south of the switches; the north half
    and a bridge over th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
    [node60.kicad_pcb]
2026-11-05 D22 asked: small rail planes (3V3_MAIN on In3 north, 1V5 island, VBAT_PROT fingers)
    draw_power.py: pad vias (one per small-rail pad, in the pad where it fits) and
    BGA dogbones; copper_r.py counts stub tracks; rail_picture.py for the page.
2026-11-05 Small rail planes (D22 A) and repair poses R1-R3 (D23 A)
    In3 north of y 70.8 becomes 3V3_MAIN with a 1V5_CORE island from U401's
    core to R303 and C405; VBAT_PROT fingers on In3 to L201 and U301; VBAT_FILT
    pours on B and F; one via per small-rail pad; U401's power and ground balls
    dogboned, every via under U401 0.35/0.20 mm. C206 and TP205 moved beside
    L201 and U302, C405 beside U401, U401's top-side caps re-posed on via pairs
    (new pose table u401_decaps). DRC 0 errors.
    [node60.kicad_pcb]
2026-11-05 Assume JLCPCB accepts the 0.075 mm via ring for now (user); check before ordering
2026-11-05 D24 asked: buck hot loops (U302 cell mirrored as placed; both bucks' copper)
    power_shapes.json carries both bucks' copper for the re-composed U302 (applied
    only once D24 is answered); draw_power.py gains a clear list for retired fields.
2026-11-05 Buck hot loops (D24 A): U302's cell re-composed, both bucks' copper
    U302 turned 180 degrees and its cell mirrored about the chip's east-west axis,
    so SW and PGND face L301 and C303 on the bottom side; the filter follows the
    input caps south. Both bucks' input, switch-node and output copper on B, GND
    vias in every cap's GND pad, no vias on the switch nodes. hot_loop.py fails an
    inductor that is not on its SW pin's side of the chip. DRC 0 errors.
    [node60.kicad_pcb]
2026-11-05 D25 asked: GND stitching (edge ring now or a full grid); fast route on main
    draw_power.py: edge-ring via fields and avoid rects.
2026-11-05 RMII trial tooling: route_rmii.sh, transplant_nets.py; judge STOP_AFTER; draw_power via sites clear routed copper and look across bucket edges
2026-11-05 D26 asked: RMII routing (strap parts and Y501 moved at the PHY; all ten nets routed on a copy)
2026-11-05 RMII routed (D26 A) and the GND edge ring (D25 A)
    Straps R505/R507/R509/R510 and test points TP503/TP504 moved beside their own
    PHY pins; Y501 2 mm east with R503/R504 (k501 table updated), UNDER_Y501
    redrawn; the ten RMII/MDIO nets routed with KRT and locked. A GND ring at 5 mm,
    1 mm in from the edge. In3's 3V3 plane and 1V5 island take a 0.12 mm minimum
    width. DRC 0 errors.
    [node60.kicad_pcb]
2026-11-05 Test points parked off the board while routing (user rule); RMII timing tool
    User, 2026-11-05: test points may move anywhere to make routing easier, or come
    off the board while routing and go back later. park_test_points.py moves all 62
    to a grid south of the outline and records their poses; routes through TP504 and
    TP505 closed, the MDC stub to TP503 and the TP302/TP303 pad vias deleted. DRC 0
    errors. block_poses.py check --parked reports parked parts.
    rmii_timing.py: routed path length and flight time per RMII/MDIO net, both
    REF_CLK branches, and the four RMII windows from the two datasheets.
    [node60.kicad_pcb]
2026-11-05 D27 asked: RMII clock skew (Y501 between J903 and U401, or a meander, or leave)
    Microchip asks the shared 50 MHz oscillator's traces matched within 13 mm; ours
    are 14 and 54 mm, and with the series resistors' RC the MCU's clock is 0.4 ns
    late, leaving 0.09 ns of TX setup. Trials routed and judged on real copies.
    Tools: rmii_timing.py (RC term), route_clock.sh, prep_trial.py, trunk_check.py,
    rmii_picture.py; draw_rule_areas.py --only.
    [rmii_picture.py, rmii_timing.py, trunk_check.py]
2026-11-05 D27 page: GND opens, the via in pin 27, the plan's RMII row, hold under a light load
2026-11-05 RMII clock skew (D27 A): Y501 between J903 and U401, RMII re-routed
    Y501, R503, R504 and its bypass C513 (down from the top side) move between J903
    and U401, so the clock reaches U501 (34.8 mm) and U401 (22 mm) within
    Microchip's 13 mm, the PHY's branch the longer. Worst-case RMII windows: TX
    setup 0.61 ns (was 0.09), TX hold 0.69, RX setup 3.32, RX hold 1.37.
    The twelve RMII, MDIO and clock nets re-routed clock first and locked, with
    nothing on F.Cu in the T1S trunk's corridor (the pin 27 via moved out of it;
    trunk_check.py now counts vias too). New pose table blocks/refclk.poses.json;
    k501, intent and plan rows updated; UNDER_Y501 redrawn; 3V3 vias for Y501 and
    C513. mcu-config.yaml: TXD0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
    [node60.kicad_pcb]
2026-11-05 D28 asked: T1S line routing (trunk, taps, PHY pair; C502 moved; three T1S rules)
    Hand-routed from a script (t1s/spec_t1s.py) and judged on a real copy:
    DRC 0 errors with the rule changes, T1S open items 14 to 0. Tools:
    draw_t1s.py, rules_t1s.py, route_txd0.sh, build_trial.sh, area_picture.py.
    draw_power.py gains keep_clear and class_clearance; t1s_stubs.py counts vias
    by depth (In2 taps); trunk_check.py skips the line's own copper.
    [trunk_check.py]
2026-11-05 D28 page: C502 clears J903's courtyard; plane holes round the T1S vias (optional fourth change); power_shapes spec for the trial
2026-11-05 T1S line routed (D28 A with the fourth change)
    Trunk on F.Cu coupled about y 46 (38.9 mm), ESD taps, taps west of U501 on
    In2 to C511/C512, relay legs to K501, CMC pair, and the PHY pair crossing
    once (P over N on F.Cu). C502 moved off the trunk's line onto a 3V3 via shared
    with U501 pin 29 (VDDA); REFCLK via nudged; TXD0 re-routed; C507's and R506's
    pad vias out of the trunk's corridor.
    Rules: the 0.75 mm T1S clearance not inside T1S_PINS_U501 and its pour
    clause on the outer layers only; the pair gap only inside T1S_COUPLED_F/IN2;
    PHY pair skew 4.5 mm. prove_rules.py 32 of 32. CI DRC with parity 0 errors;
    T1S open items 14 to 0.
    [node60.kicad_pcb]
2026-11-06 Relay termination routed: K501 legs, centre tap, coil and its drive lines
    KRT in two passes (t1s/build_term.sh): the four T1S-class legs first, then
    TERM_CT, the coil nets and the drive lines from U401, with via keep-outs
    round every T1S track and via (route_nets.sh). CI DRC with parity 0 errors;
    19 open items closed, nothing else changed; trunk corridor clean.
    [node60.kicad_pcb]
2026-11-06 Power joins, first pass: 28 short power and ground joins from plan_joins.py
    Main had 58 power and ground opens that a refill does not close. power/joins/ plans them
    against the board's own clearances (export_copper.py, plan_joins.py, merge_plan.py), each join
    its own named stubs/points in power_shapes.json. Opens 58 -> 30; CI DRC 0 errors, parity 0;
    T1S corridor and stubs unchanged. The 3V3 trunk into the power band and the dense joins at
    U501/U301/U202 are left (see decisions/log.md).
    [node60.kicad_pcb]
2026-11-06 D29 asked: 3V3 into the power band (tools and page source)
    trunk_options.py searches each 3V3 feed on F.Cu and B.Cu from any legal plane via, with other
    nets' pours costed or blocked; trunk_picture.py and trunk_to_spec.py draw an option and turn it
    into power_shapes entries. Nothing on the board yet: the user picks first.
2026-11-06 D29 C: 3V3 into the power band from the widened In3 3V3 plane
    The In3 3V3 pour now takes all of In3 that VBAT_PROT, the entry's pours and the 1V5 island
    leave, including the free margins (x < 72, x > 238, y > 122). Each output cell's pocket is fed
    from below (9.5 mm, 2 vias, alike); R607/R807 from the plane, R707 from R607's feed, R211/C215
    from R807's, U202 and U203 on short vias. Every 3V3 open in the band joined; outputs and the
    entry chain measure as before; CI DRC 0 errors, parity 0.
    [node60.kicad_pcb]
2026-11-06 D30 asked: signals into the output cells' pockets (page source, tool updates)
    trunk_options.py routes any net from a start box; trunk_to_spec.py keeps each feed's net. Nothing
    on the board: the user picks first.
2026-11-06 Trial tools: output switches turned 180 degrees; FL501/K501 swapped so P runs east
    cells/turn_cells.py turns each switch with its pin-local parts, mirrors the output pours and
    via fields to the chips' south end and swaps each cell's channels. t1s/swap_pins.py swaps FL501's
    windings and K501's poles on the pads; spec_t1s.py takes 'swap' (P east along the chain, PHY pair
    straight, C511/C512 sides swapped); route_nets.sh can keep other nets' tracks off T1S tracks
    (used for build_term.sh's second pass); t1s_stubs.py finds FL501/K501 pins by net. Board
    unchanged; trials on copies.
2026-11-06 D31 asked: output switches turned 180 degrees; FL501/K501 swapped (page source)
2026-11-06 D31 landed: output switches turned 180 degrees; FL501/K501 swapped
    Schematic (cells/edit_sheets_d31.py): the output-switch sheet's OUT_A/OUT_B labels swap, so each
    switch's channel 1 (pins 6-8) drives OUT_B; FL501 mirrored and K501's P on pole 2, so P is east
    along the T1S chain. Board (cells/land_d31.sh): pad nets from the schematic (apply_netlist.py),
    the three switches and their pin-local parts turned, OUT pours at the chips' south end, the T1S
    line with C511/C512 swapped and a straight PHY pair, TXD0 and the termination re-routed. PHY
    pair skew rule back to 0.5 mm.
    CI DRC 0 errors, parity 0; outputs 1.63-1.70 mOhm (were 1.86-2.16); PHY stub 24.6/25.6 mm
    (28.6/25.6), no vias on the PHY p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
    [node60.kicad_pcb, output-switch.kicad_sch, t1s.kicad_sch]
2026-11-12 pcb-placement: pin KRT for a batch, light path for small moves, v0.24.0 tools
    Lessons of the 2026-11-12 passive-placement study:
    - Before a large run, check for a KRT update and install it; then one KRT version
    and one batch at a time. judge_batch.sh marks a batch INVALID (exit 3) when KRT's
    commit or grid_router.so changes under it.
    - SKILL.md: a 'Small moves of free parts' path (spec per attempt, copies, screens,
    labelled pictures, one judged batch), check_reachability --part as a screen, and
    route_review.py, render_nets.py and check_join.py (which does not see pours).
    - lessons.md: the mid-batch update, DRC-only screening, and how to read a fast route
    with parked test points (co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
2026-11-12 D32 landed (I and H): passives onto the 3V3 plane, TVS pour
    Passive placement study placement/2026-11-12-passives (ten attempts,
    pictures, fast routes on KRT v0.24.0, decision page D32). User: "I and H".
    - C215, R211, R406, R407 at U203; R508 at U401 ball B3; R513 east of
    U501 pin 23
    - NTC pull-ups and filter caps R6x7/C6x7 and R701 on the 3V3 plane south
    of U401; R601 and R801 at the In3 3V3 margins' vias. No 3V3 track
    enters an output cell (3V3 track in the power band 201 -> 8 mm)
    - VBAT_IN pour on F.Cu joins the TVS D201's tab to the busbar's pour
    - power_shapes.json in step (land_spec.py); block tables out_6x, out_34,
    out_8x, t1s edited; mcu_pullups and u203_parts new
    - draw_pow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
    [node60.kicad_pcb]
2026-11-13 Routing run: board prepared for routing; D17 A keep-outs drawn again
    The In2 signal window and the power-only areas of decision D17 A were
    lost from the board in 111fb0e (2026-11-05); every router run since
    laid signals on In2 through the power band. They are drawn again.
    On the board (decisions D34-1 to D34-6, placement/2026-11-12-route):
    - relay-termination drive lines laid again clear of U401 ball E1
    - R501 turned 180 degrees, C509 0.25 mm east, so RBIAS reaches R501
    - U201's VBAT_D joins moved off pins 1-5 and 23
    - 1V5_CORE_FB by hand, 1 mm from the switch node
    - five nets the router always leaves open pre-routed (mini_route.py)
    The full routed attempt is not landed: it reaches the mid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
    [node60.kicad_pcb]
2026-11-13 Board routed after D33 B: signal tracks on F.Cu under the GND busbar
    D33 B (user, 2026-11-12): signal tracks may run on F.Cu under the GND
    busbar, under solder mask; no other net's pour there and no battery-net
    track (class PWR_BATT, VBAT_FILT, RS_SENSE_P/N). Two rules replace
    "F.Cu under the GND busbar: GND only" in node60.kicad_dru; seven new
    cases in prove_rules.py (39 of 39, now also on a routed board).
    The board is routed: DRC 0 errors, parity 0, every signal join closed,
    all 62 test points back (60 joined). Two supply joins stay open, both
    open before: U201 pin 2 (VBAT_IN sense) and C510 pad 1 (VDDAU_AON).
    - The power band is crossed in two channels under the FET bodies, six
    B.Cu l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
    [node60.kicad_pcb]
2026-11-13 Routing run: decision D36 put to the user (U201 pin 2, VBAT_IN sense)
2026-11-13 Board fully routed: U201 pin 2 (D36 A), C510, the UART debug lines, TP301
    D36 A (user, 2026-11-12): U201 pin 2, the LM74910's anode sense, is
    joined to VBAT_IN with no rule change. LM_SW and LM_UVLO's R204-R205
    link move to F.Cu with vias in their pads; VBAT_IN runs on B.Cu from
    the pin between R204's pads to a via at (147.9, 71.6) and from there in
    a 0.6 mm VBAT_IN pour finger on In2 (PWR_VBAT_IN_U201_In2) under the
    west channel's lines to the west VBAT_IN pour.
    Also closed: C510 pad 1 (VDDAU_AON, a 12 mm F.Cu loop round U301),
    UART0_DEBUG_TX and RX to TP401/TP402 (RX out of the BGA's east edge
    between two vias shrunk to 0.35/0.20 mm), TP301 beside its rail.
    KiCad DRC: 0 errors, 0 unconne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
    [node60.kicad_pcb]
2026-11-13 Routing run: VBAT_PROT measured on the fully routed board (0.807 W at 3 x 20 A)
2026-11-13 Unrouted connections are DRC errors again
    The board is fully routed, so the temporary override of 2026-10-30
    (PR #21: rule_severities.unconnected_items = warning) is deleted from
    node60.kicad_pro; KiCad's default (error) applies and CI fails on any
    unrouted connection, as the handbook asks. DRC with this file: 0 errors,
    0 unconnected items. CLAUDE.md records the end of the deviation.
2026-11-13 kicad-happy fixes: U501 pad vias, via sizes, return vias and stitching, silkscreen
    Works through reviews/2026-11-12-kicad-happy/REPORT.md on the routed board.
    - N1: nine GND vias in U501's exposed pad, 3 x 3 at 1.20 mm, 0.33 mm holes (Microchip
    DS60001573K, drawing C04-2500 Rev B); TXD1, MDC and TX_EN re-laid between the rows.
    - N2: 0.35/0.20 mm vias 213 -> 131 (59 to 0.45/0.25, 22 to 0.40/0.20); 24 in the power
    band left small to keep VBAT_D (option in specs/n2_band_option.json).
    - N3: the double REF_CLK via, the MDC/MDIO stubs and 29 more exact duplicates deleted.
    - N4: reference text arranged; DRC silk warnings 377 -> 19 (footprint graphics).
    - N5: L302 checked, not moved.
    - N6: 130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
    [node60.kicad_pcb]
2026-11-13 kicad-happy fixes: the 24 power-band vias stay 0.35/0.20 mm (user, 2026-11-13)
2026-11-13 SPI series resistors: 33 R at the driver on every output-switch SPI line and the flash's SCK
    Thirteen AC0402JR-0733RL: R409-R417 at U401 on SCK, MOSI and CS_L of LPSPI4/5/3, R418 on the
    log flash's SCK, R608/R708/R808 at each TPS2HCS08A's SDO pin (TI SLVSHR0 Figure 9-1, Table 9-1:
    RSPI in all four lines). The line keeps its net name and test points; the driver's short net is
    <line>_MCU at U401 and SW_SDO at the switch. No other part moved; DRC 0 errors, 0 unconnected,
    parity the 19 known lines; rule proofs, T1S, RMII, block poses and supply paths as before.
    Run folder placement/2026-11-13-spi-series-r (REPORT.md, decisions S01-S05; S03, the SDO value,
    is open and the user's).
    Co-Authored-By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
    [mcu-nvm.kicad_sch, node60.kicad_pcb, output-switch.kicad_sch]
2026-11-13 SPI series resistors: S03 answered, SDO stays 33 R (user, 2026-11-13)
    TI's RSDO 768 R is not taken; its loss-of-ground condition is not met on SDO.
    Recorded in the run's decision log, REPORT.md and CLAUDE.md. No design file changed.
